djgringoboy2003/Nub44-driver/engineering/budget-2s-design.md

# Budget-2S implementation and handover

Updated 2026-10-29. Codex (AI review), requested by owner, decision DD-30; continued by Claude Code
(AI), decisions DD-31…DD-35, DD-38 (PCB and prototype manufacturing package), DD-39 (BOM sourced) and DD-40
(LCSC codes).

**Stage: prototype PCB files checked; electrical qualification CONDITIONAL; not released.** DD-38 produced a
DRC-clean 90 × 60 mm four-layer board and a bare-board manufacturing package (`manufacturing/budget-2s/`) for
a dummy-load prototype. Every BOM line has a sourced MPN (DD-39) and an LCSC code or a labelled LCSC
equivalent (DD-40). The footprint and layout reviews below are open. No order is authorised by this document or placed by any tool.
The owner requested implementation of the separate two-cell, unrestricted-size, £60 driver. This work does
not inherit the original single-cell boards' CAD, firmware or release results.

## Source and command map

| Purpose | Authoritative source / output |
|---|---|
| Numeric candidate and study assumptions | `engineering/design/budget-2s/parameters.yaml` |
| Separate source resolution | `automation/nubm44/variants.py`; original A/B defaults remain unchanged |
| Circuit connectivity | `engineering/design/budget-2s/connectivity.yaml` (DD-35, DD-38): 108 parts (incl. four mounting holes), every pin and net |
| KiCad library and schematic | `automation/budget/build_library.py` → `hardware/budget-2s/lib/budget2s.*`; `automation/budget/build_schematic.py` → `hardware/budget-2s/nubm44_budget2s.kicad_sch`, `reports/budget-2s/erc.json`, `schematic.json`, `schematic.pdf` and a hash manifest |
| Placement and routing | `hardware/budget-2s/placement.yaml` (positions, pours, fixed tracks/vias, router keep-outs); `automation/budget/build_pcb.py --stage place/route/finish/drc/render` (shared builder via `pcb_builder_budget.py`); accepted session archived in `hardware/budget-2s/routing/`, re-applied with `--stage restore` |
| DRC | `reports/budget-2s/drc.json` and `drc-evidence.json` (kicad-cli, all severities, schematic parity) |
| Routed-copper check | `automation/budget/layout_review.py` → `reports/budget-2s/layout-review.md/.json` and a hash manifest: DC path resistances against the `power_model` allocations |
| BOM order codes | `engineering/design/budget-2s/sourcing.yaml` (DD-39, DD-40), per MPN: LCSC/JLCPCB code (with LCSC's listing name where it adds a suffix), UK-distributor listings, a separately coded LCSC equivalent where LCSC does not list the part, and the evidence ID. Stock and prices are not recorded. |
| Manufacturing package | `automation/budget/export.py` → `manufacturing/budget-2s/` (Gerbers/drill ZIP, BOM, JLCPCB BOM/CPL, PDFs, renders, `ORDERING.md`) and `reports/budget-2s/export-evidence.json`; marks DO_NOT_FABRICATE unless DRC is clean and current |
| Static default-off interface checks (DD-32) | `automation/budget/interface.py` (called by `qualify.py`; results in the same report) |
| Electrical qualification | `automation/budget/qualify.py` → `reports/budget-2s/qualification.md`, JSON and hash manifest |
| Operating point, dropout, UV/OV margins, efficiency estimate | `automation/budget/power.py` (called by `qualify.py`; results in the same report) |
| Preliminary current loop | `automation/budget/loop_model.py` → `reports/budget-2s/loop-model.md`, all 243 corners in JSON, ngspice `.cir`/raw data/log, hash manifest |
| Manufacturer records | BUD-01…22 in `research/sources/budget-driver-sources.md`; downloaded PDFs ignored, hashes recorded |
| Earlier costs and design rationale | `engineering/budget-driver-plan.md`, `reports/bom-quote-sourcing-review.md` |

Run from the repository root (prefix shell commands with `rtk`, per the owner’s RTK.md):

```powershell
rtk proxy .venv/Scripts/python.exe automation/budget/build_library.py
rtk proxy .venv/Scripts/python.exe automation/budget/build_schematic.py
rtk proxy .venv/Scripts/python.exe automation/budget/build_pcb.py --stage restore   # archived routing; or place/route/finish/drc
rtk proxy .venv/Scripts/python.exe automation/budget/layout_review.py
rtk proxy .venv/Scripts/python.exe automation/budget/export.py
rtk proxy .venv/Scripts/python.exe automation/budget/qualify.py
rtk proxy .venv/Scripts/python.exe automation/budget/loop_model.py
rtk proxy .venv/Scripts/python.exe -m pytest tests -q
rtk proxy .venv/Scripts/python.exe automation/validation/validate.py
```

`qualify.py` currently **exits 1**, because none of its thirteen prerequisites is a PASS: eight are CONDITIONAL
(setpoint, dropout, efficiency estimate, UV, OVP margin, static default-off interface, CAD and manufacturing
files) and five OPEN (fault safety, loop, firmware, cost, Gate G). That is the intended readiness result, not a
failed Python invocation. Rerun `layout_review.py` and `export.py` after any board change; `qualify.py` reads
their hash-checked evidence. `export.py` exits 1 and writes DO_NOT_FABRICATE.txt unless DRC is clean and current.
`loop_model.py` exits 0 only when its actual sensitivity margins and independent ngspice/equation agreement
pass; its physical qualification stays OPEN. Existing `validate.py` still validates **A/B only**. A return
code of zero there is not evidence for budget-2s. Do not add budget failures to the A/B known-limitations
baseline to conceal them. Do not add `budget-2s` to legacy default loops until every downstream generator,
firmware/sourcing check, layout model and release gate supports the independent circuit.

## Development architecture

Protected balanced 2S pack → fuse → reverse-polarity P-FET → TPS54821 buck and bulk output filter →
10 mΩ 2512 shunt with Kelvin sense traces (DD-34) → single P-FET output disconnect (source at the shunt, gate pulled down through 100 Ω and clamped, DD-31/34)
→ grounded-cathode laser. Keep bulk capacitance upstream of the disconnect. The disconnect's body diode
blocks VBUCK → laser; a back-to-back second FET would only block the reverse path and was removed. The INA186A2 primary current loop and separate INA300 comparator use distinct
Kelvin traces from the shunt; they still share its physical failure modes. OVP must observe physical VBUCK
upstream of the disconnect, rather than the converter's current-derived feedback or only an isolated laser.

The 3.3 V rail supplies the SOIC ATtiny, sensing/protection and hardware latch. Supervised asynchronous
clear, external interlock, OC and UV/OV trips must override firmware. A deliberate arm edge sets the latch;
firmware mode control may inhibit emission but must never clear a hardware fault automatically. Buck EN
and the output FET driver need a **qualified default-off buffer and bias network**. That interface is not
complete: do not wire the Schmitt latch directly into an arbitrary EN pulldown and assume its 3.3 V drive
or absence-of-supply behaviour. Preserve fault/default-off behaviour on a stopped CPU, reset and brownout.

| Function | Development candidate | Qualification / action before adoption |
|---|---|---|
| Externally compensated buck | TPS54821RHLT, BUD-01 | Retains a hidden pad. 17 A maximum switch limit is not a laser-current limit. Efficiency is at risk at low Vf; qualify before freezing. |
| Magnetics | SRP1265A-4R7M, BUD-05 | Larger package accepted. Catalogue Isat exceeds switch limit, but hot biased L/core loss/fault response remain UNKNOWN. |
| Primary sensing | INA186A2IDCKR, PREORDER-07; WSL2512R0100FEA, BUD-24 (DD-34; WSK2512 not readily available) | DD-33: divider 27.4 kΩ / 10 kΩ for the 4.5 A main setpoint; 15.0/19.1/23.2 kΩ give the 3.0/3.5/4.0 A owner builds. Shunt dissipation about 0.2 W at 4.5 A. Two-terminal 2512 on the stock KiCad land; take Kelvin sense traces from the inner pad edges. ±75 ppm/°C. Exact 0.1% divider MPN/TCR and shunt temperature envelope OPEN. |
| Independent OC | INA300AIDGSR, BUD-06 | Hard-enable from rail; latched HIGH; fast DELAY and HYS float. The 2.67 kΩ candidate (DD-33, about 5.29 A for the 4.5 A setpoint) includes 500 µV NAF. No MCU-controlled disable/reset. |
| Physical UV/OV | TLV6700DDCR, BUD-18 | Separate thresholds, tied open-drain fault clear. UV policy conflicts with full 6.0 V operation; physical OV response/survival remain OPEN. |
| Fault/arm latch | SN74HCS74DR, BUD-19 | CLR = nFAULT, D/PRE high, CLK = MCU arm edge. Q drives only two gate networks (≤ 20 µA, DD-32). Thresholds at 3.3 V interpolated (assumption). Ordinary LVC74A is not an automatic substitute. |
| Interface switches | DMG1012T-7 ×5 (LEAD-04); DMG1013T-7 (BUD-23) | DD-32: N1/N2 and N3/N4 series AND pairs, N5 firmware-permit inhibit, P1 EN source. 25 °C limits only; leakage allocations and a power-on self-test of the pairs OPEN. |
| Control reset supervisor | TLV803EA29DBZR, BUD-20 | 2.93 V nominal/200 ms; exact DBZ pinout. Apply threshold/delay bounds and rail sequencing. |
| 3.3 V control supply | MCP1703AT-3302E/MB, BUD-21 | SOT-89 pin 1 GND, 2/tab VIN, 3 VOUT. Use full-temperature ±3% plus load/line terms, actual effective output C, thermal and reverse-current review. |
| MCU | ATTINY1616-SN, PREORDER-08 | SOIC-20 port map below. Candidate 10 MHz; HAL, ADC/reference, fuses, brownout and target build not yet adapted. |
| Reverse input FET | DMP2022LSS-13, BUD-15 | SO-8, ±12 V gate; gate grounded, so \|Vgs\| = VBAT_PROTECTED ≥ 4.5 V in operation. Qualify orientation, fuse and hot/transient stress. |
| Output disconnect (single) | **SiSS23DN-T1-GE3** (DD-34; same part as A/B Q1, UK stocked), PREORDER-02; DMP2022LSS-13 compared. DMP2005UFG-7 (DD-31) dropped: 40-week lead time | 2.2 kΩ source–gate pull-up, 100 Ω to the N1/N2 pull-down and a BZX585-C6V2 source–gate clamp: \|Vgs\| about 0.957 × VBUCK, so the −4.5 V resistance figure applies at the main point; a switch-short is clamped at ≤ 6.51 V against the ±8 V rating. Shares the open FP-POWERPAK land review. |
| Low-current gate driver | AO3400A, BUD-17 | Superseded for the interface by DMG1012T-7 (DD-32: lower leakage, resistance specified at 1.8 V). Not used unless a later review restores it. |

DD-39 gave every BOM line an MPN checked against a distributor or manufacturer listing (BUD-27/28). The MPNs
are in the connectivity file, and the order codes and evidence in `engineering/design/budget-2s/sourcing.yaml`.
No suffix was invented. Prices, live stock and complete delivered GBP totals remain UNKNOWN until quoted. The
selections are new-circuit choices, not authorised substitutions into A/B.

DD-40 gave every line an LCSC code read on its product page (BUD-29). Nineteen lines use the exact part. LCSC
does not list R5 and R7, so the JLCPCB BOM uses Yageo AT0603BRD0727K4L (C855755) and AT0603BRD072K67L (C855783):
same value, 0603 thin film, ±0.1 %, ±25 ppm/°C. A hand-built board keeps the UK parts. The LCSC datasheets also
changed two figures:
- XT30 contact resistance: 1.20 mΩ (BUD-30) instead of 0.80 mΩ, so the fuse and holder may now be at most
  10.312 mΩ hot.
- J2: rated UL 10 A / IEC 15 A (BUD-31).

## Qualification findings (open until bench data)

| ID | Finding | Remedy / evidence needed | State |
|---|---|---|---|
| BUD-ISS-01 | Original easy-SOIC disconnect proposal consumed too much loss allowance. DD-31: back-to-back pair replaced by one P-FET (DMP2005UFG-7, then SiSS23DN under DD-34); the operating-point model bounds dropout (BUD-PWR-01 CONDITIONAL). The efficiency estimate at 4.0 A was below 94%; the owner chose a 93% bench-judged target. With the DD-33 main setpoint (4.5 A at 4.72 V) the estimate is about 93.05% (BUD-EFF-01 CONDITIONAL with only about 0.05 points of margin; maximum-resistance corner about 90%). | Make the fuse, connector and copper meet the `power_model` allocations, then measure efficiency at all corners and owner V–I points. If 4.5 A measures below 93%, the owner chooses: accept, lower setpoint, or loss reduction. | MITIGATED IN MODEL; owner target decided; bench OPEN |
| BUD-ISS-02 | 147 kΩ / 10 kΩ UV comparator could trip at 6.303 V, inside the proposed 6.0 V operating range. DD-31: 130 kΩ makes the hardware UV a backstop below the loaded floor (BUD-UV-01 CONDITIONAL, margin in the report). | Write the firmware operating cutoff (stop before dropout; refuse arming on a low resting pack). Choose a pack whose cells are rated to the `pack_cutoff_floor_v` assumption. Verify the input allocation with the real fuse/connector. Protected balanced pack/per-cell BMS remains mandatory. | MITIGATED IN CALCULATION; firmware policy and pack OPEN |
| BUD-ISS-03 | Bare latch/EN/FET interfaces had no guaranteed 3.3 V drive/loss-of-supply proof. DD-32: series N-MOSFET AND pairs on ARM_Q and nFAULT for both outputs, a P1-sourced EN divider, a firmware-permit inhibit that defaults on, and a VCTRL bleed. 34 static checks pass (BUD-IF-01 CONDITIONAL). | Bench-verify the assumptions in the report (interpolated latch thresholds, scaled VOL, hot leakage, EN pull-up, supervisor release margin about 13 mV beyond its allocation). Add a power-on self-test of the series pairs. Model and bench-inject rail/CPU faults. | MITIGATED IN CALCULATION; bench OPEN |
| BUD-ISS-04 | Catalogue 10 µs OC is a typical detector setting, not a guaranteed total shutdown or laser-safe fault energy. | Include comparator window/overdrive, fault wiring, latch, buffer, FET charge, SOA, capacitors and inductive paths. Obtain guaranteed bounds where available; record remaining UNKNOWNs and measure the complete chain. | OPEN |
| BUD-ISS-05 | A simple loop study initially failed 19/243 corners with 330 Ω compensation; a 180 Ω analysis candidate passes the stated assumed sweep. | Keep the generated 180 Ω evidence; qualify actual controller/laser/capacitor dynamics, component tolerances and switching faults. The earlier 330 Ω result explains why the candidate changed, not a reason to waive margins. | MITIGATED IN MODEL; real-circuit qualification OPEN |

The generated report gives exact calculated bounds rather than copying rounded numbers into a second
source. Setpoint accuracy is conditional on procurement and the stated hot-shunt assumption. The capacitor
energy screen includes an 8.4 V buck switch-short case; a small laser-side capacitor does not limit energy
from an inductor or a failed/slow disconnect.

## SOIC MCU port reference

Source PREORDER-08, DS40002204A pp.15,18. These are verified manufacturer port/pad assignments, **not a new
netlist**. Keeping a port function does not preserve its old VQFN physical pad number.

| SOIC pin | Port / supply | Intended role to carry or qualify |
|---:|---|---|
| 1 | VDD | Regulated control rail; never raw 2S |
| 2 | PA4 / ADC0 AIN4 | NTC excitation or reassigned under a documented HAL profile |
| 3 | PA5 / ADC0 AIN5 | Board NTC |
| 4 | PA6 / ADC0 AIN6 | Current monitor |
| 5 | PA7 / ADC0 AIN7 | Physical output voltage monitor |
| 6 | PB5 / ADC0 AIN8 | 2S battery monitor with new divider/reference |
| 7 | PB4 / ADC0 AIN9 | Optional laser NTC |
| 8 | PB3 | Spare / diagnostics |
| 9 | PB2 | Indicator; recalculate external-short fault power |
| 10 | PB1 | Independent OC/fault state monitor |
| 11 | PB0 | Converter status if useful; never a substitute for physical OVP |
| 12–15 | PC0–PC3 | DD-32 needs: latch arm edge (CLK, push-pull), PERMIT (N5 gate, low = permit), nFAULT monitor if not PB1; exact allocation OPEN |
| 16 | PA0 / UPDI | Programming/debug |
| 17 | PA1 | Emission inhibit, polarity/interface OPEN |
| 18 | PA2 | Hardware interlock state |
| 19 | PA3 | User input |
| 20 | GND | Ground; no SOIC exposed pad |

ADC protection/scaling, ratiometric NTC measurement, reference supply headroom, source impedance/settling,
2S pack stop/restart thresholds, hold-up/mode behaviour and fault-reset policy require a separate firmware
profile and tests. Do not flash the existing VQFN board image and assume equivalent sensing.

## Fault matrix and prototype acceptance work

Every row is an analysis/test requirement, not a measured result. Use a current-limited supply and suitably
rated dummy load before any laser. Only actual MEASURED records may enter the bench-results directory.

| Event | Required hardware / firmware outcome | Present proof / missing test |
|---|---|---|
| Initial power, slow ramp or rail absent | Buck and output disconnect stay off; no arm edge until supervised rail and deliberate enable | DD-32 static proof: the supervisor holds nFAULT low from 1.7 V to its release threshold; below 1.7 V EN cannot exceed its guaranteed disable level, whatever the logic state. Ramp timing and bench test OPEN |
| MCU reset, watchdog, stuck instruction or pin tristate | Hardware default off or independent fault chain stops output; no automatic re-arm after fault | DD-32: a tristated permit pin turns N5 on, which clears the latch; re-arming needs a new arm edge. A CPU stuck driving permit low relies on the watchdog. Firmware profile and injection OPEN |
| Interlock opens / contact chatters | Asynchronous hardware clear and isolation, latched until deliberate recovery | DD-32: the open loop lets the 47 kΩ pulldown clear the latch and open both series pairs (static check). Cable short to VBAT is limited by the 9.1 kΩ leg but makes the loop read closed; clamp, timing and chatter OPEN |
| Latch stuck with Q high | Faults, interlock and firmware inhibit still stop both outputs | DD-32 series pairs need nFAULT high; arming loses its second condition. Latent N1–N4 shorts need a power-on self-test (OPEN) |
| Current exceeds backup threshold / primary CSA fails low | Independent latched OC clears power without MCU help | Conditional threshold screen only; response/energy OPEN |
| Shunt shorts, Kelvin trace opens/shorts or CSA inputs fail | Defined safe disposition; identify common-cause blindness | Shared shunt can defeat both loops; analyse physical redundancy or mitigation before release |
| Load opens / current loop winds up | Upstream physical OVP shuts down, isolates and latches; no automatic pulsing | Threshold screen only; switching/startup/COMP model OPEN |
| Load reconnects, including before full discharge | Normal transient peak ≤4.95 A (DD-33), no bulk-capacitor dump into diode | Switching model, disconnect sequencing and bench current/energy OPEN |
| Output short / repeated flash transitions | Controlled current and latched fault as appropriate; no damage or unsafe recovery | Converter switch limit is not a laser bound; model/bench OPEN |
| Buck high-side switch fails short | Output disconnect interrupts raw-pack fault; clamp/TVS/SOA and current paths remain rated | 8.4 V capacitor-energy screen only; fault delay/SOA/inductor paths OPEN |
| Output FET fails short / body diode conducts | Single-fault disposition documented; avoid claiming isolation from EN alone | Body-diode orientation and single-FET/driver faults OPEN |
| Reversed 2S input / plug transient | Defined reverse-blocking, fuse and voltage-clamp response; no control-rail backfeed | Exact fuse/clamp, orientation and transient test OPEN |
| Pack UV / one weak cell | Firmware stops at the operating cutoff; hardware UV (5.40–5.62 V falling) latches if firmware does not; BMS protects individual cells | UV backstop margin calculated (DD-31). Aggregate pack ADC cannot detect every imbalance; exact pack/BMS and firmware policy OPEN |
| Input sags into dropout, then recovers | Current must not overshoot 4.95 A (DD-33) while COMP unwinds; firmware stops before dropout | Dropout bound calculated. TPS54821 PWRGD falls when VSENSE < 92% of Vref (BUD-01 p.6), i.e. when current regulation is lost, and can serve as an MCU indication. Recovery transient needs a switching model and bench test |
| Board/laser NTC open, short or overtemperature | Fault latch/default off; optional sensor rules cannot disable board protection | New rail/reference/ADC profile and placement/bench OPEN |
| Disabled output / external hot-plug | Discharge criterion met; no stored-energy reconnection spike | Bleed arithmetic only; verify worst C, cable and detector/disconnect behaviour |

## Next implementation steps for another agent

1. Read AGENTS.md, PROGRESS Current state, this file, DD-38 and the generated budget reports
   (`qualification.md`, `loop-model.md`, `layout-review.md`, `manufacturing/budget-2s/ORDERING.md`). Verify
   hashes via `nubm44.evidence.problems`; regenerate with the producing scripts, never edit results.
2. **Reviews before any order** (DD-38 OPEN list):
   - U1 RHL land and stencil against TI's drawing, using `budget2s.pretty` and the F.Paste Gerber.
   - The Q2 PowerPAK land (the open A/B FP-POWERPAK review applies; LCSC names the package PowerPAK 1212-8S).
   - The XT30 moulded +/− marks against the B+/B− silkscreen, and J2's wire-entry side.
   - The PH neck flagged by `layout_review.py`.
3. **BOM:** every line has a sourced MPN (DD-39) and an LCSC code or a labelled equivalent (DD-40). Still to
   do before ordering:
   - Choose a 10 A mini-blade fuse whose fuse-plus-holder resistance is at most 10.312 mΩ hot
     (`layout-review.md`; XT30 contacts at 1.20 mΩ each, BUD-30).
   - For JLCPCB assembly, check live LCSC stock and the JLCPCB library class (Basic/Extended) of each line.
     Out-of-stock parts need pre-order, global sourcing or consigning. Decide through-hole assembly or
     hand-fitting for J1, J2, J3, J5, F1 and J4.
   - Confirm live stock, especially the 0.1 % parts from RS/Farnell/DigiKey UK.
   - Use the NTC's B25/50 = 3380 K in firmware.
   Keep prices and stock UNKNOWN until quoted.
4. **BUD-ISS-04:** the total fault response and energy. Chain the open-drain/comparator delays, the series
   pairs, the output P-FET turn-off through its 2.2 kΩ pull-up (55 nC typical gate charge suggests tens of µs,
   see BUD-16), the buck EN shutdown, inductor and bulk-capacitor energy, and SOA. Prefer guaranteed delay limits
   and record the rest as UNKNOWN for bench measurement.
5. **Firmware:** the budget HAL and pin profile (DD-35 pin table), ADC scaling, operating cutoff (BUD-ISS-02),
   arming and permit, plus the target build and host/register/mutation tests. Then a budget-specific bench-test
   schema (dummy load, efficiency at every owner V–I point, thermal, fault injection).
6. **Ordering:** obtain GBP landed quotes for 3 and 5 boards (PCB, stencil, assembly, X-ray of U1, spares), each
   requested only through an owner-approved contact; the owner places any order. A complete total is UNKNOWN.
7. **Bench:** build on a current-limited supply and dummy load before any laser. Only MEASURED records may close
   Gate G.

At each milestone update this handover as needed, PROGRESS (Current/Next/Log), scoped requirements and any
affected audit/decision records; commit with the actual check results and push `main` to origin. Keep Gate G
OPEN until real budget-board data exists. Preserve the pre-existing untracked `reports/setup.log`.
