djgringoboy2003/Nub44-driver/reports/bench-report.md

# Bench evidence (Gate G)

Generated by `automation/bench/bench.py check` on 2026-10-29. Only MEASURED records from `documentation/testing/results/` count; predictions are listed for comparison and never pass a test.

| Variant | Gate G | Required tests | Not yet PASS |
|---|---|---|---|
| compact-22mm | **NO DATA** | 23 | 23 |
| evaluation-board | **NO DATA** | 29 | 29 |

## compact-22mm

| Test | Title | Status | Date | Board | Limit | Prediction |
|---|---|---|---|---|---|---|
| T0.1 | Visual / X-ray inspection of U1 and U3 | NOT TESTED | - | - | solder_defects = 0 count | - |
| T0.2 | Polarity marks against the assembly drawings | NOT TESTED | - | - | misoriented_parts = 0 count | - |
| T0.3 | Short check VBAT-GND, VOUT-GND, LD+-LD- | NOT TESTED | - | - | r_vbat_gnd_ohm >= 1000 ohm; r_vout_gnd_ohm >= 1000 ohm; r_ld_ohm >= 1000 ohm | - |
| T0.4 | Fuse readback | NOT TESTED | - | - | bodcfg = 0x06 hex; osccfg_freqsel = 0x02 hex | - |
| T1.1 | First power-up, idle current, no output | NOT TESTED | - | - | i_idle_ma <= 2.0 mA; vout_idle_v <= 0.1 V | - |
| T1.2 | Default-off and emission delay | NOT TESTED | - | - | i_before_delay_ma <= 10 mA; emission_delay_s >= 2.0 s | - |
| T1.3 | Soft start and overshoot | NOT TESTED | - | - | i_peak_a <= 4.95 A; ramp_ms record ms | i_peak_a 4.479251 A |
| T1.4 | Regulation accuracy over supply and dummy-load Vf | NOT TESTED | - | - | i_out_a 4.275..4.725 A | i_out_a 4.4784 A |
| T1.5 | Regulation with Vf below Vbat (buck mode) | NOT TESTED | - | - | i_out_a 4.275..4.725 A | - |
| T1.6 | Laser-current ripple | NOT TESTED | - | - | ripple_pct_pp <= 10.0 % | ripple_pct_pp 9.1683 % |
| T1.7 | Efficiency | NOT TESTED | - | - | efficiency_pct >= 93.0 % @ {'vin_v': 4.0}; efficiency_pct >= 86.0 % @ {'vin_v': 3.0} | efficiency_pct 94.1015 %; efficiency_pct 90.2736 % |
| T1.8 | Flash mode and mode change by power gap | NOT TESTED | - | - | mode_changes_per_click = 1 count; off_to_50ma_ms <= 1.0 ms | off_to_50ma_ms 0.491541 ms |
| T1.9 | Mode memory timing | NOT TESTED | - | - | glitch_threshold_ms record ms; click_threshold_ms record ms; vmcu_min_v record V | - |
| T1.11 | Measurement chain against a DMM | NOT TESTED | - | - | vbat_error_pct <= 3.0 %; current_error_pct <= 5.0 % | - |
| T2.1 | Interlock opens during emission | NOT TESTED | - | - | shutdown_ms <= 1.0 ms; restarts_without_power_cycle = False bool | shutdown_ms 0.064911 ms |
| T2.5 | Reverse polarity | NOT TESTED | - | - | i_reverse_ma <= 1.0 mA; works_afterwards = True bool | i_reverse_ma 0.000249 mA |
| T2.6 | Undervoltage lockout | NOT TESTED | - | - | uvlo_off_v 2.745..2.915 V; uvlo_on_v 2.988..3.172 V | uvlo_off_v 2.8292 V; uvlo_on_v 3.0787 V |
| T2.7 | Thermal at 4.5 A continuous | NOT TESTED | - | - | t_u1_case_c record C; t_l1_c record C; t_q1_c record C; t_rs1_c record C; firmware_stop_board_c 83.0..87.0 C | - |
| T2.8 | Hot insertion | NOT TESTED | - | - | vin_overshoot_v <= 6.0 V | - |
| T2.13 | Sensor faults | NOT TESTED | - | - | fault_code_board_ntc_short = 11 code; fault_code_laser_ntc_lost = 12 code; normal_without_laser_ntc = True bool | - |
| T3.1 | Real cells to cut-off | NOT TESTED | - | - | cutoff_v >= 2.83 V; regulation_held = True bool; runtime_min record min | - |
| T3.2 | Contact resistance (spring and ring) | NOT TESTED | - | - | r_contacts_mohm <= 20.0 mOhm | - |
| T3.3 | Polarity confirmation in the host | NOT TESTED | - | - | polarity_matches = True bool | - |

## evaluation-board

| Test | Title | Status | Date | Board | Limit | Prediction |
|---|---|---|---|---|---|---|
| T0.1 | Visual / X-ray inspection of U1 and U3 | NOT TESTED | - | - | solder_defects = 0 count | - |
| T0.2 | Polarity marks against the assembly drawings | NOT TESTED | - | - | misoriented_parts = 0 count | - |
| T0.3 | Short check VBAT-GND, VOUT-GND, LD+-LD- | NOT TESTED | - | - | r_vbat_gnd_ohm >= 1000 ohm; r_vout_gnd_ohm >= 1000 ohm; r_ld_ohm >= 1000 ohm | - |
| T0.4 | Fuse readback | NOT TESTED | - | - | bodcfg = 0x06 hex; osccfg_freqsel = 0x02 hex | - |
| T1.1 | First power-up, idle current, no output | NOT TESTED | - | - | i_idle_ma <= 2.0 mA; vout_idle_v <= 0.1 V | - |
| T1.2 | Default-off and emission delay | NOT TESTED | - | - | i_before_delay_ma <= 10 mA; emission_delay_s >= 2.0 s | - |
| T1.3 | Soft start and overshoot | NOT TESTED | - | - | i_peak_a <= 4.95 A; ramp_ms record ms | i_peak_a 4.479251 A |
| T1.4 | Regulation accuracy over supply and dummy-load Vf | NOT TESTED | - | - | i_out_a 4.275..4.725 A | i_out_a 4.4784 A |
| T1.5 | Regulation with Vf below Vbat (buck mode) | NOT TESTED | - | - | i_out_a 4.275..4.725 A | - |
| T1.6 | Laser-current ripple | NOT TESTED | - | - | ripple_pct_pp <= 10.0 % | ripple_pct_pp 9.1683 % |
| T1.7 | Efficiency | NOT TESTED | - | - | efficiency_pct >= 93.0 % @ {'vin_v': 4.0}; efficiency_pct >= 86.0 % @ {'vin_v': 3.0} | efficiency_pct 94.1015 %; efficiency_pct 90.2736 % |
| T1.8 | Flash mode and mode change by power gap | NOT TESTED | - | - | mode_changes_per_click = 1 count; off_to_50ma_ms <= 1.0 ms | off_to_50ma_ms 0.491541 ms |
| T1.9 | Mode memory timing | NOT TESTED | - | - | glitch_threshold_ms record ms; click_threshold_ms record ms; vmcu_min_v record V | - |
| T1.10 | CC pin polarity | NOT TESTED | - | - | cc_active_low = True bool | - |
| T1.11 | Measurement chain against a DMM | NOT TESTED | - | - | vbat_error_pct <= 3.0 %; current_error_pct <= 5.0 % | - |
| T2.1 | Interlock opens during emission | NOT TESTED | - | - | shutdown_ms <= 1.0 ms; restarts_without_power_cycle = False bool | shutdown_ms 0.064911 ms |
| T2.2 | Open load | NOT TESTED | - | - | vout_peak_v <= 7.0 V; fault_latched = True bool | vout_peak_v 6.740876 V |
| T2.3 | Output short circuit | NOT TESTED | - | - | i_short_a <= 5.2 A; fault_latched = True bool | i_short_a 4.479239 A |
| T2.4 | Backup current ceiling | NOT TESTED | - | - | i_ceiling_a 4.8..5.2 A; cc_flag_asserted = True bool | i_ceiling_a 4.8 A |
| T2.5 | Reverse polarity | NOT TESTED | - | - | i_reverse_ma <= 1.0 mA; works_afterwards = True bool | i_reverse_ma 0.000249 mA |
| T2.6 | Undervoltage lockout | NOT TESTED | - | - | uvlo_off_v 2.745..2.915 V; uvlo_on_v 2.988..3.172 V | uvlo_off_v 2.8292 V; uvlo_on_v 3.0787 V |
| T2.7 | Thermal at 4.5 A continuous | NOT TESTED | - | - | t_u1_case_c record C; t_l1_c record C; t_q1_c record C; t_rs1_c record C; firmware_stop_board_c 83.0..87.0 C | - |
| T2.8 | Hot insertion | NOT TESTED | - | - | vin_overshoot_v <= 6.0 V | - |
| T2.9 | Switch-node and gate waveforms | NOT TESTED | - | - | sw2_peak_v record V; sw1_ringing_v record V | - |
| T2.10 | VCC ripple | NOT TESTED | - | - | vcc_ripple_mv_pp record mV | - |
| T2.11 | Control-node noise and current jitter | NOT TESTED | - | - | current_offset_pct <= 5.0 % | - |
| T2.12 | U1 power-pin temperature | NOT TESTED | - | - | t_u1_top_edge_c record C | - |
| T2.13 | Sensor faults | NOT TESTED | - | - | fault_code_board_ntc_short = 11 code; fault_code_laser_ntc_lost = 12 code; normal_without_laser_ntc = True bool | - |
| T3.1 | Real cells to cut-off | NOT TESTED | - | - | cutoff_v >= 2.83 V; regulation_held = True bool; runtime_min record min | - |
