djgringoboy2003/Nub44-driver/reports/layout-review-compact-22mm.md

# Power-layout review: compact-22mm

Generated by `automation/review/power_layout.py` from `hardware/compact-22mm/nubm44_driver.kicad_pcb` (SHA-256 `1729aa309fa0`). Numbers come from the routed copper; the screening criteria below select items for review and never open or close a gate. DC copper analysis does not model inductance, switching waveforms or temperature. Physical behaviour remains a Gate G (bench) item.

## Assumptions

- copper: 1.0 oz (34.8 um) on every layer (DD-14 target; finished thickness UNKNOWN)
- layer spacing (mm): [0.2203, 1.1594, 0.2203]
- via barrel plating: 20 um (assumed; fabricator value UNKNOWN)
- solver: DC resistor grid, 0.05 mm cells (0.1 mm for GND), resistance at 25 C, losses scaled to 75 C copper; terminals are equipotential pad groups
- currents: boost-mode DC: input current through BAT_SPRING/VBAT, inductor RMS through SW1/SW2, output current through VOUT/LD_P; ground carries the laser return plus I_in - I_out from PGND

## Operating points

| Point | Corner | Vin (V) | Region | I_in (A) | I_L rms (A) | I_out (A) |
|---|---|---|---|---|---|---|
| worst | max_cold | 2.83 | boost | 8.58 | 8.60 | 4.50 |
| nominal | typ_25C | 4.0 | boost | 5.40 | 5.41 | 4.50 |

## Power-path copper (DC current flow)

Neck = current per unit width exceeded over the hottest 0.25 mm² of copper outside the pad and via crowding zones; equivalent width = path current / neck value. Screen = width an IPC-2221 long trace needs for the same current at 20 K rise (short necks spread heat into wider copper, so exceeding it marks a review item, not a failure).

| Net | Path | R 25 °C (mΩ) | Worst I (A) | Loss 75 °C (mW) | Neck (A/mm) | Equiv. width (mm) | Screen width (mm) | Ratio | Neck at | Max via (A) |
|---|---|---|---|---|---|---|---|---|---|---|
| BAT_SPRING | battery B+ contact to Q1 drain | 0.602 | 8.576 | 52.98 | 4.44 | 1.932 | 3.845 | 1.99 | B.Cu [-1.9, -4.1] | 0.0 |
| VBAT | Q1 source to Q2 drain | 0.493 | 8.576 | 43.37 | 1.54 | 5.57 | 3.845 | 0.69 | B.Cu [-5.9, -3.9] | 1.638 |
| SW1 | Q2 source to L1 | 0.303 | 8.599 | 26.82 | 4.15 | 2.071 | 3.859 | 1.86 | F.Cu [-1.15, -4.9] | 0.041 |
| SW2 | L1 to U1 SW2 pins 21/25 | 1.228 | 8.599 | 108.65 | 13.25 | 0.649 | 3.859 | 5.95 | F.Cu [0.7, 0.7] | 0.0 |
| VOUT | U1 VOUT pins 11/26 to shunt | 1.452 | 4.5 | 35.19 | 5.47 | 0.822 | 1.58 | 1.92 | F.Cu [1.4, 5.2] | 0.531 |
| LD_P | shunt to laser LD+ pad | 0.47 | 4.5 | 11.38 | 3.25 | 1.384 | 1.58 | 1.14 | F.Cu [5.95, 2.55] | 0.0 |

**Ground** (laser return J3.2 and U1 PGND 9/24 to battery B- J2): unit-current resistance {'laser_return': 0.087, 'converter_pgnd': 2.723} mΩ at 25 °C.

- worst: loss 54.2 mW at 75 °C; laser-return drop 0.391 mV; PGND drop 11.098 mV; setpoint shift from ground offsets {'delta_i_ma': 40.454, 'delta_pct': 0.899}.
- nominal: loss 4.67 mW at 75 °C; laser-return drop 0.391 mV; PGND drop 2.445 mV; setpoint shift from ground offsets {'delta_i_ma': 8.557, 'delta_pct': 0.1902}.

Quiet-reference ground offsets at the worst point (µV relative to U1 AGND pin 10):

| Pad | µV |
|---|---|
| U1.10 | 0.0 |
| U1.7 | -10661.1 |
| U1.15 | -10831.5 |
| C7.2 | -10819.8 |
| R9.2 | -10832.9 |
| R2.2 | -10130.3 |
| R3.2 | -10800.4 |
| C8.2 | -10730.5 |
| C9.2 | -10832.9 |
| U2.1 | -10845.8 |
| U2.2 | -10845.5 |
| C15.2 | -10871.6 |
| R6.2 | -10799.4 |
| R11.2 | -11100.6 |
| R13.2 | -11109.2 |
| U3.3 | -10965.2 |

## Copper loss against the efficiency model (4.0 V nominal point, copper at 75 °C)

| Item | CAD (W) | Loss model (W) |
|---|---|---|
| Input path incl. ground return | 0.0428 | 0.0437 |
| Output path (VOUT + LD_P) | 0.0466 | 0.0405 |
| Switch-node copper (SW1 + SW2) | 0.0536 | not modelled |

Efficiency estimate 94.101 % (model) -> 93.846 % with the CAD copper substituted.

## Hot loops (SLVSFC5 10.1)

Centroid loop area: polygon through the pad centroids of the loop (top view). Legs: shortest copper path on the top layer (blank = the leg does not close on the top layer) and on any layer through vias.

**buck_input**

| Cap | Value | Centroid area (mm²) | Hot leg top (mm) | GND leg top (mm) | GND leg any (mm) | GND vias ≤1 mm |
|---|---|---|---|---|---|---|
| C1 | 22u | 14.67 | 1.89 |  | 16.24 | 0 |
| C2 | 22u | 14.39 | 1.25 |  | 14.17 | 0 |
| C3 | 22u | 14.11 | 1.3 |  | 12.88 | 1 |

**u1_vin**

| Cap | Value | Centroid area (mm²) | Hot leg top (mm) | GND leg top (mm) | GND leg any (mm) | GND vias ≤1 mm |
|---|---|---|---|---|---|---|
| C4 | 100n | 2.02 |  |  | 5.83 | 1 |

**boost_output**

| Cap | Value | Centroid area (mm²) | Hot leg top (mm) | GND leg top (mm) | GND leg any (mm) | GND vias ≤1 mm |
|---|---|---|---|---|---|---|
| C10 | 22u | 6.33 | 2.25 | 2.42 | 2.42 | 0 |
| C11 | 22u | 2.26 |  |  | 10.32 | 0 |
| C12 | 22u | 6.9 |  |  | 5.13 | 0 |
| C13 | 22u | 0.5 |  |  | 9.05 | 0 |
| C14 | 100n | 1.75 | 0.6 | 0.62 | 0.62 | 1 |

## Gate-drive, bootstrap and VCC loops

Loop-area estimate: track length × distance to the nearest return-net copper on the same or an adjacent layer (adjacent layers add their spacing).

| Net | Function | Return | Pad spacing (mm) | Route (mm) | Track (mm) | Vias | Layers | Loop area (mm²) | Max return distance (mm) | Return path top / any (mm) |
|---|---|---|---|---|---|---|---|---|---|---|
| DR1H | buck high-side gate | SW1 | 8.39 | 15.5 | 13.39 | 2 | F.Cu, In2.Cu | 14.89 | 2.03 | 7.3 / 7.3 |
| DR1L | buck low-side gate | GND | 7.91 | 11.88 | 11.21 | 2 | F.Cu, In2.Cu, B.Cu | 4.09 | 0.96 |  / 18.67 |
| BOOT1 | buck bootstrap | SW1 | 2.89 | 3.17 | 3.83 | 0 | F.Cu | 2.27 | 0.9 | 1.87 / 1.87 |
| BOOT2 | boost bootstrap | SW2 | 3.54 | 3.77 | 4.61 | 0 | F.Cu | 3.02 | 0.9 | 4.92 / 4.92 |
| VCC5 | VCC/driver supply | GND | 1.47 | 0.65 | 1.62 | 0 | F.Cu | 0.36 | 0.22 |  / 12.58 |

## ISP/ISN Kelvin pair

| Net | Track (mm) | Vias | Layers | Enclosed area (mm²) | Max separation (mm) | Length > 1 mm apart (mm) |
|---|---|---|---|---|---|---|
| ISP_K | 5.44 | 1 | F.Cu | 3.46 | 1.1 | 0.91 |
| ISN_K | 4.35 | 1 | F.Cu | 2.6 | 1.1 | 0.63 |

## Sensitive nets near switching copper

Aggressors: SW1, SW2, BOOT1, BOOT2, DR1H, DR1L. Screen for high-impedance nodes (FB, COMP, COMP_RC, FSW, ILIM, EN_UVLO): ≥ 0.5 mm on the same layer and no overlap on an adjacent layer.

| Net | Layers | Same-layer gap (mm) | Adjacent-layer overlap (mm²) |
|---|---|---|---|
| FB | F.Cu, In1.Cu, In2.Cu, B.Cu | 1.46 | 0.0 |
| COMP | F.Cu, In1.Cu, In2.Cu, B.Cu | 0.49 | 0.0 |
| COMP_RC | B.Cu | 2.11 | 0.0 |
| FSW | F.Cu | 1.06 | 0.0 |
| ILIM | F.Cu, In1.Cu, In2.Cu, B.Cu | 0.73 | 0.0 |
| ISP_K | F.Cu, In1.Cu, In2.Cu, B.Cu | 1.05 | 0.0 |
| ISN_K | F.Cu, In1.Cu, In2.Cu, B.Cu | 1.47 | 0.0 |
| CS_OUT | B.Cu | 1.82 | 0.0 |
| EN_UVLO | F.Cu, In1.Cu, In2.Cu, B.Cu | 0.17 | 0.0 |

## Vias near power pins

| Pins | ≤ 1 mm | ≤ 2 mm |
|---|---|---|
| U1 PGND 9/24 | 0 | 3 |
| U1 VOUT 11/26 | 0 | 1 |
| U1 SW2 21/25 | 0 | 0 |
| Q3 source | 2 | 2 |
| Q2 drain | 0 | 1 |

Switch-node pour area (mm²): {'SW2': {'F.Cu': 9.356}, 'SW1': {'F.Cu': 14.115, 'B.Cu': 8.458}}

## Screening results

- **REVIEW NECK-BAT_SPRING**: BAT_SPRING: 4.44 A/mm over the hottest 0.25 mm2 at 8.576 A (equivalent width 1.932 mm) exceeds the IPC-2221 20 K long-trace screen of 2.23 A/mm (3.845 mm) by x1.99 at [-1.9, -4.1] on B.Cu.
- **REVIEW VIA-VBAT**: VBAT: 4 via barrel segment(s) carry more than 1.0 A (max 1.638 A).
- **REVIEW NECK-SW1**: SW1: 4.15 A/mm over the hottest 0.25 mm2 at 8.599 A (equivalent width 2.071 mm) exceeds the IPC-2221 20 K long-trace screen of 2.23 A/mm (3.859 mm) by x1.86 at [-1.15, -4.9] on F.Cu.
- **REVIEW NECK-SW2**: SW2: 13.25 A/mm over the hottest 0.25 mm2 at 8.599 A (equivalent width 0.649 mm) exceeds the IPC-2221 20 K long-trace screen of 2.23 A/mm (3.859 mm) by x5.95 at [0.7, 0.7] on F.Cu.
- **REVIEW NECK-VOUT**: VOUT: 5.47 A/mm over the hottest 0.25 mm2 at 4.5 A (equivalent width 0.822 mm) exceeds the IPC-2221 20 K long-trace screen of 2.85 A/mm (1.58 mm) by x1.92 at [1.4, 5.2] on F.Cu.
- **REVIEW NECK-LD_P**: LD_P: 3.25 A/mm over the hottest 0.25 mm2 at 4.5 A (equivalent width 1.384 mm) exceeds the IPC-2221 20 K long-trace screen of 2.85 A/mm (1.58 mm) by x1.14 at [5.95, 2.55] on F.Cu.
- **REVIEW COPPER-LOSS**: Routed copper at 75 C dissipates 59 mW more than the loss model allows at the 4.0 V nominal point (switch-node copper is not in the model); estimated efficiency 94.101 % -> 93.846 %.
- **REVIEW GND-OFFSET**: DC ground offsets shift the regulated current by 40.454 mA (0.899 %).
- **REVIEW DRIVE-DR1H**: DR1H (buck high-side gate) changes layer through 2 via(s); route 15.5 mm for a 8.39 mm pad spacing, loop-area estimate 14.89 mm2 against SW1.
- **REVIEW DRIVE-DR1L**: DR1L (buck low-side gate) changes layer through 2 via(s); route 11.88 mm for a 7.91 mm pad spacing, loop-area estimate 4.09 mm2 against GND.
- **REVIEW SPACE-COMP**: High-impedance COMP is 0.49 mm from switching copper (screen 0.5 mm).
- **REVIEW SPACE-EN_UVLO**: High-impedance EN_UVLO is 0.17 mm from switching copper (screen 0.5 mm).
- **REVIEW KELVIN-ISP_K**: ISP_K: 0.91 mm of route is more than 1 mm from its Kelvin partner (max 1.1 mm, enclosed 3.46 mm2); SLVSFC5 10.1 asks for parallel, close ISP/ISN traces.
- **REVIEW KELVIN-ISN_K**: ISN_K: 0.63 mm of route is more than 1 mm from its Kelvin partner (max 1.1 mm, enclosed 2.6 mm2); SLVSFC5 10.1 asks for parallel, close ISP/ISN traces.
- **INFO LOOP-C1**: buck_input loop via C1: the ground leg does not close on the top layer; it returns through vias (0 within 1 mm) and the plane, path 16.24 mm.
- **INFO LOOP-C2**: buck_input loop via C2: the ground leg does not close on the top layer; it returns through vias (0 within 1 mm) and the plane, path 14.17 mm.
- **INFO LOOP-C3**: buck_input loop via C3: the ground leg does not close on the top layer; it returns through vias (1 within 1 mm) and the plane, path 12.88 mm.
- **INFO LOOP-C4**: u1_vin loop via C4: the ground leg does not close on the top layer; it returns through vias (1 within 1 mm) and the plane, path 5.83 mm.
- **INFO LOOP-C11**: boost_output loop via C11: the ground leg does not close on the top layer; it returns through vias (0 within 1 mm) and the plane, path 10.32 mm.
- **INFO LOOP-C12**: boost_output loop via C12: the ground leg does not close on the top layer; it returns through vias (0 within 1 mm) and the plane, path 5.13 mm.
- **INFO LOOP-C13**: boost_output loop via C13: the ground leg does not close on the top layer; it returns through vias (0 within 1 mm) and the plane, path 9.05 mm.

## Figures

- [nets-F_Cu.png](layout-review/compact-22mm/nets-F_Cu.png)
- [nets-In1_Cu.png](layout-review/compact-22mm/nets-In1_Cu.png)
- [nets-In2_Cu.png](layout-review/compact-22mm/nets-In2_Cu.png)
- [nets-B_Cu.png](layout-review/compact-22mm/nets-B_Cu.png)
- [flow-BAT_SPRING.png](layout-review/compact-22mm/flow-BAT_SPRING.png)
- [flow-VBAT.png](layout-review/compact-22mm/flow-VBAT.png)
- [flow-SW1.png](layout-review/compact-22mm/flow-SW1.png)
- [flow-SW2.png](layout-review/compact-22mm/flow-SW2.png)
- [flow-VOUT.png](layout-review/compact-22mm/flow-VOUT.png)
- [flow-LD_P.png](layout-review/compact-22mm/flow-LD_P.png)
- [ground-potential.png](layout-review/compact-22mm/ground-potential.png)
