djgringoboy2003/Nub44-driver/reports/release-readiness.md

# Release readiness

Generated by `automation/validation/validate.py` on 2026-10-29 from the validation register. No tool places an order; MANUFACTURING_RELEASE also needs bench evidence and a signed approval.

| Variant | Level | Next level | Blockers to the next level |
|---|---|---|---|
| compact-22mm | **DRAFT_REVIEW** | PROTOTYPE_CANDIDATE | 7 |
| evaluation-board | **DRAFT_REVIEW** | PROTOTYPE_CANDIDATE | 2 |

## compact-22mm

- **DRAFT_REVIEW:** met
- **PROTOTYPE_CANDIDATE:** 7 blocker(s)
  - VAL-ROUTE-compact-22mm: FAIL (20 unconnected items)
  - VAL-DRC-compact-22mm: FAIL (0 errors, 3 warnings, 0 exclusions {'via_dangling': 3}; ignored checks: tuning_profile_track_geometries (no track length tuning used; DD-20))
  - human review FP-U1 not recorded as DONE
  - human review FP-L1 not recorded as DONE
  - human review FP-POWERPAK not recorded as DONE
  - human review FP-RS1 not recorded as DONE
  - human review ORIENT not recorded as DONE
- **MANUFACTURING_RELEASE:** 3 blocker(s)
  - Gate G bench evidence incomplete for compact-22mm: 23 required tests not PASS (e.g. T0.1, T0.2, T0.3, T0.4, T1.1)
  - human review PCBWAY-DFM not recorded as DONE
  - no signed approval file manufacturing/approvals/compact-22mm.yaml

## evaluation-board

- **DRAFT_REVIEW:** met
- **PROTOTYPE_CANDIDATE:** 2 blocker(s)
  - human review FP-POWERPAK not recorded as DONE
  - human review FP-RS1 not recorded as DONE
- **MANUFACTURING_RELEASE:** 3 blocker(s)
  - Gate G bench evidence incomplete for evaluation-board: 29 required tests not PASS (e.g. T0.1, T0.2, T0.3, T0.4, T1.1)
  - human review PCBWAY-DFM not recorded as DONE
  - no signed approval file manufacturing/approvals/evaluation-board.yaml
