djgringoboy2003/Nub44-driver/reports/footprint-review.md

# Footprint review pack (evaluation board)

Generated by `automation/review/footprint_report.py` from the footprint files the build uses. It lists the geometry; it does not judge it. Record each completed comparison in `engineering/release/design-reviews.yaml` (status DONE, reviewer, date, evidence with document revision and page). Coordinates are footprint-local millimetres, KiCad convention (y down), pad centre and size; for custom pads w/h is the polygon extent.

## FP-U1: U1 (nubm44:TI_RPM0026A_VQFN-HR-26_4x3.5mm_P0.5mm)

**Compare against:** TI SLVSFC5 (LEAD-01, local copy research/datasheets/pwr_tps552882_slvsfc5.pdf): RPM0026A package outline and example board layout / stencil (drawing 4224618/A, about p.36-40). Compare pad sizes, 0.5 mm pitch, the three centre pads (24 PGND, 25 SW2, 26 VOUT) and pin 1; the centre pads are bridged to pins 9, 21 and 11 on the board (DD-16).

Footprint file: `hardware/libraries/nubm44.pretty/TI_RPM0026A_VQFN-HR-26_4x3.5mm_P0.5mm.kicad_mod` (SHA-256 `be5c90ebbd2a4438`)

| Pad | Type | Shape | x | y | w | h | rot | Pin name | U1 net |
|---|---|---|---|---|---|---|---|---|---|
| 1 | smd | custom polygon, extent x -2.2000..-1.4250, y -1.9500..-1.3750 | -1.8125 | -1.4875 | 0.7750 | 0.5750 | 0 | DR1L | DR1L |
| 2 | smd | roundrect | -1.9000 | -1.0000 | 0.6000 | 0.2500 | 0 | DR1H | DR1H |
| 3 | smd | roundrect | -1.8375 | -0.5000 | 0.7250 | 0.2500 | 0 | VIN | VBAT |
| 4 | smd | roundrect | -1.8375 | 0.0000 | 0.7250 | 0.2500 | 0 | EN/UVLO | EN_UVLO |
| 5 | smd | roundrect | -1.8375 | 0.5000 | 0.7250 | 0.2500 | 0 | PG | PG |
| 6 | smd | roundrect | -1.9000 | 1.0000 | 0.6000 | 0.2500 | 0 | CC | CC_FLAG |
| 7 | smd | custom polygon, extent x -2.2000..-1.5000, y 1.3750..1.9500 | -1.8500 | 1.4875 | 0.7000 | 0.5750 | 0 | DITH/SYNC | GND |
| 8 | smd | roundrect | -1.1250 | 1.6375 | 0.2500 | 0.6250 | 0 | FSW | FSW |
| 9 | smd | roundrect | -0.6250 | 1.6375 | 0.2500 | 0.6250 | 0 | PGND | GND |
| 10 | smd | roundrect | -0.1250 | 1.6375 | 0.2500 | 0.6250 | 0 | AGND | GND |
| 11 | smd | roundrect | 0.6250 | 1.6375 | 0.2500 | 0.6250 | 0 | VOUT | VOUT |
| 12 | smd | roundrect | 1.1250 | 1.6375 | 0.2500 | 0.6250 | 0 | ISP | ISP_K |
| 13 | smd | custom polygon, extent x 1.5000..2.2000, y 1.3750..1.9500 | 1.8500 | 1.4875 | 0.7000 | 0.5750 | 0 | ISN | ISN_K |
| 14 | smd | roundrect | 1.9000 | 1.0000 | 0.6000 | 0.2500 | 0 | FB | FB |
| 15 | smd | roundrect | 1.8375 | 0.5000 | 0.7250 | 0.2500 | 0 | MODE | GND |
| 16 | smd | roundrect | 1.8375 | 0.0000 | 0.7250 | 0.2500 | 0 | CDC | NC |
| 17 | smd | roundrect | 1.8375 | -0.5000 | 0.7250 | 0.2500 | 0 | ILIM | ILIM |
| 18 | smd | roundrect | 1.9000 | -1.0000 | 0.6000 | 0.2500 | 0 | COMP | COMP |
| 19 | smd | custom polygon, extent x 1.4250..2.2000, y -1.9500..-1.3750 | 1.8125 | -1.4875 | 0.7750 | 0.5750 | 0 | VCC | VCC5 |
| 20 | smd | roundrect | 1.0500 | -1.6125 | 0.2500 | 0.6750 | 0 | BOOT2 | BOOT2 |
| 21 | smd | roundrect | 0.2500 | -1.6500 | 0.2500 | 0.6000 | 0 | SW2 | SW2 |
| 22 | smd | roundrect | -0.2500 | -1.6500 | 0.2500 | 0.6000 | 0 | BOOT1 | BOOT1 |
| 23 | smd | roundrect | -1.0500 | -1.6125 | 0.2500 | 0.6750 | 0 | SW1 | SW1 |
| 24 | smd | roundrect | -0.6250 | 0.0000 | 0.3750 | 1.4250 | 0 | PGND | GND |
| 25 | smd | roundrect | 0.0000 | 0.0000 | 0.3750 | 1.4250 | 0 | SW2 | SW2 |
| 26 | smd | roundrect | 0.6250 | 0.0000 | 0.3750 | 1.4250 | 0 | VOUT | VOUT |

Placed on the evaluation board (PCBWay centroid, y up): U1 at (0.0000, 4.0000) mm, rotation 0.00 deg, top.

## FP-L1: L1 (Inductor_SMD:L_Coilcraft_XAL5030-XXX)

**Compare against:** Coilcraft XGL5030 datasheet and recommended land pattern (LEAD-05; PDF not stored locally). The board uses KiCad's XAL5030 pattern; confirm the XGL5030 body (about 5.28 x 5.48 mm) and terminals fit it.

Footprint file: `KiCad library: Inductor_SMD.pretty/L_Coilcraft_XAL5030-XXX.kicad_mod` (SHA-256 `51707005c3a357a9`)

| Pad | Type | Shape | x | y | w | h | rot | L1 net |
|---|---|---|---|---|---|---|---|---|
| 1 | smd | roundrect | -1.6550 | 0.0000 | 1.1800 | 4.7000 | 0 | SW1 |
| 2 | smd | roundrect | 1.6550 | 0.0000 | 1.1800 | 4.7000 | 0 | SW2 |

Placed on the evaluation board (PCBWay centroid, y up): L1 at (0.7500, 9.4000) mm, rotation -90.00 deg, top.

## FP-POWERPAK: Q1, Q2, Q3 (Package_SO:Vishay_PowerPAK_1212-8_Single)

**Compare against:** Vishay SiSS23DN and SiSS80DN datasheets (research/datasheets/cmp_Vishay_SiSS23DN.pdf, cmp_Vishay_SiSS80DN.pdf): pinout (S 1-3, G 4, D = drain pad and pins 5-8) and Vishay's PowerPAK 1212-8 single land pattern. Q1 is the P-channel reverse-polarity FET; its drain must be BAT_SPRING and its source VBAT.

Footprint file: `KiCad library: Package_SO.pretty/Vishay_PowerPAK_1212-8_Single.kicad_mod` (SHA-256 `8098cb723f5472c8`)

| Pad | Type | Shape | x | y | w | h | rot | Q1 net | Q2 net | Q3 net |
|---|---|---|---|---|---|---|---|---|---|---|
| 1 | smd | rect | -1.4350 | -0.9900 | 0.9900 | 0.4050 | 0 | VBAT | SW1 | GND |
| 2 | smd | rect | -1.4350 | -0.3300 | 0.9900 | 0.4050 | 0 | VBAT | SW1 | GND |
| 3 | smd | rect | -1.4350 | 0.3300 | 0.9900 | 0.4050 | 0 | VBAT | SW1 | GND |
| 4 | smd | rect | -1.4350 | 0.9900 | 0.9900 | 0.4050 | 0 | Q1_G | DR1H | DR1L |
| 5 | smd | custom polygon, extent x -0.3050..1.9300, y -1.1950..1.1950 | 0.5575 | 0.0000 | 2.2350 | 2.3900 | 0 | BAT_SPRING | VBAT | SW1 |

Placed on the evaluation board (PCBWay centroid, y up): Q1 at (-14.5000, 8.0000) mm, rotation 180.00 deg, top; Q2 at (-6.5000, 10.0000) mm, rotation 180.00 deg, top; Q3 at (-6.5000, 5.4000) mm, rotation 0.00 deg, top.

## FP-RS1: RS1 (nubm44:R_1206_3216Metric_Kelvin)

**Compare against:** Ohmite MCS1632R010FER datasheet land pattern (LEAD-07; PDF not stored locally). Pads 1/4 carry the current; 2/3 are the Kelvin sense pads, joined to 1/4 only at the resistor (net tie).

Footprint file: `hardware/libraries/nubm44.pretty/R_1206_3216Metric_Kelvin.kicad_mod` (SHA-256 `d7bd80a729bd03d9`)

| Pad | Type | Shape | x | y | w | h | rot | RS1 net |
|---|---|---|---|---|---|---|---|---|
| 1 | smd | roundrect | -1.4625 | 0.0000 | 1.1250 | 1.7500 | 0 | VOUT |
| 2 | smd | rect | -0.5500 | 0.0000 | 0.3000 | 0.3000 | 0 | ISP_K |
| 3 | smd | rect | 0.5500 | 0.0000 | 0.3000 | 0.3000 | 0 | ISN_K |
| 4 | smd | roundrect | 1.4625 | 0.0000 | 1.1250 | 1.7500 | 0 | LD_P |

Placed on the evaluation board (PCBWay centroid, y up): RS1 at (8.8000, -1.0000) mm, rotation 0.00 deg, top.

## ORIENT: U3 (Package_DFN_QFN:VQFN-20-1EP_3x3mm_P0.4mm_EP1.7x1.7mm)

**Compare against:** Microchip ATtiny1614/16/17 datasheet (LEAD-03) package drawing; plus pin-1 and polarity of every IC, diode and MOSFET in manufacturing/pcbway/evaluation-board/drawings/assembly_top.pdf and assembly/ibom.html.

Footprint file: `KiCad library: Package_DFN_QFN.pretty/VQFN-20-1EP_3x3mm_P0.4mm_EP1.7x1.7mm.kicad_mod` (SHA-256 `88cd1355432f8fcf`)

| Pad | Type | Shape | x | y | w | h | rot | U3 net |
|---|---|---|---|---|---|---|---|---|
| 1 | smd | custom polygon, extent x -1.8500..-1.0500, y -0.9000..-0.7000 | -1.4500 | -0.8000 | 0.8000 | 0.2000 | 0 | INTLK_MCU |
| 2 | smd | roundrect | -1.4500 | -0.4000 | 0.8000 | 0.2000 | 0 | SW_IN |
| 3 | smd | roundrect | -1.4500 | 0.0000 | 0.8000 | 0.2000 | 0 | GND |
| 4 | smd | roundrect | -1.4500 | 0.4000 | 0.8000 | 0.2000 | 0 | VMCU |
| 5 | smd | custom polygon, extent x -1.8500..-1.0500, y 0.7000..0.9000 | -1.4500 | 0.8000 | 0.8000 | 0.2000 | 0 | NTC_PWR |
| 6 | smd | custom polygon, extent x -0.9000..-0.7000, y 1.0500..1.8500 | -0.8000 | 1.4500 | 0.2000 | 0.8000 | 0 | NTC_BRD |
| 7 | smd | roundrect | -0.4000 | 1.4500 | 0.2000 | 0.8000 | 0 | CS_OUT |
| 8 | smd | roundrect | 0.0000 | 1.4500 | 0.2000 | 0.8000 | 0 | VOUT_SENSE |
| 9 | smd | roundrect | 0.4000 | 1.4500 | 0.2000 | 0.8000 | 0 | VBAT_SENSE |
| 10 | smd | custom polygon, extent x 0.7000..0.9000, y 1.0500..1.8500 | 0.8000 | 1.4500 | 0.2000 | 0.8000 | 0 | NTC_LD |
| 11 | smd | custom polygon, extent x 1.0500..1.8500, y 0.7000..0.9000 | 1.4500 | 0.8000 | 0.8000 | 0.2000 | 0 | NC |
| 12 | smd | roundrect | 1.4500 | 0.4000 | 0.8000 | 0.2000 | 0 | IND_OUT |
| 13 | smd | roundrect | 1.4500 | 0.0000 | 0.8000 | 0.2000 | 0 | CC_FLAG |
| 14 | smd | roundrect | 1.4500 | -0.4000 | 0.8000 | 0.2000 | 0 | PG |
| 15 | smd | custom polygon, extent x 1.0500..1.8500, y -0.9000..-0.7000 | 1.4500 | -0.8000 | 0.8000 | 0.2000 | 0 | NC |
| 16 | smd | custom polygon, extent x 0.7000..0.9000, y -1.8500..-1.0500 | 0.8000 | -1.4500 | 0.2000 | 0.8000 | 0 | NC |
| 17 | smd | roundrect | 0.4000 | -1.4500 | 0.2000 | 0.8000 | 0 | NC |
| 18 | smd | roundrect | 0.0000 | -1.4500 | 0.2000 | 0.8000 | 0 | NC |
| 19 | smd | roundrect | -0.4000 | -1.4500 | 0.2000 | 0.8000 | 0 | UPDI |
| 20 | smd | custom polygon, extent x -0.9000..-0.7000, y -1.8500..-1.0500 | -0.8000 | -1.4500 | 0.2000 | 0.8000 | 0 | LASER_EN_N |
| 21 | smd | rect | 0.0000 | 0.0000 | 1.7000 | 1.7000 | 0 | GND |
| (none) | smd | roundrect | -0.4250 | -0.4250 | 0.6900 | 0.6900 | 0 |  |
| (none) | smd | roundrect | -0.4250 | 0.4250 | 0.6900 | 0.6900 | 0 |  |
| (none) | smd | roundrect | 0.4250 | -0.4250 | 0.6900 | 0.6900 | 0 |  |
| (none) | smd | roundrect | 0.4250 | 0.4250 | 0.6900 | 0.6900 | 0 |  |

Placed on the evaluation board (PCBWay centroid, y up): U3 at (3.0000, -10.2000) mm, rotation 0.00 deg, top.
