djgringoboy2003/Nub44-driver/reports/budget-2s/layout-review.md

# Budget-2S routed-copper check

Generated by `automation/budget/layout_review.py`; do not hand-edit. DC resistance of the routed
copper between the listed pads (KiCad extraction, resistor-grid solve), scaled by the power model's
hot-copper factor. DC only: inductance, switching and copper temperature are not modelled. These
screens select items for review and never close a gate; bench data (Gate G) decides.

Currents: input 3.114 A and laser 4.500 A at the nominal operating point of `automation/budget/power.py` (VBUCK auxiliary loads and ripple RMS neglected).

| Group | Path | 25 °C mΩ | Hot mΩ | Current A | Hot loss mW | Neck (layer, at mm, equiv./screen width mm) |
|---|---|---|---|---|---|---|
| input | VBAT_IN: J1 B+ to fuse holder | 0.355 | 0.426 | 3.114 | 4.1 | F.Cu (-29.0, -10.55), 4.543/0.951 |
| input | VBAT_F: fuse holder to Q1 drain | 0.238 | 0.286 | 3.114 | 2.8 | F.Cu (-12.95, -8.5), 5.074/0.951 |
| input | VBAT_P: Q1 source to U1 VIN | 1.055 | 1.266 | 3.114 | 12.3 | F.Cu (1.65, -8.75), 1.673/0.951 |
| input | GND: U1 power ground to J1 B- | 0.258 | 0.31 | 3.114 | 3.0 | In2.Cu (-30.88, -18.08), 9.314/2.473 |
| converter | PH: U1 switch node to L1 (not in an allocation) | 1.091 | 1.309 | 4.5 | 26.5 | F.Cu (6.95, -10.7), 0.901/1.58 **review** |
| output | VBUCK: L1 to shunt | 0.826 | 0.991 | 4.5 | 20.1 | F.Cu (31.4, -8.1), 3.276/1.58 |
| output | VSH: shunt to Q2 source | 0.234 | 0.281 | 4.5 | 5.7 | F.Cu (39.9, -9.5), 2.287/1.58 |
| output | LASER_P: Q2 drain to J2 LD+ | 0.993 | 1.191 | 4.5 | 24.1 | F.Cu (42.0, -0.2), 3.638/1.58 |
| output | GND: J2 LD- to U1 power ground | 0.311 | 0.373 | 4.5 | 7.6 | In2.Cu (39.43, 8.22), 7.873/4.11 |

- **Output loop:** 2.836 mΩ hot against the 3 mΩ `output_copper_ohm_allocation`: within the allocation.
- **Input path:** copper 2.288 mΩ hot plus XT30 contacts 2.4 mΩ (BUD-30) leaves **10.312 mΩ** for the fuse and holder (hot) inside the 15 mΩ `input_path_ohm_allocation`. Fuse and holder resistance are UNKNOWN until a part is chosen; it must meet this figure.
- **Necks flagged for review** (equivalent width below the IPC-2221 20 K screen): PH (U1 switch node to L1 (not in an allocation)).
