djgringoboy2003/Nub44-driver/reports/budget-2s/qualification.md

# Budget-2S electrical qualification

Generated by `automation/budget/qualify.py`; do not hand-edit. Source: DD-30 / budget parameters.

**PROTOTYPE PCB FILES CHECKED — ELECTRICAL QUALIFICATION CONDITIONAL, NOT RELEASED.** Bare-board fabrication files exist for a dummy-load prototype; the BOM, reviews and bench data are still open. This report applies only to budget-2s.
Conditional calculations are not complete circuit verification. Existing A/B results do not apply.

## Calculated candidate screens

| Screen | Result | Qualification |
|---|---|---|
| Current setpoint | 4.4880 A nominal; 4.3194–4.6637 A envelope | CONDITIONAL: exact divider MPNs and hot shunt temperature are not verified |
| Independent trip | 5.2900 A nominal; 5.0935–5.4921 A envelope | 500 µV NAF included; CONDITIONAL: resistor MPN, response, shared-shunt and sense-fault study OPEN |
| UVLO falling | 5.5230 V nominal; 5.3984–5.6202 V | Hardware backstop below the loaded 6 V operating floor; margins below |
| Physical VBUCK OVP | 5.7200 V nominal; 5.6437–5.7967 V | Upstream of disconnect; laser survival/response UNKNOWN |
| Buck ripple, 25 °C L tolerance / 400 kHz minimum | ≤1.3963 A p-p; 5.1981 A peak at 4.5 A average | ROOM-TEMPERATURE screening; hot/bias L, core loss and saturation response UNKNOWN |
| Control rail additive screen | 3.0769–3.5231 V | LDO load budget, exact line anchor and brownout sequencing OPEN |

Current accuracy assumes the specified 0.1% / 25 ppm/°C resistors and the stated shunt-temperature
envelope. They are procurement/thermal requirements, not verified purchased parts or temperatures.

### Setpoint options (owner V-I points, DD-33)

Each owner current is a build that changes only the feedback-divider top resistor (E96). The backup trip
stays sized for the main setpoint, so it protects lower builds less closely.

| Target | Owner diode V | Divider top (exact → used) | Nominal | Tolerance envelope | Within ±5% |
|---:|---:|---|---:|---:|---|
| 3 A | 4.4 V | 15000.0 → 15000 Ω | 3.0000 A | 2.8857–3.1190 A | yes (conditional) |
| 3.5 A | 4.52 V | 19166.7 → 19100 Ω | 3.4920 A | 3.3597–3.6298 A | yes (conditional) |
| 4 A | 4.62 V | 23333.3 → 23200 Ω | 3.9840 A | 3.8338–4.1405 A | yes (conditional) |
| 4.5 A (main) | 4.72 V | 27500.0 → 27400 Ω | 4.4880 A | 4.3194–4.6637 A | yes (conditional) |

## Operating points, dropout and efficiency estimate

Averaged steady-state model in `automation/budget/power.py`: connector → input allocation → reverse FET →
TPS54821 → shunt → one output P-FET → board terminals (DD-31). The **typical** corner uses typical resistances
at 25 °C; the **maximum** corner uses full-temperature TPS54821 maxima, FET 25 °C maxima × 1.6 (assumption), hot inductor DCR, minimum L and worst ripple frequency.
Switching, dead-time, gate-drive and core terms are labelled `estimates`; copper, fuse and connector values are
`power_model` allocations the BOM/layout must meet. Efficiency is board-terminal power over connector power.
The model's largest energy-balance error is 7.6e-14 W.

Compliance grid at the 4.5 A setpoint (diode voltage across the required range):

| Output FET | Corner | Input V | Diode V | Duty | Input A | Loss (W) | Efficiency estimate |
|---|---|---:|---:|---:|---:|---:|---:|
| DMP2022LSS-13 | typical | 6 | 3.8 | 0.6994 | 3.1927 | 1.8537 | 90.32% |
| DMP2022LSS-13 | typical | 6 | 4.72 | 0.8545 | 3.8926 | 1.9132 | 91.81% |
| DMP2022LSS-13 | typical | 6 | 5.2 | 0.9382 | 4.2708 | 2.0226 | 92.11% |
| DMP2022LSS-13 | typical | 7.4 | 3.8 | 0.5632 | 2.5751 | 1.7533 | 90.80% |
| DMP2022LSS-13 | typical | 7.4 | 4.72 | 0.6874 | 3.1354 | 1.7592 | 92.42% |
| DMP2022LSS-13 | typical | 7.4 | 5.2 | 0.7543 | 3.4376 | 1.8355 | 92.78% |
| DMP2022LSS-13 | typical | 8.4 | 3.8 | 0.4947 | 2.2641 | 1.7161 | 90.98% |
| DMP2022LSS-13 | typical | 8.4 | 4.72 | 0.6034 | 2.7549 | 1.6991 | 92.66% |
| DMP2022LSS-13 | typical | 8.4 | 5.2 | 0.6620 | 3.0195 | 1.7613 | 93.06% |
| DMP2022LSS-13 | maximum | 6 | 3.8 | 0.7408 | 3.3835 | 2.9987 | 85.23% |
| DMP2022LSS-13 | maximum | 6 | 4.72 | 0.8985 | 4.0948 | 3.1261 | 87.28% |
| DMP2022LSS-13 | maximum | 6 | 5.2 | 0.9855 | 4.4875 | 3.3227 | 87.66% |
| DMP2022LSS-13 | maximum | 7.4 | 3.8 | 0.5931 | 2.7133 | 2.7760 | 86.17% |
| DMP2022LSS-13 | maximum | 7.4 | 4.72 | 0.7179 | 3.2767 | 2.8051 | 88.43% |
| DMP2022LSS-13 | maximum | 7.4 | 5.2 | 0.7866 | 3.5868 | 2.9395 | 88.93% |
| DMP2022LSS-13 | maximum | 8.4 | 3.8 | 0.5195 | 2.3795 | 2.6855 | 86.56% |
| DMP2022LSS-13 | maximum | 8.4 | 4.72 | 0.6284 | 2.8709 | 2.6735 | 88.91% |
| DMP2022LSS-13 | maximum | 8.4 | 5.2 | 0.6882 | 3.1411 | 2.7824 | 89.45% |
| SISS23DN-T1-GE3 (selected) | typical | 6 | 3.8 | 0.6901 | 3.1509 | 1.6027 | 91.52% |
| SISS23DN-T1-GE3 (selected) | typical | 6 | 4.72 | 0.8486 | 3.8661 | 1.7539 | 92.44% |
| SISS23DN-T1-GE3 (selected) | typical | 6 | 5.2 | 0.9323 | 4.2442 | 1.8627 | 92.69% |
| SISS23DN-T1-GE3 (selected) | typical | 7.4 | 3.8 | 0.5558 | 2.5416 | 1.5053 | 92.00% |
| SISS23DN-T1-GE3 (selected) | typical | 7.4 | 4.72 | 0.6827 | 3.1141 | 1.6022 | 93.05% |
| SISS23DN-T1-GE3 (selected) | typical | 7.4 | 5.2 | 0.7496 | 3.4163 | 1.6780 | 93.36% |
| SISS23DN-T1-GE3 (selected) | typical | 8.4 | 3.8 | 0.4882 | 2.2347 | 1.4694 | 92.17% |
| SISS23DN-T1-GE3 (selected) | typical | 8.4 | 4.72 | 0.5993 | 2.7364 | 1.5430 | 93.29% |
| SISS23DN-T1-GE3 (selected) | typical | 8.4 | 5.2 | 0.6579 | 3.0009 | 1.6049 | 93.63% |
| SISS23DN-T1-GE3 (selected) | maximum | 6 | 3.8 | 0.7206 | 3.2924 | 2.4519 | 87.59% |
| SISS23DN-T1-GE3 (selected) | maximum | 6 | 4.72 | 0.8835 | 4.0273 | 2.7211 | 88.74% |
| SISS23DN-T1-GE3 (selected) | maximum | 6 | 5.2 | 0.9704 | 4.4196 | 2.9151 | 89.01% |
| SISS23DN-T1-GE3 (selected) | maximum | 7.4 | 3.8 | 0.5770 | 2.6410 | 2.2406 | 88.54% |
| SISS23DN-T1-GE3 (selected) | maximum | 7.4 | 4.72 | 0.7061 | 3.2233 | 2.4102 | 89.90% |
| SISS23DN-T1-GE3 (selected) | maximum | 7.4 | 5.2 | 0.7747 | 3.5332 | 2.5431 | 90.27% |
| SISS23DN-T1-GE3 (selected) | maximum | 8.4 | 3.8 | 0.5055 | 2.3163 | 2.1548 | 88.93% |
| SISS23DN-T1-GE3 (selected) | maximum | 8.4 | 4.72 | 0.6180 | 2.8244 | 2.2827 | 90.38% |
| SISS23DN-T1-GE3 (selected) | maximum | 8.4 | 5.2 | 0.6779 | 3.0944 | 2.3905 | 90.80% |

Owner V-I points at 7.4 V input, SISS23DN-T1-GE3 (OWNER-VI-01):

| Current | Diode V | Corner | Output (W) | Loss (W) | Efficiency estimate |
|---:|---:|---|---:|---:|---:|
| 3 A | 4.4 | typical | 13.290 | 0.8280 | 94.14% |
| 3 A | 4.4 | maximum | 13.290 | 1.1810 | 91.84% |
| 3.5 A | 4.52 | typical | 15.942 | 1.0593 | 93.77% |
| 3.5 A | 4.52 | maximum | 15.942 | 1.5473 | 91.15% |
| 4 A | 4.62 | typical | 18.640 | 1.3275 | 93.35% |
| 4 A | 4.62 | maximum | 18.640 | 1.9756 | 90.42% |
| 4.5 A | 4.72 | typical | 21.442 | 1.6022 | 93.05% |
| 4.5 A | 4.72 | maximum | 21.442 | 2.4102 | 89.90% |

Loss breakdown at the efficiency condition (7.4 V input, 4.72 V diode, 4.5 A, typical corner, SISS23DN-T1-GE3):

| Term | W |
|---|---:|
| buck_conduction | 0.5673 |
| shunt | 0.2025 |
| input_path_allocation | 0.1455 |
| buck_switching_estimate | 0.1439 |
| inductor_dcr | 0.1425 |
| reverse_fet | 0.1067 |
| control_and_uv_divider | 0.0736 |
| output_fet | 0.0709 |
| output_copper_allocation | 0.0607 |
| inductor_core_estimate | 0.0500 |
| vbuck_aux_loads | 0.0342 |
| buck_quiescent | 0.0044 |

Estimate 93.05% versus the 93% target: meets the target as an estimate only. Bench efficiency is the evidence of record.

Converter terms alone, 8 V to 3.3 V, 4 A, typical corner, this inductor: 94.99% versus an approximate read of 95.5% from BUD-01's typical curve (-0.51 points).
This is a plausibility check of the estimate terms, not a guarantee. It does not include the shunt, protection
FETs, input path or control load.

| Margin check (selected FET, maximum corner) | Result | Required |
|---|---:|---:|
| Dropout: lowest regulating input at 5.2 V / 4.6637 A | 5.8604 V; margin 0.1396 V | ≥0.1 V below 6 V |
| UV sense node at 6 V input versus UV falling maximum | 5.8133 V vs 5.6202 V; margin 0.1931 V | ≥0.1 V; UV minimum ≥5 V |
| Highest normal VBUCK at 4.95 A versus OVP rising minimum | 5.5077 V vs 5.6437 V; margin 0.1360 V | ≥0.1 V |
| Output P-FET \|Vgs\| (gate divider, DD-34 clamp) | 3.6778–5.5447 V normal; 6.51 V clamped fault | clamp off below 5.89 V; rating ±8 V |
| Reverse P-FET \|Vgs\| maximum | 8.4 V | rating ±12 V |

Gate ratings exclude plug and switching transients; a gate clamp is still OPEN. The output FET's
exposed-drain land, paste and X-ray inspection review remain OPEN.

## Default-off interface (static, DD-32)

nFAULT is the wired-AND fault line and the latch CLR. Series N-MOSFET pairs N1/N2 (output P-FET gate) and
N3/N4 (gate of P1, which sources the EN divider from VCTRL) each need ARM_Q **and** nFAULT high, so any
asserted fault turns both outputs off without relying on the latch. N5 holds nFAULT low unless firmware
drives its permit pin low. Worst cases use the control-rail screen 3.0769–3.5231 V. Static only; timing and energy are BUD-SAFE-01.

| Check | Worst case | Limit | Margin | Basis |
|---|---:|---:|---:|---|
| nFAULT leakage out of node, datasheet sum | 6.05e-06 A | ≤1e-05 A | 3.95e-06 A | 25 C maxima of all sinks and loads |
| nFAULT leakage into node, datasheet sum | 4e-06 A | ≤5e-06 A | 1e-06 A | 25 C maxima of all inputs |
| nFAULT high (no fault) at VCTRL 3.0769 V | 2.444 V | ≥2.311 V | 0.1337 V | HCS74 VT+ (interpolated), N2/N4 RDS drive, MCU VIH; leakage allocation |
| nFAULT high (no fault) at VCTRL 3.5231 V | 2.811 V | ≥2.605 V | 0.2058 V | HCS74 VT+ (interpolated), N2/N4 RDS drive, MCU VIH; leakage allocation |
| nFAULT with interlock loop open | 0.235 V | ≤0.4 V | 0.165 V | pulldown against input-leakage allocation |
| nFAULT low, TLV6700 OUTA/OUTB asserting at VCTRL 3.0769 V | 0.0258 V | ≤0.4 V | 0.3742 V | BUD-18 p.5; VOL scaled linearly (ASSUMPTION) |
| nFAULT low, TLV6700 OUTA/OUTB asserting at VCTRL 3.5231 V | 0.02948 V | ≤0.4 V | 0.3705 V | BUD-18 p.5; VOL scaled linearly (ASSUMPTION) |
| nFAULT low, TLV803EA29 RESET asserting at VCTRL 1.7000 V | 0.104 V | ≤0.4 V | 0.296 V | BUD-20 p.8 (VDD 1.7 V row); VOL scaled linearly (ASSUMPTION); latch unspecified, N2/N4 off only |
| nFAULT low, TLV803EA29 RESET asserting at VCTRL 2.9886 V | 0.1805 V | ≤0.4 V | 0.2195 V | BUD-20 p.8 (VDD 1.7 V row); VOL scaled linearly (ASSUMPTION) |
| nFAULT low, INA300 ALERT asserting at VCTRL 3.0769 V | 0.04129 V | ≤0.4 V | 0.3587 V | BUD-06 p.5; VOL scaled linearly (ASSUMPTION) |
| nFAULT low, INA300 ALERT asserting at VCTRL 3.5231 V | 0.04718 V | ≤0.4 V | 0.3528 V | BUD-06 p.5; VOL scaled linearly (ASSUMPTION) |
| nFAULT low, DMG1012T inhibit N5 asserting at VCTRL 3.0769 V | 0.0002168 V | ≤0.4 V | 0.3998 V | LEAD-04 p.2; VOL scaled linearly (ASSUMPTION) |
| nFAULT low, DMG1012T inhibit N5 asserting at VCTRL 3.5231 V | 0.0002477 V | ≤0.4 V | 0.3998 V | LEAD-04 p.2; VOL scaled linearly (ASSUMPTION) |
| ARM_Q load current | 8.976e-06 A | ≤2e-05 A | 1.102e-05 A | BUD-19 levels hold only at |IO| <= 20 uA |
| N1/N3 gate when armed | 2.938 V | ≥1.9 V | 1.038 V | VOH >= VCC - 0.1 V; RDS specified at 1.8 V |
| N1/N3 gate when cleared | 0.1099 V | ≤0.4 V | 0.2901 V | VOL <= 0.1 V plus gate leakage |
| Series pair leakage, datasheet | 1e-07 A | ≤1e-05 A | 9.9e-06 A | LEAD-04 IDSS, 25 C |
| Output P-FET |Vgs| when off | 0.022 V | ≤0.3 V | 0.278 V | pull-up to VBUCK against the leakage allocation |
| Output P-FET |Vgs| when on | 3.672 V | ≥2.6 V | 1.072 V | gate-divider fraction of minimum VBUCK; 2.5 V resistance condition |
| Output P-FET |Vgs| at OVP maximum, clamp off | 5.545 V | ≤5.79 V | 0.2453 V | BZX585-C6V2 minimum VZ (PREORDER-11) |
| Output P-FET |Vgs| at a switch-short, clamped | 6.51 V | ≤7.9 V | 1.39 V | clamp maximum VZ against the gate rating |
| Reverse P-FET |Vgs| at maximum pack voltage | 8.4 V | ≤11.9 V | 3.5 V | gate grounded; no clamp |
| N1/N2 drain voltage at a buck switch-short | 8.4 V | ≤20 V | 11.6 V | VBUCK can reach the pack voltage |
| P1 |Vgs| when off | 0.12 V | ≤0.4 V | 0.28 V | BUD-23 VGS(th) against leakage allocation |
| P1 |Vgs| when on | 3.076 V | ≥2.6 V | 0.4765 V | RDS specified at -2.5 V |
| P1 gate-source voltage rating | 3.523 V | ≤6 V | 2.477 V | BUD-23 VGSS |
| EN when armed | 1.538 V | ≥1.36 V | 0.1784 V | BUD-01 p.5 rising maximum; internal pull-up ignored (it only helps) |
| EN absolute maximum | 1.984 V | ≤6 V | 4.016 V | BUD-01 p.3 |
| EN pull-up tolerated when disarmed (x typical) | 86.96 x | ≥10 x | 76.96 x | BUD-01 gives the pull-up as typical only |
| EN with any logic state at VCTRL <= 1.7 V | 0.9075 V | ≤1 V | 0.0925 V | P1 can only source VCTRL; holds below the supervisor's specified range |
| Supervisor falling threshold minimum | 2.871 V | ≥2.73 V | 0.1414 V | HCS74 2.0 V and ATtiny 10 MHz 2.7 V minimum supplies |
| Supervisor release threshold maximum | 3.033 V | ≤3.047 V | 0.01349 V | control-rail screen minimum |
| N5 gate with MCU pin tristated | 2.877 V | ≥1.9 V | 0.9769 V | default inhibit; MCU leakage ASSUMPTION |
| N5 gate with MCU permitting | 0.002898 V | ≤0.4 V | 0.3971 V | PREORDER-08 VOL scaled linearly (ASSUMPTION) |
| Latch CLK high from MCU | 3.077 V | ≥2.311 V | 0.7661 V | PREORDER-08 VOH scaled linearly (ASSUMPTION); HCS74 VT+ interpolated |
| Latch CLK low from MCU | 8e-05 V | ≤0.4585 V | 0.4584 V | PREORDER-08 VOL scaled linearly (ASSUMPTION); HCS74 VT- interpolated |
| Back-powered VCTRL | 0.3 V | ≤0.4 V | 0.1 V | injection allocation into the VCTRL bleed resistor |

Assumptions: HCS74 thresholds interpolated between the 2 V and 4.5 V rows; open-drain/MCU VOL and VOH scaled linearly from their test currents; leakage allocations cover 25 C datasheet maxima; hot leakage UNKNOWN; TPS54821 EN pull-up and ATtiny pin leakage are typical-only figures; interlock loop and back-power injection are allocations for later parts.

## Stored energy and discharge

At the assumed 220 µF maximum: 3.6962 mJ at calculated OVP maximum,
or 7.7616 mJ at a 8.4 V switch-short fault. The proposed 100 nF
laser-side capacitor alone stores 1.6801 µJ at OVP maximum.
A 1 kΩ +1% bleeder takes 0.5445 s to reach 0.5 V;
its -1% fault dissipation at 8.4 V is 0.0713 W.
Cable, diode and gate capacitance, inductive energy, FET delay/SOA and reconnect peak are UNKNOWN.
Voltage and energy arithmetic do not establish laser safety. See the budget fault matrix.

## Release prerequisites

| ID | Status | Outstanding work |
|---|---|---|
| BUD-CALC-01 | CONDITIONAL | Setpoint tolerance screen; exact resistor MPNs and hot shunt envelope need qualification. |
| BUD-PWR-01 | CONDITIONAL | Maximum-resistance model regulates 4.6637 A at 5.2 V down to 5.8604 V input (0.1396 V margin, 0.1 V required). Conditional on the input/output resistance allocations, boot-regulator level and low-side resistance below 12 V; thermal/bench dropout OPEN. |
| BUD-EFF-01 | CONDITIONAL | Estimate 93.05% at 7.4 V input, 4.72 V diode, 4.5 A, typical corner versus 93% target. Estimate only; bench efficiency decides. |
| BUD-UV-01 | CONDITIONAL | UV falling 5.3984–5.6202 V versus loaded sense minimum 5.8133 V at 6 V input (0.1931 V margin, 0.1 V required; floor 5 V). Pack rating, firmware cutoff OPEN. |
| BUD-OV-01 | CONDITIONAL | OVP rising minimum 5.6437 V versus highest normal VBUCK 5.5077 V at 4.95 A (0.1360 V margin). Open-load response and laser survival OPEN. |
| BUD-IF-01 | CONDITIONAL | 37/37 static default-off checks pass; smallest voltage margin 0.0135 V (Supervisor release threshold maximum). Conditional on: HCS74 thresholds interpolated between the 2 V and 4.5 V rows; open-drain/MCU VOL and VOH scaled linearly from their test currents; leakage allocations cover 25 C datasheet maxima; hot leakage UNKNOWN; TPS54821 EN pull-up and ATtiny pin leakage are typical-only figures; interlock loop and back-power injection are allocations for later parts. |
| BUD-SAFE-01 | OPEN | Total fault response time and energy, output-FET turn-off, single and latent faults (power-on self-test), interlock cable faults and bench fault injection. |
| BUD-LOOP-01 | OPEN | Preliminary small-signal model is separate; complete switching/fault and component-corner qualification remains open. |
| BUD-CAD-01 | CONDITIONAL | Schematic PASS: ERC 0 errors / 0 warnings, 108 parts, 0 netlist differences. Footprints not generated: none. PCB DRC 0 errors / 0 warnings / 0 unconnected / 0 parity (parity and all severities on). Routed copper: output loop 2.836 mΩ hot vs 3 mΩ allocation (within); fuse and holder budget 10.312 mΩ hot. Necks for review: PH (U1 switch node to L1 (not in an allocation)). Open reviews: U1 RHL land and stencil (project footprint), shared FP-POWERPAK land (Q2), XT30 moulded +/- marks, J2 wire-entry side; thermal behaviour is bench-only. |
| BUD-FW-01 | OPEN | Budget MCU HAL/ADC/clock/reset/arming interface and target build are not qualified. |
| BUD-MFG-01 | CONDITIONAL | Prototype Gerbers/drill/CPL checked against the DRC-clean board. BOM has 0 lines to select at order (MPN UNKNOWN, requirement listed). Assembly quote, DFM review and inspection plan OPEN. |
| BUD-COST-01 | OPEN | Complete 3/5-unit delivered GBP quotes UNKNOWN; GBP 180/300 are ceilings. |
| BUD-G-01 | OPEN | No measured budget-board records. Gate G requires real dummy-load/thermal/fault data. |

## Explicit UNKNOWN inputs

- `buck.switch_loss_w`
- `buck.minimum_boot_refresh_duty`
- `inductor.minimum_l_h_hot_biased`
- `inductor.core_loss_w`
- `backup.propagation_s_guaranteed_max`
- `voltage_monitor.guaranteed_delay_s_max`
- `control.complete_enable_buffer`
- `disconnect.total_shutdown_s_guaranteed_max`
- `output_energy.bulk_cap_effective_verified`
- `output_energy.laser_reconnect_peak_verified`
- `loop.verified_model`
- `procurement.quoted_component_total_gbp`
- `procurement.quoted_fab_assembly_landed_gbp`
- `procurement.pack_bms_charger_mpn`
- `procurement.assembly_quantity_three_accepted`

No quote, supplier stock, successful simulation, physical measurement or manufacturing release is inferred.
