djgringoboy2003/Nub44-driver/reports/budget-2s/loop-model.md

# Budget-2S preliminary current-loop model

Generated by `automation/budget/loop_model.py`; do not hand-edit.

**Model sensitivity only.** A successful run does not qualify the real circuit or close BUD-LOOP-01.

The candidate type-II network is 180 Ω / 1 µF
with 4.7 nF at COMP. It uses BUD-01's typical error-amplifier
transconductance (1.3 mS), typical current modulator
(21 A/V), minimum EA DC gain 1000
and PREORDER-07's typical INA186A2 bandwidth (37 kHz).
All design values are in the budget YAML.

The incremental diode/load resistance (0.08/0.2/0.35 Ω), effective output
capacitance (50/100/220 µF), EA gm factors (0.7/1/1.3),
modulator gm factors (0.7/1/1.3), sensor-bandwidth sensitivity
(20/37/60 kHz) and assumed inner pole at
0.1 times the minimum switching frequency are **analysis assumptions**,
not guaranteed data or measurements.
The load-current transfer is `1 / (1 + s*Rd*Cout)` for an ideal controlled current source feeding
the output capacitor and incremental load. The sensor contributes its gain/shunt factor and one pole;
the exact divider and finite error-amplifier output resistance are included.

| Result | Actual tool result |
|---|---:|
| Sensitivity cases | 243 |
| Cases meeting ≥45° phase / ≥10 dB gain screen | 243 |
| Minimum phase margin in these cases | 99.015° |
| Minimum gain margin in these cases | 13.512 dB |
| ngspice process return code | 0 |
| ngspice AC samples | 631 |
| Maximum complex relative error versus independent equation | 1.4930504e-08 |
| Required relative agreement | 1e-05 |
| Equation / ngspice agreement | PASS |

This is a consistency check between two implementations of the same assumed model, not independent
verification of TPS54821 internal dynamics. No infinite gain margin is awarded when a phase crossing
is absent; the study must contain a unity and a phase crossing to pass its margin screen.

Still OPEN: measured diode incremental impedance; exact capacitor DC-bias/temperature/ESR envelope;
inner sampled-data dynamics and slope compensation at high duty; amplifier delay and higher poles;
COMP range/clamps; SS tracking/current ramp; startup, flashing, disconnect sequencing, output-open,
short and reconnected-load switching transients; component tolerances outside these assumed sweeps.
In particular, this small-signal model contains no mechanism to prove a ≤4.95 A reconnect peak.

Use the generated JSON for every corner, `.cir` for the inspectable ngspice circuit and `.txt` for its
raw AC output. Hash evidence binds all results to the numeric sources and both model implementations.
