djgringoboy2003/Nub44-driver/PROGRESS.md

# Progress

## Current state (handover)

_Last updated: 2026-11-07 (repository made public at owner direction; budget-2s electrical qualification, DD-30 checkpoint by Codex, continued by
Claude Code with DD-31: single output P-FET, UV backstop, operating-point/dropout model, owner's 93%
efficiency decision; DD-32: static default-off interface; DD-33: owner main setpoint 4.5 A; DD-34: owner
sourcing directive and part swaps; DD-35: budget KiCad schematic; DD-36: A/B boards moved to 4.5 A; DD-37: A/B efficiency target 93 %; DD-38: budget PCB and prototype manufacturing package; DD-39: budget BOM sourced; DD-40: LCSC codes for every budget BOM line). The pre-order, quote, GBP/UK and Project 450
reviews and DD-29 plan are integrated into `main`. The original A/B electrical sources, 4.0 A setpoint,
protection thresholds, copper and manufacturing files remain unchanged. The GitHub repository is PUBLIC by
owner decision as of 2026-11-07; the tracked PCBWay quote workbook, related pricing/sourcing reports, and full
Git history are exposed. The gate table below is A/B only._

| Gate | Status | Evidence |
|---|---|---|
| A Research | PASS | Research/requirement documents |
| B Electrical design | PASS | Both schematics: ERC 0/0; exact connectivity comparison; hash-bound evidence |
| C Simulation | PASS (model-level) | SIM-01…11 pass in the averaged ngspice model; SIM-11 is now a frequency-response analysis. SIM-12 (tolerance sweep, outside Gate C) has one open finding |
| D Routing | Evaluation PASS; compact OPEN | Evaluation fully connected; compact has 20 unconnected items |
| E ERC/DRC | Evaluation PASS; compact OPEN | Evaluation 0/0/0/0; compact 0 errors / 3 warnings / 20 unconnected / 0 parity |
| F Manufacturing files | Evaluation PASS (internal consistency); compact OPEN | DRAFT packages only; the compact ZIP carries DO_NOT_FABRICATE.txt |
| G Physical validation | OPEN | No bench records (`reports/bench-report.md`); only measured data can close it |

**Release readiness:** **DRAFT_REVIEW; hold payment pending footprint dispositions.** Independent AI review of
`fab63177bd7086457878a5da7a13dc7cc917e8c3` is in `reports/pre-order-review.md`. Evaluation FP-U1, FP-L1 and
ORIENT are recorded DONE; FP-POWERPAK and FP-RS1 remain OPEN. U3's land-pattern difference also requires DFM
disposition (AUD-PCB-06). Compact reviews remain OPEN. AUD-VAL-11/12 identify missing-ID and stale-review
weaknesses in release checks. The owner decides whether AI review is sufficient. Release reports were
regenerated after merging the review (2026-10-28): the evaluation board has 2 blockers to PROTOTYPE_CANDIDATE
(FP-POWERPAK, FP-RS1); rerun the full toolchain after any disposition or fix.

**Ordering (prepared, not placed):** `documentation/ordering-guide.md` gives the files, layer order (L1 `.gtl`,
L2 `.g1`, L3 `.g2`, L4 `.gbl`) and order-form options for PCBWay (`manufacturing/pcbway/evaluation-board/`,
preferred for assembly) and JLCPCB (`manufacturing/jlcpcb/evaluation-board/`, derived with identical Gerber bytes).
Key options: 4 layers, 1.6 mm, **1 oz inner and outer copper**, **ENIG**, assembly top side only (29 parts, 52
placements), X-ray of U1/U3, no unreviewed substitutes. The pre-order review brief for Codex (or a person) is
`documentation/pre-order-review.md`, with the footprint geometry in `reports/footprint-review.md`.

**Quote/sourcing review:** `reports/bom-quote-sourcing-review.md`, per-line `reports/bom-sourcing-options.csv`.
QUOTE-01 matches all 30 BOM lines, exact MPN suffixes and J1 DNS; arithmetic correct. Five-board stored total
304.615, dollar-format cells but ISO currency UNKNOWN. L1 is 126.790 (50.79% of components); cause UNKNOWN,
request exact-MPN reprice. Owner currency GBP: conditional USD quote equivalent £229.25 (FX-01); quote ISO
still UNKNOWN. Native GBP distributor snapshots, quantities, UK eBay findings and proposed packing-only
alternatives are now recorded in the report/CSV. Exact Coilcraft L1 reference converts to £1.97 each before
unknown freight/tax/handling; current UK stock/delivered offer UNKNOWN. No cheaper electrical straight swap
approved. AliExpress Choice offers remain UNKNOWN. Three-assembly and consignment totals need PCBWay quotes; published minimum 5 and conflicting attrition rules need written
clarification.
Recommend revised turnkey; genuine L1-only consignment is the fallback to quote. Diode PREORDER-09/10/11 are
now saved locally with hashes. No design/CAD/export change. Dashboard missing board scope is new AUD-DOC-05.

**Project 450 inspiration:** `research/project450-design-notes.md` compares thermal mounting, deliberate arming,
startup, diagnostics and charging inhibition with our existing design. The two-cell TPS56C215 buck is not
a straight swap for the single-cell TPS552882; costs/savings UNKNOWN. Proposals only; no design change.

**Separate budget track (DD-29/30, DD-38): prototype PCB files checked; electrical qualification CONDITIONAL;
not released.** Owner accepts two
series Li-ion cells, no size constraint and £60 per working driver; compare three/five (£180/£300 batch
ceilings, not quotes). Continue from `engineering/budget-2s-design.md`; the earlier rationale remains in
`engineering/budget-driver-plan.md`. Independent numeric sources now exist in
`engineering/design/budget-2s/parameters.yaml`, with a separate source resolver, electrical calculation tool
and preliminary current-loop model. BUD-01…22 record manufacturer evidence and explicit assumptions.

Actual development results: conditional 3.9840 A setpoint / 3.8414–4.1321 A tolerance envelope and independent
4.8098–5.1746 A backup-trip window. The 180 Ω candidate passes all 243 assumed loop-sensitivity cases;
ngspice AC agrees with the analytical equation. This is a small-signal model, not physical or switching-fault
proof. A 330 Ω candidate failed 19/243 cases and was replaced in the study. Generated evidence lives in
`reports/budget-2s/`; never hand-edit it.

DD-31 (2026-10-29): the back-to-back output pair is replaced by one P-FET (source at VBUCK; the second FET
added loss but no protection), with DMP2005UFG-7 selected for development. The UV divider is now 130 kΩ, so the
hardware UV is a backstop below the loaded 6.0 V floor. A new operating-point model (`automation/budget/power.py`)
replaces the resistance-only screen. Results, at the maximum-resistance corner and conditional on the 15 mΩ
input and 3 mΩ output-copper allocations: regulation at 5.2 V / maximum setpoint down to about 5.78 V input;
UV and OVP margins about 0.21 V each. The efficiency **estimate** at 7.4 V / 4.5 V / 4 A is about 93.4%. That
was below the proposed 94%, and the owner chose option (a): a budget target of ≥ 93%, judged by bench
measurement (the 93% value was proposed by Claude Code). The estimate margin is only about 0.4 points. The
converter terms agree with TI's typical curve to within about half a point.

DD-34 (2026-10-29, owner directive): the budget board is to use cheap, easy-to-source parts from UK
distributors or fast China channels. Policy: semiconductors are genuine, from UK distributors or LCSC; only
passives, connectors and fuses come from AliExpress. DMP2005UFG-7 (40-week lead) is replaced by SiSS23DN with a
100 Ω gate resistor and a BZX585-C6V2 clamp. WSK2512 is replaced by WSL2512R0100FEA (BUD-24). The estimate is
still 93.05% and all 37 interface checks pass. TPS54821 (no stock KiCad footprint, LCSC stock, 12-week DigiKey
lead) and SRP1265A remain the hardest parts. Several UK stock checks are still pending (BUD-25 snapshots only).

DD-33 (2026-10-29, owner): the budget main setpoint is now **4.5 A at 4.72 V** (owner expects about 7.3 W optical).
Owner V–I points 3.0/3.5/4.0/4.5 A at 4.40/4.52/4.62/4.72 V are one-resistor builds (OWNER-VI-01). The A/B boards
keep 4.0 A. Changes: divider top 27.4 kΩ (4.488 A nominal, 4.33–4.65 A envelope), transient ceiling 4.95 A, INA300
2.67 kΩ (5.10–5.48 A trip). Dropout about 5.86 V (0.14 V margin); UV/OVP margins 0.19/0.18 V; loop 243/243.
Efficiency estimate at 7.4 V / 4.5 A / 4.72 V is **93.05%**, only about 0.05 points above the 93% target
(maximum-resistance corner about 90%), so a bench result below 93% is plausible. **Diode risk:** 4.5 A exceeds
the 4.2 A maximum operating current in LD-05 (single secondary source), and about 7 W exceeds its 6.0 W optical
maximum. This is recorded as owner-accepted, like DD-13; the diode needs about 14 W of heatsinking.

DD-32 (2026-10-29): the static default-off interface is designed (BUD-ISS-03). The fault line nFAULT (supervisor,
UV/OV, INA300 alert, firmware-permit inhibit, external interlock loop) and the latch output each drive one
DMG1012T of a series pair. N1/N2 hold the output P-FET and N3/N4 hold P1, which sources the EN divider from
VCTRL. Any fault therefore turns both outputs off without relying on the latch. The firmware-permit FET
defaults to inhibit during MCU reset, so re-arming needs a new edge. EN stays below its guaranteed disable
level at VCTRL < 1.7 V whatever the logic state. `automation/budget/interface.py` passes 34/34 static checks
(BUD-IF-01 CONDITIONAL). Its assumptions are listed in the report: interpolated latch thresholds at 3.3 V,
linearly scaled VOL, 25 °C leakage allocations, typical-only EN pull-up and MCU leakage. The smallest margin
is the supervisor release threshold, about 13 mV beyond its 30 mV allocation.

DD-35/38: the budget KiCad project (`hardware/budget-2s`) is generated from the budget connectivity and placement
sources. The schematic has ERC 0/0 with an exact netlist (108 parts, 56 nets). The board is 90 × 60 mm, four
layers, all parts on the top.
- **DRC:** 0 errors, 0 warnings, 0 unconnected, 0 parity.
- **U1 footprint:** project TI RHL land, thermal vias, corner paste kept clear of the drills.
- **J1:** XT30 pins swapped to match KiCad's "+" mark.
- **Routed copper** (`automation/budget/layout_review.py`): the output loop is 2.84 mΩ hot against the 3 mΩ
  allocation, after LASER_P was repeated on In2/B.Cu (it was 4.29 mΩ). The input leaves 10.3 mΩ hot for the
  fuse and holder. DD-40 took the XT30 contacts at 1.20 mΩ each, from the current Amass specification (BUD-30).
  The 0.80 mΩ older drawing gave 11.1 mΩ.
- **Package** (`manufacturing/budget-2s/`): Gerber/drill ZIP, BOM 55 lines / 99 parts, CPL, PDFs, renders,
  `ORDERING.md`. DD-39: every line has an MPN checked against a distributor listing. Order codes and evidence
  are in `engineering/design/budget-2s/sourcing.yaml`; prices and stock stay UNKNOWN. R16 changed 134 k → 133 k,
  because 134 k is not a purchasable value (OV margin 0.136 V). DD-40: every line has an LCSC code read on its
  product page. LCSC does not list R5 and R7, so the JLCPCB BOM uses labelled Yageo AT equivalents with the same
  specification. J2 is rated UL 10 A / IEC 15 A (BUD-31).
- **Routing archive:** FreeRouting results vary with KiCad's DSN pour order, so the accepted session is archived
  in `hardware/budget-2s/routing/` and `build_pcb.py --stage restore` reproduces the board.
- **Open before an order:**
  - the U1 and Q2 land reviews;
  - the XT30 moulded marks and J2 wire entry;
  - a fuse plus holder of at most 10.3 mΩ hot;
  - for JLCPCB assembly: live LCSC stock, the JLCPCB part class, and through-hole assembly or hand-fitting;
  - live stock and quotes.
- **Also open:** BUD-ISS-04 (total shutdown time and fault energy, including the output P-FET turn-off through
  its 2.2 kΩ pull-up), budget firmware, and all nine REQ-BUD requirements with physical qualification.

`qualify.py` exits 1 deliberately with thirteen unresolved prerequisites: eight CONDITIONAL (now including CAD and
manufacturing files) and five OPEN. Prices/stock and delivered/development GBP totals are UNKNOWN. Earlier
four-role reference baskets omit most of the driver and are not build totals. Legacy validation/dashboard
still cover A/B only; their PASS results cannot qualify this circuit.

**A/B at 4.5 A (DD-36, owner 2026-10-29).** R8 8.66 kΩ, R3 24.9 kΩ and firmware `APP_I_SET_MA` 4500. The owner
accepted two deviations: the backup margin factor 1.0 (ISP/ISN 4.8–5.2 A against a worst-case setpoint of 4.66 A),
and the reverse-FET limit 0.7 W (0.68 W computed). Results:
- Calculations 21/21; simulations 12/12, so VAL-SIM-12 / AUD-SIM-04 is resolved.
- Evaluation DRC 0/0/0/0 after restoring the archived router session; compact board unchanged (parked).
- Exports regenerated.
- Routed-copper efficiency estimate 93.56%. The owner lowered the A/B target to ≥ 93%, bench-judged (DD-37), so
  the estimate has 0.56 points of margin.

**Validation (existing A/B only):** full-toolchain rerun after DD-38 (2026-10-29, KiCad, ngspice and avr-gcc
present): exit 0, 57 entries, 55 PASS and 2 known, unchanged failures listed in
`engineering/known-limitations.yaml`: compact routing and compact DRC (accepted, DD-27). VAL-SIM-12 was resolved and
removed from the baseline. Any new or changed failure makes it exit 1. The evaluation board has 2 blockers to
PROTOTYPE_CANDIDATE (FP-POWERPAK, FP-RS1).

**Tests (2026-10-28, budget-planning milestone, existing project):** 207 Python tests pass in 31.64 s (the independent review saw 188 pass /
19 skip without KiCad). Earlier firmware-evidence and footprint-report reruns matched the committed ones except
timestamps; the evaluation PCB, connectivity and PCBWay package remain unchanged. Last firmware verification:
six host suites with 531 checks, register-model tests of `hal_avr.c`, ATtiny1616 build 4134 B flash / 59 B RAM with
`-Werror`, mutation check 15/15. Calculations 21/21. Simulations 11/12 (SIM-12 finding). Sourcing check 0 FAIL / 29
WARN. GitHub CI passed on the parent commit; see run 40500901442 below.

**Audit outcome** (`reports/comprehensive-project-audit.md`): 60 findings (11 high, 31 medium, 17 low, 1 info); 41 fixed, 2 mitigated, 11 documented, 6 open. Pre-order findings: AUD-VAL-11/12, AUD-PCB-06, AUD-DOC-04/05. The last is a dashboard display defect; real evaluation blockers remain two.
- **Firmware (DD-28):** fixed a board-NTC failure that silently disabled thermal protection, a watchdog cleared even
  when the tick stopped, watchdog resets that re-armed emission, the 2.5 V reference used below its VDD minimum, the
  AC2 power-loss reference written to the wrong register (the click mode change could not work), missing debounce,
  hold-up races and more. The firmware is untested on hardware.
- **Evidence:** calculations, simulations and schematics are now hash-bound with tool versions; stale or edited
  evidence fails.
- **Release controls:** DRAFT_REVIEW / PROTOTYPE_CANDIDATE / MANUFACTURING_RELEASE levels with human reviews, bench
  evidence and signed approvals; incomplete boards are marked inside their fabrication ZIP.
- **New tooling:** sourcing verification, bench-test recording (`automation/bench/bench.py`), status dashboard
  (`reports/dashboard/index.html`), CI.

**Owner decisions in force:** budget-2s main setpoint 4.5 A at 4.72 V with 3.0/3.5/4.0 A builds (DD-33,
2026-10-29); budget-2s efficiency target ≥ 93% at 7.4 V and the main setpoint, bench-judged (DD-31); battery polarity centre spring = B+, ring = B−, marked on both boards (DD-12); A/B 4.5 A with backup margin
factor 1.0 and reverse-FET limit 0.7 W (DD-36; was 4.0 A, DD-13); A/B efficiency target ≥ 93 % at 4.0 V / 4.5 A, bench-judged (DD-37; was 94 %, DD-26); evaluation board first, compact parked (DD-27).

**Decisions now required from the owner:**
1. **AUD-SRC-04:** R16 (indicator resistor) is overloaded if the external LED pad is shorted; consider a larger
   package or value.
2. **AUD-PCB-04:** optional gate clamp for Q6 (VGSS ±6 V) in a later revision.
3. **Compact board direction** after bench data: HDI, 6-layer or re-architecture, plus removing the unused PG net
   (`engineering/pcb-review-2026-10-26.md`).
4. **Fab choice** (PCBWay preferred for assembly) and acceptance of the pre-order review results.

**Open limitations.**
1. HDI via-in-pad for the RPM0026A centre pads (DD-16) remains the remedy for the package-limited SW2, PGND and AGND
   items; it needs a fabrication quote and an owner decision.
2. Supplier stock and prices are partly UNKNOWN; compact BOM descriptions contradict their 0201 MPNs (AUD-MFG-03,
   fix deferred to the next CAD regeneration because it invalidates the DRC/export evidence of both boards).
3. Waveforms, temperatures, efficiency, fault response, the firmware's hold-up timing and its measurement chain are
   unmeasured until Gate G.
4. The averaged simulation model has no switching ripple, saturation or dead time; its inner-loop gain is an
   assumption.
5. Remote `origin` is the public repository https://github.com/djgringoboy2003/Nub44-driver; `main` includes the
   audit work. CI (`.github/workflows/ci.yml`) passes on GitHub (run 40500901442, 2026-10-27): Linux 188 tests pass
   and 19 skip without KiCad, gcc host tests and mutation check pass, fast validation exits 0 with the 3 known items;
   Windows pinned-toolchain target build and mutation check pass.

## Next actions (in order)

**Public collaboration:** choose and add an explicit project license and contribution guidance before inviting
code reuse or changes. Keep the Class 4 laser hazards, DRAFT release status and unmeasured Gate G results clear.

**Active budget implementation track:** read `engineering/budget-2s-design.md` (its "Next implementation steps"
are the ordered list), DD-38 and `manufacturing/budget-2s/ORDERING.md`.
1. **Before any budget order:** review the U1 RHL land and stencil, the Q2 PowerPAK land (FP-POWERPAK), the XT30
   moulded +/− marks against the B+/B− silkscreen, J2's wire-entry side and the flagged PH neck.
2. **BOM (DD-39 sourced every line; DD-40 gave every line an LCSC code):** choose the 10 A mini-blade fuse
   (fuse plus holder at most 10.3 mΩ hot). Confirm live stock of the 0.1 % resistors (RS/Farnell/DigiKey UK, or
   LCSC). If JLCPCB assembles the board, check live LCSC stock and each line's JLCPCB part class, and decide
   through-hole assembly or hand-fitting for J1, J2, J3, J5, F1 and J4.
3. **BUD-ISS-04:** bound the total fault response and energy.
4. **Firmware:** write the budget firmware profile and a budget bench schema.
5. **Quotes:** obtain landed GBP quotes for 3 and 5 boards. Keep unknown prices UNKNOWN.
6. **Bench:** build on a dummy load first. Only MEASURED data can close Gate G.

The owner places any order.

1. **Resolve the pre-order review:** `reports/pre-order-review.md`. Correct or obtain assembler acceptance for
   RS1, U3 and PowerPAK-8S lands; fix AUD-VAL-11/12 and Q1's source link; address R16 and decide R4/Q6. Rebuild
   all affected CAD/export evidence, repeat affected reviews and full validation. Evaluation still has two
   OPEN review records. Review entries are scoped separately from the parked compact board.
2. **Owner quote confirmation:** `reports/bom-quote-sourcing-review.md` questions for PCBWay: ISO currency and
   firm GBP payable total, current exact-MPN consolidated distributor/Coilcraft UK quotes before any purchase,
   L1 exact-MPN reprice, final U1 price, UK delivered costs/X-ray scope, 3 populated + 2 bare quote, and optional
   genuine L1 consignment counts/leader/fees/shipping. Do not buy unverified Choice parts or assume 29 assembly
   survives consignment. Reviews are integrated into `main`; the owner still decides whether and when to order.
3. **Owner decisions** listed above. Any adopted component or footprint change requires regenerated order files and evidence.
4. **Evaluation prototype (owner, by hand):** `documentation/ordering-guide.md` and `documentation/release-checklist.md`
   sections A and B. No tool places orders.
5. **Bench testing:** program firmware and fuses (T0.4), then run `documentation/testing/test-plan.md` with a rated
   dummy load, recording each test with `automation/bench/bench.py`. Watch especially T1.8/T1.9 (hold-up and mode
   change, never tested before), T1.10 (CC polarity), T1.11 (measurement chain), T2.11 (loop, AUD-SIM-04) and nuisance
   fault 6 (R-22).
6. **After evaluation measurements:** assess the host/heatsink interface and optional arming ideas in
   `research/project450-design-notes.md`; retain hardware interlocks. A/B retain their 1S circuit; the separate
   budget 2S track is DD-29/30, with calculations/models implemented but its circuit and CAD not frozen.
7. **Compact board:** with the bench data, choose its direction (`engineering/pcb-review-2026-10-26.md`), then re-run
   the compact chain (`grid_route.py --variant compact-22mm --rebuild --partial --write`; `place`, `route`, `finish`,
   `drc`; `power_layout.py`). Accept it only with 0 unconnected, 0 DRC errors and every power path connected.
8. **Next CAD regeneration:** variant-specific BOM descriptions (AUD-MFG-03); rerun the full chain.

**Commands:**
```powershell
.venv\Scripts\python.exe -m pytest tests -q
.venv\Scripts\python.exe firmware\build.py --mutation
.venv\Scripts\python.exe automation\validation\validate.py            # full; add --mode fast without KiCad
.venv\Scripts\python.exe automation\bench\bench.py check
powershell.exe -NoProfile -ExecutionPolicy Bypass -File scripts\export-pcbway.ps1 -Variant evaluation-board
```

The per-process PowerShell flag is needed on this machine; no system policy was changed.
- After editing any source file, regenerate evidence in the order given in `AGENTS.md`.
- For exact route restoration, follow `hardware/<variant>/routing/README.md`.
- A new `build.ps1` or `build_pcb.py --stage all` run reroutes and may change geometry. Exact post-route
  selectors then need fresh DRC and power-path inspection.
- See `documentation/developer-guide.md` for onboarding, troubleshooting and recovery.

## Log

### 2026-11-07: repository made public

At the owner's direction, changed the GitHub repository visibility to PUBLIC. The owner accepted publication as-is,
including the tracked PCBWay quote workbook, detailed pricing/sourcing reports and existing Git history. No design
or manufacturing files were changed.

### 2026-10-29: LCSC codes for the remaining 21 BOM lines (DD-40)

Owner: look up LCSC codes for the 21 lines without one, for JLCPCB assembly. Each code was read on its LCSC
product page (BUD-29). No stock or price was recorded.

**Codes**
- **Exact parts, 19 lines:** ICs, transistors, Zener diodes, L1, J1, F1, J2, J3/J5, R6/R15/R17 and R16.
- **Found by reading neighbouring codes:** U4 TLV803EA29DBZR (C1852114) and R16 RT0603BRD07133KL (C861111).
  Web search did not show them.
- **Rejected for U4:** C1852118 TLV803EA29**R**DBZR. Its pinout puts RESET on pin 1.
- **LCSC equivalents for R5 and R7:** LCSC does not list ERA-3AEB2742V or TNPW06032K67BEEA. The JLCPCB BOM
  uses Yageo AT0603BRD0727K4L (C855755) and AT0603BRD072K67L (C855783): 0603 thin film, ±0.1 %, ±25 ppm/°C.
  These are labelled in the BOM; a hand-built board uses the UK parts.

**Datasheet findings (LCSC copies)**
- XT30 contact resistance is 1.20 mΩ (BUD-30), not 0.80 mΩ: `connector_contact_ohm_each` changed, and the fuse
  and holder budget falls to 10.312 mΩ.
- The XT30 hole pattern matches the KiCad footprint.
- J2 MX126 is rated UL 300 V / 10 A and IEC 250 V / 15 A (BUD-31). Its J2 description was updated.

**Fixes**
- `qualify.py` counted bullets beyond the "Lines to select" section. The DD-39 report therefore said 21 lines to
  select; there were 0. It is now fixed and tested.
- `export.py` writes the equivalents into `BOM_JLCPCB.csv` and lists LCSC listing names in `ORDERING.md`.

**Results (generated)**
- ERC 0/0; `restore` DRC 0/0/0/0. Geometry matches 61bebf9, apart from J2's description field and three F.Cu
  refills smaller than 0.01 mm².
- Export: 0 lines without an LCSC code, 2 equivalents.
- Qualification: 8 CONDITIONAL, 5 OPEN. Loop model 243/243.
- 275 Python tests pass.

### 2026-10-29: budget BOM sourced, 40 open lines (DD-39)

Owner: "Find 40 open BOM lines for me." Every select-at-order line now has an MPN. Each was checked against a
distributor or manufacturer listing: BUD-27 for pages read directly, BUD-28 for search snapshots.

**Parts chosen**
- **Cheap parts:** LCSC/JLC Basic passives (UNI-ROYAL 0603WAF resistors; Yageo, Samsung and FH capacitors).
- **0.1 % / 25 ppm resistors:** Panasonic ERA-3AEB, Yageo RT…BRD and Vishay TNPW…BEEA, bought in the UK.
  Yageo RT…BRE is ±50 ppm/°C and was rejected.
- **C1:** Chemi-Con EMVL 100 µF 6.3 × 7.7 mm.
- **D2:** SMAJ10CA. Its 17 V clamp is checked against the MCP1703A's +18 V limit, the tightest on the rail.
- **TH1:** NCP18XH103F03RB (B 3380 K).
- **D4:** yellow KT-0805Y; the green part's Vf was too high for the 1 kΩ resistor.
- **SW1:** TL3342F160QG/TR.
- **J4:** BOOMELE 1×3 header.

**Changes**
- R16 134 k → 133 k (`ov_top_ohm`), since 134 k is not E96/E192. 137 k also passes, but protects less.
- New `engineering/design/budget-2s/sourcing.yaml` (order codes plus evidence; no prices or stock), read by
  `export.py`, which adds a UK distributor column and lists the 21 lines without an LCSC code.
- The routing checkpoint now hashes only refs, footprints and pin nets of the connectivity, so the board was
  rebuilt with `--stage restore`, without re-routing.

**Results (generated)**
- ERC 0/0; DRC 0/0/0/0.
- Copper unchanged: 2.836 mΩ hot.
- Export: every BOM line has a sourced MPN; 55 lines / 99 parts.
- BUD-OV-01 margin 0.136 V; loop model 243/243.
- 273 Python tests pass.

### 2026-10-29: budget PCB and prototype manufacturing package (DD-38)

Owner: "Do everything on your own to complete the budget board ready for fabrication." The engineering choices
are Claude Code's (DD-38).

**Board and footprints**
- Board: 90 × 60 mm, four layers, 0.15 mm rules.
- U1 RHL footprint from TI's drawing: 0.3/0.6 mm thermal vias connected solid; corner paste reduced clear of
  the drills.
- L1: stock SRP1245A land. J2: screw-terminal symbol (fixes a parity warning). J1: XT30 pins swapped to KiCad's
  "+" mark.
- Layout: Kelvin pairs, Q2 gate network tied to the VSH pour, solid input-loop return, hand-placed U1
  feedback/compensation cluster, OV divider at U5, LASER_P on three layers.
- Builder: a KiCad 10.0.6 SWIG workaround runs in a budget-only wrapper (`pcb_builder_budget.py`). An
  uncommitted edit to the shared builder was reverted.
- Routing: FreeRouting varies with KiCad's DSN pour order, so the session is archived with `archive` and
  `restore` stages.

**Tools**
- New `automation/budget/layout_review.py` (reuses the A/B DC solver).
- `automation/budget/export.py`: groups BOM lines by spec tokens; through-hole list from masked leads; CPL 0–360.
- `qualify.py`: reads the hash-checked DRC, copper and export evidence; BUD-CAD-01 and BUD-MFG-01 are CONDITIONAL.
- New source BUD-26 (XT30 drawing).

**Results (generated)**
- ERC 0/0; DRC 0/0/0/0 reproduced by `restore`.
- Copper: output 2.836 mΩ hot (3 mΩ allocation); fuse and holder budget 11.1 mΩ.
- Export: OK; BOM 61 lines / 99 parts, 40 to select.
- Loop model 243/243. `qualify.py` exits 1 by design.
- 272 Python tests pass. Full A/B validator exit 0 (57 entries, 2 known; evaluation readiness unchanged).

### 2026-10-29: A/B efficiency target 93 % (DD-37)
- The owner accepted a lower A/B target after the 4.5 A routed-copper estimate (93.56%) fell below 94%. Changed
  `efficiency_target_pct` to 93, the T1.7 bench limit (and its test fixture), REQ-PWR-02, the test plan and the README.
- Chain rerun: calculations 21/21, simulations 12/12, ERC 0/0, DRC evaluation 0/0/0/0 and compact unchanged, layout
  reviews, PCBWay/JLCPCB exports, footprint report, full validator exit 0 (2 known items). Checkpoint revisions appended.

### 2026-10-29: A/B boards moved to 4.5 A (DD-36)
- The owner accepted both 4.5 A deviations (backup margin factor 1.0; reverse-FET limit 0.7 W), now visible as
  parameters. R8 8.66k, R3 24.9k, firmware 4500 mA; simulation criteria read the setpoint from parameters; bench
  criteria moved to 4.275–4.725 A, ≤ 4.95 A peak and a 4.5 A thermal test.
- The PCB finish stage now syncs schematic values/fields onto placed footprints. The archived router sessions were
  restored for both boards: finish + DRC gave evaluation 0/0/0/0, compact unchanged. `source_revisions` appended.
- Chain rerun in AGENTS.md order: calculations 21/21, simulations 12/12 (SIM-12 now passes, VAL-SIM-12 removed from
  the baseline), firmware PASS, ERC 0/0, layout reviews, PCBWay/JLCPCB exports, footprint report, sourcing, full
  validator exit 0 (2 known items).
- Finding: routed-copper efficiency estimate 93.56% < 94% (owner decision 1). Risk R-01 raised for 4.5 A.

### 2026-10-29: budget KiCad schematic started (DD-35)
- Added budget connectivity (104 parts), the separate `budget2s` library (TPS54821, INA300, TLV6700, TLV803E,
  SN74HCS74 single-unit, INA186, and renumbered MOSFET symbols) and a budget schematic builder that reuses the A/B
  layout helpers unchanged. Result: ERC 0 errors / 2 warnings (U1, L1 footprints not generated), netlist exact.
  `qualify.py` BUD-CAD-01 now reports the hash-verified schematic evidence. `reports/budget-2s/schematic.pdf` is a
  plot of it.
- Checks: see the commit message.

### 2026-10-29: budget sourcing directive and part swaps (DD-34); A/B 4.5 A analysis
- Owner asked for: A/B boards at 4.5 A; the budget board built from cheap UK/AliExpress-available parts; KiCad
  started. A/B trial at 4.5 A (sources reverted) found three failed checks: backup ISP/ISN margin, ILIM margin
  (fixed by R_ILIM 24.9k) and reverse-FET dissipation. Two are put to the owner (decision 6).
- Budget: searched availability (BUD-25). Replaced DMP2005UFG-7 with SiSS23DN plus a gate divider and zener clamp,
  and WSK2512 with WSL2512 (BUD-24 downloaded and hashed). The power model now uses the gate divider; the
  interface checks the clamp and gate ratings (37 checks).
- Checks: see the commit message.

### 2026-10-29: budget-2s main setpoint 4.5 A and owner V–I points (DD-33)
- The owner accepted the DD-31/32 targets and set the main target to 4.5 A at 4.72 V (about 7.3 W optical), with
  points at 3.0/3.5/4.0 A. Recorded as owner data OWNER-VI-01 and DD-33 (budget-2s only; A/B unchanged).
- Parameters: `current_a` 4.5, `normal_peak_a` 4.95, `laser_v_typ` 4.72, `laser_vi_points`, backup window
  5.0–5.6 A, divider top 27.4 kΩ, INA300 limit 2.67 kΩ. `qualify.py` now validates setpoint < transient ceiling
  < trip window and the V–I data, reports one-resistor setpoint options (E96) and efficiency at every owner point.
- Flagged the diode-rating risk (above LD-05's 4.2 A / 6.0 W) and the thin efficiency margin at 4.5 A (about 0.05 points).
- Checks: see the commit message.

### 2026-10-29: budget-2s efficiency decision and default-off interface (DD-31 owner decision, DD-32)
- The owner chose DD-31 option (a) without a figure. Set `targets.efficiency_fraction` to 0.93 (proposed by Claude
  Code; owner may change it). BUD-EFF-01 is now CONDITIONAL with about 0.4 points of estimate margin.
  REQ-BUD-07 has been rewritten as an owner deviation and stays OPEN until bench measurement.
- Designed the default-off interface for BUD-ISS-03 (DD-32). nFAULT is the wired-AND fault line and the HCS74
  CLR, with a split pull-up around the external interlock loop and a 47 kΩ pulldown. Series DMG1012T pairs
  N1/N2 (output P-FET gate) and N3/N4 (gate of DMG1013T P1, which sources the EN 10k/10k divider from VCTRL)
  need both ARM_Q and nFAULT. N5 is a firmware-permit inhibit that defaults on. A 15 kΩ VCTRL bleed bounds
  back-power. Rejected options: diode-OR to the fault line (Schottky leakage up to 30 µA; silicon forward drop
  above the driver threshold), AO3400A logic switches (5 µA leakage at 55 °C dominated the fault-line budget)
  and resistive AND networks (not realisable with the required thresholds).
- Added `automation/budget/interface.py` (34 static checks, explicit assumptions, refuses threshold
  extrapolation) and BUD-IF-01. BUD-SAFE-01 now lists only timing/energy/single-fault/self-test work.
  Registered BUD-23 (DMG1013T, existing local copy, hash) and the extra limits used from LEAD-04, BUD-06/18/19/20
  and PREORDER-08.
- Checks: see the commit message.

### 2026-10-29: budget-2s output disconnect, UV backstop and operating-point model (DD-31)
- Claude Code continued from the uncommitted Codex checkpoint. It verified the checkpoint (236 tests pass, both
  budget manifests verify, reports reproducible, fast A/B validator exit 0) and committed it as `2c3786b`.
- Removed the back-to-back output pair: with its source at VBUCK, one P-FET's body diode already blocks
  VBUCK → laser, and the second FET added loss without forward-blocking redundancy. Selected DMP2005UFG-7
  for development. The reverse FET remains DMP2022LSS-13.
- Added `automation/budget/power.py`: an averaged operating point with energy balance (error ~1e-14 W), dropout
  bisection and UV-sense, OVP false-trip and gate-drive checks. FET resistance uses the weakest specified gate
  drive reached, with no interpolation. It uses sourced TPS54821 limits (full-temperature table maxima, 0 ns
  minimum off-time, supply current), labelled efficiency `estimates` and `power_model` allocations that the
  BOM/layout must meet. The converter terms are cross-checked against TI's typical curve (−0.51 points).
- UV divider 147 → 130 kΩ: falling window 5.40–5.62 V against a loaded sense minimum of 5.84 V at 6.0 V input.
  Readiness now computes BUD-PWR-01, BUD-UV-01 and the new BUD-OV-01 as CONDITIONAL. New BUD-EFF-01 is FAIL
  (estimate 93.38% < 94%), and the efficiency target is put to the owner. REQ-BUD-07 is not relaxed.
- Corrected the TPS54821 parameter comments (p.5 limits apply over TJ −40…125 °C). Extended the BUD-01/15/16/19
  source scopes (EN currents typical-only; HCS74 output levels guaranteed only at 20 µA).
- Checks: see the commit message for the full-suite, regenerated-evidence and validator results.

### 2026-10-29: budget-2s electrical qualification and handover checkpoint
- Owner requested implementation towards prototype manufacturing, with Markdown/GitHub kept current for
  another agent, then explicitly requested an immediate progress update. Recorded DD-30 and a separate
  implementation handover/fault matrix; updated AGENTS, README, plan, source index and scoped requirements.
- Added independent numeric candidate sources and variant path resolution without changing A/B defaults.
  Implemented tolerance, backup-trip/NAF, UV/OV, ripple, partial loss and stored-energy/discharge calculations,
  with explicit UNKNOWN inputs, generated JSON/Markdown and source/output hash manifests.
- Added an inspectable ngspice AC circuit and independent analytical transfer equation. Revised the study
  compensation from 330 Ω (19/243 cases fail) to 180 Ω (243/243 meet the assumed margin screen). This does
  not verify switching dynamics, complete component corners, ≤4.4 A transients or physical behaviour.
- Found and recorded BUD-ISS-01…05: efficiency risk, UVLO/input-range conflict, incomplete default-off drive,
  unknown total fault response/energy, and the mitigated preliminary loop issue. Budget qualification stays
  unresolved; no connectivity/PCB/firmware/manufacturing release or order is claimed.
- Added eight locally parsed manufacturer PDFs (BUD-15…22) with revisions, limits, package/pin notes and
  hashes. Download folders remain ignored. The encrypted Microchip PDF used an isolated helper under ignored
  tools, without changing requirements or the project venv. All new part prices/stock remain UNKNOWN.
- Focused verification: 29 new tests passed in 3.10 s. Full-suite and legacy full-validator checkpoint
  results will be recorded before this milestone is committed. Preserve pre-existing `reports/setup.log`.

### 2026-10-28: separate £60 / two-cell budget-driver plan
- Owner requested similar specifications with no size limit, accepted two Li-ion cells in series and gave a
  £60 per-driver target. Recorded planning scope as DD-29; compare 3/5 working units, with explicit driver-only
  cost boundary and all nine new budget requirements OPEN.
- Consolidated original quote/cost-driver findings, UK/genuine versus marketplace sourcing, footprint/audit
  lessons and Project 450 ideas in `engineering/budget-driver-plan.md`. Proposed a 2S synchronous buck,
  precision sensing, independent overcurrent/OVP/interlock and hardware disconnect; new part choices remain
  unadopted. Included feasibility formulas, GBP reference baskets, target spending allocations and six work
  packages through separate physical qualification. Complete delivered/development costs UNKNOWN.
- Downloaded five primary manufacturer PDFs; isolated Python parsing verified revisions and SHA-256. Added
  BUD-01…14 source table with exact links, native GBP observations, VAT/crawl-age/direct-fetch limitations.
  No new marketplace listing qualified; no CAD/design/generated-sourcing edit, review approval or order.
- Verification: 207 pytest tests passed in 31.64 s; full validator exit 0 with 57 entries / 54 PASS / the same
  three known unchanged findings, no new/changed failures and two evaluation blockers. Validator regenerated
  the dashboard. Authored-document link/UTF-8 checks, independent Decimal basket/formula checks, all five new
  PDF hashes and all nine OPEN budget requirement rows checked. Protected A/B design/CAD/manufacturing and
  generated sourcing paths remain unchanged from `f136565`. These checks do not validate a budget circuit.

### 2026-10-28: review work integrated into main at owner request
- Fetched origin and fast-forwarded `main` through review commits `3a6e4c4` and `0faacf8`; no conflicts.
  The pre-order follow-up, original private QUOTE-01 XLS, sourcing report/CSV and GBP/UK follow-up are
  now on `main`. All existing remote branches are ancestors of the integrated review work.
- Updated the current handover and REQ-SRC-01 evidence; unverified delivered offers remain UNKNOWN.
  No component substitution, design/CAD/export change or order. Release remains DRAFT_REVIEW with
  FP-POWERPAK/FP-RS1 open, U3 DFM disposition outstanding and Gate G OPEN.
- Verification on integrated main: 207 pytest tests passed in 22.19 s; full validator exit 0, 57 entries /
  54 PASS / three known unchanged findings, no new/changed failures and two evaluation blockers.
  Independent GBP/quote/quantity checks and all seven baseline/protected-file checks passed.
- Owner then requested inspiration from Loneoceans Project 450. Added a source-backed comparison and
  local page/TI datasheet references: host heat transfer is useful; optional arming/startup ideas need
  defined requirements. Its two-cell buck is not a single-cell straight swap. No new defect or completed
  design review is claimed; all ideas remain proposals.

### 2026-10-28: GBP preference, UK suppliers/eBay and straight-swap investigation
- Owner requested sterling prices and UK/UK-eBay sources. Added FX-01 dated ECB conversion: USD 1 equals
  GBP 0.752582412647...; five-board quote £229.25 only if its UNKNOWN ISO currency is confirmed USD.
- Added native GBP primary-seller price snapshots and quantity-break/MOQ/spare comparisons to the existing
  report and all-30-line CSV; recorded cache age/direct-fetch failures, VAT, stock, dispatch and delivery limits.
  Current offers/complete landed totals UNKNOWN. Coilcraft has a verified UK sales/warehouse route, exact
  L1 stock and GBP delivered offer UNKNOWN. L1 reference £1.97 FX remains the main repricing opportunity.
- Inspected a Hampshire eBay precision-resistor listing (pack/UK postage UNKNOWN) and a Shenzhen MCU listing
  with Unbranded item specifics; neither establishes a better qualified purchase. No marketplace order/cart/login.
- Proposed INA186 A2 DCK packing-only T and TI's identical U1 .A alias; no adoption. XAL5030-102MEC has higher
  DCR/lower thermal-current capability and a higher manufacturer reference price, so is not recommended to save.
- Recommendation remains exact-MPN turnkey reprice, genuine L1-only consignment fallback after a written
  PCBWay parts count/tape/fee quote. Design/CAD/exports/generated sourcing CSVs and release reviews unchanged.
- Verification: 207 pytest tests passed in 17.42 s; full validator exit 0, 57 entries / 54 PASS / the same
  three known unchanged findings, no new/changed failures, two evaluation blockers; Gate G OPEN. Independent
  Decimal checks passed all GBP conversions and spare/MOQ/tier purchases. Seven baseline hashes and all
  protected source/CAD/export/generated-sourcing bytes still match. Dashboard regenerated by validator.

### 2026-10-28: full pre-order follow-up, private quote audit and sourcing options
- Review branch `review/bom-quote-sourcing`, base `10a29cc`. Downloaded the three missing manufacturer diode
  PDFs first; recorded local paths/revisions/SHA-256 in research/source-index.md. No downloaded code executed.
- Re-ran all three brief commands with the full toolchain: pytest 207 pass; firmware six suites/531 checks,
  4134 B flash/59 B RAM and 15/15 mutants; full validation exit 0, 57 entries/54 PASS/3 known unchanged.
  All seven reviewed PCB/connectivity/package hashes still match. Final reruns after documentation/review
  updates: pytest 207 passed in 18.92 s, full validator exit 0 with the same 57 entries/3 known/2 evaluation
  blockers. Quote checker rejects a temporary missing-suffix fixture; all protected sources/exports byte-identical.
- Rechecked local PowerPAK/Ohmite/Microchip documents. Exact RS1/U3 remedies and unresolved 8S acceptance
  recorded; FP-POWERPAK/FP-RS1 stay OPEN. Evaluation orientation local-diode follow-up recorded only for that
  board. New AUD-DOC-05: dashboard omits review board scope; generator unchanged, finding OPEN.
- Parsed QUOTE-01 original XLS with system Python -I and external temporary xlrd 2.0.2 (no requirements change).
  Added reproducible checker/JSON: all 30 lines match, all arithmetic reconciles; 304.615 stored total, ISO
  currency UNKNOWN despite dollar formats. L1 126.790 dominates; request reprice, cause UNKNOWN.
- Added 5/3-board line CSV, cost chart and report: turnkey/fewer assembled/partial consignment/home/genuine
  options, safety roles, explicit spare assumptions and unknown totals. No qualified AliExpress Choice UK
  offers/prices. PCBWay promotion/minimum/attrition conflicts and exact pre-payment questions documented.
- Original private quote committed with this review. Design sources, CAD/export files, generated sourcing
  CSVs and known-limitations baseline unchanged; Gate G OPEN. No order, login, cart or supplier message.

### 2026-10-28: fresh working copy verified with the full toolchain; review sources stored locally
- `scripts/setup.ps1` failed under Windows PowerShell 5.1 (`java -version` writes to stderr, which `2>&1` turns
  into a terminating error under `Stop`). Tool banners are now captured through `Get-NativeOutput`; setup runs
  cleanly under `powershell.exe` as documented.
- Full rerun on `480a69f`: doctor all OK; pytest 207 passed; firmware PASS, 15/15 mutants; `validate.py` exit 0,
  57 entries, 3 known unchanged; evaluation board 2 blockers (FP-POWERPAK, FP-RS1). All seven SHA-256 values in
  `reports/pre-order-review.md` section 9 match the local files.
- Downloaded PREORDER-01, 04, 05, 06, 08 into `research/datasheets/` (git-ignored) and listed every local copy in
  `research/source-index.md`. PREORDER-09/10/11 refused scripted download (HTTP 403); fetch them in a browser.
- No CAD, firmware, threshold or manufacturing file changed; no order placed.

### 2026-10-27: independent pre-order review
- Codex (AI review) compared manufacturer drawings, embedded footprints, assembly PDF, iBOM and centroids.
  Evaluation U1/L1/orientation DONE; PowerPAK and RS1 OPEN. RS1/U3 pad deviations and exact 8S compatibility
  require DFM disposition. Review is bound in prose to the baseline and exact package SHA-256 values.
- Added AUD-VAL-11/12 (missing review IDs and stale approvals), AUD-PCB-06 (land deviations) and AUD-DOC-04
  (Q1 source link). Four issues documented with remedies; no CAD, firmware or release-check code changed.
- Fixed the test review fixture to reset synthetic statuses explicitly; release-check assertions preserved.
- Actual checks: 356/356 Git blobs matched; pytest 188 passed/19 skipped; firmware six suites/531 checks and
  15/15 mutants; fast validator exit 0, three known failures, no new/changed failures. KiCad, ngspice and
  AVR target tools unavailable locally; full saved evidence retained. Gate G remains OPEN.
- PCBWay/JLC common Gerber/drill members identical; all 52 placements agree. Report committed on a review
  branch per the brief. Owner order decision remains pending.

### 2026-10-27: CI verified on GitHub
- First run (40497985197): Windows job passed; Linux pytest failed twice: gcc rejected unused static test functions in
  the `APP_LASER_NTC_REQUIRED` host build (TinyCC does not warn), and the footprint report needed KiCad. Fixed in
  4f608a9; second run (40500901442) passed both jobs.

### 2026-10-27: ordering files for PCBWay and JLCPCB; pre-order review pack; merged and pushed
- `documentation/ordering-guide.md`: files, layer order and order-form options for both fabs; assembly options.
- `automation/export/export_jlcpcb.py`: JLCPCB files derived from the checked PCBWay package (flat Gerber ZIP with
  identical bytes, JLC BOM with 9 of 29 part numbers recorded, JLC CPL); refuses incomplete boards; validator entry
  VAL-JLC-<variant> fails if the PCBWay package changes afterwards.
- PCBWay BOM fixed to one line per orderable part (30 lines; was 48), AUD-MFG-05; both packages re-exported.
- `automation/review/footprint_report.py` -> `reports/footprint-review.md` (pad tables incl. custom-pad outlines,
  nets, pin names, placement); `documentation/pre-order-review.md` brief for Codex.
- 207 Python tests pass; validator exit 0 (3 known items); firmware PASS. Merged into `main` and pushed. No order.

### 2026-10-26: audit follow-up: sourcing checks, bench framework, dashboard, CI, documentation (same branch)
- `sourcing/check_sourcing.py` (0 FAIL, 29 WARN; new finding AUD-SRC-04 on R16); `automation/bench/bench.py` with
  `documentation/testing/bench-tests.yaml` (MEASURED records only; Gate G NO DATA); `reports/dashboard/index.html`;
  `.github/workflows/ci.yml` (not yet run on GitHub); hash-bound schematic evidence.
- Documentation: developer guide, release checklist, PCB review (`engineering/pcb-review-2026-10-26.md`), README,
  AGENTS.md (map, regeneration order, pitfalls incl. the heredoc backslash hazard), requirements, assembly, test plan.
- 202 Python tests pass; validator exit 0 (3 known items); firmware PASS with 15/15 mutants. No order, no push.

### 2026-10-26: independent audit, firmware fixes, evidence binding and release levels (branch `audit/comprehensive-improvements`)
- **Audit:** `reports/comprehensive-project-audit.md` (single issue register), `engineering/risk-register.md`,
  `engineering/improvement-roadmap.md`, `engineering/implementation-log.md` (details and actual test results).
- **Firmware (DD-28):** board-NTC failure no longer disables thermal protection; watchdog cleared only after a full
  cycle; watchdog resets latch a fault; ratiometric measurements (the 2.5 V reference was used below its VDD
  minimum); the AC2 power-loss reference was in the wrong register (`VREF.CTRLD`), so the click mode change could
  not work; debounce, re-check of the start voltage, output-while-off detection, hold-up race fixes, fuse check.
  HAL split with host tests: 531 checks, 15/15 mutants caught; ATtiny1616 build 4134 B.
- **Evidence:** calculation and simulation results are hash-bound to their inputs and tool versions; SIM-11 is now
  a frequency-response analysis; SIM-12 sensitivity sweep found GM 9.5 dB at combined tolerances (AUD-SIM-04, owner
  decision pending).
- **Validation and release:** known-limitations baseline (exit 0 unless a failure is new or changed), modes,
  per-board readiness (both boards DRAFT_REVIEW), incomplete-board marker in the compact fabrication ZIP.
- No hardware, threshold or setpoint change; no order placed; nothing pushed.

### 2026-10-26: repository pushed to GitHub
- Added remote `origin` (private repository djgringoboy2003/Nub44-driver) and pushed all 16 commits of `main`.
  The remote matches the local branch.

### 2026-10-26: documentation audit
- **Current state:** status and next actions rewritten so they describe only the present. Superseded blocks
  and the duplicated polarity text were removed (the log keeps the history).
- **Stale statements corrected:**
  - Owner decisions now recorded everywhere they are discussed, including efficiency (DD-26).
  - Evaluation-first status recorded.
  - Compact routing options updated to match the simulation results.
  - DD-07 corrected: MCU supply diode RB521S30, CS_OUT on ADC0 AIN6, IND as plain GPIO.
  - Render and requirement notes updated.
- **Routing checkpoints:** the manifests again keep their capture-time hashes, with later changes as
  `source_revisions` entries (newest last). A re-capture had overwritten the capture block.
- **New decision:** DD-27 (evaluation board first).

### 2026-10-25: owner decisions recorded
- **Owner choices:** evaluation board first (compact parked as a routing draft); efficiency deviation
  accepted (REQ-PWR-02 ≥ 94 %, DD-26); 4.0 A kept (DD-13).
- **Changes:**
  - `parameters.yaml` gains `current.efficiency_target_pct`, which the calculation reads; the efficiency
    check now passes (94.59 %).
  - REQ-OUT-01 is VERIFIED-SIM and REQ-PWR-02 is VERIFIED-CALC.
  - The T1.7 target was updated.
- **Evidence regenerated:**
  - ERC 0/0 on both schematics.
  - DRC: compact 0/3/20/0, evaluation 0/0/0/0.
  - Layout reviews, exports and checkpoint manifests regenerated.
  - Validation: the 2 remaining failures are compact routing and DRC. No order placed.

### 2026-10-25: compact routing options simulated
- **Router:** `grid_route.py` accepts optional per-layer rules (`layer_rules`: clearance, maximum width).
  The default behaviour is unchanged; the compact checkpoint was captured at 90f09b8.
- **Simulation on a copy of the placed copper:**
  - Moving U3's and C3's ground fanout vias removes the two unreachable MCU pins.
  - An MCU pin swap and 0.10/0.13 mm inner lines, alone or together, still leave about 19 nets clashing.
  - The table is in `engineering/compact-feasibility.md`. The board lacks routing capacity, not a better
    net order.

### 2026-10-25: compact board grid-routed to 20 open items
- **Grid router:**
  - `grid_route.py`: A* on a 0.05 mm grid over F/In2/B with through vias, against the exact placed copper.
  - Negotiates congestion between nets (PathFinder) and finishes with an exact segment clearance check.
  - `--partial` keeps the conflict-free nets; the generated `grid_routes` section is applied after the
    via fields.
  - Five tests.
- **Compact layout:**
  - No In2 VBAT pour; the F VBAT pour now covers every field via.
  - The MCU moved and rotated, with a part-free escape ring on both sides. Q6/D3/R20 sit by Q4/Q5.
  - C12 moved and U1's PGND has a plane via.
  - `place_opt` charges for nets that change side.
  - Router keep-outs are cut back around other nets' vias, and GND fanout vias stay out of other pours.
- **Result:**
  - DRC 0 errors / 3 warnings / 20 unconnected (was 0/6/31).
  - VOUT 1.46 mΩ, LD_P 0.47 mΩ.
  - Copper loss above the model +44 mW; ground-offset shift +0.75 %.
- **Schematic:** field placement for R/L/thermistor symbols fixed; both schematics regenerated (ERC 0/0).
- **Evidence:**
  - Evaluation DRC 0/0/0/0; both layout reviews and DRAFT exports PASS.
  - Compact routing checkpoint archived and evaluation manifest re-captured.
  - Validation: 147 tests, the same 3 known failures. No order placed.

### 2026-10-25: battery polarity decided and marked on the boards
- **Owner decision:** polarity does not matter provided the board marks it. The definition stays centre spring = B+,
  ring = B− (DD-12); REQ-BAT-04 is DESIGNED (was BLOCKED).
- **Silkscreen:**
  - compact: new `texts:` "B+" beside the spring pad and "B-" beside the ring (bottom), plus "B-" on top;
  - evaluation: label strokes raised from 0.12 mm to PCBWay's legend minimum (MFG-01).
  - Both were applied by finish on the archived router sessions, so no copper changed. Checkpoint
    manifests were re-captured.
- **Pipeline:**
  - `add_texts` now replaces board labels, so a changed stroke takes effect.
  - Router keep-outs take a `net` and are cut back around vias of other routed nets. A via inside a
    keep-out was an unfixable router violation.
- **Docs:** schematic title block, assembly instructions, stack-up note, export README text, AGENTS.md rule 4
  and the test plan (T3.3) updated.
- **Evidence:**
  - ERC 0/0 on both schematics.
  - DRC: evaluation 0/0/0/0; compact 0/6/31/0 (unchanged).
  - Both layout reviews and both DRAFT exports PASS.
  - Validation: 142 tests. Evaluation Gate F is PASS; the 3 known failures remain (efficiency, compact
    routing/DRC). No order placed.

### 2026-10-25: compact re-floorplan around the spring-pad via keep-out
- **Placement (DD-24):**
  - L1 now covers the spring pad and U1 sits 2 mm below, with source escapes for every pin: non-crossing
    BOOT1/SW1 lanes, BOOT2 over C7, VCC 0.6 mm to C7.
  - J3 uses 3.5 mm pads on the compact variant only.
  - Q1 sits under Q2 with an 8-via VBAT field, and Q3 moved right for the SW1 vias.
  - The MCU moved to the bottom lower left.
- **Pipeline:**
  - Source vias are reserved on both sides during automatic placement.
  - `router_keepouts` add rule areas that keep the autorouter off the power pours; finish deletes them.
  - `place_opt.py` is a new simulated-annealing small-part placer.
  - Six tests cover keep-outs, via reservation and the optimiser.
- **Result:**
  - Compact KiCad DRC is 0 errors, 6 warnings, 31 unconnected (was 0/3/43). Every power path is connected
    (VBAT 0.50 mΩ, VOUT 1.69 mΩ).
  - The PGND link remains weak: the review shows a +1.14 % worst-case setpoint shift.
  - A finish-stage GND via fix collided with routed copper and was reverted.
- **Evidence:**
  - Routing checkpoint archived.
  - Both schematics ERC 0/0; evaluation DRC 0/0/0/0.
  - Both layout reviews and both DRAFT exports PASS.
  - Validation: 137 tests; the same 3 known failures. No order placed.

### 2026-10-25: power-layout review from the routed copper
- New `automation/review/`:
  - KiCad-side copper extractor;
  - exact scanline raster model (Pillow's fill widened every shape by a cell);
  - DC current-flow solver checked against analytic cases (strip, parallel layers, barrel formula, necks,
    open paths);
  - review report covering power paths, ground offsets and setpoint error, hot loops, gate/boot/VCC loops,
    Kelvin pair, sensitive-net spacing and vias near power pins.
- The validator adds `VAL-LAYOUT-<variant>`, a freshness check only. Findings are dispositioned in
  `engineering/layout-review.md` (DD-23).
- Evaluation board:
  - Found a 0.55 mm SW1 junction carrying the whole inductor current, plus VOUT and LD_P necks.
  - Corrected the pours in source and re-applied them to the archived session; DRC still 0/0/0/0.
  - SW1 1.91 → 0.98 mΩ, VOUT 3.01 → 2.27 mΩ, LD_P 1.28 → 0.88 mΩ; copper loss above the model fell from
    142 to 96 mW.
- Documented with bench checks T2.9–T2.12:
  - package-limited items (DD-16: SW2 entry, AGND/PGND +0.28 % DC setpoint shift);
  - buck-leg drive loops;
  - VCC through In2;
  - the U1 ISP/ISN branch.
- Compact draft review recorded its gaps: open VOUT path, single-via VBAT transition, isolated U1 pin 15,
  FSW/COMP_RC 0.15 mm from switching copper.
- Root cause for the compact draft: 23 of U1's 26 pads lie inside the spring-pad via keep-out. The
  placement options are recorded in `engineering/compact-feasibility.md`; the compact CAD is unchanged.
- Copper allowances of the loss model moved to `parameters.yaml`. The loss dict merge is now sorted, so
  `power-stage-results.json` is identical across hash seeds; values are unchanged.
- Regenerated the evidence:
  - schematics: ERC 0/0, netlists exact;
  - both DRCs: evaluation 0/0/0/0, compact 0/3/43/0;
  - both layout reviews;
  - both DRAFT exports: PASS.
- Validation: 131 tests pass; 3 known failures (efficiency, compact routing/DRC). No order placed.

### 2026-10-24: completed evaluation CAD, hardened evidence and generated review packages
- Evaluation board: all 68 footprints placed, all nets connected, repeated KiCad DRC 0/0/0/0. Explicit
  MCU/PG/ground escapes and source-defined BOOT1/SW2/ILIM corrections resolve the trapped connections.
- Compact board: corrected bottom transforms, copper-only fanout, ring edge margin and capacitor spacing;
  final DRC 0 errors / 3 connection-width warnings / 43 unconnected / 0 parity. The current compact placement
  remains a routing draft; no feasibility or production claim was inferred from zero geometric errors.
- Native project symbol derivatives keep verified custom footprint filters compatible with clean ERC.
- Router minimum-width and ground-layer settings are explicit. Repeated finish is idempotent; native
  deletions fix KiCad SWIG ownership failures, and project settings are preserved with atomic writes.
- Tool failures, malformed/stale reports, source races, omissions and incomplete routes cannot pass the gate
  computation. DRC/export evidence binds placement, connectivity, parameters and actual CAD bytes. Export
  artifacts are independently checked and hashed; Git preserves those exact bytes.
- Both DRAFT PCBWay packages internally pass; all PDFs/images and signed centroid data checked. Rendering
  has no component-body/height verification. Stack-up/assembly notes and a safer unspecified rated dummy-load
  selection replace the unsupported example in the earlier bench plan.
- Toolchain doctor passes; 120 Python tests pass; firmware 26/26 checks and target build pass. Global validation
  truthfully exits 1 for the efficiency target plus compact routing/DRC; battery polarity remains BLOCKED.
- Exact router checkpoints archived; safe review packaging excludes tools, downloads, caches and failed
  staging directories and records file hashes plus actual gate states. Actual DRAFT bundle smoke test: 249
  members, no missing review files, valid ZIP CRC and per-file hashes. No order or manufacturing release.

### 2026-10-24: recovered Claude routing checkpoint and audited handoff
- Preserved unfinished `floorplan.py`, geometry export, compact PCB, project rules and latest DRC report.
- Actual checkpoint: 65 placed footprints, 33 unconnected items, 91 DRC errors (50 undersized tracks, 40 ring edge violations, one courtyard overlap), 44 warnings and six Datasheet field mismatches.
- Existing Python tests: 11 passed. The previous entry-script/export milestone had not updated this handoff or the requirement register.
- Validation audit found that Gate E omitted routing/ERC and Gate F could consequently pass an unrouted board. Fixing the evidence and release dependencies is active work; no release is approved.
- No Git remote is configured; commits are local until a destination is supplied.

### 2026-10-24 (evening): library, schematic, simulation, firmware, PCB pipeline
- **Library:**
  - TPS552882 footprint from calibrated PDF vector extraction.
  - 1206 Kelvin shunt footprint with net tie.
  - Segmented ring contact.
  - Spring and test pads.
  - Symbols from verified pin tables; PowerPAK MOSFET symbols renumbered to the footprint pads.
- **Schematics:** generated for both variants. ERC 0/0 and netlists equal the spec. Per-variant footprints and
  MPNs: Variant A uses 0201 parts and fewer test pads (DD-17).
- **Simulation:** cycle-averaged behavioural model in ngspice 47. 11 tests PASS after fixing a model bug (the INA186
  output impedance) and unrealistic test stimuli.
- **Firmware:** ATtiny1616, avr-gcc 15.2.0 build, TinyCC host unit tests.
- **PCB pipeline:** pcbnew API placement with an automatic small-part placer, automatic via fields (no via-in-pad)
  and GND fanout, DSN → FreeRouting (jar) → SES, pours, DRC with schematic parity, dangling-via cleanup.
- **Lessons recorded in the code:**
  - `SaveBoard()` overwrites `.kicad_pro` rules, and `LoadBoard()` does not resolve net classes; both are
    re-applied through the API.
  - Annular custom pads break Specctra export, so the ring is segmented.
  - Pad bounding boxes mislead hit tests for the ring; use real shapes (`pad.HitTest`).

### 2026-10-24: research, architecture, calculations (commit 862e82d)
- Workspace was empty and not a git repo; initialised `main`. The previous design files named in the brief are not
  on this machine. The concept was audited from the brief (`engineering/previous-design-audit.md`); every proposed
  part fails a datasheet limit.
- Machine: Windows 10 Pro 22H2 x64, i5-7300U, 16 GB RAM. Non-admin account, so all tools are per-user or project-local.
- Installed:
  - KiCad 10.0.6 (winget, user scope)
  - ngspice 47
  - Temurin JRE 25.0.4.1 + FreeRouting 2.5.0 jar (the native CLI crashes)
  - InteractiveHtmlBom 2.12.0
  - Python venv
- Verified:
  - Schematic writer: KiCad ERC and netlist export agree with intended connectivity at all four rotations.
  - pcbnew → DSN → FreeRouting → SES → KiCad DRC round trip: 0 violations, 0 unconnected.
- Five parallel research tasks (laser, converters, components, batteries/mechanics, PCBWay/CAD) hit the account
  usage limit once. They were resumed with bounded budgets and completed.
- Architecture A (TPS552882) selected over a TPS61288 boost with clamp, the TPS552892, and the XL6009.
