djgringoboy2003/Nub44-driver/research/sources/battery-sources.md

# Battery and Mechanics: Source Index

**Report:** `research/battery-and-mechanics.md`. All items were retrieved on **2026-10-24**.

**Primary / Secondary:**

- **Primary:** a manufacturer document or web page. Several are distributor-hosted copies, as noted.
- **Secondary:** an independent tester (Battery Mooch, HKJ / lygte-info.dk), a reference work, or a forum.
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
