djgringoboy2003/Nub44-driver/reports/layout-review/compact-22mm/flow-BAT_SPRING.png

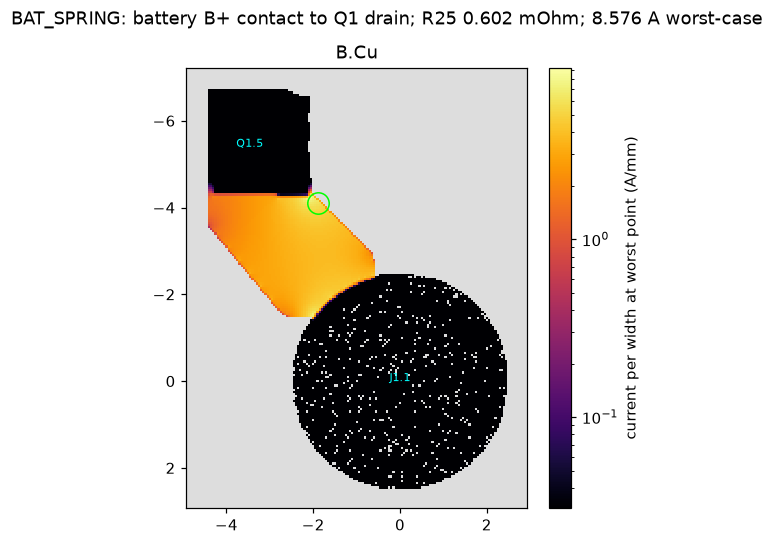
reports/layout-review/compact-22mm/flow-BAT_SPRING.png
