djgringoboy2003/Nub44-driver/reports/layout-review/compact-22mm/flow-LD_P.png

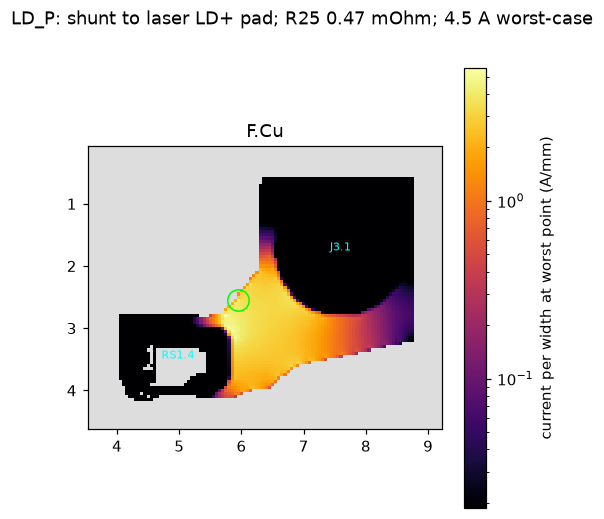
reports/layout-review/compact-22mm/flow-LD_P.png
