djgringoboy2003/Nub44-driver/reports/layout-review/compact-22mm/flow-SW1.png

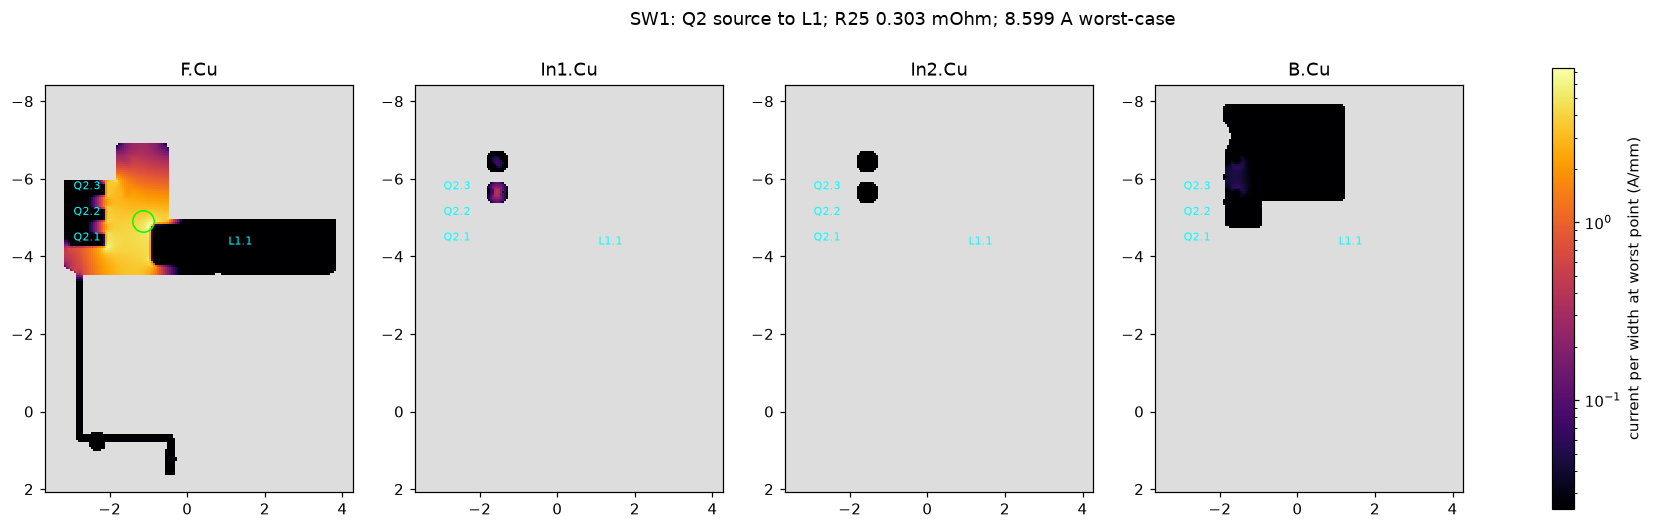
reports/layout-review/compact-22mm/flow-SW1.png
