djgringoboy2003/Nub44-driver/reports/layout-review/compact-22mm/flow-VBAT.png

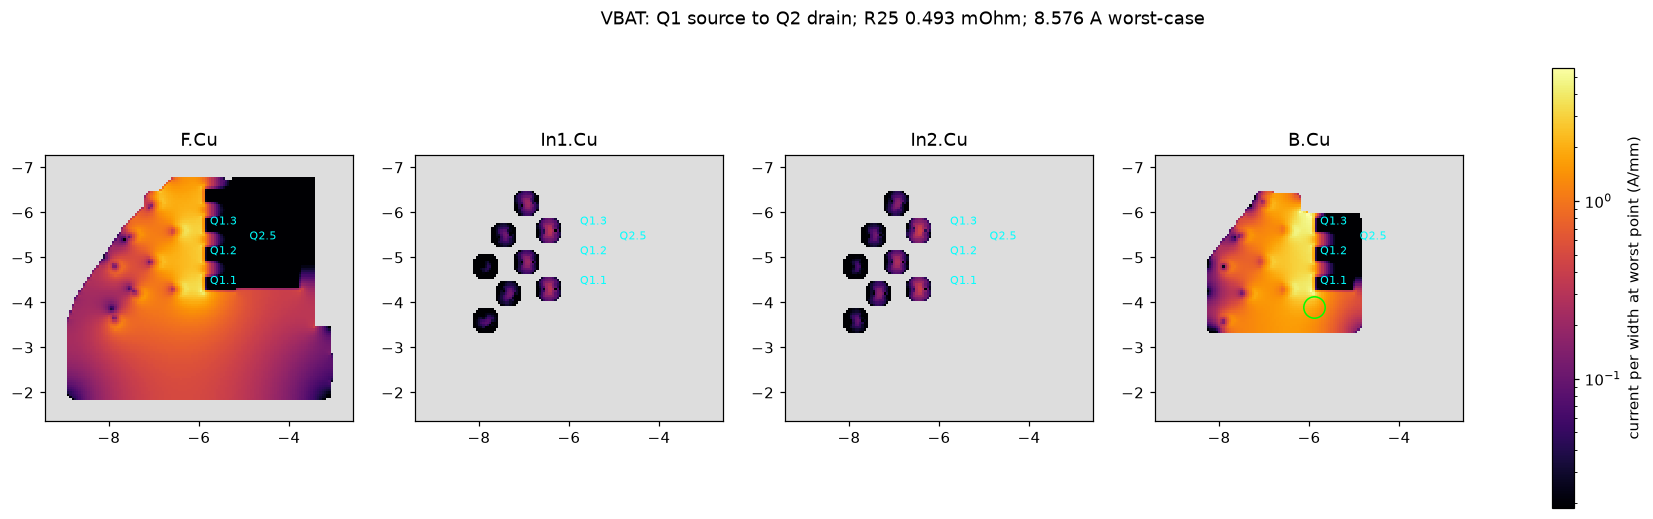
reports/layout-review/compact-22mm/flow-VBAT.png
