djgringoboy2003/Nub44-driver/reports/layout-review/compact-22mm/ground-potential.png

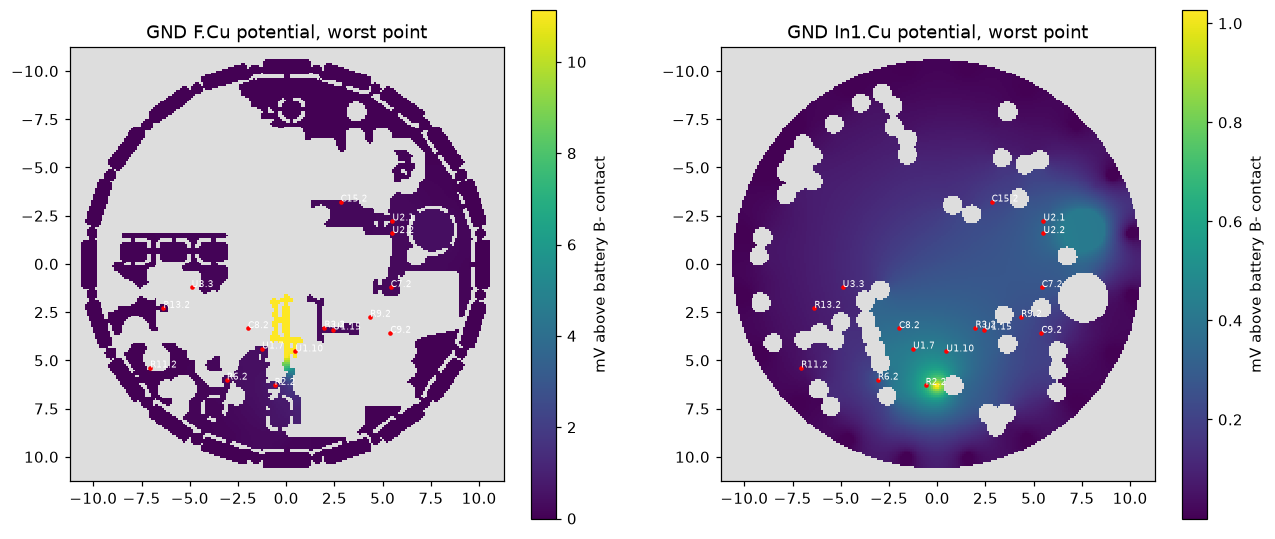
reports/layout-review/compact-22mm/ground-potential.png
