djgringoboy2003/Nub44-driver/reports/layout-review/compact-22mm/nets-B_Cu.png

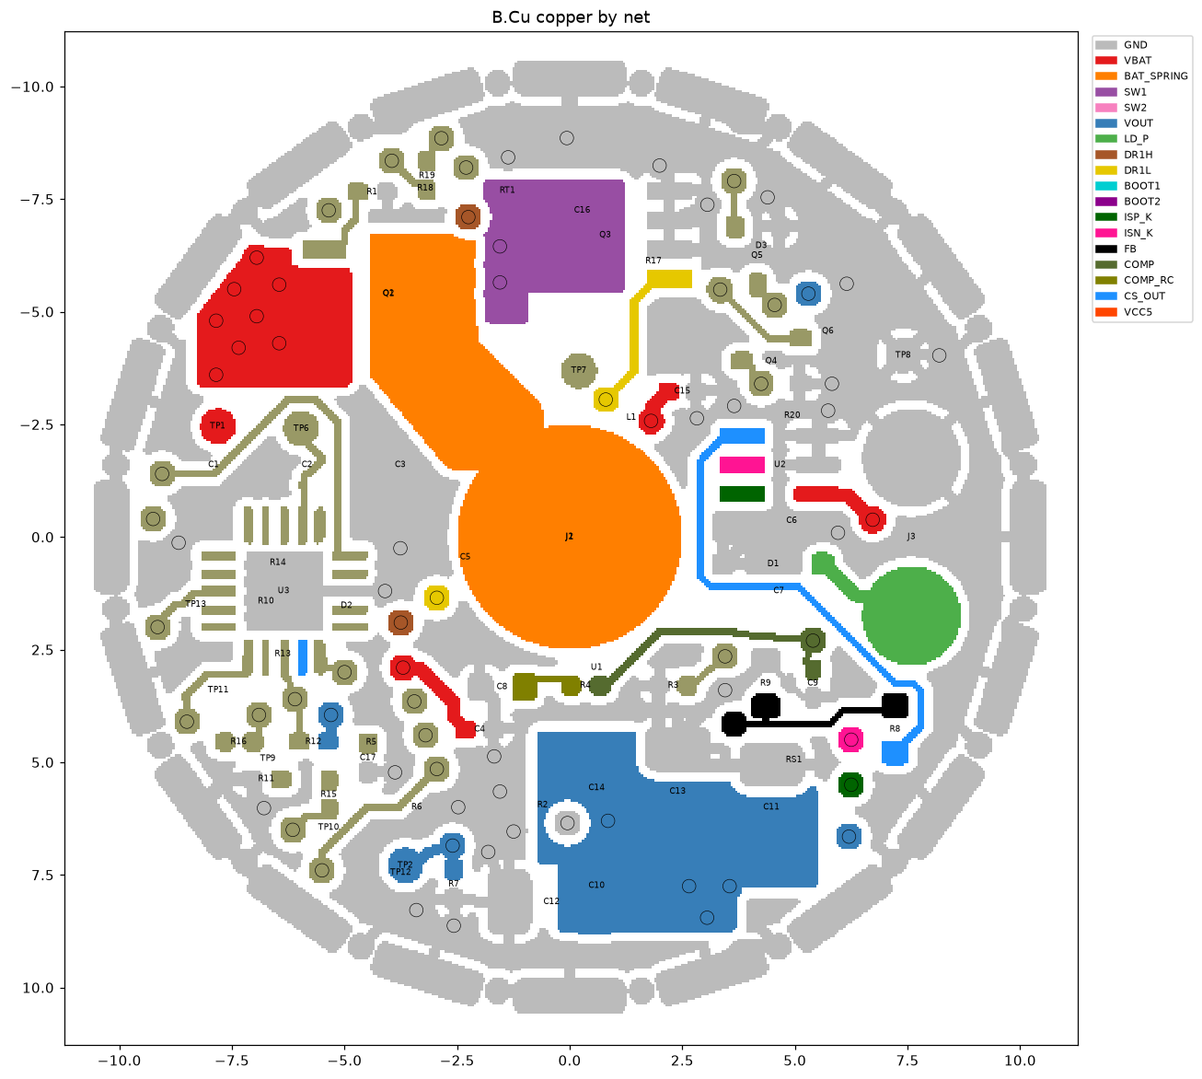
reports/layout-review/compact-22mm/nets-B_Cu.png
