djgringoboy2003/Nub44-driver/reports/layout-review/compact-22mm/nets-F_Cu.png

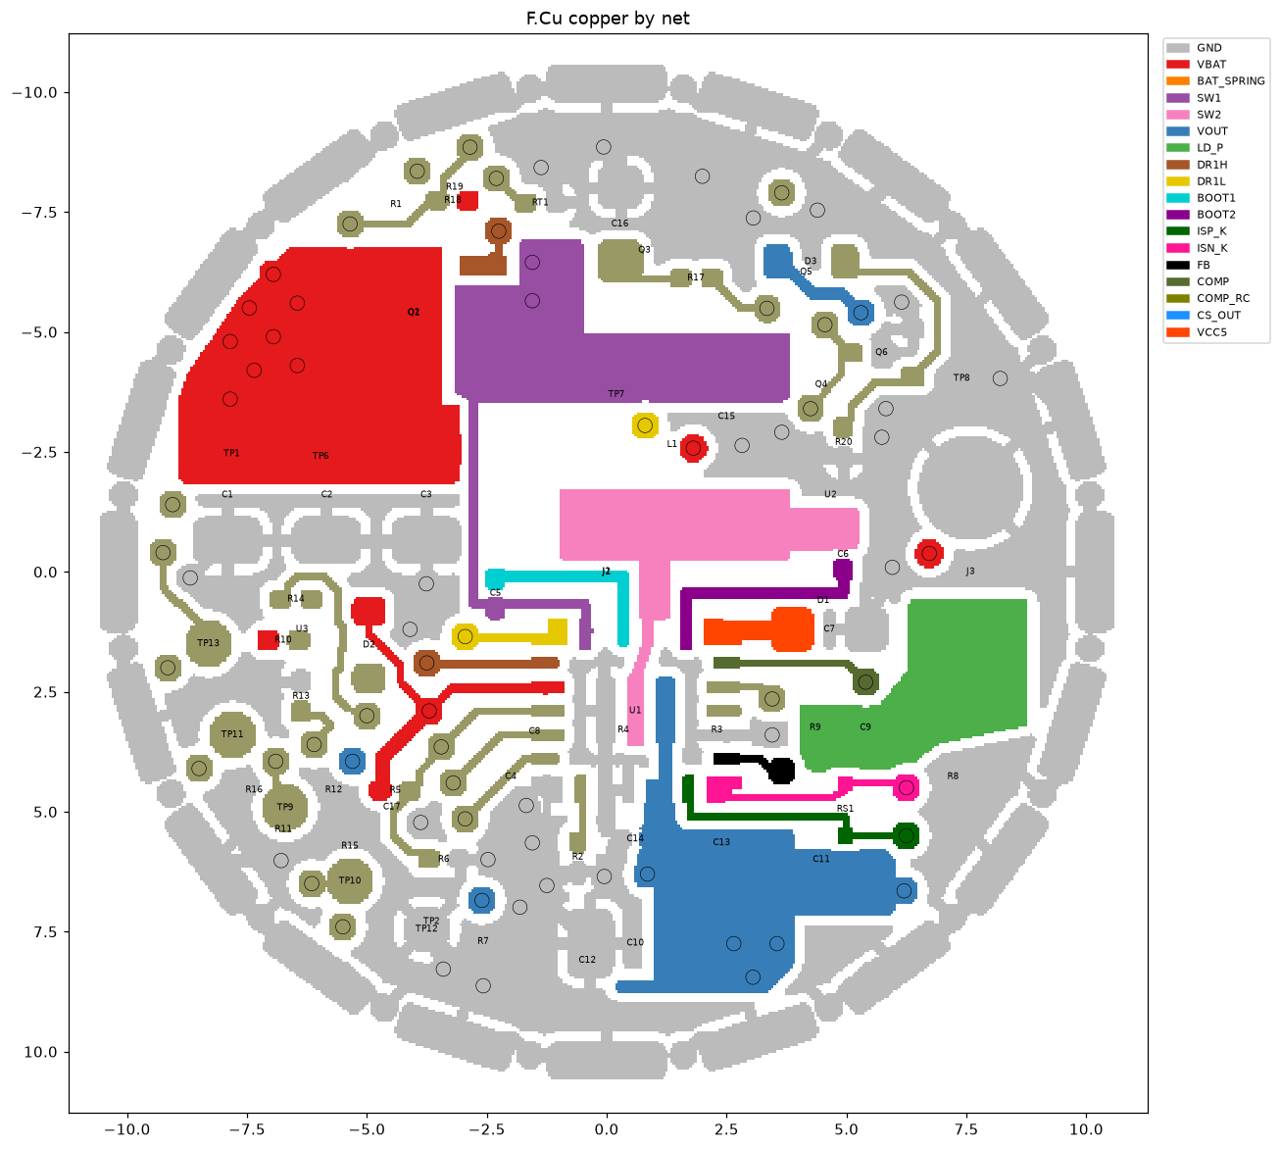
reports/layout-review/compact-22mm/nets-F_Cu.png
