djgringoboy2003/Nub44-driver/reports/layout-review/compact-22mm/nets-In1_Cu.png

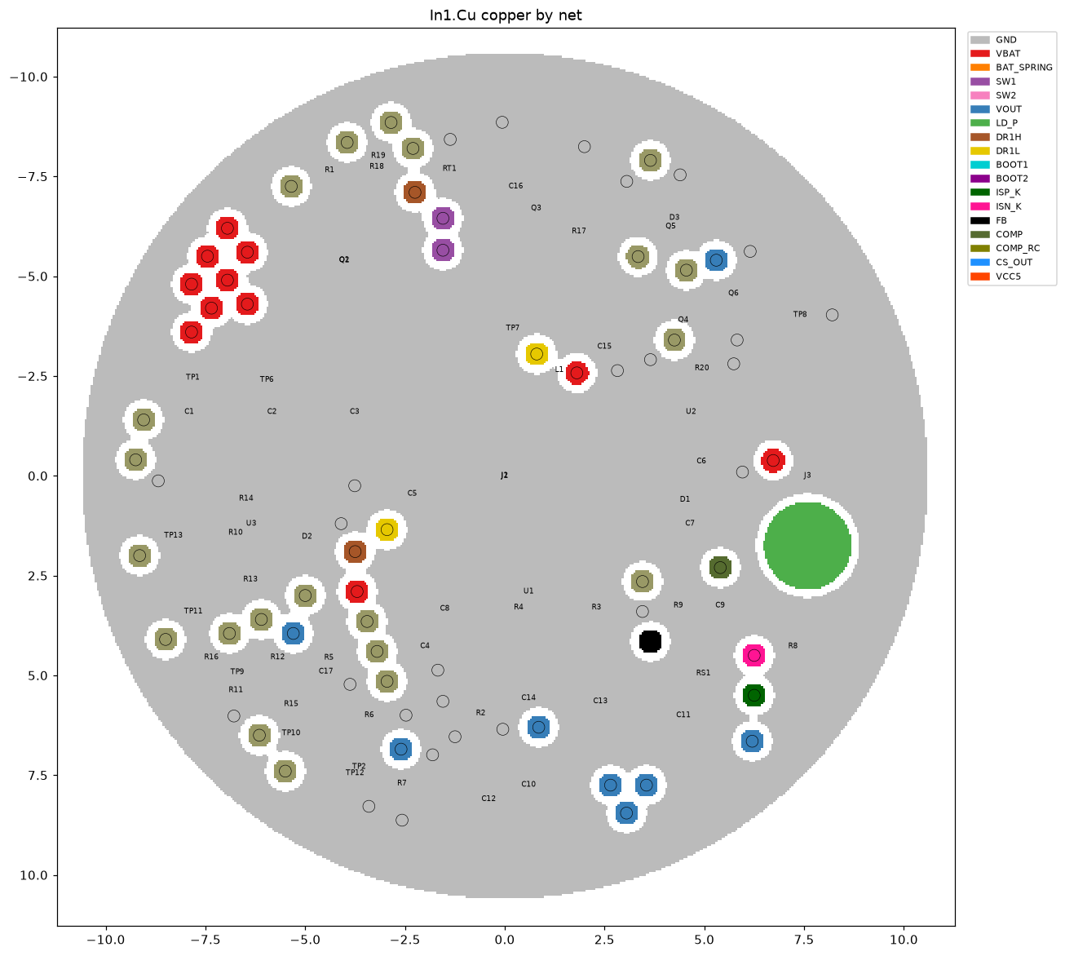
reports/layout-review/compact-22mm/nets-In1_Cu.png
