djgringoboy2003/Nub44-driver/sourcing/sourcing-check.md

# Sourcing check

Generated by `sourcing/check_sourcing.py` on 2026-10-29: **PASS** (0 FAIL, 29 WARN, 72 INFO). Ratings and decode tables must be confirmed against each datasheet; stock and prices are not verified.

| Variant | BOM lines | Priced lines | Known subtotal (USD, not a quote) |
|---|---|---|---|
| compact-22mm | 30 | 6 | 5.14 |
| evaluation-board | 30 | 8 | 5.18 |

## WARN

| Part | Check | Detail |
|---|---|---|
| compact-22mm:R1 | description | description says 0402 but RC0201FR-07100KL is 0201 (AUD-MFG-03) |
| compact-22mm:C4 | description | description says 0402 but GRM033R61A104KE15D is 0201 (AUD-MFG-03) |
| compact-22mm:C4 | description | description says 16 V but GRM033R61A104KE15D is rated 10 V |
| compact-22mm:C4 | description | description says X7R but GRM033R61A104KE15D is X5R |
| compact-22mm:C5 | description | description says 0402 but GRM033R61A104KE15D is 0201 (AUD-MFG-03) |
| compact-22mm:C5 | description | description says 16 V but GRM033R61A104KE15D is rated 10 V |
| compact-22mm:C5 | description | description says X7R but GRM033R61A104KE15D is X5R |
| compact-22mm:C6 | description | description says 0402 but GRM033R61A104KE15D is 0201 (AUD-MFG-03) |
| compact-22mm:C6 | description | description says 16 V but GRM033R61A104KE15D is rated 10 V |
| compact-22mm:C6 | description | description says X7R but GRM033R61A104KE15D is X5R |
| compact-22mm:R2 | description | description says 0402 but RC0201FR-0733K2L is 0201 (AUD-MFG-03) |
| compact-22mm:R3 | description | description says 0402 but RC0201FR-0724K9L is 0201 (AUD-MFG-03) |
| compact-22mm:R4 | description | description says 0402 but RC0201FR-071K2L is 0201 (AUD-MFG-03) |
| compact-22mm:C9 | description | description says 0402 but GRM0335C1H681JA01D is 0201 (AUD-MFG-03) |
| compact-22mm:R5 | description | description says 0402 but RC0201FR-0749K9L is 0201 (AUD-MFG-03) |
| compact-22mm:R6 | description | description says 0402 but RC0201FR-0733K2L is 0201 (AUD-MFG-03) |
| compact-22mm:C14 | description | description says 0402 but GRM033R61A104KE15D is 0201 (AUD-MFG-03) |
| compact-22mm:C14 | description | description says 16 V but GRM033R61A104KE15D is rated 10 V |
| compact-22mm:C14 | description | description says X7R but GRM033R61A104KE15D is X5R |
| compact-22mm:C14 | capacitor voltage | 10 V rating < 1.5 x 7.30 V (max diode corner; Zener backstop 7.3 V (DD-05)); check DC-bias capacitance |
| compact-22mm:R7 | description | description says 0402 but RC0201FR-074K7L is 0201 (AUD-MFG-03) |
| compact-22mm:C15 | description | description says 0402 but GRM033R61A104KE15D is 0201 (AUD-MFG-03) |
| compact-22mm:C15 | description | description says 16 V but GRM033R61A104KE15D is rated 10 V |
| compact-22mm:C15 | description | description says X7R but GRM033R61A104KE15D is X5R |
| compact-22mm:C17 | description | description says 0402 but GRM033R61A104KE15D is 0201 (AUD-MFG-03) |
| compact-22mm:C17 | description | description says 16 V but GRM033R61A104KE15D is rated 10 V |
| compact-22mm:C17 | description | description says X7R but GRM033R61A104KE15D is X5R |
| compact-22mm:R16 | resistor power | 80.2 mW in a single fault (series IND_OUT-IND_PAD; fault: one side shorted to GND) > 50 mW rating |
| evaluation-board:R16 | resistor power | 80.2 mW in a single fault (series IND_OUT-IND_PAD; fault: one side shorted to GND) > 62.5 mW rating |

## INFO

| Part | Check | Detail |
|---|---|---|
| compact-22mm:J1 | mpn | no MPN (hand-fitted or PCB feature) |
| compact-22mm:R1,R10,R11,R12,R17,R18 | supplier data | RC0201FR-07100KL: stock or price UNKNOWN; confirm at order time |
| compact-22mm:C1,C2,C3,C10,C11,C12,C13 | datasheet | CL21A226MOQNNNE: no datasheet URL in connectivity.yaml |
| compact-22mm:C4,C5,C6,C14,C15,C17 | supplier data | GRM033R61A104KE15D: stock or price UNKNOWN; confirm at order time |
| compact-22mm:C4,C5,C6,C14,C15,C17 | datasheet | GRM033R61A104KE15D: no datasheet URL in connectivity.yaml |
| compact-22mm:U1 | supplier data | TPS552882RPMR: stock or price UNKNOWN; confirm at order time |
| compact-22mm:Q2,Q3 | supplier data | SISS80DN-T1-GE3: stock or price UNKNOWN; confirm at order time |
| compact-22mm:L1 | supplier data | XGL5030-102MEC: stock or price UNKNOWN; confirm at order time |
| compact-22mm:L1 | datasheet | XGL5030-102MEC: no datasheet URL in connectivity.yaml |
| compact-22mm:C7,C16 | supplier data | CL10A106KP8NNNC: stock or price UNKNOWN; confirm at order time |
| compact-22mm:C7,C16 | datasheet | CL10A106KP8NNNC: no datasheet URL in connectivity.yaml |
| compact-22mm:R2,R6 | supplier data | RC0201FR-0733K2L: stock or price UNKNOWN; confirm at order time |
| compact-22mm:R3 | supplier data | RC0201FR-0724K9L: stock or price UNKNOWN; confirm at order time |
| compact-22mm:R4 | supplier data | RC0201FR-071K2L: stock or price UNKNOWN; confirm at order time |
| compact-22mm:C8 | supplier data | CL05B563KO5NNNC: stock or price UNKNOWN; confirm at order time |
| compact-22mm:C8 | datasheet | CL05B563KO5NNNC: no datasheet URL in connectivity.yaml |
| compact-22mm:C9 | supplier data | GRM0335C1H681JA01D: stock or price UNKNOWN; confirm at order time |
| compact-22mm:C9 | datasheet | GRM0335C1H681JA01D: no datasheet URL in connectivity.yaml |
| compact-22mm:R5 | supplier data | RC0201FR-0749K9L: stock or price UNKNOWN; confirm at order time |
| compact-22mm:R7,R20 | supplier data | RC0201FR-074K7L: stock or price UNKNOWN; confirm at order time |
| compact-22mm:RS1 | supplier data | MCS1632R010FER: stock or price UNKNOWN; confirm at order time |
| compact-22mm:RS1 | datasheet | MCS1632R010FER: no datasheet URL in connectivity.yaml |
| compact-22mm:R8 | supplier data | RT0402BRD078K66L: stock or price UNKNOWN; confirm at order time |
| compact-22mm:R9 | supplier data | RT0402BRD0710KL: stock or price UNKNOWN; confirm at order time |
| compact-22mm:D1 | datasheet | PMEG4010CEJ,115: no datasheet URL in connectivity.yaml |
| compact-22mm:D2 | supplier data | RB521S30T1G: stock or price UNKNOWN; confirm at order time |
| compact-22mm:D2 | datasheet | RB521S30T1G: no datasheet URL in connectivity.yaml |
| compact-22mm:R13 | supplier data | RC0201FR-0720KL: stock or price UNKNOWN; confirm at order time |
| compact-22mm:RT1 | supplier data | NCP03XH103F05RL: stock or price UNKNOWN; confirm at order time |
| compact-22mm:RT1 | datasheet | NCP03XH103F05RL: no datasheet URL in connectivity.yaml |
| compact-22mm:R14,R15 | supplier data | RC0201FR-0710KL: stock or price UNKNOWN; confirm at order time |
| compact-22mm:R16 | supplier data | RC0201FR-07220RL: stock or price UNKNOWN; confirm at order time |
| compact-22mm:Q4,Q5,Q6 | datasheet | DMG1012T-7: no datasheet URL in connectivity.yaml |
| compact-22mm:R19 | supplier data | RC0201FR-0747KL: stock or price UNKNOWN; confirm at order time |
| compact-22mm:D3 | supplier data | BZX585-C6V2: stock or price UNKNOWN; confirm at order time |
| compact-22mm:D3 | datasheet | BZX585-C6V2: no datasheet URL in connectivity.yaml |
| evaluation-board:J1 | mpn | no MPN (hand-fitted or PCB feature) |
| evaluation-board:R1,R10,R11,R12,R17,R18 | supplier data | RC0402FR-07100KL: stock or price UNKNOWN; confirm at order time |
| evaluation-board:C1,C2,C3,C10,C11,C12,C13 | datasheet | CL21A226MOQNNNE: no datasheet URL in connectivity.yaml |
| evaluation-board:C4,C5,C6,C14,C15,C17 | datasheet | CL05B104KO5NNNC: no datasheet URL in connectivity.yaml |
| evaluation-board:U1 | supplier data | TPS552882RPMR: stock or price UNKNOWN; confirm at order time |
| evaluation-board:Q2,Q3 | supplier data | SISS80DN-T1-GE3: stock or price UNKNOWN; confirm at order time |
| evaluation-board:L1 | supplier data | XGL5030-102MEC: stock or price UNKNOWN; confirm at order time |
| evaluation-board:L1 | datasheet | XGL5030-102MEC: no datasheet URL in connectivity.yaml |
| evaluation-board:C7,C16 | supplier data | CL10A106KP8NNNC: stock or price UNKNOWN; confirm at order time |
| evaluation-board:C7,C16 | datasheet | CL10A106KP8NNNC: no datasheet URL in connectivity.yaml |
| evaluation-board:R2,R6 | supplier data | RC0402FR-0733K2L: stock or price UNKNOWN; confirm at order time |
| evaluation-board:R3 | supplier data | RC0402FR-0724K9L: stock or price UNKNOWN; confirm at order time |
| evaluation-board:R4 | supplier data | RC0402FR-071K2L: stock or price UNKNOWN; confirm at order time |
| evaluation-board:C8 | supplier data | CL05B563KO5NNNC: stock or price UNKNOWN; confirm at order time |
| evaluation-board:C8 | datasheet | CL05B563KO5NNNC: no datasheet URL in connectivity.yaml |
| evaluation-board:C9 | supplier data | GRM1555C1H681JA01D: stock or price UNKNOWN; confirm at order time |
| evaluation-board:C9 | datasheet | GRM1555C1H681JA01D: no datasheet URL in connectivity.yaml |
| evaluation-board:R5 | supplier data | RC0402FR-0749K9L: stock or price UNKNOWN; confirm at order time |
| evaluation-board:R7,R20 | supplier data | RC0402FR-074K7L: stock or price UNKNOWN; confirm at order time |
| evaluation-board:RS1 | supplier data | MCS1632R010FER: stock or price UNKNOWN; confirm at order time |
| evaluation-board:RS1 | datasheet | MCS1632R010FER: no datasheet URL in connectivity.yaml |
| evaluation-board:R8 | supplier data | RT0402BRD078K66L: stock or price UNKNOWN; confirm at order time |
| evaluation-board:R9 | supplier data | RT0402BRD0710KL: stock or price UNKNOWN; confirm at order time |
| evaluation-board:D1 | datasheet | PMEG4010CEJ,115: no datasheet URL in connectivity.yaml |
| evaluation-board:D2 | supplier data | RB521S30T1G: stock or price UNKNOWN; confirm at order time |
| evaluation-board:D2 | datasheet | RB521S30T1G: no datasheet URL in connectivity.yaml |
| evaluation-board:R13 | supplier data | RC0402FR-0720KL: stock or price UNKNOWN; confirm at order time |
| evaluation-board:RT1 | datasheet | NCP15XH103F03RC: no datasheet URL in connectivity.yaml |
| evaluation-board:R14,R15 | supplier data | RC0402FR-0710KL: stock or price UNKNOWN; confirm at order time |
| evaluation-board:R16 | supplier data | RC0402FR-07220RL: stock or price UNKNOWN; confirm at order time |
| evaluation-board:Q4,Q5,Q6 | datasheet | DMG1012T-7: no datasheet URL in connectivity.yaml |
| evaluation-board:R19 | supplier data | RC0402FR-0747KL: stock or price UNKNOWN; confirm at order time |
| evaluation-board:D3 | supplier data | BZX585-C6V2: stock or price UNKNOWN; confirm at order time |
| evaluation-board:D3 | datasheet | BZX585-C6V2: no datasheet URL in connectivity.yaml |
| Q1 | alternate | Diodes Inc. DMP2005UFG-13 is not a drop-in replacement (different land pattern) |
| Q2,Q3 | alternate | Diodes Inc. DMN22M5UFG-7 is not a drop-in replacement (different land pattern) |
