djgringoboy2003/Nub44-driver/manufacturing/budget-2s/ORDERING.md

# Budget-2S driver: manufacturing package

Generated by `automation/budget/export.py`; do not hand-edit. **Status: FABRICATION FILES CHECKED (prototype); every BOM line has a sourced MPN.**

No tool places an order. Gate G (bench validation on a dummy load) remains OPEN.

## Board

- 90 x 60 mm, 4 layers, 1.6 mm FR-4, 1 oz outer and inner copper, ENIG or HASL lead-free.
- Layer order: L1 F.Cu (`.gtl`), L2 In1.Cu GND plane (`.g1`), L3 In2.Cu (`.g2`), L4 B.Cu (`.gbl`).
- Minimum track/space 0.15/0.15 mm, vias 0.6/0.3 mm. U1's five 0.6/0.3 mm thermal vias sit in its exposed
  pad, unplugged and tented on the bottom; stencil apertures are kept 0.2 mm clear of them (no via filling).
- All parts on the top side. Through-hole parts (hand-solder, or order through-hole assembly): F1, J1, J2, J3, J4, J5.
- Fit the 10 A mini-blade fuse in F1 after assembly. X-ray or inspect U1 (VQFN exposed pad).
- CPL rotations are KiCad's (0-360). Check every part in the assembler's placement preview, especially pin 1
  of U1-U8, Q1-Q8 and the diodes D1-D4, before approving; library orientations differ between assemblers.

## Files

- `budget-2s-gerbers.zip`: Gerbers and Excellon drill (PTH/NPTH) for the PCB order.
- `assembly/BOM.csv` (full, with requirements), `assembly/BOM_JLCPCB.csv`, `assembly/CPL_JLCPCB.csv` (origin = drill origin).
- `drawings/`: schematic, top assembly (F.Fab), renders.

## Checks (from tools)

- DRC: 0 errors, 0 warnings, 0 unconnected, 0 schematic-parity issues.
- BOM 55 lines / 99 parts; CPL 99 placements; board vs connectivity reference mismatch: none.

## Lines to select at order time (no part number invented)

None: every line has a sourced MPN (DD-39).

## Lines without an LCSC code

Order codes and evidence: `engineering/design/budget-2s/sourcing.yaml`. Stock and prices are not recorded
and stay UNKNOWN until quoted. For a JLCPCB/LCSC-assembled board these lines must be matched by MPN in the
assembler's BOM tool, consigned, or fitted by hand (UK distributor in brackets where one was found):

- None.

## LCSC listing names and equivalents (DD-40)

The same part under LCSC's full ordering name, or, where LCSC does not list the part, the equivalent used in
`BOM_JLCPCB.csv` (same value, package, tolerance and TCR; a hand-built board uses the MPN in `BOM.csv`):

- J3: B2B-PH-K-S is listed by LCSC as B2B-PH-K-S(LF)(SN) (C131337)
- J5: B2B-PH-K-S is listed by LCSC as B2B-PH-K-S(LF)(SN) (C131337)
- D1: BZX585-C10 is listed by LCSC as BZX585-C10,115 (C550626)
- D3: BZX585-C6V2 is listed by LCSC as BZX585-C6V2,115 (C550667)
- R6,R15,R17: ERA-3AEB103V is listed by LCSC as ERA3AEB103V (C190610)
- R5: ERA-3AEB2742V is not listed by LCSC; BOM_JLCPCB.csv uses the equivalent YAGEO AT0603BRD0727K4L (C855755)
- J2: MX126-5.0-02P is listed by LCSC as MX126-5.0-02P-GN01-Cu-S-A (C5188434)
- R7: TNPW06032K67BEEA is not listed by LCSC; BOM_JLCPCB.csv uses the equivalent YAGEO AT0603BRD072K67L (C855783)
- J1: XT30PW-M is listed by LCSC as XT30PW-M30.G.Y (C431092)

Precision lines (0.1 %, 25 ppm/C) set the laser current and protection thresholds: buy genuine parts from a
UK distributor or LCSC and keep the exact values; do not substitute 1 % parts. Verify the XT30 moulded +/- marks
against the B+/B- silkscreen before first power (Q1 blocks a reversed pack). See
engineering/budget-2s-design.md for open review items.
