djgringoboy2003/Nub44-driver/research/sources/component-sources.md

# Component research – source index

All sources were retrieved on 2026-10-24 by the component-selection agent. Local copies are in `research/datasheets/` (paths relative to the project root). "LCSC mirror" means the PDF came from LCSC's datasheet server, which redirects to `https://datasheet.lcsc.com/datasheet/pdf/<hash>.pdf?productCode=<C-number>`. The document identity was checked against the PDF text.

| ID | Title | Publisher | URL | Document revision/date | Retrieved | Local copy | Relevant pages | Primary/Secondary |
|---|---|---|---|---|---|---|---|---|
| CMP-01 | LMx58/LM2904 Industry-Standard Dual Op Amps | Texas Instruments | https://www.ti.com/lit/ds/symlink/lm358.pdf | SLOS068AB, rev. Oct 2024 | 2026-10-24 | research/datasheets/cmp_TI_LM358.pdf | p.1, 5 (ROC), 6 (B/BA EC), 10 (LM358/A EC) | Primary |
| CMP-02 | AO3400A 30V N-Channel MOSFET | Alpha & Omega Semiconductor | https://www.aosmd.com/res/datasheets/AO3400A.pdf | Rev 3.1, Jul 2023 | 2026-10-24 | research/datasheets/cmp_AOS_AO3400A.pdf | p.1–4 | Primary |
| CMP-03 | AO4407A 30V P-Channel MOSFET | Alpha & Omega Semiconductor | https://www.aosmd.com/res/datasheets/AO4407A.pdf | Rev 11.1, Mar 2024 | 2026-10-24 | research/datasheets/cmp_AOS_AO4407A.pdf | p.1–3 | Primary |
| CMP-04 | ATtiny13A Data Sheet | Microchip | https://ww1.microchip.com/downloads/en/DeviceDoc/ATtiny13A-Data-Sheet-DS40002307A.pdf | DS40002307A (2021) | 2026-10-24 | research/datasheets/cmp_Microchip_ATtiny13A.pdf | p.1–2 (features), 105 (serial programming), 168 (ordering) | Primary |
| CMP-05 | INA186 Zero-Drift Current-Sense Amplifier | Texas Instruments | https://www.ti.com/lit/ds/symlink/ina186.pdf | SBOS318B, rev. Jul 2021 | 2026-10-24 | research/datasheets/cmp_TI_INA186.pdf | p.3 (Table 5-1 pins), p.4–6 (ROC, EC), p.25–26 (Fig 10-1 SC70 layout), DCK package addendum | Primary |
| CMP-06 | INAx181 Current-Sense Amplifiers | Texas Instruments | https://www.ti.com/lit/ds/symlink/ina181.pdf | SBOS793H, rev. Nov 2023 | 2026-10-24 | research/datasheets/cmp_TI_INA181.pdf | ROC 6.3, EC 6.5 | Primary |
| CMP-07 | INA185 350-kHz Current-Sense Amplifier (SOT-563) | Texas Instruments | https://www.ti.com/lit/ds/symlink/ina185.pdf | SBOS378A, rev. Nov 2023 | 2026-10-24 | research/datasheets/cmp_TI_INA185.pdf | ROC 5.3, EC 5.5 | Primary |
| CMP-08 | INA190 Zero-Drift Precision CSA | Texas Instruments | https://www.ti.com/lit/ds/symlink/ina190.pdf | SBOS863D, rev. Nov 2019 | 2026-10-24 | research/datasheets/cmp_TI_INA190.pdf | p.3 (pinouts), ROC, EC | Primary |
| CMP-09 | INA199 Zero-Drift Current-Shunt Monitor | Texas Instruments | https://www.ti.com/lit/ds/symlink/ina199.pdf | SBOS469H, rev. Oct 2023 | 2026-10-24 | research/datasheets/cmp_TI_INA199.pdf | EC 6.5 | Primary |
| CMP-10 | TSC210–TSC215 current-sense amplifiers | STMicroelectronics | https://www.st.com/resource/en/datasheet/tsc213.pdf (official; st.com download timed out, LCSC mirror for C1858319 used) | DS13237 Rev 5, Aug 2021 | 2026-10-24 | research/datasheets/cmp_ST_TSC213.pdf | p.1 features | Primary (mirror) |
| CMP-11 | OPAx333 Zero-Drift Op Amps | Texas Instruments | https://www.ti.com/lit/ds/symlink/opa333.pdf | SBOS351E, rev. Dec 2015 | 2026-10-24 | research/datasheets/cmp_TI_OPA333.pdf | EC | Primary |
| CMP-12 | OPAx388 Zero-Drift Zero-Crossover Op Amps | Texas Instruments | https://www.ti.com/lit/ds/symlink/opa388.pdf | SBOS777D, rev. Jul 2020 | 2026-10-24 | research/datasheets/cmp_TI_OPA388.pdf | p.1, EC 6.7 | Primary |
| CMP-13 | TLVx333 Zero-Drift Op Amps | Texas Instruments | https://www.ti.com/lit/ds/symlink/tlv333.pdf | SBOS751 | 2026-10-24 | research/datasheets/cmp_TI_TLV333.pdf | p.1, EC | Primary |
| CMP-14 | OPAx387 Ultra-High-Precision Zero-Drift Op Amps | Texas Instruments | https://www.ti.com/lit/ds/symlink/opa387.pdf | SBOS984G | 2026-10-24 | research/datasheets/cmp_TI_OPA387.pdf | p.1 features | Primary |
| CMP-15 | TLV906xS 10-MHz RRIO Op Amps | Texas Instruments | https://www.ti.com/lit/ds/symlink/tlv9061.pdf | SBOS839N, rev. Jul 2026 | 2026-10-24 | research/datasheets/cmp_TI_TLV9061.pdf | EC 6.10 | Primary |
| CMP-16 | TLV900x 1-MHz RRIO Op Amps | Texas Instruments | https://www.ti.com/lit/ds/symlink/tlv9001.pdf | SBOS833R, rev. Nov 2021 | 2026-10-24 | research/datasheets/cmp_TI_TLV9001.pdf | EC | Primary |
| CMP-17 | TSZ121/TSZ122/TSZ124 Zero-Drift Op Amps | STMicroelectronics | https://www.st.com/resource/en/datasheet/tsz121.pdf (LCSC mirror for C2058276 used) | DS9216 Rev 10, Feb 2019 | 2026-10-24 | research/datasheets/cmp_ST_TSZ121.pdf | p.1 features | Primary (mirror) |
| CMP-18 | IRLHM620PbF HEXFET Power MOSFET | Infineon (International Rectifier) | https://www.infineon.com/assets/row/public/documents/24/49/infineon-irlhm620-datasheet-en.pdf | IR datasheet dated 25 Sep 2015 (rev. history to 2015) | 2026-10-24 | research/datasheets/cmp_Infineon_IRLHM620.pdf | p.1 (summary, pinout graphic), p.2 (static char., thermal), p.4 (Fig 8 SOA); footprint in AN-1136 | Primary |
| CMP-19 | DMN2002UFG 20V N-Channel MOSFET | Diodes Inc. | https://www.diodes.com/assets/Datasheets/DMN2002UFG.pdf | DS46484 Rev. 2-2, Sep 2024 | 2026-10-24 | research/datasheets/cmp_Diodes_DMN2002UFG.pdf | p.2–3 (EC), p.5 (Fig 12 SOA) | Primary |
| CMP-20 | DMN22M5UFG 20V N-Channel MOSFET | Diodes Inc. | https://www.diodes.com/assets/Datasheets/DMN22M5UFG.pdf | DS40908 Rev. 3-2, Mar 2022 | 2026-10-24 | research/datasheets/cmp_Diodes_DMN22M5UFG.pdf | EC, Fig 12 SOA | Primary |
| CMP-21 | SiSS80DN N-Channel 20 V MOSFET | Vishay Siliconix | https://www.vishay.com/docs/77684/siss80dn.pdf | Doc 77684 Rev. C, 19-Oct-2026 | 2026-10-24 | research/datasheets/cmp_Vishay_SiSS80DN.pdf | p.1 summary, SOA (J-A) | Primary |
| CMP-22 | SiSS23DN P-Channel 20 V MOSFET | Vishay Siliconix | LCSC mirror: https://www.lcsc.com/datasheet/lcsc_datasheet_1806020936_Vishay-Intertech-SISS23DN-T1-GE3_C222439.pdf | Doc 62852, S13-1162 Rev. A, 13-May-13 | 2026-10-24 | research/datasheets/cmp_Vishay_SiSS23DN.pdf | p.1 (summary, pinout), p.2 (thermal, EC), SOA (J-A) | Primary (mirror) |
| CMP-23 | SiSH615ADN P-Channel 20 V MOSFET | Vishay Siliconix | LCSC mirror for C7363886 | Doc 79563 Rev. A, 17-Sep-2018 | 2026-10-24 | research/datasheets/cmp_Vishay_SiSH615ADN.pdf | p.1 | Primary (mirror) |
| CMP-24 | DMP2005UFG P-Channel MOSFET | Diodes Inc. | https://www.diodes.com/assets/Datasheets/DMP2005UFG.pdf | Rev. 2-2 (PDF created 2016-11-17) | 2026-10-24 | research/datasheets/cmp_Diodes_DMP2005UFG.pdf | p.1 (pinout), EC, Fig 12 SOA | Primary |
| CMP-25 | IRLHS6242PbF MOSFET (PQFN 2x2) | Infineon | LCSC mirror: https://www.lcsc.com/datasheet/lcsc_datasheet_2411220321_Infineon-Technologies-IRLHS6242TRPBF_C150933.pdf | IR template (revision table in PDF) | 2026-10-24 | research/datasheets/cmp_Infineon_IRLHS6242.pdf | p.2 (EC, thermal), Fig 8 SOA | Primary (mirror) |
| CMP-26 | DMG1012T N-Channel MOSFET | Diodes Inc. | https://www.diodes.com/assets/Datasheets/ds31783.pdf | DS31783 | 2026-10-24 | research/datasheets/cmp_Diodes_DMG1012T.pdf | p.1 (pinout), p.2 (EC) | Primary |
| CMP-27 | DMG1013T P-Channel MOSFET | Diodes Inc. | https://www.diodes.com/assets/Datasheets/ds31784.pdf | DS31784 | 2026-10-24 | research/datasheets/cmp_Diodes_DMG1013T.pdf | p.1–2 | Primary |
| CMP-28 | SSM3K35AMFV | Toshiba | LCSC mirror for C150155 | as published by LCSC | 2026-10-24 | research/datasheets/cmp_Toshiba_SSM3K35AMFV.pdf | EC table (not machine-extractable) | Primary (mirror) |
| CMP-29 | SSM3J35AMFV | Toshiba | LCSC mirror for C5274156 | as published by LCSC | 2026-10-24 | research/datasheets/cmp_Toshiba_SSM3J35AMFV.pdf | EC table | Primary (mirror) |
| CMP-30 | NX3008NBKW 30 V N-channel Trench MOSFET | Nexperia | LCSC mirror for C282548 (assets.nexperia.com returned Access Denied) | as published by LCSC | 2026-10-24 | research/datasheets/cmp_Nexperia_NX3008NBKW.pdf | p.1–2 | Primary (mirror) |
| CMP-31 | AO3401A 30V P-Channel MOSFET | Alpha & Omega Semiconductor | https://www.aosmd.com/res/datasheets/AO3401A.pdf | as downloaded | 2026-10-24 | research/datasheets/cmp_AOS_AO3401A.pdf | p.1–2 | Primary |
| CMP-32 | XGL4030 Series Shielded Power Inductors | Coilcraft | https://www.coilcraft.com/getmedia/032d9c73-4222-482f-b6bc-7808590e27c9/xgl4030.pdf | Document 1575-1 | 2026-10-24 | research/datasheets/cmp_Coilcraft_XGL4030.pdf | p.1 (value table, Isat at 10/20/30 %, Irms), p.1 drawing/land pattern | Primary |
| CMP-33 | XEL4030 Series Shielded Power Inductors | Coilcraft | https://www.coilcraft.com/getmedia/8245f050-f190-4295-8c41-7c03d662ee3d/xel4030.pdf | Document 1321-1 | 2026-10-24 | research/datasheets/cmp_Coilcraft_XEL4030.pdf | p.1 (value table; Isat = 30 % drop) | Primary |
| CMP-34 | WSKW0612 Power Metal Strip 4-terminal resistor | Vishay Dale | LCSC mirror: https://www.lcsc.com/datasheet/lcsc_datasheet_2410121847_Vishay-Intertech-WSKW06125L000FEA_C4236646.pdf | Doc 30332, revision 25-Apr-2023 | 2026-10-24 | research/datasheets/cmp_Vishay_WSKW0612.pdf | p.1 (ratings, dimensions, 4-terminal diagram), p.2 (solder pad dimensions) | Primary (mirror) |
| CMP-35 | ATtiny1616/3216 Preliminary Datasheet | Microchip | LCSC mirror: https://www.lcsc.com/datasheet/lcsc_datasheet_2004232205_Microchip-Tech-ATTINY1616-MNR_C507118.pdf | DS40001997C (2019) | 2026-10-24 | research/datasheets/cmp_Microchip_ATtiny1616.pdf | p.17 (Table 5-1 multiplexing/pinout), Electrical Characteristics "Operating Voltage and Frequency", package drawing VQFN-20 | Primary (mirror) |
| CMP-36 | JLCPCB parts library API (selectSmtComponentList) | JLCPCB | https://jlcpcb.com/api/overseas-pcb-order/v1/shoppingCart/smtGood/selectSmtComponentList (POST, keyword search) | live data | 2026-10-24 | none (raw JSON kept in agent scratchpad only) | LCSC C-number↔MPN mapping, Basic/Extended library type, JLC assembly stock, LCSC parametric description | Secondary |
| CMP-37 | LCSC product detail pages | LCSC | https://www.lcsc.com/product-detail/<C-number>.html (one page per part in the CSV) | live data | 2026-10-24 | none | LCSC stock (`stockNumber`) and price ladder (USD) embedded in page JSON | Secondary |
| CMP-38 | Vishay P-Channel Gen III MOSFET selector | Vishay | https://www.vishay.com/en/mosfets/geniii-p/ | live page | 2026-10-24 | none | candidate list (values cross-checked against datasheets CMP-22/23) | Secondary |
| CMP-39 | AON7407 product page | Alpha & Omega Semiconductor | https://www.aosmd.com/products/mosfets/p-channel-mosfets-8v-60v/aon7407 | live page | 2026-10-24 | none | RDS(on) at −4.5/−2.5/−1.8 V | Secondary |
| CMP-40 | AON7404G product page (via web search summary) | Alpha & Omega Semiconductor | https://www.aosmd.com/products/mosfets/low-voltage-mosfets-12v-30v/aon7404g | live page | 2026-10-24 | none | RDS(on) 6.8 mΩ @2.5 V (rejected candidate) | Secondary |
| CMP-41 | SiSS80DN product page | Vishay | https://www.vishay.com/en/product/77684/ | live page | 2026-10-24 | none | features | Secondary |
| CMP-42 | ATtiny4/5/9/10 datasheet mirror and TPI programmer notes (web search) | Radiolocman (Microchip datasheet mirror); EasyEDA user project | https://www.radiolocman.com/datasheet/pdf.html?di=120395 ; https://easyeda.com/sanchocovalho/attiny10-programmer | not checked | 2026-10-24 | none | "programming at 5 V only" statement; 12 V only for RSTDISBL recovery | Secondary (Microchip PDF not downloaded) |
