djgringoboy2003/Nub44-driver/sourcing/components.csv

variant | reference_designators | quantity | manufacturer | mpn | value | tolerance | voltage_rating | current_rating | power_rating | package | footprint | datasheet | preferred_supplier | supplier_part_number | availability | approx_price_usd | data_retrieved | verified | approved_alternatives | notes
compact-22mm | J1 | 1 | UNKNOWN | UNKNOWN | B+ spring | UNKNOWN | UNKNOWN | UNKNOWN | UNKNOWN | Contact_Spring_Pad_D5.0mm | nubm44:Contact_Spring_Pad_D5.0mm | ~ | UNKNOWN | UNKNOWN | UNKNOWN | UNKNOWN | - | NO | - | DNP: hand-fitted battery spring, select to suit host
compact-22mm | Q1 | 1 | Vishay | SISS23DN-T1-GE3 | SiSS23DN | Rds 6.3 mOhm max @ -2.5 V | -20 V | see datasheet | - | Vishay_PowerPAK_1212-8_Single | Package_SO:Vishay_PowerPAK_1212-8_Single | https://www.vishay.com/docs/62999/siss23dn.pdf | LCSC | C222439 | 220 | 1+: $1.8603 / 10+: $1.5797 | 2026-10-24 | YES | Diodes Inc. DMP2005UFG-13
compact-22mm | R1,R10,R11,R12,R17,R18 | 6 | Yageo | RC0201FR-07100KL | 100k | +-1 % | 25 V | - | 1/20 W | R_0201_0603Metric | Resistor_SMD:R_0201_0603Metric | ~ | UNKNOWN | UNKNOWN | UNKNOWN | UNKNOWN | - | NO | - | commodity part: supplier data not verified, choose an equivalent at order time
compact-22mm | C1,C2,C3,C10,C11,C12,C13 | 7 | Samsung | CL21A226MOQNNNE | 22u | +-20 % X5R | 16 V | - | - | C_0805_2012Metric | Capacitor_SMD:C_0805_2012Metric | ~ | LCSC | C98190 | 19970 | 10+: $0.0916 / 100+: $0.0739 | 2026-10-24 | PARTIAL | -
compact-22mm | C4,C5,C6,C14,C15,C17 | 6 | Murata | GRM033R61A104KE15D | 100n | +-10 % X5R | 10 V | - | - | C_0201_0603Metric | Capacitor_SMD:C_0201_0603Metric | ~ | UNKNOWN | UNKNOWN | UNKNOWN | UNKNOWN | - | NO | - | commodity part: supplier data not verified, choose an equivalent at order time
compact-22mm | U1 | 1 | Texas Instruments | TPS552882RPMR | TPS552882 | VREF +-1 % | VIN 2.7-36 V, VOUT 0.8-22 V | 14 A min avg inductor limit (RILIM 20k) | - | TI_RPM0026A_VQFN-HR-26_4x3.5mm_P0.5mm | nubm44:TI_RPM0026A_VQFN-HR-26_4x3.5mm_P0.5mm | https://www.ti.com/lit/ds/symlink/tps552882.pdf | TI store | TPS552882RPMR | 2950 (TI store, 2026-10-24, PWR-20) | UNKNOWN | 2026-10-24 | PARTIAL | -
compact-22mm | Q2,Q3 | 2 | Vishay | SISS80DN-T1-GE3 | SiSS80DN | Rds 1.15 mOhm max @ 4.5 V | 20 V | see datasheet | - | Vishay_PowerPAK_1212-8_Single | Package_SO:Vishay_PowerPAK_1212-8_Single | https://www.vishay.com/docs/77684/siss80dn.pdf | UNKNOWN | UNKNOWN | UNKNOWN | UNKNOWN | - | NO | Diodes Inc. DMN22M5UFG-7; Infineon IRLHM620TRPBF | commodity part: supplier data not verified, choose an equivalent at order time
compact-22mm | L1 | 1 | Coilcraft | XGL5030-102MEC | 1.0u | +-20 % | - | Isat 10.2 A (20 %) / 14 A (30 %), Irms 12.8 A | - | L_Coilcraft_XAL5030-XXX | Inductor_SMD:L_Coilcraft_XAL5030-XXX | ~ | LCSC / Coilcraft | C6937849 | UNKNOWN | UNKNOWN | 2026-10-24 | PARTIAL | Coilcraft XAL5030-102MEC
compact-22mm | C7,C16 | 2 | Samsung | CL10A106KP8NNNC | 10u | +-10 % X5R | 10 V | - | - | C_0603_1608Metric | Capacitor_SMD:C_0603_1608Metric | ~ | UNKNOWN | UNKNOWN | UNKNOWN | UNKNOWN | - | NO | - | commodity part: supplier data not verified, choose an equivalent at order time
compact-22mm | R2,R6 | 2 | Yageo | RC0201FR-0733K2L | 33.2k | +-1 % | 25 V | - | 1/20 W | R_0201_0603Metric | Resistor_SMD:R_0201_0603Metric | ~ | UNKNOWN | UNKNOWN | UNKNOWN | UNKNOWN | - | NO | - | commodity part: supplier data not verified, choose an equivalent at order time
compact-22mm | R3 | 1 | Yageo | RC0201FR-0724K9L | 24.9k | +-1 % | 25 V | - | 1/20 W | R_0201_0603Metric | Resistor_SMD:R_0201_0603Metric | ~ | UNKNOWN | UNKNOWN | UNKNOWN | UNKNOWN | - | NO | - | commodity part: supplier data not verified, choose an equivalent at order time
compact-22mm | R4 | 1 | Yageo | RC0201FR-071K2L | 1.2k | +-1 % | 25 V | - | 1/20 W | R_0201_0603Metric | Resistor_SMD:R_0201_0603Metric | ~ | UNKNOWN | UNKNOWN | UNKNOWN | UNKNOWN | - | NO | - | commodity part: supplier data not verified, choose an equivalent at order time
compact-22mm | C8 | 1 | Samsung | CL05B563KO5NNNC | 56n | +-10 % X7R | 16 V | - | - | C_0402_1005Metric | Capacitor_SMD:C_0402_1005Metric | ~ | UNKNOWN | UNKNOWN | UNKNOWN | UNKNOWN | - | NO | - | commodity part: supplier data not verified, choose an equivalent at order time
compact-22mm | C9 | 1 | Murata | GRM0335C1H681JA01D | 680p | +-5 % C0G | 50 V | - | - | C_0201_0603Metric | Capacitor_SMD:C_0201_0603Metric | ~ | UNKNOWN | UNKNOWN | UNKNOWN | UNKNOWN | - | NO | - | commodity part: supplier data not verified, choose an equivalent at order time
compact-22mm | R5 | 1 | Yageo | RC0201FR-0749K9L | 49.9k | +-1 % | 25 V | - | 1/20 W | R_0201_0603Metric | Resistor_SMD:R_0201_0603Metric | ~ | UNKNOWN | UNKNOWN | UNKNOWN | UNKNOWN | - | NO | - | commodity part: supplier data not verified, choose an equivalent at order time
compact-22mm | R7,R20 | 2 | Yageo | RC0201FR-074K7L | 4.7k | +-1 % | 25 V | - | 1/20 W | R_0201_0603Metric | Resistor_SMD:R_0201_0603Metric | ~ | UNKNOWN | UNKNOWN | UNKNOWN | UNKNOWN | - | NO | - | commodity part: supplier data not verified, choose an equivalent at order time
compact-22mm | RS1 | 1 | Ohmite | MCS1632R010FER | 10m | +-1 % | - | - | 1 W | R_1206_3216Metric_Kelvin | nubm44:R_1206_3216Metric_Kelvin | ~ | DigiKey | MCS1632R010FER | UNKNOWN | UNKNOWN | 2026-10-24 | PARTIAL | RALEC LR1206-21R010F4
compact-22mm | U2 | 1 | Texas Instruments | INA186A2IDCKR | INA186A2 | gain +-1 %, VOS +-50 uV | VS 1.7-5.5 V, VCM -0.2..40 V | - | - | SOT-363_SC-70-6 | Package_TO_SOT_SMD:SOT-363_SC-70-6 | https://www.ti.com/lit/ds/symlink/ina186.pdf | LCSC | C2058238 | 9836 | 1+: $0.8667 / 10+: $0.691 | 2026-10-24 | YES | Texas Instruments INA186A3IDCKR
compact-22mm | R8 | 1 | Yageo | RT0402BRD078K66L | 8.66k | +-0.1 %, 25 ppm/K | 50 V | - | 1/16 W | R_0402_1005Metric | Resistor_SMD:R_0402_1005Metric | ~ | UNKNOWN | UNKNOWN | UNKNOWN | UNKNOWN | - | NO | - | commodity part: supplier data not verified, choose an equivalent at order time
compact-22mm | R9 | 1 | Yageo | RT0402BRD0710KL | 10.0k | +-0.1 %, 25 ppm/K | 50 V | - | 1/16 W | R_0402_1005Metric | Resistor_SMD:R_0402_1005Metric | ~ | UNKNOWN | UNKNOWN | UNKNOWN | UNKNOWN | - | NO | - | commodity part: supplier data not verified, choose an equivalent at order time
compact-22mm | D1 | 1 | Nexperia | PMEG4010CEJ,115 | PMEG4010CEJ | - | 40 V | 1 A | - | D_SOD-323F | Diode_SMD:D_SOD-323F | ~ | LCSC | C50704 | 16100 | 5+: $0.3702 / 50+: $0.2953 | 2026-10-24 | PARTIAL | -
compact-22mm | U3 | 1 | Microchip | ATTINY1616-MNR | ATtiny1616-MNR | - | 1.8-5.5 V | - | - | VQFN-20-1EP_3x3mm_P0.4mm_EP1.7x1.7mm | Package_DFN_QFN:VQFN-20-1EP_3x3mm_P0.4mm_EP1.7x1.7mm | https://ww1.microchip.com/downloads/en/DeviceDoc/ATtiny1614-16-17-DataSheet-DS40002204A.pdf | LCSC | C507118 | 3507 | 1+: $1.0962 / 10+: $0.908 | 2026-10-24 | YES | -
compact-22mm | D2 | 1 | onsemi | RB521S30T1G | RB521S30 | - | 30 V | 200 mA | - | D_SOD-523 | Diode_SMD:D_SOD-523 | ~ | UNKNOWN | UNKNOWN | UNKNOWN | UNKNOWN | - | NO | - | commodity part: supplier data not verified, choose an equivalent at order time
compact-22mm | R13 | 1 | Yageo | RC0201FR-0720KL | 20k | +-1 % | 25 V | - | 1/20 W | R_0201_0603Metric | Resistor_SMD:R_0201_0603Metric | ~ | UNKNOWN | UNKNOWN | UNKNOWN | UNKNOWN | - | NO | - | commodity part: supplier data not verified, choose an equivalent at order time
compact-22mm | RT1 | 1 | Murata | NCP03XH103F05RL | 10k | +-1 %, B 3380 K | - | - | - | R_0201_0603Metric | Resistor_SMD:R_0201_0603Metric | ~ | UNKNOWN | UNKNOWN | UNKNOWN | UNKNOWN | - | NO | - | commodity part: supplier data not verified, choose an equivalent at order time
compact-22mm | R14,R15 | 2 | Yageo | RC0201FR-0710KL | 10k | +-1 % | 25 V | - | 1/20 W | R_0201_0603Metric | Resistor_SMD:R_0201_0603Metric | ~ | UNKNOWN | UNKNOWN | UNKNOWN | UNKNOWN | - | NO | - | commodity part: supplier data not verified, choose an equivalent at order time
compact-22mm | R16 | 1 | Yageo | RC0201FR-07220RL | 220 | +-1 % | 25 V | - | 1/20 W | R_0201_0603Metric | Resistor_SMD:R_0201_0603Metric | ~ | UNKNOWN | UNKNOWN | UNKNOWN | UNKNOWN | - | NO | - | commodity part: supplier data not verified, choose an equivalent at order time
compact-22mm | Q4,Q5,Q6 | 3 | Diodes Incorporated | DMG1012T-7 | DMG1012T | - | 20 V | 0.63 A | - | SOT-523 | Package_TO_SOT_SMD:SOT-523 | ~ | LCSC | C20512 | 124900 | 5+: $0.1019 / 50+: $0.0837 | 2026-10-24 | YES | -
compact-22mm | R19 | 1 | Yageo | RC0201FR-0747KL | 47k | +-1 % | 25 V | - | 1/20 W | R_0201_0603Metric | Resistor_SMD:R_0201_0603Metric | ~ | UNKNOWN | UNKNOWN | UNKNOWN | UNKNOWN | - | NO | - | commodity part: supplier data not verified, choose an equivalent at order time
compact-22mm | D3 | 1 | Nexperia | BZX585-C6V2 | 6.2V | +-5 % | 6.2 V Zener | - | 300 mW | D_SOD-523 | Diode_SMD:D_SOD-523 | ~ | UNKNOWN | UNKNOWN | UNKNOWN | UNKNOWN | - | NO | - | commodity part: supplier data not verified, choose an equivalent at order time
evaluation-board | J1 | 1 | UNKNOWN | UNKNOWN | B+ spring | UNKNOWN | UNKNOWN | UNKNOWN | UNKNOWN | Wire_Pad_PTH_D1.3mm | nubm44:Wire_Pad_PTH_D1.3mm | ~ | UNKNOWN | UNKNOWN | UNKNOWN | UNKNOWN | - | NO | - | DNP: hand-fitted battery spring, select to suit host
evaluation-board | Q1 | 1 | Vishay | SISS23DN-T1-GE3 | SiSS23DN | Rds 6.3 mOhm max @ -2.5 V | -20 V | see datasheet | - | Vishay_PowerPAK_1212-8_Single | Package_SO:Vishay_PowerPAK_1212-8_Single | https://www.vishay.com/docs/62999/siss23dn.pdf | LCSC | C222439 | 220 | 1+: $1.8603 / 10+: $1.5797 | 2026-10-24 | YES | Diodes Inc. DMP2005UFG-13
evaluation-board | R1,R10,R11,R12,R17,R18 | 6 | Yageo | RC0402FR-07100KL | 100k | +-1 % | 50 V | - | 1/16 W | R_0402_1005Metric | Resistor_SMD:R_0402_1005Metric | ~ | UNKNOWN | UNKNOWN | UNKNOWN | UNKNOWN | - | NO | - | commodity part: supplier data not verified, choose an equivalent at order time
evaluation-board | C1,C2,C3,C10,C11,C12,C13 | 7 | Samsung | CL21A226MOQNNNE | 22u | +-20 % X5R | 16 V | - | - | C_0805_2012Metric | Capacitor_SMD:C_0805_2012Metric | ~ | LCSC | C98190 | 19970 | 10+: $0.0916 / 100+: $0.0739 | 2026-10-24 | PARTIAL | -
evaluation-board | C4,C5,C6,C14,C15,C17 | 6 | Samsung | CL05B104KO5NNNC | 100n | +-10 % X7R | 16 V | - | - | C_0402_1005Metric | Capacitor_SMD:C_0402_1005Metric | ~ | LCSC | C1525 | 6134400 | 100+: $0.0036 / 1000+: $0.0027 | 2026-10-24 | PARTIAL | -
evaluation-board | U1 | 1 | Texas Instruments | TPS552882RPMR | TPS552882 | VREF +-1 % | VIN 2.7-36 V, VOUT 0.8-22 V | 14 A min avg inductor limit (RILIM 20k) | - | TI_RPM0026A_VQFN-HR-26_4x3.5mm_P0.5mm | nubm44:TI_RPM0026A_VQFN-HR-26_4x3.5mm_P0.5mm | https://www.ti.com/lit/ds/symlink/tps552882.pdf | TI store | TPS552882RPMR | 2950 (TI store, 2026-10-24, PWR-20) | UNKNOWN | 2026-10-24 | PARTIAL | -
evaluation-board | Q2,Q3 | 2 | Vishay | SISS80DN-T1-GE3 | SiSS80DN | Rds 1.15 mOhm max @ 4.5 V | 20 V | see datasheet | - | Vishay_PowerPAK_1212-8_Single | Package_SO:Vishay_PowerPAK_1212-8_Single | https://www.vishay.com/docs/77684/siss80dn.pdf | UNKNOWN | UNKNOWN | UNKNOWN | UNKNOWN | - | NO | Diodes Inc. DMN22M5UFG-7; Infineon IRLHM620TRPBF | commodity part: supplier data not verified, choose an equivalent at order time
evaluation-board | L1 | 1 | Coilcraft | XGL5030-102MEC | 1.0u | +-20 % | - | Isat 10.2 A (20 %) / 14 A (30 %), Irms 12.8 A | - | L_Coilcraft_XAL5030-XXX | Inductor_SMD:L_Coilcraft_XAL5030-XXX | ~ | LCSC / Coilcraft | C6937849 | UNKNOWN | UNKNOWN | 2026-10-24 | PARTIAL | Coilcraft XAL5030-102MEC
evaluation-board | C7,C16 | 2 | Samsung | CL10A106KP8NNNC | 10u | +-10 % X5R | 10 V | - | - | C_0603_1608Metric | Capacitor_SMD:C_0603_1608Metric | ~ | UNKNOWN | UNKNOWN | UNKNOWN | UNKNOWN | - | NO | - | commodity part: supplier data not verified, choose an equivalent at order time
evaluation-board | R2,R6 | 2 | Yageo | RC0402FR-0733K2L | 33.2k | +-1 % | 50 V | - | 1/16 W | R_0402_1005Metric | Resistor_SMD:R_0402_1005Metric | ~ | UNKNOWN | UNKNOWN | UNKNOWN | UNKNOWN | - | NO | - | commodity part: supplier data not verified, choose an equivalent at order time
evaluation-board | R3 | 1 | Yageo | RC0402FR-0724K9L | 24.9k | +-1 % | 50 V | - | 1/16 W | R_0402_1005Metric | Resistor_SMD:R_0402_1005Metric | ~ | UNKNOWN | UNKNOWN | UNKNOWN | UNKNOWN | - | NO | - | commodity part: supplier data not verified, choose an equivalent at order time
evaluation-board | R4 | 1 | Yageo | RC0402FR-071K2L | 1.2k | +-1 % | 50 V | - | 1/16 W | R_0402_1005Metric | Resistor_SMD:R_0402_1005Metric | ~ | UNKNOWN | UNKNOWN | UNKNOWN | UNKNOWN | - | NO | - | commodity part: supplier data not verified, choose an equivalent at order time
evaluation-board | C8 | 1 | Samsung | CL05B563KO5NNNC | 56n | +-10 % X7R | 16 V | - | - | C_0402_1005Metric | Capacitor_SMD:C_0402_1005Metric | ~ | UNKNOWN | UNKNOWN | UNKNOWN | UNKNOWN | - | NO | - | commodity part: supplier data not verified, choose an equivalent at order time
evaluation-board | C9 | 1 | Murata | GRM1555C1H681JA01D | 680p | +-5 % C0G | 50 V | - | - | C_0402_1005Metric | Capacitor_SMD:C_0402_1005Metric | ~ | UNKNOWN | UNKNOWN | UNKNOWN | UNKNOWN | - | NO | - | commodity part: supplier data not verified, choose an equivalent at order time
evaluation-board | R5 | 1 | Yageo | RC0402FR-0749K9L | 49.9k | +-1 % | 50 V | - | 1/16 W | R_0402_1005Metric | Resistor_SMD:R_0402_1005Metric | ~ | UNKNOWN | UNKNOWN | UNKNOWN | UNKNOWN | - | NO | - | commodity part: supplier data not verified, choose an equivalent at order time
evaluation-board | R7,R20 | 2 | Yageo | RC0402FR-074K7L | 4.7k | +-1 % | 50 V | - | 1/16 W | R_0402_1005Metric | Resistor_SMD:R_0402_1005Metric | ~ | UNKNOWN | UNKNOWN | UNKNOWN | UNKNOWN | - | NO | - | commodity part: supplier data not verified, choose an equivalent at order time
evaluation-board | RS1 | 1 | Ohmite | MCS1632R010FER | 10m | +-1 % | - | - | 1 W | R_1206_3216Metric_Kelvin | nubm44:R_1206_3216Metric_Kelvin | ~ | DigiKey | MCS1632R010FER | UNKNOWN | UNKNOWN | 2026-10-24 | PARTIAL | RALEC LR1206-21R010F4
evaluation-board | U2 | 1 | Texas Instruments | INA186A2IDCKR | INA186A2 | gain +-1 %, VOS +-50 uV | VS 1.7-5.5 V, VCM -0.2..40 V | - | - | SOT-363_SC-70-6 | Package_TO_SOT_SMD:SOT-363_SC-70-6 | https://www.ti.com/lit/ds/symlink/ina186.pdf | LCSC | C2058238 | 9836 | 1+: $0.8667 / 10+: $0.691 | 2026-10-24 | YES | Texas Instruments INA186A3IDCKR
evaluation-board | R8 | 1 | Yageo | RT0402BRD078K66L | 8.66k | +-0.1 %, 25 ppm/K | 50 V | - | 1/16 W | R_0402_1005Metric | Resistor_SMD:R_0402_1005Metric | ~ | UNKNOWN | UNKNOWN | UNKNOWN | UNKNOWN | - | NO | - | commodity part: supplier data not verified, choose an equivalent at order time
evaluation-board | R9 | 1 | Yageo | RT0402BRD0710KL | 10.0k | +-0.1 %, 25 ppm/K | 50 V | - | 1/16 W | R_0402_1005Metric | Resistor_SMD:R_0402_1005Metric | ~ | UNKNOWN | UNKNOWN | UNKNOWN | UNKNOWN | - | NO | - | commodity part: supplier data not verified, choose an equivalent at order time
evaluation-board | D1 | 1 | Nexperia | PMEG4010CEJ,115 | PMEG4010CEJ | - | 40 V | 1 A | - | D_SOD-323F | Diode_SMD:D_SOD-323F | ~ | LCSC | C50704 | 16100 | 5+: $0.3702 / 50+: $0.2953 | 2026-10-24 | PARTIAL | -
evaluation-board | U3 | 1 | Microchip | ATTINY1616-MNR | ATtiny1616-MNR | - | 1.8-5.5 V | - | - | VQFN-20-1EP_3x3mm_P0.4mm_EP1.7x1.7mm | Package_DFN_QFN:VQFN-20-1EP_3x3mm_P0.4mm_EP1.7x1.7mm | https://ww1.microchip.com/downloads/en/DeviceDoc/ATtiny1614-16-17-DataSheet-DS40002204A.pdf | LCSC | C507118 | 3507 | 1+: $1.0962 / 10+: $0.908 | 2026-10-24 | YES | -
evaluation-board | D2 | 1 | onsemi | RB521S30T1G | RB521S30 | - | 30 V | 200 mA | - | D_SOD-523 | Diode_SMD:D_SOD-523 | ~ | UNKNOWN | UNKNOWN | UNKNOWN | UNKNOWN | - | NO | - | commodity part: supplier data not verified, choose an equivalent at order time
evaluation-board | R13 | 1 | Yageo | RC0402FR-0720KL | 20k | +-1 % | 50 V | - | 1/16 W | R_0402_1005Metric | Resistor_SMD:R_0402_1005Metric | ~ | UNKNOWN | UNKNOWN | UNKNOWN | UNKNOWN | - | NO | - | commodity part: supplier data not verified, choose an equivalent at order time
evaluation-board | RT1 | 1 | Murata | NCP15XH103F03RC | 10k | +-1 %, B 3380 K | - | - | - | R_0402_1005Metric | Resistor_SMD:R_0402_1005Metric | ~ | LCSC | C77131 | 297300 | 50+: $0.0196 / 500+: $0.0157 | 2026-10-24 | PARTIAL | -
evaluation-board | R14,R15 | 2 | Yageo | RC0402FR-0710KL | 10k | +-1 % | 50 V | - | 1/16 W | R_0402_1005Metric | Resistor_SMD:R_0402_1005Metric | ~ | UNKNOWN | UNKNOWN | UNKNOWN | UNKNOWN | - | NO | - | commodity part: supplier data not verified, choose an equivalent at order time
evaluation-board | R16 | 1 | Yageo | RC0402FR-07220RL | 220 | +-1 % | 50 V | - | 1/16 W | R_0402_1005Metric | Resistor_SMD:R_0402_1005Metric | ~ | UNKNOWN | UNKNOWN | UNKNOWN | UNKNOWN | - | NO | - | commodity part: supplier data not verified, choose an equivalent at order time
evaluation-board | Q4,Q5,Q6 | 3 | Diodes Incorporated | DMG1012T-7 | DMG1012T | - | 20 V | 0.63 A | - | SOT-523 | Package_TO_SOT_SMD:SOT-523 | ~ | LCSC | C20512 | 124900 | 5+: $0.1019 / 50+: $0.0837 | 2026-10-24 | YES | -
evaluation-board | R19 | 1 | Yageo | RC0402FR-0747KL | 47k | +-1 % | 50 V | - | 1/16 W | R_0402_1005Metric | Resistor_SMD:R_0402_1005Metric | ~ | UNKNOWN | UNKNOWN | UNKNOWN | UNKNOWN | - | NO | - | commodity part: supplier data not verified, choose an equivalent at order time
evaluation-board | D3 | 1 | Nexperia | BZX585-C6V2 | 6.2V | +-5 % | 6.2 V Zener | - | 300 mW | D_SOD-523 | Diode_SMD:D_SOD-523 | ~ | UNKNOWN | UNKNOWN | UNKNOWN | UNKNOWN | - | NO | - | commodity part: supplier data not verified, choose an equivalent at order time
