djgringoboy2003/Nub44-driver/documentation/T-1K2W1137524A-5units-BOM_PCBWay_template(2026-10-28).xls

PCBWay Bom Quotation, Product No.:T-1K2W1137524A
Item # | *Designator | *Qty | Manufacturer | *Mfg Part # | Description / Value | *Package/Footprint | Mounting Type | Your Instructions / Notes | *Unit Price(5 units) | *Total | *Delivery Time | *PCBWay Note | Customer Reply | PCBWay Update
1 | U3 | 1 | Microchip | ATTINY1616-MNR | ATtiny1616-MNR - 8-bit MCU, 16 KB, VQFN-20 3x3 | VQFN-20-1EP_3x3mm_P0.4mm_EP1.7x1.7mm | SMD |  | $1.208 | $6.040
2 | D3 | 1 | Nexperia | BZX585-C6V2 | 6.2V - 6.2 V Zener SOD-523, OV backstop threshold | D_SOD-523 | SMD |  | $0.201 | $1.005
3 | C4,C5,C6,C14,C15,C17 | 6 | Samsung | CL05B104KO5NNNC | 100n - 100 nF 16 V X7R 0402 input HF decoupling; 100 nF 16 V X7R 0402 BOOT1; 100 nF 16 V X7R 0402 BOOT2; 100 nF 16 V X7R 0402 output HF; 100 nF 16 V X7R 0402 U2 supply; 100 nF 16 V X7R 0402 MCU decoupling | C_0402_1005Metric | SMD |  | $0.008 | $0.240
4 | C8 | 1 | Samsung | CL05B563KO5NNNC | 56n - 56 nF 16 V X7R 0402 compensation Cc | C_0402_1005Metric | SMD |  | $0.263 | $1.315
5 | C7,C16 | 2 | Samsung | CL10A106KP8NNNC | 10u - 10 uF 10 V X5R 0603 VCC (> 4.7 uF required); 10 uF 10 V X5R 0603 MCU hold-up | C_0603_1608Metric | SMD |  | $0.081 | $0.810
6 | C1,C2,C3,C10,C11,C12,C13 | 7 | Samsung | CL21A226MOQNNNE | 22u - 22 uF 16 V X5R 0805 input; 22 uF 16 V X5R 0805 output | C_0805_2012Metric | SMD |  | $0.306 | $10.710
7 | Q4,Q5,Q6 | 3 | Diodes Incorporated | DMG1012T-7 | DMG1012T - N-MOSFET 20 V SOT-523; MCU enable (on = converter off); N-MOSFET 20 V SOT-523; interlock open = converter off; N-MOSFET 20 V SOT-523; over-voltage backstop | SOT-523 | SMD |  | $0.193 | $2.895
8 | C9 | 1 | Murata | GRM1555C1H681JA01D | 680p - 680 pF 50 V C0G 0402 compensation Cp | C_0402_1005Metric | SMD |  | $0.263 | $1.315
9 | U2 | 1 | Texas Instruments | INA186A2IDCKR | INA186A2 - Current-sense amplifier G = 50, SC70-6 | SOT-363_SC-70-6 | SMD |  | $1.087 | $5.435
10 | RS1 | 1 | Ohmite | MCS1632R010FER | 10m - 10 mOhm 1% 1 W 1206 current shunt; Kelvin sense pads 2/3 via footprint net tie | R_1206_3216Metric_Kelvin | SMD |  | $1.087 | $5.435
11 | RT1 | 1 | Murata | NCP15XH103F03RC | 10k - NTC 10 kOhm 1% B25/50 3380 K, board temperature | R_0402_1005Metric | SMD |  | $0.201 | $1.005
12 | D1 | 1 | Nexperia | PMEG4010CEJ,115 | PMEG4010CEJ - 40 V 1 A Schottky, reverse/ESD clamp across laser output | D_SOD-323F | SMD |  | $1.208 | $6.040
13 | D2 | 1 | onsemi | RB521S30T1G | RB521S30 - 30 V 200 mA Schottky SOD-523, MCU supply isolation (hold-up) | D_SOD-523 | SMD |  | $0.201 | $1.005
14 | R1,R10,R11,R12,R17,R18 | 6 | Yageo | RC0402FR-07100KL | 100k - 100 kOhm 1% 0402; Q1 gate to GND; 100 kOhm 1% VBAT sense top; 100 kOhm 1% VBAT sense bottom; 100 kOhm 1% VOUT sense top (VOUT/6); 100 kOhm 1% Q4 gate pull-up (default off); 100 kOhm 1% interlock pull-up to VBAT | R_0402_1005Metric | SMD |  | $0.005 | $0.150
15 | R14,R15 | 2 | Yageo | RC0402FR-0710KL | 10k - 10 kOhm 1% NTC bias (board); 10 kOhm 1% NTC bias (external laser NTC) | R_0402_1005Metric | SMD |  | $0.008 | $0.080
16 | R4 | 1 | Yageo | RC0402FR-071K2L | 1.2k - 1.2 kOhm 1% 0402 compensation Rc | R_0402_1005Metric | SMD |  | $0.026 | $0.130
17 | R13 | 1 | Yageo | RC0402FR-0720KL | 20k - 20 kOhm 1% VOUT sense bottom | R_0402_1005Metric | SMD |  | $0.007 | $0.035
18 | R16 | 1 | Yageo | RC0402FR-07220RL | 220 - 220 Ohm 1% indicator LED series | R_0402_1005Metric | SMD |  | $0.017 | $0.085
19 | R3 | 1 | Yageo | RC0402FR-0727K4L | 27.4k - 27.4 kOhm 1% 0402 ILIM (12.0 A typ avg) | R_0402_1005Metric | SMD |  | $0.032 | $0.160
20 | R2,R6 | 2 | Yageo | RC0402FR-0733K2L | 33.2k - 33.2 kOhm 1% 0402 FSW (595 kHz); 33.2 kOhm 1% 0402 EN/UVLO bottom | R_0402_1005Metric | SMD |  | $0.019 | $0.190
21 | R19 | 1 | Yageo | RC0402FR-0747KL | 47k - 47 kOhm 1% interlock sense to MCU | R_0402_1005Metric | SMD |  | $0.018 | $0.090
22 | R5 | 1 | Yageo | RC0402FR-0749K9L | 49.9k - 49.9 kOhm 1% 0402 EN/UVLO top (3.08/2.83 V) | R_0402_1005Metric | SMD |  | $0.014 | $0.070
23 | R7,R20 | 2 | Yageo | RC0402FR-074K7L | 4.7k - 4.7 kOhm 1% 0402 output bleeder; 4.7 kOhm 1% Q6 gate pull-down | R_0402_1005Metric | SMD |  | $0.009 | $0.090
24 | R9 | 1 | Yageo | RT0402BRD0710KL | 10.0k - 10.0 kOhm 0.1% 0402 FB bottom | R_0402_1005Metric | SMD |  | $0.163 | $0.815
25 | R8 | 1 | Yageo | RT0402BRD076K65L | 6.65k - 6.65 kOhm 0.1% 0402 FB top; sets 4.0 A (3.5 A: 4.53k, 3.0 A: 2.49k) | R_0402_1005Metric | SMD |  | $0.126 | $0.630
26 | Q1 | 1 | Vishay | SISS23DN-T1-GE3 | SiSS23DN - P-MOSFET -20 V, 4.5/6.3 mOhm max @ -4.5/-2.5 V; reverse-polarity protection | Vishay_PowerPAK_1212-8_Single | SMD |  | $1.691 | $8.455
27 | Q2,Q3 | 2 | Vishay | SISS80DN-T1-GE3 | SiSS80DN - N-MOSFET 20 V, 1.15 mOhm max @ 4.5 V; buck-leg high side; N-MOSFET 20 V, 1.15 mOhm max @ 4.5 V; buck-leg low side | Vishay_PowerPAK_1212-8_Single | SMD |  | $2.435 | $24.350
28 | U1 | 1 | Texas Instruments | TPS552882RPMR | TPS552882 - Buck-boost converter, external buck FETs, VQFN-HR-26 | TI_RPM0026A_VQFN-HR-26_4x3.5mm_P0.5mm | SMD |  | $8.855 | $44.275 |  | [Price is changing higher, final price should be subjected to the real price when order!]
29 | J1 | 1 | UNKNOWN | UNKNOWN | B+ spring - Battery centre spring (B+), hand-soldered after assembly; select to suit host | Wire_Pad_PTH_D1.3mm | DNS | Do not place: customer fits the battery spring by hand |  |  |  | [DNS/Do not place] components[DNP ];
30 | L1 | 1 | Coilcraft | XGL5030-102MEC | 1.0u - 1.0 uH 4.8/5.8 mOhm, Isat 10.2 A (20%) / 14 A (30%); XGL5030 uses the XAL5030 land pattern (verify) | L_Coilcraft_XAL5030-XXX | SMD |  | $25.358 | $126.790
 |  |  |  |  |  |  |  |  | Component Cost | $249.65
 |  |  |  |  |  |  |  |  | Assembly Cost | $29.00
 |  |  |  |  |  |  |  |  | PCB Cost | $25.97
 |  |  |  |  |  |  |  |  | All Total 5 Units | $304.62
