djgringoboy2003/Nub44-driver/manufacturing/pcbway/compact-22mm/REVIEW_ONLY.md

# DRAFT - review only

## INCOMPLETE BOARD - DO NOT FABRICATE

The board is not complete: 20 unconnected items, 0 DRC errors, 0 parity issues.
The fabrication ZIP carries `DO_NOT_FABRICATE.txt`. These files are for layout review only.

This package has not been released for manufacturing.
`reports/export-check.json` checks exported file completeness and consistency; it does not close a release gate.
Review the project's current `reports/validation-register.md` and `reports/release-readiness.md` before
ordering a prototype: a prototype needs the PROTOTYPE_CANDIDATE level (complete CAD, current evidence and
the recorded human reviews). A production release additionally needs the Gate G bench results from an
assembled prototype and a signed approval. This tool does not place manufacturing orders.
