djgringoboy2003/Nub44-driver/research/sources/manufacturing-sources.md

# Manufacturing and CAD-tooling source index

This index covers the sources cited in `research/pcbway-requirements.md` and
`research/cad-tooling.md`. All sources were retrieved on 2026-10-24 by the manufacturing/CAD
research agent.

- Local copies sit under `research/datasheets/`, relative to the project root, with the `mfg_` prefix.
- Text copies (`*.txt`) were extracted from the HTML: navigation and footer were trimmed, and images are referenced by URL.
- Most PCBWay pages show no revision date (footer "© 2024 PCBWay"). They are listed as "undated".

| ID | Title | Publisher | URL | Document revision/date | Retrieved | Local copy path | Relevant sections | Primary/Secondary |
|---|---|---|---|---|---|---|---|---|
| MFG-01 | PCB Capabilities (Standard PCB + Advanced PCB tables) | PCBWay | https://www.pcbway.com/capabilities.html | undated | 2026-10-24 | research/datasheets/mfg_pcbway_capabilities_2026-10-24.txt | Standard table (layers, thickness, trace/space, copper, drill, annular ring, silkscreen, finishes, panelization); Advanced items 5–36 (drill vs thickness, weld ring, width/spacing per Cu, line-to-edge, solder mask bridge/opening, plugging, castellation, plating, min thickness, min finished size, HASL) | Primary |
| MFG-02 | PCB Assembly Capability | PCBWay | https://www.pcbway.com/assembly-capabilities.html | undated | 2026-10-24 | research/datasheets/mfg_pcbway_assembly-capabilities_2026-10-24.txt | Items 1–12: lead time, parts source, min order, component size, board dimension/shape, testing | Primary |
| MFG-03 | PCB Assembly Special Reminders | PCBWay | https://www.pcbway.com/assembly-special-remind.html | undated | 2026-10-24 | research/datasheets/mfg_pcbway_assembly-special-reminders_2026-10-24.txt | 1. Parts Overages; 2. Panelization (<50×100 mm or circular → panelize); 3. Break-away rails (3.5 mm rule) | Primary |
| MFG-04 | Panel Requirements for Assembly | PCBWay | https://www.pcbway.com/pcb_prototype/Panel_Requirements_for_Assembly.html | undated | 2026-10-24 | research/datasheets/mfg_pcbway_panel-requirements-for-assembly_2026-10-24.txt; research/datasheets/mfg_pcbway_panel-fiducials_image.jpg; research/datasheets/mfg_pcbway_panel-mounting-holes_image.jpg | Panel size 50×50–330×530 mm; V-score/tab/stamp holes; fiducials; mounting (tooling) holes, with dimensions in the images | Primary |
| MFG-05 | Assembly File Requirements | PCBWay | https://www.pcbway.com/assembly-file-requirements.html | undated | 2026-10-24 | research/datasheets/mfg_pcbway_assembly-file-requirements_2026-10-24.txt | BOM formats/fields (kitted vs turnkey); Centroid definition; Gerber RS-274X; minimum 3 layers for PCBA | Primary |
| MFG-06 | SMT Ordering Necessary Files & Info | PCBWay | https://www.pcbway.com/smt_ordering_guide.html | undated | 2026-10-24 | research/datasheets/mfg_pcbway_smt-ordering-guide_2026-10-24.txt | BOM must-haves; pick&place designator matching; polarity marking | Primary |
| MFG-07 | Sample BOM template "Sample_BOM_PCBWay.xlsx" | PCBWay | https://www.pcbway.com/img/images/pcbway/Sample_BOM_PCBWay.xlsx?v=1.1 | file, no revision (linked as v=1.1) | 2026-10-24 | research/datasheets/mfg_pcbway_Sample_BOM_PCBWay.xlsx | Sheet1 row 6 header; Type values SMD/DNS/thru-hole | Primary |
| MFG-08 | Sample centroid file "a-sample-of-PCBWay-Centroid-File.txt" | PCBWay | https://www.pcbway.com/img/images/pcbway/a-sample-of-PCBWay-Centroid-File.txt | file, no revision | 2026-10-24 | research/datasheets/mfg_pcbway_sample_centroid_file.txt | Header line; units (mil); TB; rotation | Primary |
| MFG-09 | PCB Assembly FAQ | PCBWay | https://www.pcbway.com/assembly-faq.html | undated | 2026-10-24 | research/datasheets/mfg_pcbway_assembly-faq_2026-10-24.txt | Q3 files; Q4 centroid; Q10 pricing; Q11 turn-time; Q13–14 panelization/rails; Q17 turnkey time | Primary |
| MFG-10 | PCB Assembly service page / instant quote form | PCBWay | https://www.pcbway.com/pcb-assembly.html | undated (live page) | 2026-10-24 | research/datasheets/mfg_pcbway_pcb-assembly-quote-page_2026-10-24.txt | Quote inputs; stencil prices; "PCBA lead time 3-5 days"; "$29 /20 pcs"; "Gerber RS-274X"; layer-order field | Primary |
| MFG-11 | Blog: "How to Get $29 PCB Assembly and Meet the Requirements" (author: Mila) | PCBWay | https://www.pcbway.com/blog/PCB_Assembly/How_to_Get_29_PCB_Assembly_and_Meet_the_Requirements_e334dbde.html | Oct 21, 2026 | 2026-10-24 | research/datasheets/mfg_pcbway_blog_29usd-pcba-requirements_2026-10-21.txt | Eligibility limits; usage limits; FAQ | Primary (vendor blog) |
| MFG-12 | Multi-layer laminated structure (PCB standard stackup) | PCBWay | https://www.pcbway.com/multi-layer-laminated-structure.html | undated | 2026-10-24 | research/datasheets/mfg_pcbway_4layer-stackups_2026-10-24.txt (parsed extract of 43 server-rendered 4-layer entries) | 4-layer stack-ups by thickness / Cu / residual Cu ratio | Primary |
| MFG-13 | PCB Via-in-Pad | PCBWay | https://www.pcbway.com/pcb_prototype/PCB_Via_in_Pad.html | undated | 2026-10-24 | research/datasheets/mfg_pcbway_via-in-pad_2026-10-24.txt | Resin fill + plated cap; cost/time disadvantages | Primary |
| MFG-14 | PCB Via Covering | PCBWay | https://www.pcbway.com/pcb_prototype/PCB_Via_Covering.html | undated | 2026-10-24 | research/datasheets/mfg_pcbway_via-covering_2026-10-24.txt | IPC-4761 types I–VII; tenting ≤0.3 mm; plugging ~0.4–0.5 mm | Primary |
| MFG-15 | PCB Side Plating | PCBWay | https://www.pcbway.com/pcb_prototype/PCB_Sideplating.html | undated | 2026-10-24 | research/datasheets/mfg_pcbway_sideplating_2026-10-24.txt | Overlap 0.5 mm; 0.3 mm connection; 0.8 mm non-connection; no V-score; finish | Primary |
| MFG-16 | Plated Half-Holes (Castellated Holes) | PCBWay | https://www.pcbway.com/pcb_prototype/What_are_Plated_Half_Holes_Castellated_Holes_.html | undated | 2026-10-24 | research/datasheets/mfg_pcbway_plated-half-holes_2026-10-24.txt | Design rules (0.4/0.6 mm, 0.55 mm spacing, 0.1 mm mask bridge); thickness table | Primary |
| MFG-17 | "How to Generate Gerber and Drill Files in KiCad 8.0?" | PCBWay Help Center | https://www.pcbway.com/helpcenter/technical_support/Generate_Gerber_file_from_Kicad.html (also /helpcenter/generate_gerber/Generate_Gerber_file_from_Kicad.html) | "Last updated on 26/06/2024" | 2026-10-24 | research/datasheets/mfg_pcbway_kicad8-gerber-guide_2026-10-24.txt; research/datasheets/mfg_pcbway_kicad8-guide_plot-dialog.png; research/datasheets/mfg_pcbway_kicad8-guide_drill-dialog.png | Plot dialog settings (layers, X2 off, 4.6 mm, tent vias); drill dialog settings (Excellon mm decimal, separate PTH/NPTH, route oval holes) | Primary |
| MFG-18 | "How to Export Gerber, Drill Files, BOM, and Pick-and-Place Files in KiCad 9.0" | PCBWay Help Center | https://www.pcbway.com/helpcenter/generate_gerber/How_to_Export_Gerber__BOM__and_Pick_and_Place_Files_in_KiCad_9_0.html | "Last updated on 11/09/2025" | 2026-10-24 | research/datasheets/mfg_pcbway_kicad9-export-guide_2026-10-24.txt; research/datasheets/mfg_pcbway_kicad9-guide_plot-dialog.png; research/datasheets/mfg_pcbway_kicad9-guide_drill-dialog.png; research/datasheets/mfg_pcbway_kicad9-guide_placement-dialog.png | Plot/drill/placement dialogs (CSV, mm); BOM via symbol fields table | Primary |
| MFG-19 | PCBWay Fabrication Toolkit for KiCad, plugin source | PCBWay (GitHub org "pcbway") | https://github.com/pcbway/PCBWay-Fabrication-Toolkit-for-KiCad | v1.0.5 (release 2026-03-31), commit 4c0f2dd6618ae092fdd9a3c27bc895165c50a548 | 2026-10-24 | research/datasheets/mfg_pcbway-fabrication-toolkit-v1.0.5_process.py.txt; …_config.py.txt; …_utils.py.txt; …_thread.py.txt | process.py get_components_file (BOM + positions CSV), get_gerber_file, get_netlist_file (drill + IPC-D-356); utils.py MPN/package/DNP keys | Primary |
| MFG-20 | PCBWay Plug-in for KiCad, plugin source + README | PCBWay (GitHub org "pcbway") | https://github.com/pcbway/PCBWay-Plug-in-for-Kicad | v1.0.5 (release 2026-03-31), HEAD commit d15ae6924e145f8a1f3a2f2e7e88df3fc93eb114 | 2026-10-24 | research/datasheets/mfg_pcbway-plugin-for-kicad-v1.0.5_process.py.txt; …_config.py.txt; …_thread.py.txt | README "About Bom"; config.py file names; thread.py upload endpoint | Primary |
| MFG-21 | pcbnew/exporters/place_file_exporter.cpp | KiCad project (GitLab) | https://gitlab.com/kicad/code/kicad/-/raw/10.0.6/pcbnew/exporters/place_file_exporter.cpp | tag 10.0.6 | 2026-10-24 | research/datasheets/mfg_kicad-10.0.6_place_file_exporter.cpp.txt | CSV header "Ref,Val,Package,PosX,PosY,Rot,Side"; Y sign; side names | Primary |
| MFG-22 | KiCad 10.0 Command-Line Interface reference | KiCad documentation | https://docs.kicad.org/10.0/en/cli/cli.html | 10.0 docs as served on retrieval date | 2026-10-24 | none (lead engineer verifying CLI locally) | "PCB export: position file" (units default in); "PCB import" formats | Primary |
| MFG-23 | KLC F4.2 "Pin 1 should be located at the top left"; KLC F6.2 "Footprint anchor should be placed in the middle of the component body" | KiCad Library Convention (GitLab kicad/libraries/klc) | https://gitlab.com/kicad/libraries/klc/-/raw/master/content/footprint/F4/F4.2.adoc ; https://gitlab.com/kicad/libraries/klc/-/raw/master/content/footprint/F6/F6.2.adoc | F4.2 last commit 27b7ea9bb4 (2026-01-30) | 2026-10-24 | none | Rule text (IPC-7351 pin-1 top-left; anchor at body centroid) | Primary |
| MFG-24 | "Generating PCB production files with kicad-cli" (project log, Vertical LED digit display boards) | Ken Yap, hackaday.io | https://hackaday.io/project/205732-vertical-led-digit-display-boards/log/247882-generating-pcb-production-files-with-kicad-cli | 2026-05-17 | 2026-10-24 | none | Makefile kicad-cli commands; sed header rename "Designator,Value,Footprint,Mid X,Mid Y,Rotation,TB"; PCBWay acceptance anecdote | Secondary |
| MFG-25 | InteractiveHtmlBom: releases, wiki "Usage", source (core/config.py, compat.py, ecad/__init__.py, ecad/kicad.py), PyPI | openscopeproject (GitHub); PyPI | https://github.com/openscopeproject/InteractiveHtmlBom/releases ; https://github.com/openscopeproject/InteractiveHtmlBom/wiki/Usage ; https://pypi.org/project/InteractiveHtmlBom/ | v2.12.0 (2026-09-10); master d1eb5b79a5 (2026-10-17) | 2026-10-24 | none | Release notes v2.11.0–v2.12.0 (KiCad 10); "Standalone script" (Windows: KiCad's bundled python); CLI options; INTERACTIVE_HTML_BOM_NO_DISPLAY | Primary |
| MFG-26 | Freerouting: v2.5.0 release notes; README; build.gradle; docs/command_line_arguments.md; docs/settings.md; integrations/KiCad README.md + metadata.json; src (GlobalSettings.java, FreeroutingCli.java, Freerouting_en.properties) | Freerouting project (GitHub) | https://github.com/freerouting/freerouting/releases/tag/v2.5.0 ; https://github.com/freerouting/freerouting/tree/v2.5.0 | v2.5.0 (published 2026-10-05) | 2026-10-24 | none | Java 25 requirement; native CLI assets + SHA-256; KiCad IPC mode / DSN fallback; breaking changes (-us/-is/-hr); copper-to-edge 250 µm | Primary |
| MFG-27 | "PCB Python Bindings" (SWIG) | KiCad Developer Documentation | https://dev-docs.kicad.org/en/apis-and-binding/pcbnew/index.html | as served on retrieval date | 2026-10-24 | none | "deprecated as of KiCad 9.0"; "plan is to remove the SWIG bindings in KiCad 11.0"; standalone use | Primary |
| MFG-28 | pcbnew/python/scripting/pcbnew_scripting_helpers.h | KiCad project (GitLab) | https://gitlab.com/kicad/code/kicad/-/raw/10.0.6/pcbnew/python/scripting/pcbnew_scripting_helpers.h | tags 10.0.6 and 10.0.7 (identical) | 2026-10-24 | none | ExportSpecctraDSN(BOARD*, path) / ImportSpecctraSES(BOARD*, path) standalone overloads | Primary |
| MFG-29 | "Import KiCad" (EasyEDA Pro User Guide) | EasyEDA | https://prodocs.easyeda.com/en/import-export/import-kicad/ | "Last updated:" blank; footer © 2026 | 2026-10-24 | research/datasheets/mfg_easyeda-pro_import-kicad_2026-10-24.txt | "EasyEDA Pro supports importing files from KiCad versions below 10.0."; packaging; copper rebuild | Primary |
| MFG-30 | KiCad blog: release announcements (10.0.0 on 2026-03-20; 10.0.6 on 2026-08-29; 10.0.7 on 2026-10-07; 10.0.8-rc1 on 2026-10-22) | KiCad project | https://www.kicad.org/blog/ ; https://www.kicad.org/blog/2026/03/Version-10.0.0-Released/ ; https://www.kicad.org/blog/2026/10/KiCad-10.0.7-Release/ | posts dated as listed | 2026-10-24 | none | Version/date list | Primary |
| MFG-31 | KiCad 9.0 Command-Line Interface reference (for 9 vs 10 comparison) | KiCad documentation | https://docs.kicad.org/9.0/en/cli/cli.html | 9.0 docs as served on retrieval date | 2026-10-24 | none | Usage lines (no `pcb import`, `pcb upgrade`, `sch upgrade`, `pcb export stats` in 9.0) | Primary |
| MFG-32 | "Import KiCAD" (EasyEDA Standard docs) | EasyEDA | https://docs.easyeda.com/en/Import/Import-KiCAD | undated | 2026-10-24 (search-result snippet only; page not opened) | none | "KiCAD v4.06 and greater"; format change since v5.1.3 | Secondary |
| MFG-33 | "What files are requested for assembly production?" (PCBWay help, .ru mirror) | PCBWay | https://www.pcbway.ru/helpcenter/pcb_assembly_ordering/What_files_are_requested_for_assembly_production_.html | undated | 2026-10-24 (search-result snippet only; page not opened, UNVERIFIED) | none | Centroid as Excel/.txt/.pos, units mm | Secondary |
