djgringoboy2003/Nub44-driver/manufacturing/budget-2s/drawings/render_bottom.png

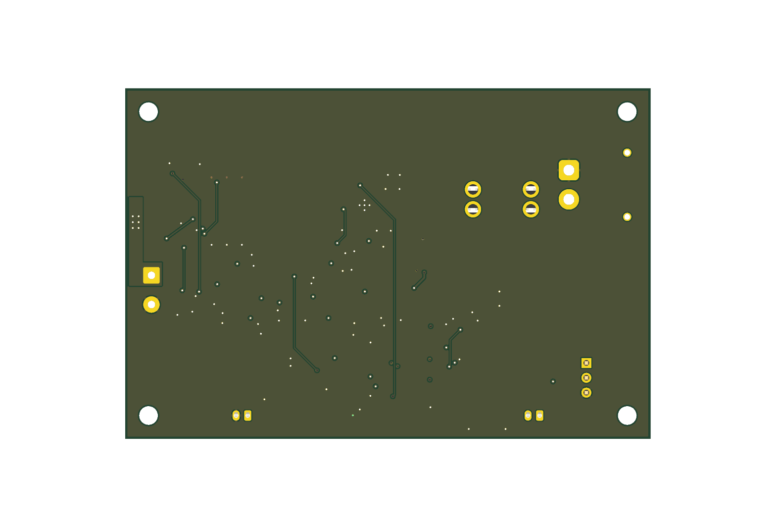
manufacturing/budget-2s/drawings/render_bottom.png
