djgringoboy2003/Nub44-driver/manufacturing/pcbway/compact-22mm/drawings/render_top.png

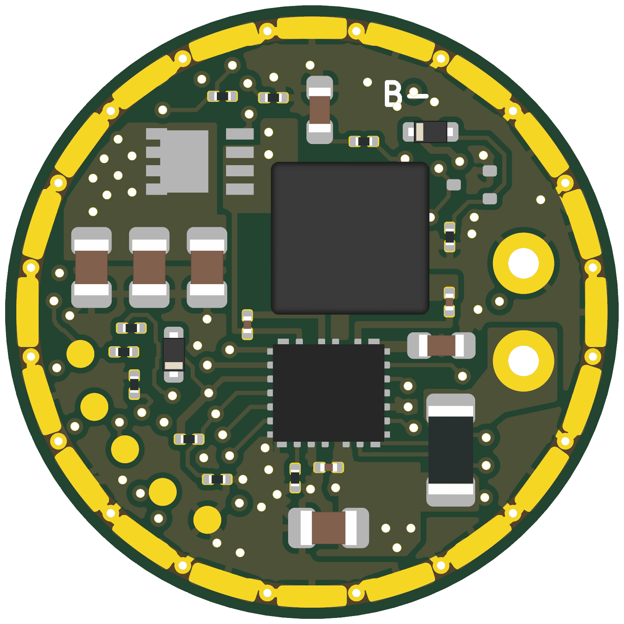
manufacturing/pcbway/compact-22mm/drawings/render_top.png
