djgringoboy2003/Nub44-driver/reports/validation-register.md

# Validation register

Generated by `automation/validation/validate.py` on 2026-10-29.
Statuses come from tool reports and hash-bound evidence; none are hard-coded. Calculations and simulations
are predictions; only Gate G evidence is measured on hardware.

## Release gates

| Gate | Status | Evidence class |
|---|---|---|
| A | PASS | documents present (inspection) |
| B | PASS | KiCad ERC and netlist comparison |
| C | PASS | model-level predictions (averaged ngspice model); not measurements |
| D (compact-22mm) | OPEN | KiCad DRC connectivity |
| E (compact-22mm) | OPEN | KiCad ERC/DRC |
| F (compact-22mm) | OPEN | export package internal consistency; not a manufacturing release (see release readiness) |
| D (evaluation-board) | PASS | KiCad DRC connectivity |
| E (evaluation-board) | PASS | KiCad ERC/DRC |
| F (evaluation-board) | PASS | export package internal consistency; not a manufacturing release (see release readiness) |
| G | OPEN: requires assembled-prototype testing (no bench records yet; cannot be closed by software) | bench measurements on assembled prototypes only |

## Board readiness

| Variant | Level | Blockers to the next level |
|---|---|---|
| compact-22mm | **DRAFT_REVIEW** | 7 for PROTOTYPE_CANDIDATE |
| evaluation-board | **DRAFT_REVIEW** | 2 for PROTOTYPE_CANDIDATE |

Details: [release-readiness.md](release-readiness.md).

## Known limitations and open findings

Listed in `engineering/known-limitations.yaml`. They remain FAIL below; the validator's exit code only ignores them while they are unchanged.

| ID | Category | Status | Reason |
|---|---|---|---|
| VAL-ROUTE-compact-22mm | accepted | FAIL | Compact 22 mm board parked as a routing draft until evaluation bench data exists |
| VAL-DRC-compact-22mm | accepted | FAIL | Dangling vias of the 20 open nets on the parked compact draft |

## Register

| ID | Item | Method | Status | Evidence | Detail |
|---|---|---|---|---|---|
| VAL-A1 | Research and requirement documents present | INSPECT | **PASS** | research/nubm44-research.md, research/converter-ic-research.md, research/component-research.md, ... |  |
| VAL-CALC-EVID | Calculation evidence current (hashes of parameters, script and model code) | CALC | **PASS** | engineering/calculations/power-stage-evidence.json | 21 checks; python 3.11.5, numpy 2.4.6 |
| VAL-CALC-01 | Current setpoint worst-case tolerance | CALC | **PASS** | engineering/calculations/power-stage-results.md | 3.5789 % (limit max 5.0) |
| VAL-CALC-02 | Nominal setpoint error | CALC | **PASS** | engineering/calculations/power-stage-results.md | 0.48 % (limit max 0.5) |
| VAL-CALC-03 | Backup current limit minimum above setpoint (no interference) | CALC | **PASS** | engineering/calculations/power-stage-results.md | 4.8 A (limit min 4.661051848874599) |
| VAL-CALC-04 | Average inductor current vs ILIM minimum (20 % margin) | CALC | **PASS** | engineering/calculations/power-stage-results.md | 10.2907 A (limit max 11.238554216867469) |
| VAL-CALC-05 | Peak inductor current vs Isat (30 % drop rating) | CALC | **PASS** | engineering/calculations/power-stage-results.md | 9.6739 A (limit max 14.0) |
| VAL-CALC-06 | Inductor RMS current vs Irms (20 C rise) | CALC | **PASS** | engineering/calculations/power-stage-results.md | 8.599 A (limit max 12.8) |
| VAL-CALC-07 | Efficiency at 4.0 V, typical diode (REQ-PWR-02 target >= 93 %, owner deviations DD-26/DD-37) | CALC | **PASS** | engineering/calculations/power-stage-results.md | 94.1015 % (limit min 93.0) |
| VAL-CALC-08 | Efficiency at 3.0 V, worst diode corner (REQ-PWR-03 target >= 86 %) | CALC | **PASS** | engineering/calculations/power-stage-results.md | 90.2736 % (limit min 86.0) |
| VAL-CALC-09 | Boost off-time vs minimum off-time | CALC | **PASS** | engineering/calculations/power-stage-results.md | 881.9271 ns (limit min 145.0) |
| VAL-CALC-10 | Reverse-polarity FET dissipation (worst point) | CALC | **PASS** | engineering/calculations/power-stage-results.md | 0.6842 W (limit max 0.7) |
| VAL-CALC-11 | Shunt dissipation vs 50 % of rating | CALC | **PASS** | engineering/calculations/power-stage-results.md | 0.2025 W (limit max 0.5) |
| VAL-CALC-12 | TPS552882 junction estimate at 50 C board (60 K/W assumed) | CALC | **PASS** | engineering/calculations/power-stage-results.md | 110.8909 C (limit max 125) |
| VAL-CALC-13 | Hardware UVLO falling threshold >= 2.80 V cell floor | CALC | **PASS** | engineering/calculations/power-stage-results.md | 2.8292 V (limit min 2.8) |
| VAL-CALC-14 | Hardware UVLO falling threshold below firmware cut-off | CALC | **PASS** | engineering/calculations/power-stage-results.md | 2.8292 V (limit max 2.85) |
| VAL-CALC-15 | OV backstop trip (min) above normal maximum output | CALC | **PASS** | engineering/calculations/power-stage-results.md | 6.39 V (limit min 5.364) |
| VAL-CALC-16 | Laser current ripple (p-p) as % of setpoint | CALC | **PASS** | engineering/calculations/power-stage-results.md | 9.1683 % (limit max 10.0) |
| VAL-CALC-17 | Output capacitor RMS current per capacitor | CALC | **PASS** | engineering/calculations/power-stage-results.md | 1.0706 A (limit max 3.0) |
| VAL-CALC-18 | Current-loop phase margin (all corners) | CALC | **PASS** | engineering/calculations/power-stage-results.md | 108.3762 deg (limit min 50.0) |
| VAL-CALC-19 | Current-loop gain margin (all corners) | CALC | **PASS** | engineering/calculations/power-stage-results.md | 12.5126 dB (limit min 10.0) |
| VAL-CALC-20 | Crossover below RHP zero / 5 | CALC | **PASS** | engineering/calculations/power-stage-results.md | 2994.6662 Hz (limit max 9473.936582077467) |
| VAL-CALC-21 | Crossover below CSA bandwidth / 3 | CALC | **PASS** | engineering/calculations/power-stage-results.md | 2994.6662 Hz (limit max 12333.333333333334) |
| VAL-SIM-EVID | Simulation evidence current (hashes of parameters, script, calculation results) | SIM | **PASS** | simulation/results/evidence.json | 12 results; ngspice-47 : Circuit level simulation program |
| VAL-SIM-01 | Power-on, nominal battery 3.7 V, typical diode | SIM | **PASS** | simulation/results/results.md | {"steady_current_a": 4.479240753542249, "overshoot_pct": 0.00023138087570736106, "peak_a": 4.4792511176487295} |
| VAL-SIM-02 | Power-on at 3.15 V (just above the 3.08 V hardware UVLO), maximum-Vf diode | SIM | **PASS** | simulation/results/results.md | {"steady_current_a": 4.479136358584267, "overshoot_pct": 0.00021393842717597734, "peak_inductor_a": 7.32905692} |
| VAL-SIM-03 | Current regulation across battery 3.0-4.2 V and diode Vf corners (incl. Vf below Vbat) | SIM | **PASS** | simulation/results/results.md | {"3.0V_min": 4.4793, "3.0V_typ": 4.4793, "3.0V_max": 4.4793, "3.7V_min": 4.4789, "3.7V_typ": 4.4789, "3.7V_max": 4.4795, "4.2V_min": 4.4791, "4.2V_typ": 4.4791, |
| VAL-SIM-04 | Input voltage reduction (4.0 -> 3.2 V over 1 ms, 40 mOhm source) | SIM | **PASS** | simulation/results/results.md | {"max_current_deviation_pct": 3.5151738561281696} |
| VAL-SIM-05 | Load variation: diode Vf drops 0.15 V over 2 ms (faster than diode thermal time constants) | SIM | **PASS** | simulation/results/results.md | {"max_current_deviation_pct": 0.46176399999999046} |
| VAL-SIM-06 | Flash transitions at full battery 4.2 V with lowest-Vf diode (Vf < Vbat region) | SIM | **PASS** | simulation/results/results.md | {"peak_current_a": 4.478993818185457, "turn_off_to_50mA_s": 0.000491540700000001} |
| VAL-SIM-07 | Fault shutdown: interlock opens during emission | SIM | **PASS** | simulation/results/results.md | {"time_to_50mA_s": 6.491141000000006e-05} |
| VAL-SIM-08 | Output short-circuit (10 mOhm) during emission | SIM | **PASS** | simulation/results/results.md | {"peak_inductor_current_a": 13.4267273, "settled_output_current_a": 4.479239271217565} |
| VAL-SIM-09 | Open load (diode disconnected) during emission, hardware backstop only | SIM | **PASS** | simulation/results/results.md | {"peak_vout_v": 6.74087582} |
| VAL-SIM-10 | Reverse battery (-4.2 V): P-FET blocks (body diode reverse-biased, Vgs = 0) | SIM | **PASS** | simulation/results/results.md | {"reverse_current_a": 2.492341e-07, "vbat_node_v": -4.98468e-07} |
| VAL-SIM-11 | Current-loop gain by frequency-response analysis of the averaged deck (3.7 V typ, 3.0 V max-Vf, 4.2 V min-Vf), compared with the Python model | SIM | **PASS** | simulation/results/results.md | {"3.7V_typ_f_cross_hz": 2107.93, "3.7V_typ_phase_margin_deg": 117.38, "3.7V_typ_gain_margin_db": 13.19, "3.0V_max_f_cross_hz": 1339.08, "3.0V_max_phase_margin_d |
| VAL-SIM-12 | Loop sensitivity at 3.0 V, max-Vf diode: output capacitance (DC bias), inductance, error-amplifier gm, CSA bandwidth and the assumed inner-loop gain | SIM | **PASS** | simulation/results/results.md | {"min_phase_margin_deg": 106.34, "cases_passing": 11, "cases": 11} |
| VAL-SRC | Sourcing records current; package, voltage and power ratings consistent | INSPECT | **PASS** | sourcing/sourcing-check.md | 0 FAIL, 29 WARN, 72 INFO |
| VAL-ERC-compact-22mm | ERC (compact-22mm) | CAD | **PASS** | reports/erc-compact-22mm.json | 0 unresolved findings |
| VAL-NET-compact-22mm | Netlist equals connectivity.yaml (compact-22mm) | CAD | **PASS** | reports/schematic-compact-22mm.json | 0 differences |
| VAL-ROUTE-compact-22mm | PCB placed and fully routed (compact-22mm) | CAD | **FAIL** | reports/drc-compact-22mm.json | 20 unconnected items |
| VAL-PARITY-compact-22mm | PCB matches schematic (compact-22mm) | CAD | **PASS** | reports/drc-compact-22mm.json | 0 parity issues |
| VAL-DRC-compact-22mm | Unresolved DRC findings (compact-22mm) | CAD | **FAIL** | reports/drc-compact-22mm.json | 0 errors, 3 warnings, 0 exclusions {'via_dangling': 3}; ignored checks: tuning_profile_track_geometries (no track length tuning used; DD-20), lib_footprint_mismatch (density silkscreen removal; DD-20) |
| VAL-LAYOUT-compact-22mm | Power-layout review current for the board (compact-22mm) | CAD | **PASS** | reports/layout-review-compact-22mm.json | 14 REVIEW / 7 INFO screening results; dispositions in engineering/layout-review.md |
| VAL-EXPORT-compact-22mm | PCBWay export package internally consistent (compact-22mm) | CAD | **PASS** | manufacturing/pcbway/compact-22mm/reports/export-check.json |  |
| VAL-ERC-evaluation-board | ERC (evaluation-board) | CAD | **PASS** | reports/erc-evaluation-board.json | 0 unresolved findings |
| VAL-NET-evaluation-board | Netlist equals connectivity.yaml (evaluation-board) | CAD | **PASS** | reports/schematic-evaluation-board.json | 0 differences |
| VAL-ROUTE-evaluation-board | PCB placed and fully routed (evaluation-board) | CAD | **PASS** | reports/drc-evaluation-board.json | 0 unconnected items |
| VAL-PARITY-evaluation-board | PCB matches schematic (evaluation-board) | CAD | **PASS** | reports/drc-evaluation-board.json | 0 parity issues |
| VAL-DRC-evaluation-board | Unresolved DRC findings (evaluation-board) | CAD | **PASS** | reports/drc-evaluation-board.json | 0 errors, 0 warnings, 0 exclusions {}; ignored checks: tuning_profile_track_geometries (no track length tuning used; DD-20), lib_footprint_mismatch (density silkscreen removal; DD-20) |
| VAL-LAYOUT-evaluation-board | Power-layout review current for the board (evaluation-board) | CAD | **PASS** | reports/layout-review-evaluation-board.json | 16 REVIEW / 5 INFO screening results; dispositions in engineering/layout-review.md |
| VAL-EXPORT-evaluation-board | PCBWay export package internally consistent (evaluation-board) | CAD | **PASS** | manufacturing/pcbway/evaluation-board/reports/export-check.json |  |
| VAL-JLC-evaluation-board | JLCPCB upload files derived from the current PCBWay package (evaluation-board) | CAD | **PASS** | manufacturing/jlcpcb/evaluation-board/reports/jlcpcb-check.json |  |
| VAL-FW-TEST | Firmware host tests: state machine, conversions, hold-up, runtime, HAL register model | TEST(host) | **PASS** | firmware/tests/, firmware/build.py | 6 suites, 531 checks, 0 failures; compiler: tcc version 0.9.27 (x86_64 Windows) |
| VAL-FW-BUILD | Firmware builds for ATtiny1616 with -Werror | BUILD | **PASS** | firmware/build.py | flash 4134 B, RAM 59 B; avr-gcc.exe (GCC) 15.2.0 |
| VAL-FW-MUTATION | Firmware tests detect each audited defect (mutation check) | TEST(host) | **PASS** | firmware/build.py --mutation | 15/15 mutants killed |
| VAL-REQ-BLOCKED | Requirements awaiting owner decisions | INSPECT | **PASS** | engineering/requirements.md | none |
| VAL-REQ-RISK | Requirements at risk (documented, not blocking CAD) | INSPECT | **PASS** | engineering/requirements.md | none |

Physical verification still required (Gate G): see documentation/testing/test-plan.md.
