djgringoboy2003/Nub44-driver/reports/layout-review-evaluation-board.md

# Power-layout review: evaluation-board

Generated by `automation/review/power_layout.py` from `hardware/evaluation-board/nubm44_driver.kicad_pcb` (SHA-256 `9fe967c625a0`). Numbers come from the routed copper; the screening criteria below select items for review and never open or close a gate. DC copper analysis does not model inductance, switching waveforms or temperature. Physical behaviour remains a Gate G (bench) item.

## Assumptions

- copper: 1.0 oz (34.8 um) on every layer (DD-14 target; finished thickness UNKNOWN)
- layer spacing (mm): [0.2203, 1.1594, 0.2203]
- via barrel plating: 20 um (assumed; fabricator value UNKNOWN)
- solver: DC resistor grid, 0.05 mm cells (0.1 mm for GND), resistance at 25 C, losses scaled to 75 C copper; terminals are equipotential pad groups
- currents: boost-mode DC: input current through BAT_SPRING/VBAT, inductor RMS through SW1/SW2, output current through VOUT/LD_P; ground carries the laser return plus I_in - I_out from PGND

## Operating points

| Point | Corner | Vin (V) | Region | I_in (A) | I_L rms (A) | I_out (A) |
|---|---|---|---|---|---|---|
| worst | max_cold | 2.83 | boost | 8.58 | 8.60 | 4.50 |
| nominal | typ_25C | 4.0 | boost | 5.40 | 5.41 | 4.50 |

## Power-path copper (DC current flow)

Neck = current per unit width exceeded over the hottest 0.25 mm² of copper outside the pad and via crowding zones; equivalent width = path current / neck value. Screen = width an IPC-2221 long trace needs for the same current at 20 K rise (short necks spread heat into wider copper, so exceeding it marks a review item, not a failure).

| Net | Path | R 25 °C (mΩ) | Worst I (A) | Loss 75 °C (mW) | Neck (A/mm) | Equiv. width (mm) | Screen width (mm) | Ratio | Neck at | Max via (A) |
|---|---|---|---|---|---|---|---|---|---|---|
| BAT_SPRING | battery B+ contact to Q1 drain | 0.362 | 8.576 | 31.88 | 3.29 | 2.607 | 3.845 | 1.47 | F.Cu [-17.9, -8.0] | 0.0 |
| VBAT | Q1 source to Q2 drain | 0.881 | 8.576 | 77.55 | 5.46 | 1.571 | 3.845 | 2.45 | F.Cu [-12.35, -8.65] | 0.759 |
| SW1 | Q2 source to L1 | 0.983 | 8.599 | 86.96 | 6.64 | 1.295 | 3.859 | 2.98 | F.Cu [-3.9, -10.35] | 0.0 |
| SW2 | L1 to U1 SW2 pins 21/25 | 1.244 | 8.599 | 110.06 | 11.39 | 0.755 | 3.859 | 5.11 | F.Cu [0.7, -6.3] | 0.0 |
| VOUT | U1 VOUT pins 11/26 to shunt | 2.265 | 4.5 | 54.88 | 3.87 | 1.162 | 1.58 | 1.36 | F.Cu [1.25, -0.05] | 1.886 |
| LD_P | shunt to laser LD+ pad | 0.877 | 4.5 | 21.25 | 1.62 | 2.773 | 1.58 | 0.57 | F.Cu [10.6, 2.25] | 0.0 |

**Ground** (laser return J3.2 and U1 PGND 9/24 to battery B- J2): unit-current resistance {'laser_return': 0.388, 'converter_pgnd': 1.268} mΩ at 25 °C.

- worst: loss 40.01 mW at 75 °C; laser-return drop 1.747 mV; PGND drop 5.169 mV; setpoint shift from ground offsets {'delta_i_ma': 14.966, 'delta_pct': 0.3326}.
- nominal: loss 12.11 mW at 75 °C; laser-return drop 1.747 mV; PGND drop 1.139 mV; setpoint shift from ground offsets {'delta_i_ma': 2.509, 'delta_pct': 0.0558}.

Quiet-reference ground offsets at the worst point (µV relative to U1 AGND pin 10):

| Pad | µV |
|---|---|
| U1.10 | 0.0 |
| U1.7 | -4247.7 |
| U1.15 | -4038.4 |
| C7.2 | -4027.6 |
| R9.2 | -4029.6 |
| R2.2 | -3831.9 |
| R3.2 | -4012.7 |
| C8.2 | -3985.1 |
| C9.2 | -3933.7 |
| U2.1 | -3993.3 |
| U2.2 | -3993.8 |
| C15.2 | -3931.8 |
| R6.2 | -4249.7 |
| R11.2 | -4260.2 |
| R13.2 | -4098.5 |
| U3.3 | -4505.3 |

## Copper loss against the efficiency model (4.0 V nominal point, copper at 75 °C)

| Item | CAD (W) | Loss model (W) |
|---|---|---|
| Input path incl. ground return | 0.0555 | 0.0437 |
| Output path (VOUT + LD_P) | 0.0761 | 0.0405 |
| Switch-node copper (SW1 + SW2) | 0.0779 | not modelled |

Efficiency estimate 94.101 % (model) -> 93.559 % with the CAD copper substituted.

## Hot loops (SLVSFC5 10.1)

Centroid loop area: polygon through the pad centroids of the loop (top view). Legs: shortest copper path on the top layer (blank = the leg does not close on the top layer) and on any layer through vias.

**buck_input**

| Cap | Value | Centroid area (mm²) | Hot leg top (mm) | GND leg top (mm) | GND leg any (mm) | GND vias ≤1 mm |
|---|---|---|---|---|---|---|
| C1 | 22u | 15.48 | 2.09 |  | 7.26 | 1 |
| C2 | 22u | 13.72 | 1.4 | 1.59 | 1.59 | 1 |
| C3 | 22u | 11.97 | 5.85 |  | 5.23 | 1 |

**u1_vin**

| Cap | Value | Centroid area (mm²) | Hot leg top (mm) | GND leg top (mm) | GND leg any (mm) | GND vias ≤1 mm |
|---|---|---|---|---|---|---|
| C4 | 100n | 1.42 |  | 6.55 | 3.97 | 1 |

**boost_output**

| Cap | Value | Centroid area (mm²) | Hot leg top (mm) | GND leg top (mm) | GND leg any (mm) | GND vias ≤1 mm |
|---|---|---|---|---|---|---|
| C10 | 22u | 6.98 | 2.83 | 2.64 | 2.64 | 1 |
| C11 | 22u | 10.52 | 5.08 |  | 6.87 | 1 |
| C12 | 22u | 6.98 | 6.14 |  | 7.31 | 0 |
| C13 | 22u | 10.52 | 7.95 |  | 7.36 | 1 |
| C14 | 100n | 2.96 | 1.35 | 1.7 | 1.7 | 1 |

## Gate-drive, bootstrap and VCC loops

Loop-area estimate: track length × distance to the nearest return-net copper on the same or an adjacent layer (adjacent layers add their spacing).

| Net | Function | Return | Pad spacing (mm) | Route (mm) | Track (mm) | Vias | Layers | Loop area (mm²) | Max return distance (mm) | Return path top / any (mm) |
|---|---|---|---|---|---|---|---|---|---|---|
| DR1H | buck high-side gate | SW1 | 6.77 | 10.98 | 8.66 | 2 | F.Cu, B.Cu | 12.26 | 1.89 | 5.15 / 5.15 |
| DR1L | buck low-side gate | GND | 6.22 | 12.5 | 10.5 | 2 | F.Cu, In2.Cu | 2.58 | 0.54 |  / 10.53 |
| BOOT1 | buck bootstrap | SW1 | 3.57 | 15.15 | 12.35 | 2 | F.Cu, B.Cu | 18.29 | 2.05 | 2.98 / 2.98 |
| BOOT2 | boost bootstrap | SW2 | 3.56 | 3.37 | 4.0 | 0 | F.Cu | 1.74 | 0.95 | 6.37 / 6.37 |
| VCC5 | VCC/driver supply | GND | 3.02 | 7.83 | 5.73 | 2 | F.Cu, In2.Cu | 1.53 | 0.54 |  / 8.74 |

## ISP/ISN Kelvin pair

| Net | Track (mm) | Vias | Layers | Enclosed area (mm²) | Max separation (mm) | Length > 1 mm apart (mm) |
|---|---|---|---|---|---|---|
| ISP_K | 12.05 | 2 | F.Cu, In2.Cu | 13.41 | 1.7 | 7.46 |
| ISN_K | 14.85 | 0 | F.Cu | 14.14 | 1.38 | 5.99 |

## Sensitive nets near switching copper

Aggressors: SW1, SW2, BOOT1, BOOT2, DR1H, DR1L. Screen for high-impedance nodes (FB, COMP, COMP_RC, FSW, ILIM, EN_UVLO): ≥ 0.5 mm on the same layer and no overlap on an adjacent layer.

| Net | Layers | Same-layer gap (mm) | Adjacent-layer overlap (mm²) |
|---|---|---|---|
| FB | F.Cu, In1.Cu, In2.Cu, B.Cu | 1.42 | 0.0 |
| COMP | F.Cu | 0.3 | 0.0 |
| COMP_RC | F.Cu | 0.88 | 0.0 |
| FSW | F.Cu | 1.05 | 0.0 |
| ILIM | F.Cu | 0.73 | 0.0 |
| ISP_K | F.Cu, In1.Cu, In2.Cu, B.Cu | 1.06 | 0.0 |
| ISN_K | F.Cu | 1.52 | 0.0 |
| CS_OUT | F.Cu, In1.Cu, In2.Cu, B.Cu | 0.71 | 0.0 |
| EN_UVLO | F.Cu | 0.2 | 0.0 |

## Vias near power pins

| Pins | ≤ 1 mm | ≤ 2 mm |
|---|---|---|
| U1 PGND 9/24 | 1 | 3 |
| U1 VOUT 11/26 | 1 | 1 |
| U1 SW2 21/25 | 0 | 0 |
| Q3 source | 4 | 6 |
| Q2 drain | 0 | 1 |

Switch-node pour area (mm²): {'SW1': {'F.Cu': 28.072}, 'SW2': {'F.Cu': 9.203}}

## Screening results

- **REVIEW NECK-BAT_SPRING**: BAT_SPRING: 3.29 A/mm over the hottest 0.25 mm2 at 8.576 A (equivalent width 2.607 mm) exceeds the IPC-2221 20 K long-trace screen of 2.23 A/mm (3.845 mm) by x1.47 at [-17.9, -8.0] on F.Cu.
- **REVIEW NECK-VBAT**: VBAT: 5.46 A/mm over the hottest 0.25 mm2 at 8.576 A (equivalent width 1.571 mm) exceeds the IPC-2221 20 K long-trace screen of 2.23 A/mm (3.845 mm) by x2.45 at [-12.35, -8.65] on F.Cu.
- **REVIEW NECK-SW1**: SW1: 6.64 A/mm over the hottest 0.25 mm2 at 8.599 A (equivalent width 1.295 mm) exceeds the IPC-2221 20 K long-trace screen of 2.23 A/mm (3.859 mm) by x2.98 at [-3.9, -10.35] on F.Cu.
- **REVIEW NECK-SW2**: SW2: 11.39 A/mm over the hottest 0.25 mm2 at 8.599 A (equivalent width 0.755 mm) exceeds the IPC-2221 20 K long-trace screen of 2.23 A/mm (3.859 mm) by x5.11 at [0.7, -6.3] on F.Cu.
- **REVIEW NECK-VOUT**: VOUT: 3.87 A/mm over the hottest 0.25 mm2 at 4.5 A (equivalent width 1.162 mm) exceeds the IPC-2221 20 K long-trace screen of 2.85 A/mm (1.58 mm) by x1.36 at [1.25, -0.05] on F.Cu.
- **REVIEW VIA-VOUT**: VOUT: 1 via barrel segment(s) carry more than 1.0 A (max 1.886 A).
- **REVIEW COPPER-LOSS**: Routed copper at 75 C dissipates 125 mW more than the loss model allows at the 4.0 V nominal point (switch-node copper is not in the model); estimated efficiency 94.101 % -> 93.559 %.
- **REVIEW GND-OFFSET**: DC ground offsets shift the regulated current by 14.966 mA (0.3326 %).
- **REVIEW DRIVE-DR1H**: DR1H (buck high-side gate) changes layer through 2 via(s); route 10.98 mm for a 6.77 mm pad spacing, loop-area estimate 12.26 mm2 against SW1.
- **REVIEW DRIVE-DR1L**: DR1L (buck low-side gate) changes layer through 2 via(s); route 12.5 mm for a 6.22 mm pad spacing, loop-area estimate 2.58 mm2 against GND.
- **REVIEW DRIVE-BOOT1**: BOOT1 (buck bootstrap) changes layer through 2 via(s); route 15.15 mm for a 3.57 mm pad spacing, loop-area estimate 18.29 mm2 against SW1.
- **REVIEW DRIVE-VCC5**: VCC5 (VCC/driver supply) changes layer through 2 via(s); route 7.83 mm for a 3.02 mm pad spacing, loop-area estimate 1.53 mm2 against GND.
- **REVIEW SPACE-COMP**: High-impedance COMP is 0.3 mm from switching copper (screen 0.5 mm).
- **REVIEW SPACE-EN_UVLO**: High-impedance EN_UVLO is 0.2 mm from switching copper (screen 0.5 mm).
- **REVIEW KELVIN-ISP_K**: ISP_K: 7.46 mm of route is more than 1 mm from its Kelvin partner (max 1.7 mm, enclosed 13.41 mm2); SLVSFC5 10.1 asks for parallel, close ISP/ISN traces.
- **REVIEW KELVIN-ISN_K**: ISN_K: 5.99 mm of route is more than 1 mm from its Kelvin partner (max 1.38 mm, enclosed 14.14 mm2); SLVSFC5 10.1 asks for parallel, close ISP/ISN traces.
- **INFO LOOP-C1**: buck_input loop via C1: the ground leg does not close on the top layer; it returns through vias (1 within 1 mm) and the plane, path 7.26 mm.
- **INFO LOOP-C3**: buck_input loop via C3: the ground leg does not close on the top layer; it returns through vias (1 within 1 mm) and the plane, path 5.23 mm.
- **INFO LOOP-C11**: boost_output loop via C11: the ground leg does not close on the top layer; it returns through vias (1 within 1 mm) and the plane, path 6.87 mm.
- **INFO LOOP-C12**: boost_output loop via C12: the ground leg does not close on the top layer; it returns through vias (0 within 1 mm) and the plane, path 7.31 mm.
- **INFO LOOP-C13**: boost_output loop via C13: the ground leg does not close on the top layer; it returns through vias (1 within 1 mm) and the plane, path 7.36 mm.

## Figures

- [nets-F_Cu.png](layout-review/evaluation-board/nets-F_Cu.png)
- [nets-In1_Cu.png](layout-review/evaluation-board/nets-In1_Cu.png)
- [nets-In2_Cu.png](layout-review/evaluation-board/nets-In2_Cu.png)
- [nets-B_Cu.png](layout-review/evaluation-board/nets-B_Cu.png)
- [flow-BAT_SPRING.png](layout-review/evaluation-board/flow-BAT_SPRING.png)
- [flow-VBAT.png](layout-review/evaluation-board/flow-VBAT.png)
- [flow-SW1.png](layout-review/evaluation-board/flow-SW1.png)
- [flow-SW2.png](layout-review/evaluation-board/flow-SW2.png)
- [flow-VOUT.png](layout-review/evaluation-board/flow-VOUT.png)
- [flow-LD_P.png](layout-review/evaluation-board/flow-LD_P.png)
- [ground-potential.png](layout-review/evaluation-board/ground-potential.png)
