djgringoboy2003/Nub44-driver/simulation/results/flash.csv

 time            i(VIL1)         v(vout)         v(ldk)          v(vin)          v(enp)          v(vref)         v(comp)         v(u)            v(csout)        i(VB)
 1.00000000e-08  0.00000000e+00  0.00000000e+00  0.00000000e+00  1.91584555e-03  1.91920356e-07  0.00000000e+00  5.01194130e-11  0.00000000e+00 -4.19439973e-05 -8.31880344e-01
 1.00845500e-08  0.00000000e+00  0.00000000e+00  0.00000000e+00  1.93206089e-03  1.93544732e-07  0.00000000e+00  5.05430762e-11  0.00000000e+00 -4.22983082e-05 -8.38913313e-01
 1.02536501e-08  0.00000000e+00  0.00000000e+00  0.00000000e+00  1.96453202e-03  1.96797536e-07  0.00000000e+00  5.13901708e-11  0.00000000e+00 -4.30061474e-05 -8.52977860e-01
 1.05918502e-08  0.00000000e+00  0.00000000e+00  0.00000000e+00  2.02966843e-03  2.03322594e-07  0.00000000e+00  5.30832486e-11  0.00000000e+00 -4.44180604e-05 -8.81100267e-01
 1.12682503e-08  0.00000000e+00  0.00000000e+00  0.00000000e+00  2.16074337e-03  2.16453062e-07  0.00000000e+00  5.64648150e-11  0.00000000e+00 -4.72262422e-05 -9.37317449e-01
 1.26210507e-08  0.00000000e+00  0.00000000e+00  0.00000000e+00  2.42611950e-03  2.43037189e-07  0.00000000e+00  6.32095179e-11  0.00000000e+00 -5.27789673e-05 -1.04964061e+00
 1.53266514e-08  0.00000000e+00  0.00000000e+00  0.00000000e+00  2.96976956e-03  2.97497484e-07  0.00000000e+00  7.66254675e-11  0.00000000e+00 -6.36242432e-05 -1.27384185e+00
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
 9.95468926e-04  8.38593122e-01  3.75744474e+00  3.74046891e+00  4.16465803e+00  1.76343300e+00  1.47121993e-01  4.55508996e-02  9.05417526e-01  4.30074050e-01 -7.61777558e-01
 9.97468926e-04  8.35293762e-01  3.75681817e+00  3.73990923e+00  4.16480501e+00  1.76349172e+00  1.47721993e-01  4.53284273e-02  9.05229142e-01  4.28410972e-01 -7.58583457e-01
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
