djgringoboy2003/Nub44-driver/simulation/results/interlock.csv

 time            i(VIL1)         v(vout)         v(ldk)          v(vin)          v(enp)          v(vref)         v(comp)         v(u)            v(csout)        i(VB)
 1.00000000e-08  0.00000000e+00  0.00000000e+00  0.00000000e+00  1.68776870e-03  1.69072695e-07  0.00000000e+00  5.01194130e-11  0.00000000e+00 -4.24729939e-05 -7.32846969e-01
 1.00845500e-08  0.00000000e+00  0.00000000e+00  0.00000000e+00  1.70205364e-03  1.70503692e-07  0.00000000e+00  5.05430762e-11  0.00000000e+00 -4.28318153e-05 -7.39042681e-01
 1.02536501e-08  0.00000000e+00  0.00000000e+00  0.00000000e+00  1.73065916e-03  1.73369258e-07  0.00000000e+00  5.13901708e-11  0.00000000e+00 -4.35487665e-05 -7.51432876e-01
 1.05918502e-08  0.00000000e+00  0.00000000e+00  0.00000000e+00  1.78804123e-03  1.79117523e-07  0.00000000e+00  5.30832486e-11  0.00000000e+00 -4.49793411e-05 -7.76207378e-01
 1.12682503e-08  0.00000000e+00  0.00000000e+00  0.00000000e+00  1.90351201e-03  1.90684841e-07  0.00000000e+00  5.64648150e-11  0.00000000e+00 -4.78266651e-05 -8.25732039e-01
 1.26210507e-08  0.00000000e+00  0.00000000e+00  0.00000000e+00  2.13729575e-03  2.14104191e-07  0.00000000e+00  6.32095179e-11  0.00000000e+00 -5.34650745e-05 -9.24683398e-01
 1.53266514e-08  0.00000000e+00  0.00000000e+00  0.00000000e+00  2.61622557e-03  2.62081117e-07  0.00000000e+00  7.66254675e-11  0.00000000e+00 -6.45119883e-05 -1.12219401e+00
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
 9.98268746e-04  9.63770381e-01  3.92220251e+00  3.90412548e+00  3.65514102e+00  1.55988362e+00  1.47961929e-01  5.29985874e-02  1.07198660e+00  4.56820822e-01 -9.66762546e-01
 1.00026875e-03  9.59896761e-01  3.92161339e+00  3.90359961e+00  3.65532080e+00  1.55995545e+00  1.48561929e-01  5.26534021e-02  1.07177918e+00  4.55404553e-01 -9.62920439e-01
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
