djgringoboy2003/Nub44-driver/simulation/results/reg_3p0_max.csv

 time            i(VIL1)         v(vout)         v(ldk)          v(vin)          v(enp)          v(vref)         v(comp)         v(u)            v(csout)        i(VB)
 1.00000000e-08  0.00000000e+00  0.00000000e+00  0.00000000e+00  1.51581536e-03  1.51847221e-07  0.00000000e+00  5.01194130e-11  0.00000000e+00 -4.28718187e-05 -6.58183016e-01
 1.00841580e-08  0.00000000e+00  0.00000000e+00  0.00000000e+00  1.52858603e-03  1.53126527e-07  0.00000000e+00  5.05411123e-11  0.00000000e+00 -4.32323624e-05 -6.63722024e-01
 1.02524740e-08  0.00000000e+00  0.00000000e+00  0.00000000e+00  1.55416064e-03  1.55688471e-07  0.00000000e+00  5.13842812e-11  0.00000000e+00 -4.39528326e-05 -6.74799730e-01
 1.05891060e-08  0.00000000e+00  0.00000000e+00  0.00000000e+00  1.60546963e-03  1.60828362e-07  0.00000000e+00  5.30695179e-11  0.00000000e+00 -4.53908022e-05 -6.96953660e-01
 1.12623700e-08  0.00000000e+00  0.00000000e+00  0.00000000e+00  1.70874779e-03  1.71174281e-07  0.00000000e+00  5.64354446e-11  0.00000000e+00 -4.82543969e-05 -7.41255382e-01
 1.26088979e-08  0.00000000e+00  0.00000000e+00  0.00000000e+00  1.91796122e-03  1.92132294e-07  0.00000000e+00  6.31490383e-11  0.00000000e+00 -5.39313498e-05 -8.29834075e-01
 1.53019539e-08  0.00000000e+00  0.00000000e+00  0.00000000e+00  2.34702400e-03  2.35113776e-07  0.00000000e+00  7.65034456e-11  0.00000000e+00 -6.50797035e-05 -1.00689199e+00
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
