djgringoboy2003/Nub44-driver/manufacturing/pcbway/evaluation-board/drawings/render_iso.png

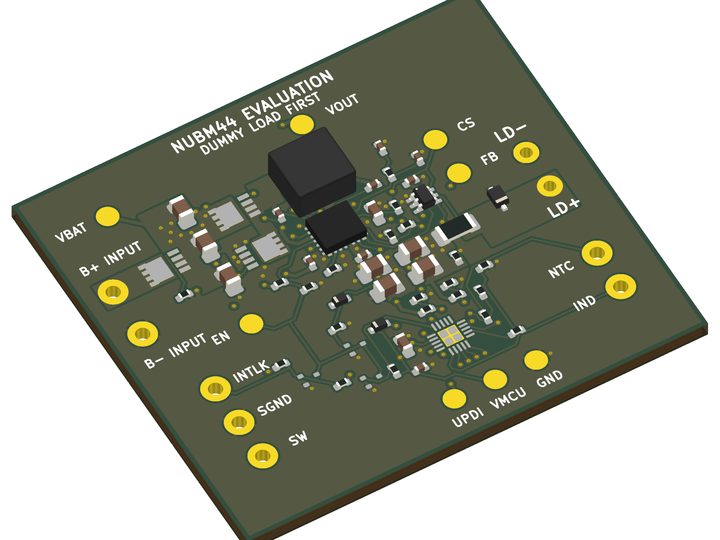
manufacturing/pcbway/evaluation-board/drawings/render_iso.png
