djgringoboy2003/Nub44-driver/reports/layout-review/evaluation-board/flow-BAT_SPRING.png

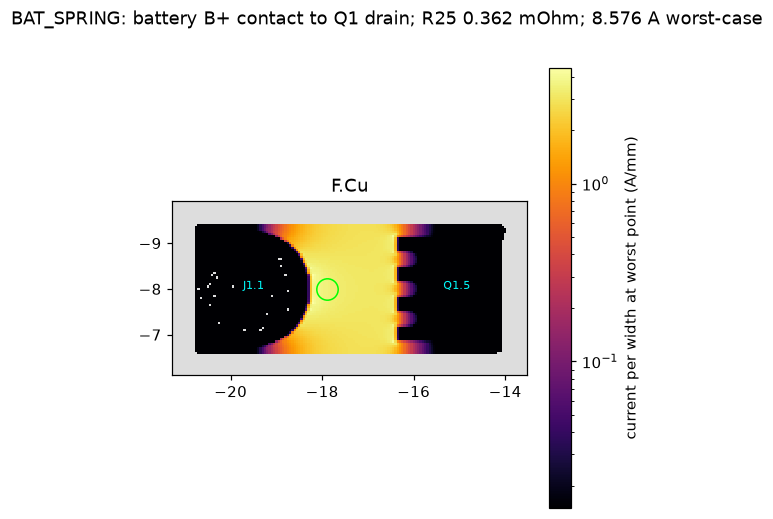
reports/layout-review/evaluation-board/flow-BAT_SPRING.png
