djgringoboy2003/Nub44-driver/reports/layout-review/evaluation-board/flow-LD_P.png

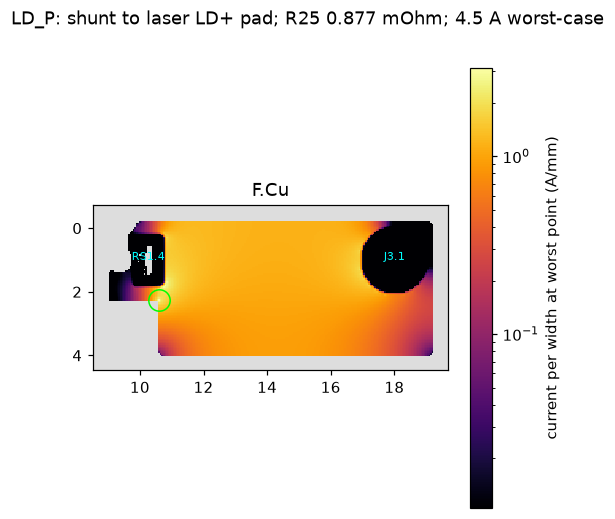
reports/layout-review/evaluation-board/flow-LD_P.png
