djgringoboy2003/Nub44-driver/reports/layout-review/evaluation-board/flow-SW1.png

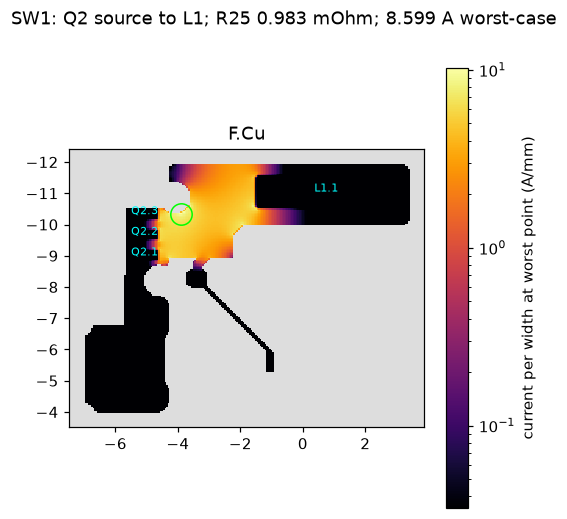
reports/layout-review/evaluation-board/flow-SW1.png
