djgringoboy2003/Nub44-driver/reports/layout-review/evaluation-board/flow-SW2.png

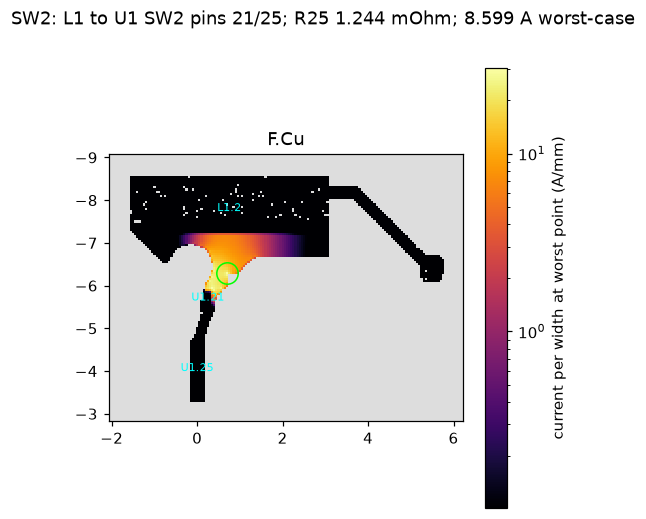
reports/layout-review/evaluation-board/flow-SW2.png
