djgringoboy2003/Nub44-driver/reports/layout-review/evaluation-board/flow-VBAT.png

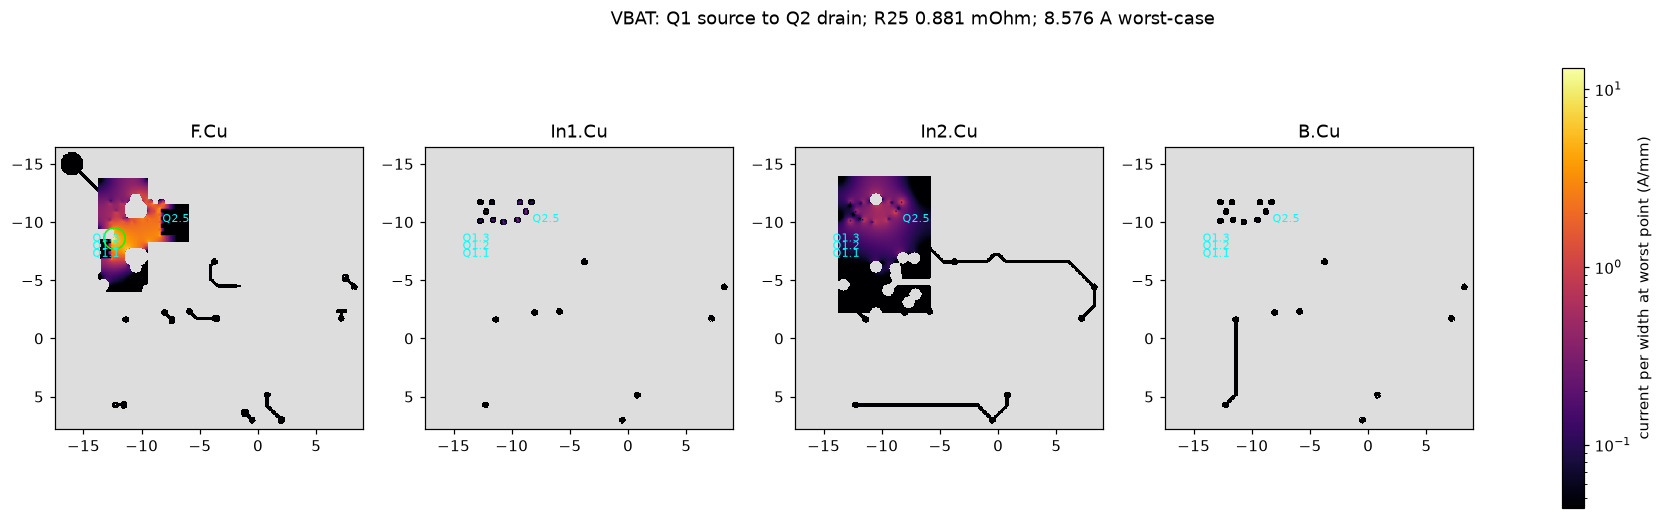
reports/layout-review/evaluation-board/flow-VBAT.png
