djgringoboy2003/Nub44-driver/reports/layout-review/evaluation-board/ground-potential.png

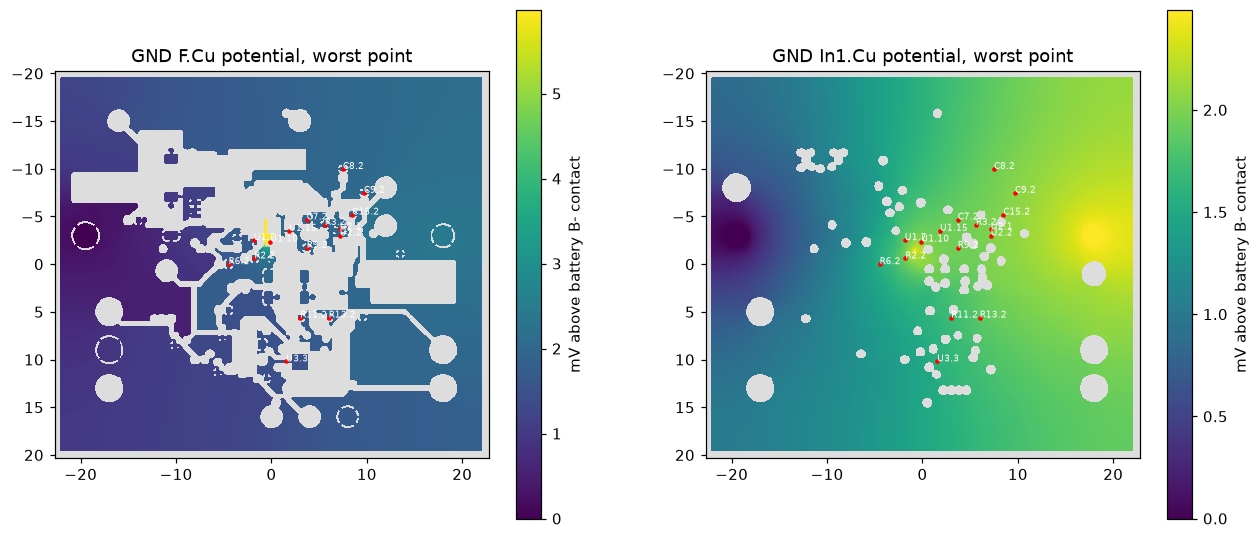
reports/layout-review/evaluation-board/ground-potential.png
