djgringoboy2003/Nub44-driver/reports/layout-review/evaluation-board/nets-B_Cu.png

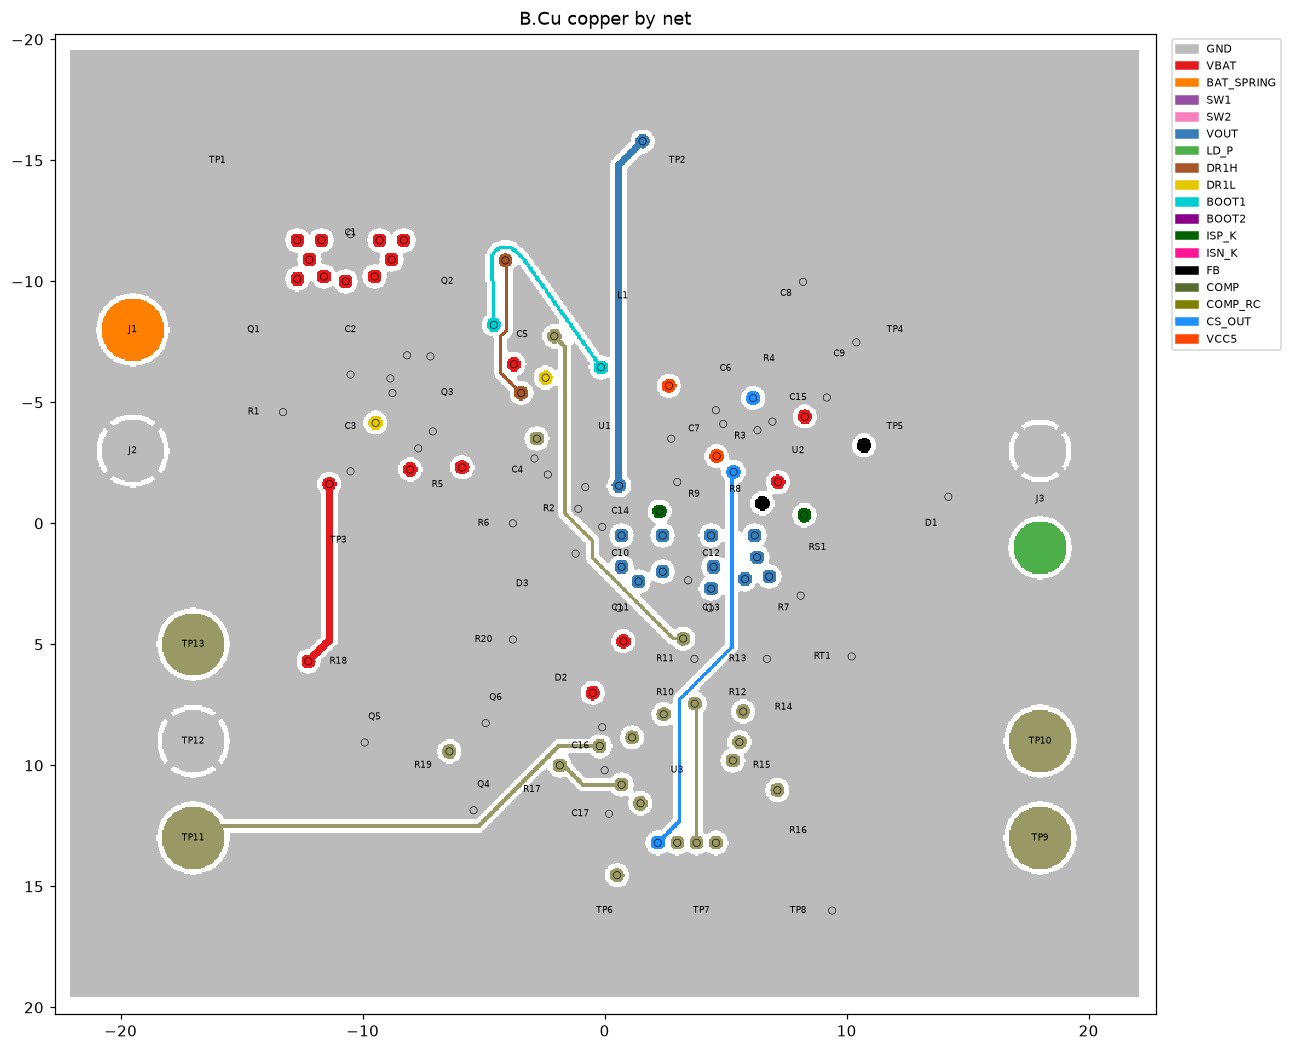
reports/layout-review/evaluation-board/nets-B_Cu.png
