djgringoboy2003/Nub44-driver/reports/layout-review/evaluation-board/nets-F_Cu.png

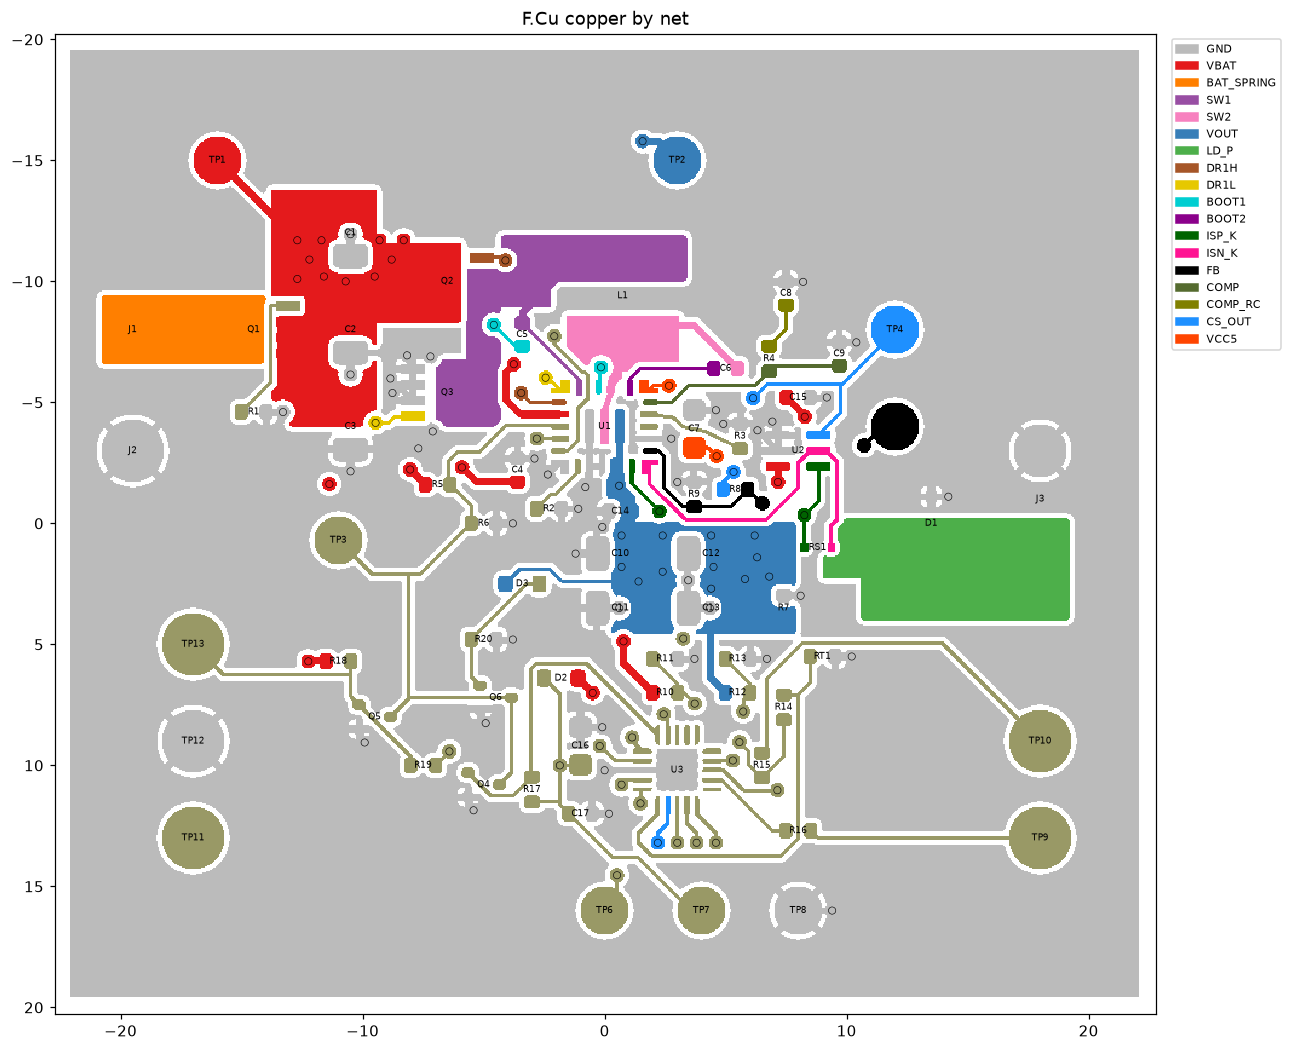
reports/layout-review/evaluation-board/nets-F_Cu.png
