djgringoboy2003/Nub44-driver/reports/layout-review/evaluation-board/nets-In2_Cu.png

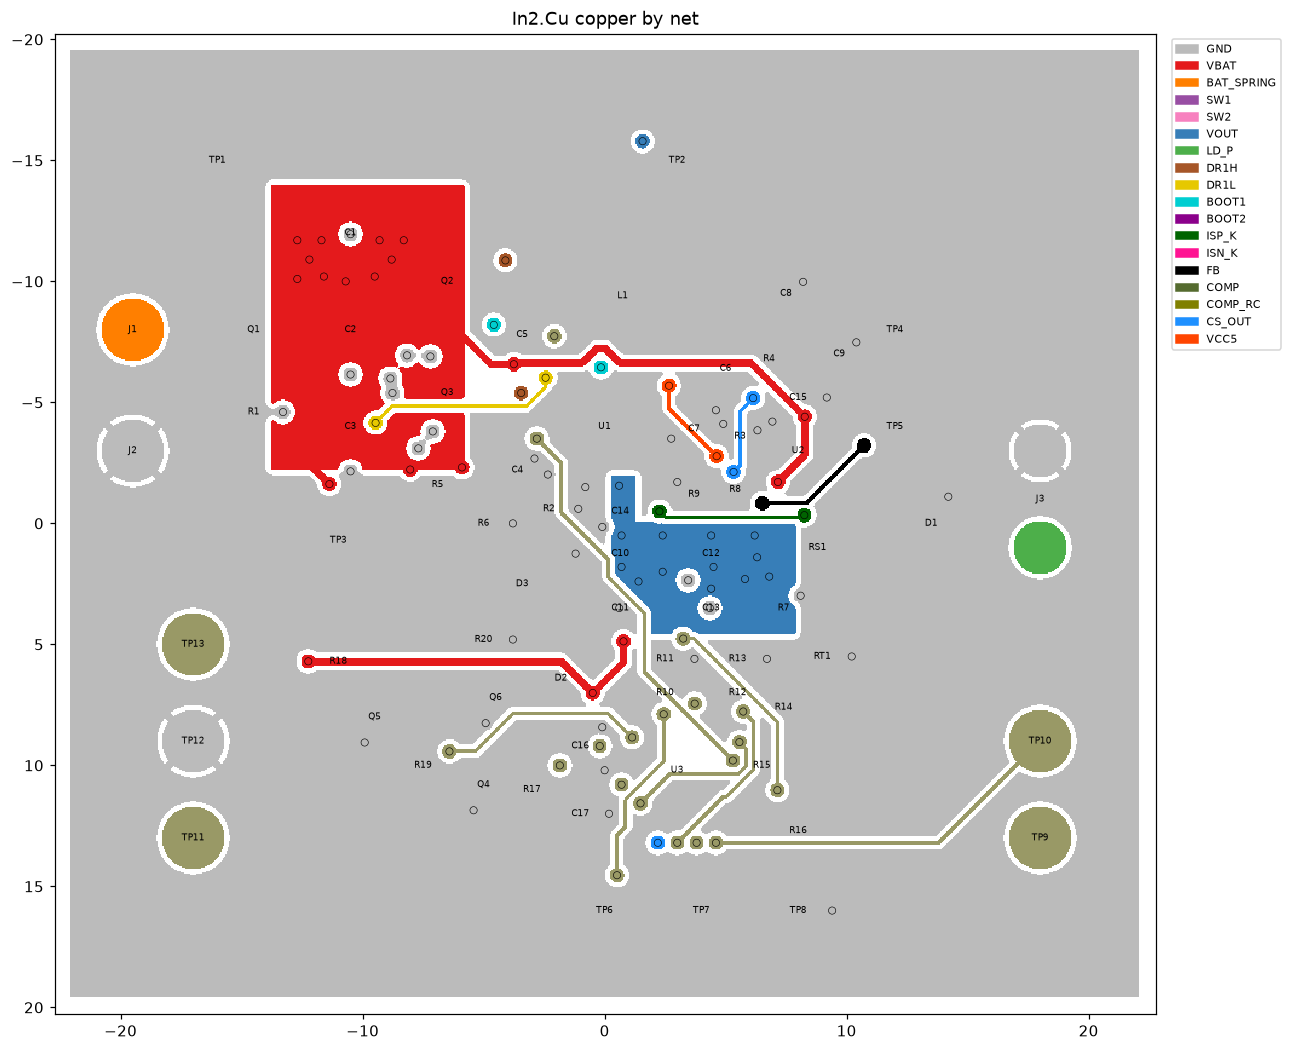
reports/layout-review/evaluation-board/nets-In2_Cu.png
