djgringoboy2003/Nub44-driver/simulation/results/SIM-01.png

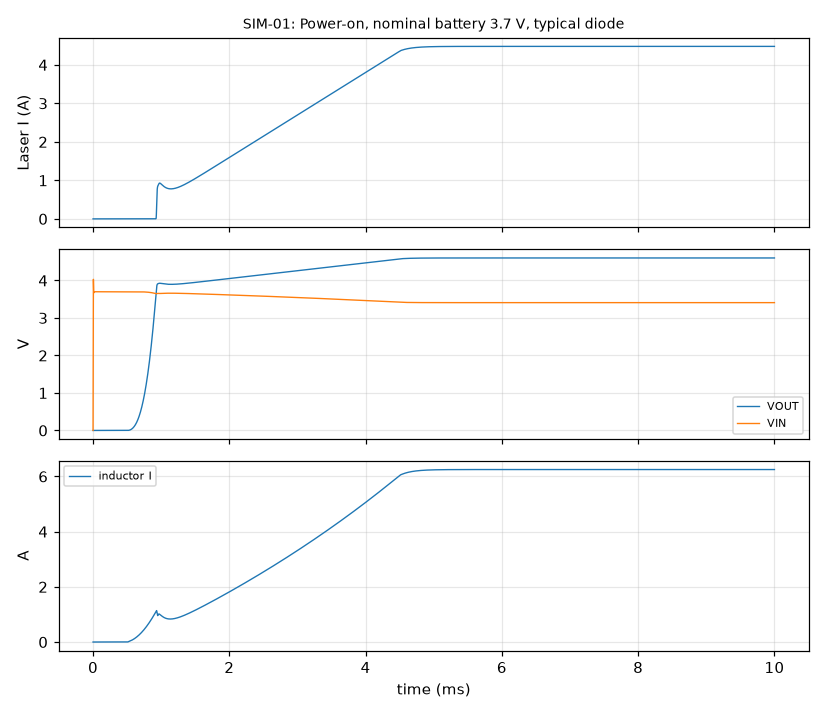
simulation/results/SIM-01.png
