djgringoboy2003/Nub44-driver/simulation/results/SIM-02.png

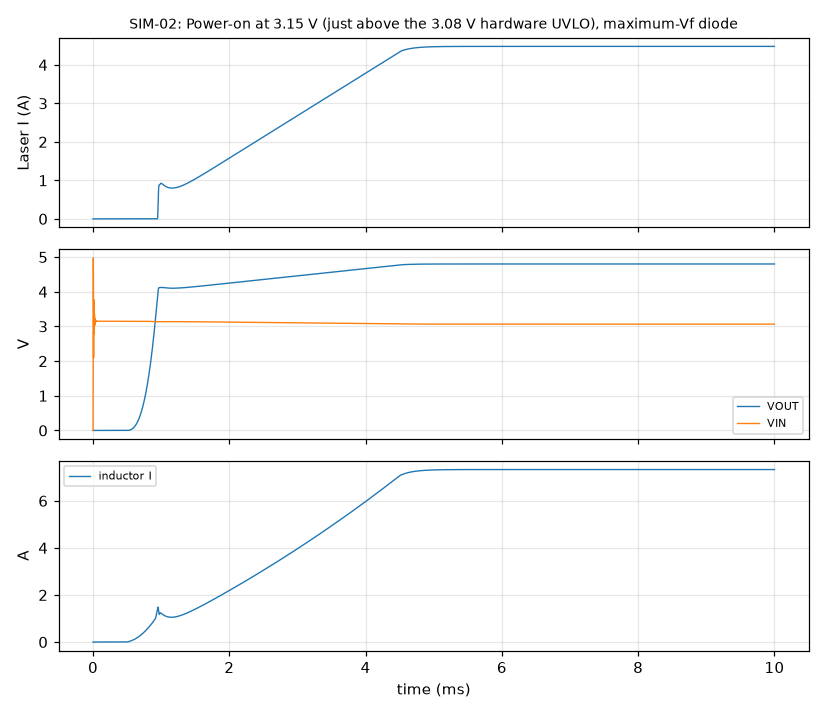
simulation/results/SIM-02.png
