djgringoboy2003/Nub44-driver/simulation/results/SIM-04.png

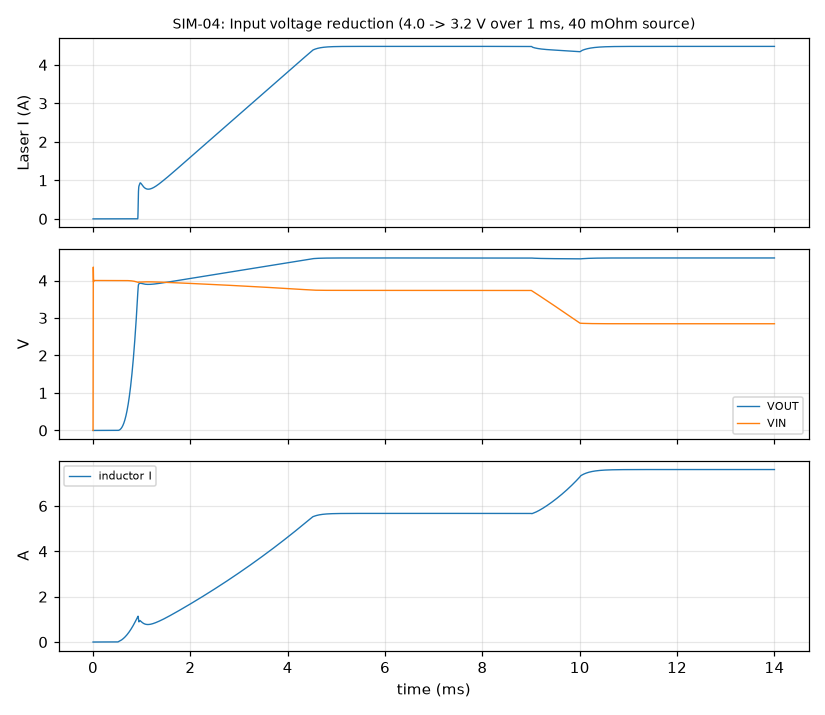
simulation/results/SIM-04.png
