djgringoboy2003/Nub44-driver/simulation/results/SIM-06.png

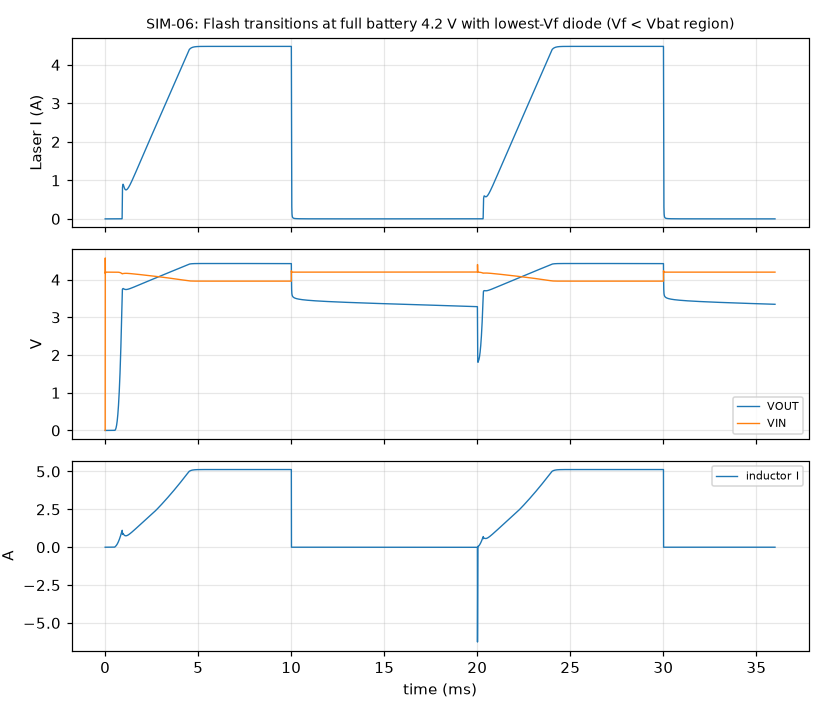
simulation/results/SIM-06.png
