djgringoboy2003/Nub44-driver/simulation/results/SIM-07.png

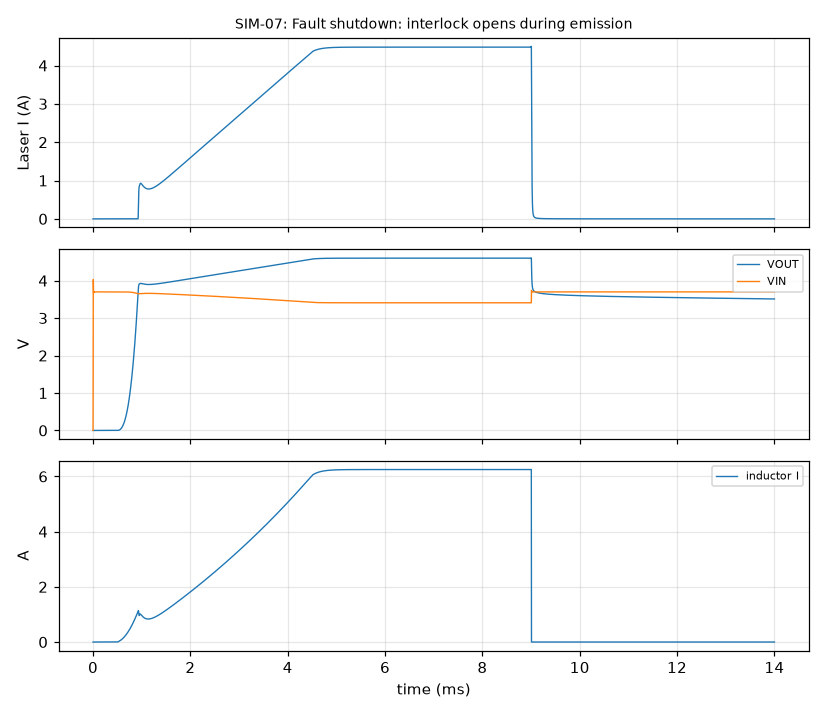
simulation/results/SIM-07.png
