djgringoboy2003/Nub44-driver/simulation/results/SIM-08.png

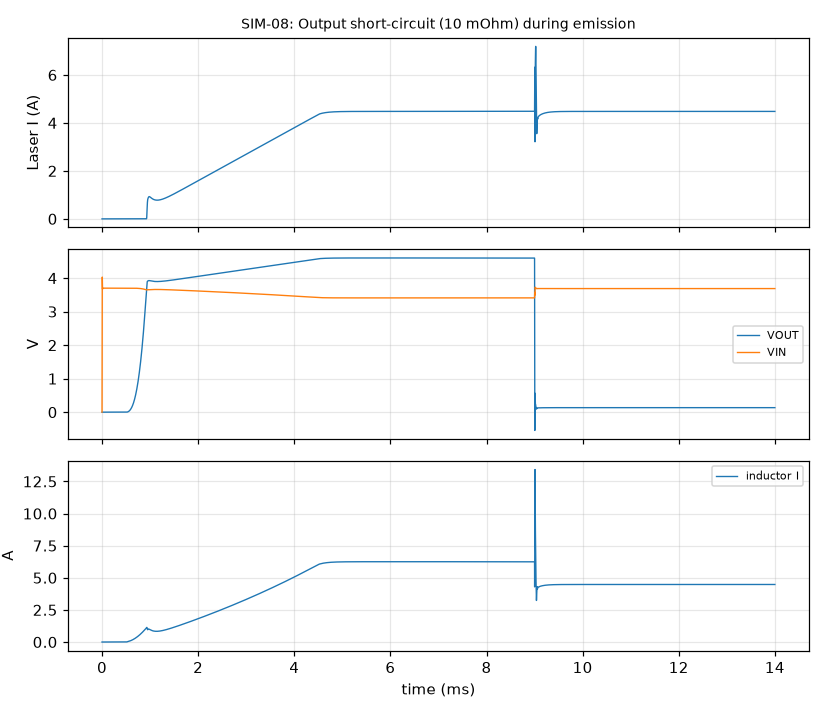
simulation/results/SIM-08.png
