djgringoboy2003/Nub44-driver/simulation/results/SIM-09.png

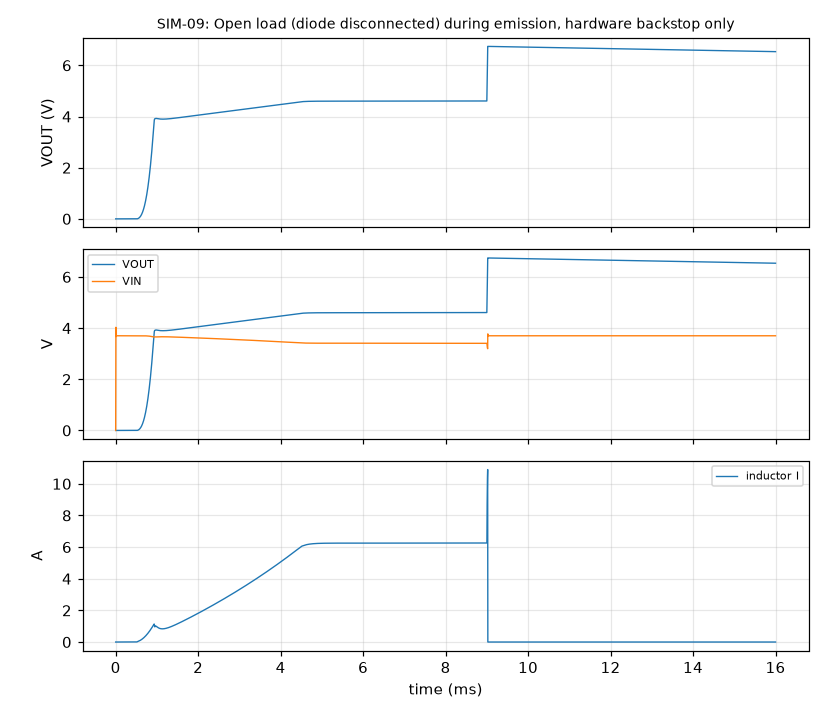
simulation/results/SIM-09.png
