djgringoboy2003/Nub44-driver/simulation/results/SIM-11.png

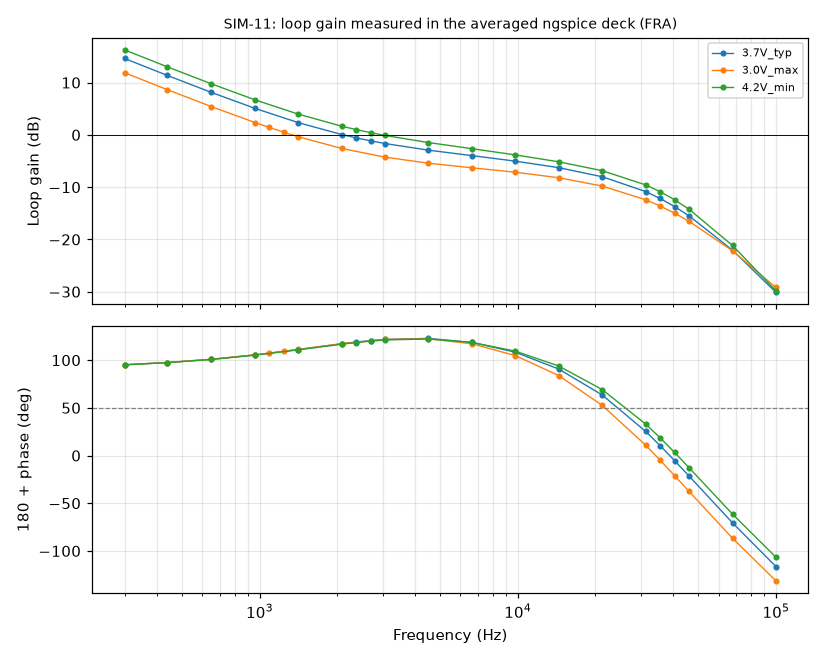
simulation/results/SIM-11.png
