djgringoboy2003/Nub44-driver/reports/budget-2s/schematic.pdf

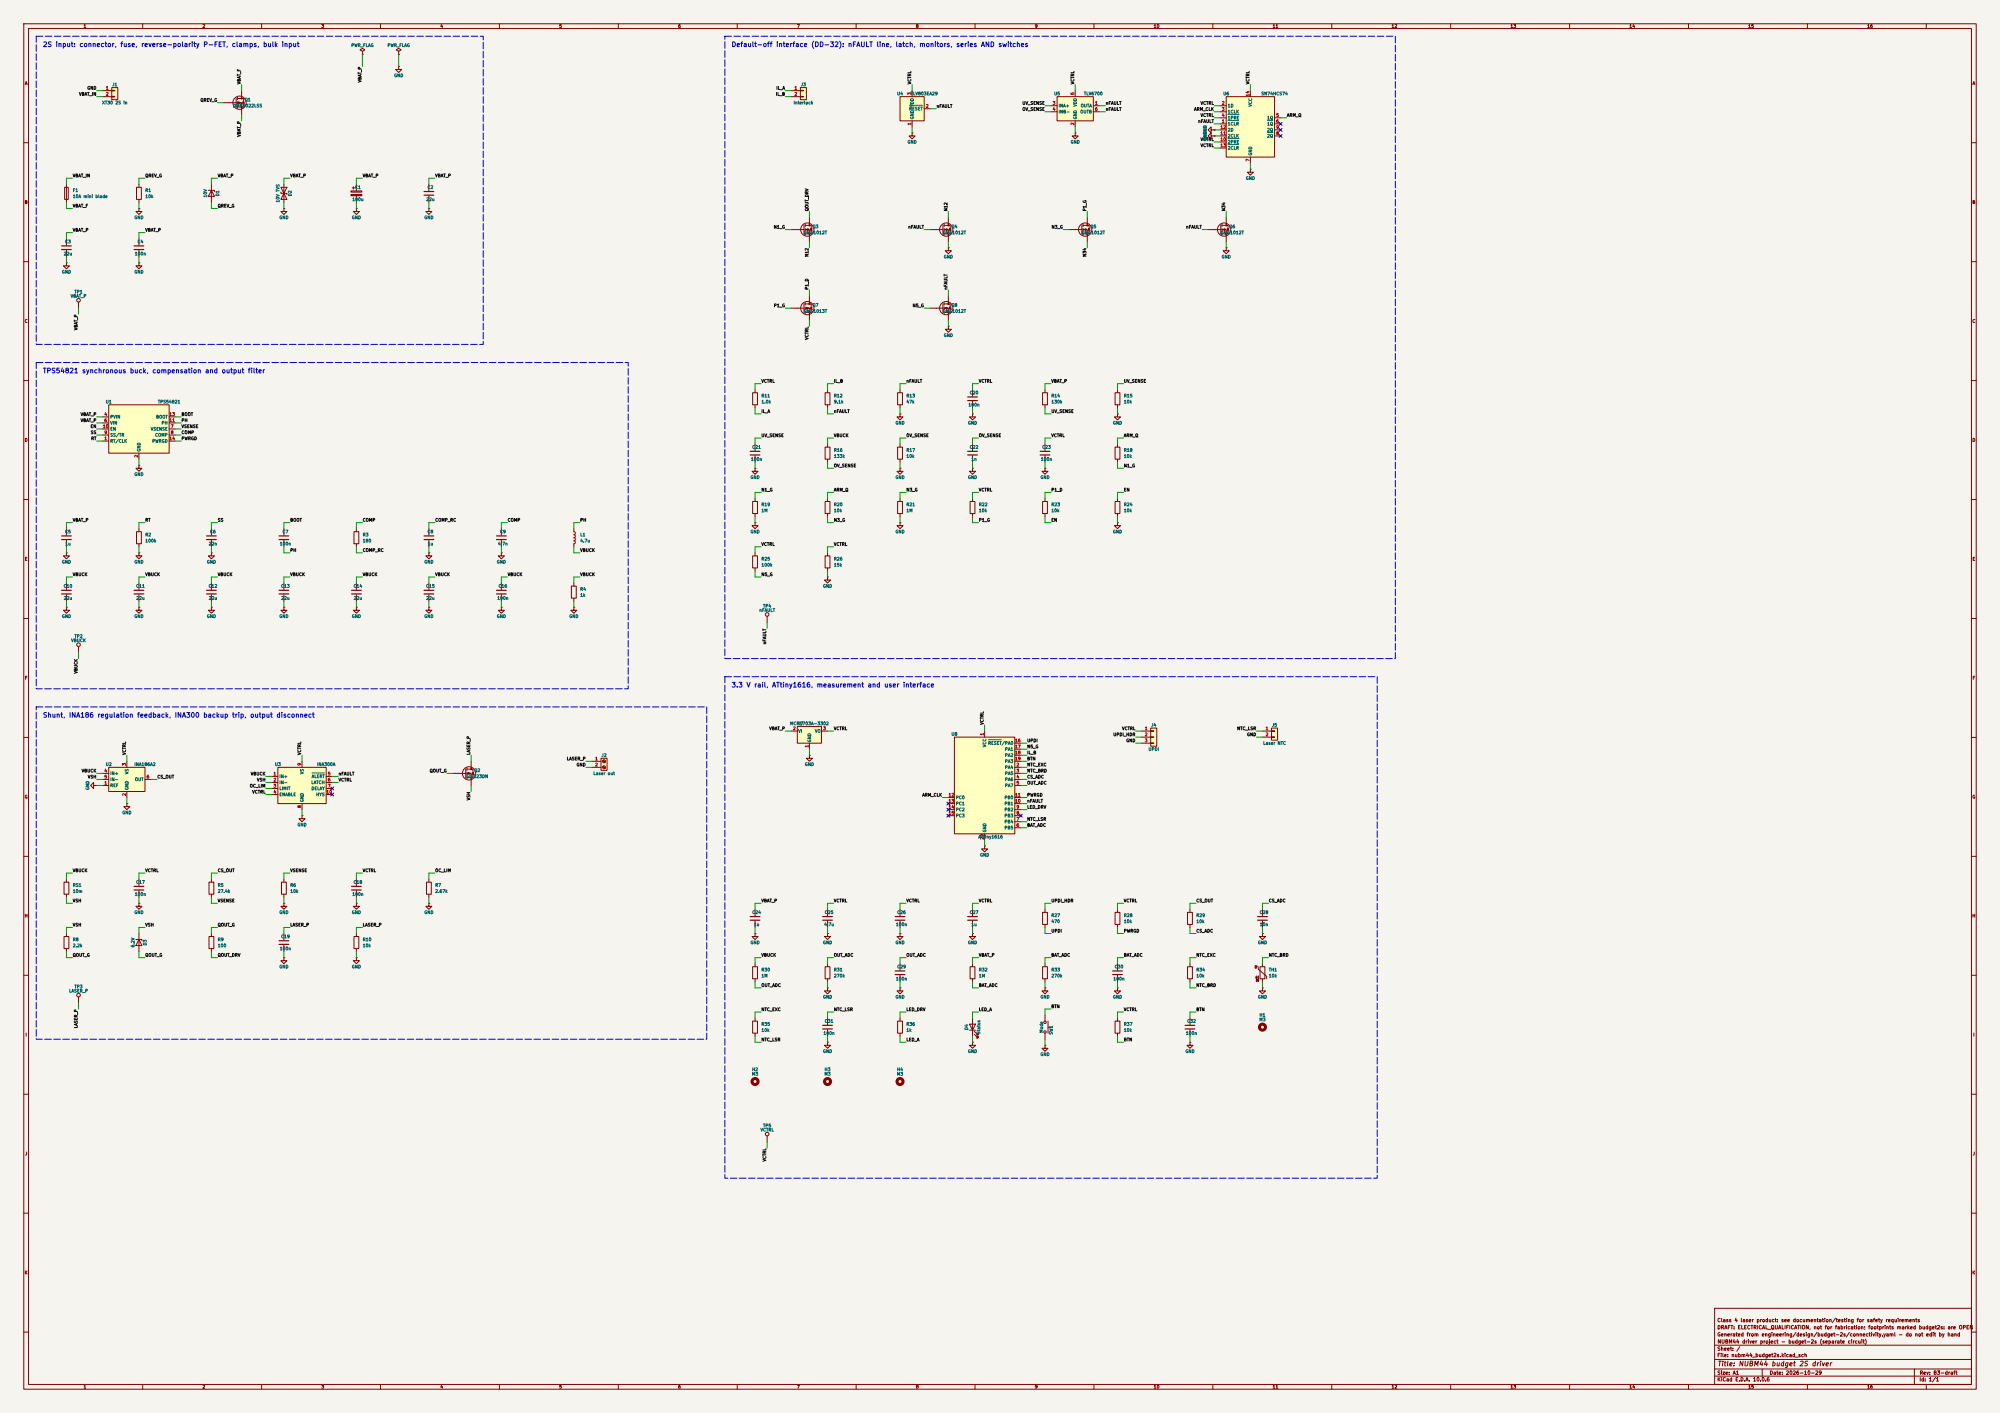
[picture p41: page 1]

VBAT_P TPS54821 synchronous buck, compensation and output filter

Shunt, INA186 regulation feedback, INA300 backup trip, output disconnect

Class 4 laser product: see documentation/testing for safety requirements
DRAFT: ELECTRICAL_QUALIFICATION, not for fabrication; footprints marked budget2s: are OPEN
Generated from engineering/design/budget-2s/connectivity.yaml - do not edit by hand
NUBM44 driver project - budget-2s (separate circuit)
Sheet: /
File: nubm44_budget2s.kicad_sch
Title: NUBM44 budget 2S driver

Size: A1 | Rev: B3-draft
KiCad E.D.A. 10.0.6 | Id: 1/1
