djgringoboy2003/Nub44-driver/manufacturing/budget-2s/drawings/assembly_top.pdf

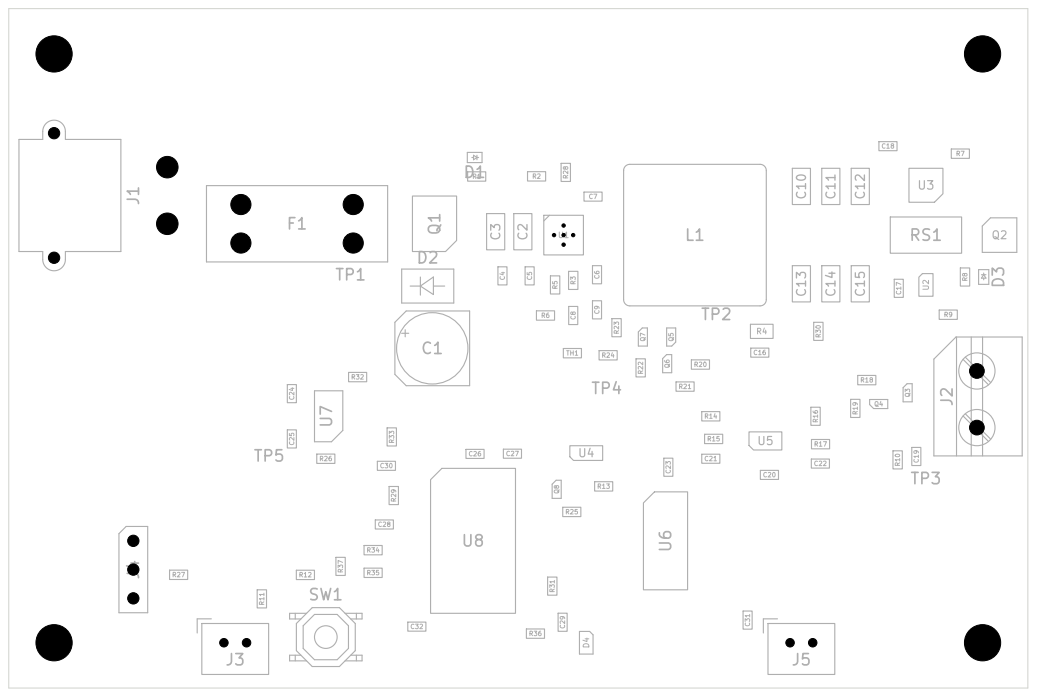
[picture p42: page 1]

Size: A4 | Rev:
KiCad E.D.A. 10.0.6 | Id: 1/1
