djgringoboy2003/Nub44-driver/manufacturing/pcbway/compact-22mm/drawings/nubm44_driver_schematic.pdf

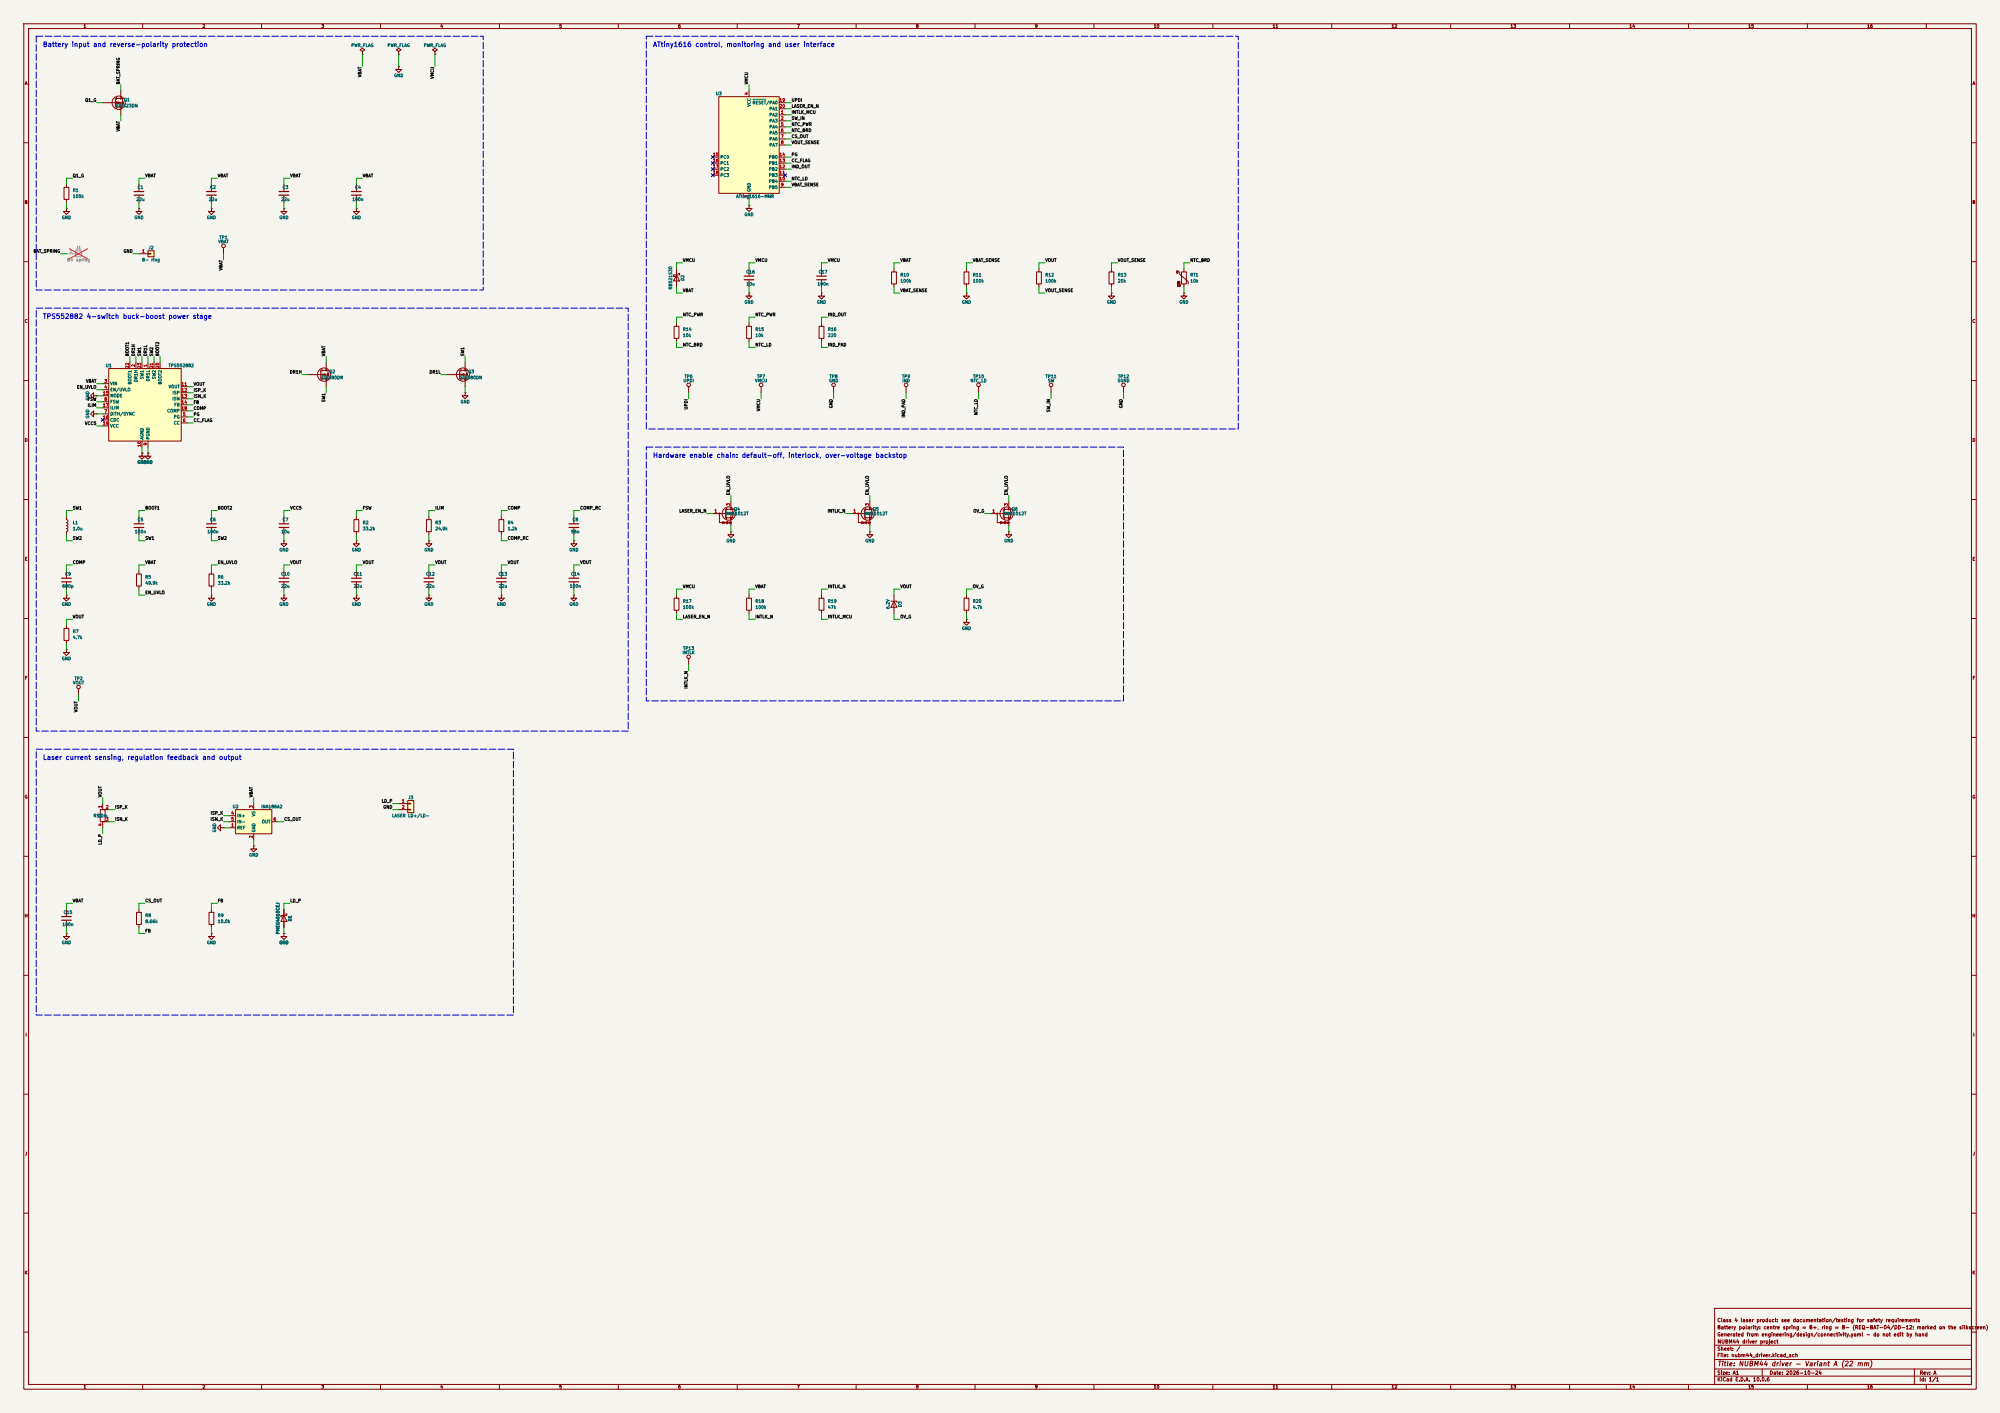
[picture p46: page 1]

Battery input and reverse-polarity protection

ATtiny1616 control, monitoring and user interface

TPS552882 4-switch buck-boost power stage

Hardware enable chain: default-off, interlock, over-voltage backstop

Class 4 laser product: see documentation/testing for safety requirements
Battery polarity: centre spring = B+, ring = B- (REQ-BAT-04/DD-12; marked on the silkscreen)
Generated from engineering/design/connectivity.yaml - do not edit by hand
NUBM44 driver project
Sheet: /
File: nubm44_driver.kicad_sch
Title: NUBM44 driver - Variant A (22 mm)

Size: A1 | Rev: A
KiCad E.D.A. 10.0.6 | Id: 1/1
