djgringoboy2003/Nub44-driver/manufacturing/pcbway/evaluation-board/drawings/fab_outline.pdf

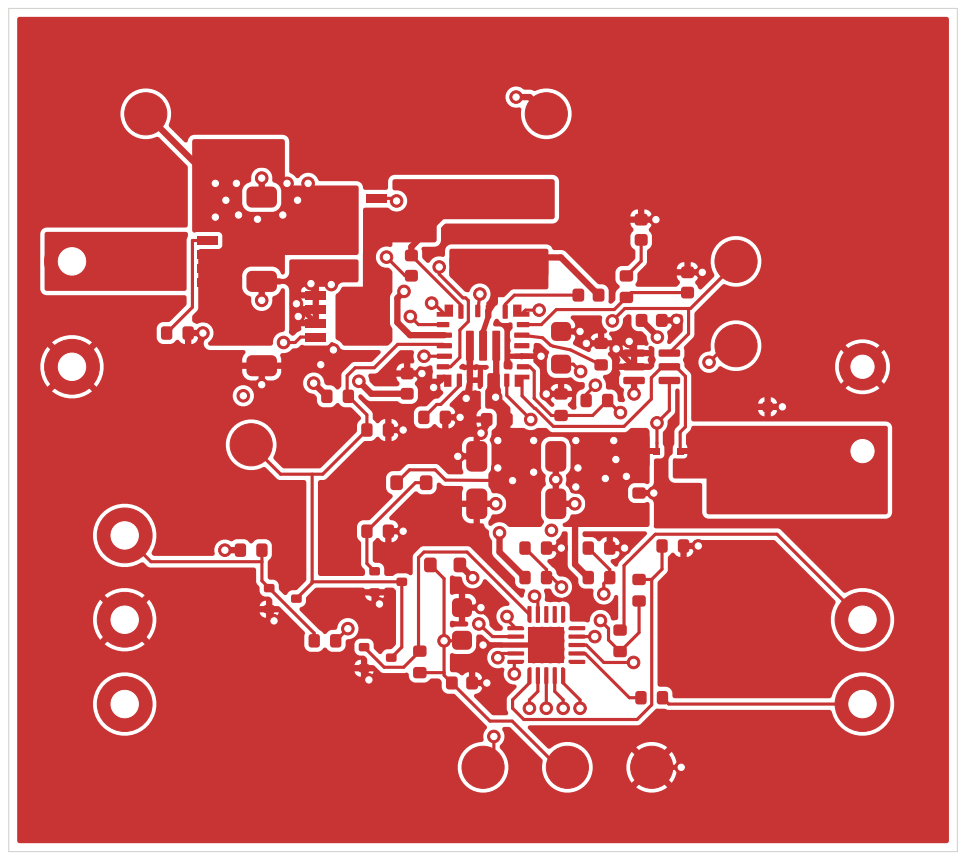
[picture p49: page 1]

Size: A4 | Rev:
KiCad E.D.A. 10.0.6 | Id: 1/1
