djgringoboy2003/Nub44-driver/(list of files, drawings)

Other design files:
hardware/budget-2s/routing/nubm44_budget2s.dsn
hardware/compact-22mm/routing/nubm44_driver.dsn
hardware/evaluation-board/routing/nubm44_driver.dsn
reports/budget-2s/schematic-evidence.json
reports/pcb-compact-22mm.json
reports/pcb-evaluation-board.json
reports/schematic-compact-22mm-evidence.json
reports/schematic-compact-22mm.json
reports/schematic-evaluation-board-evidence.json
reports/schematic-evaluation-board.json
