djgringoboy2003/Nub44-driver/hardware/budget-2s/nubm44_budget2s.kicad_pcb

## KiCad design hardware/budget-2s/nubm44_budget2s.kicad_pcb (2026-10-29)

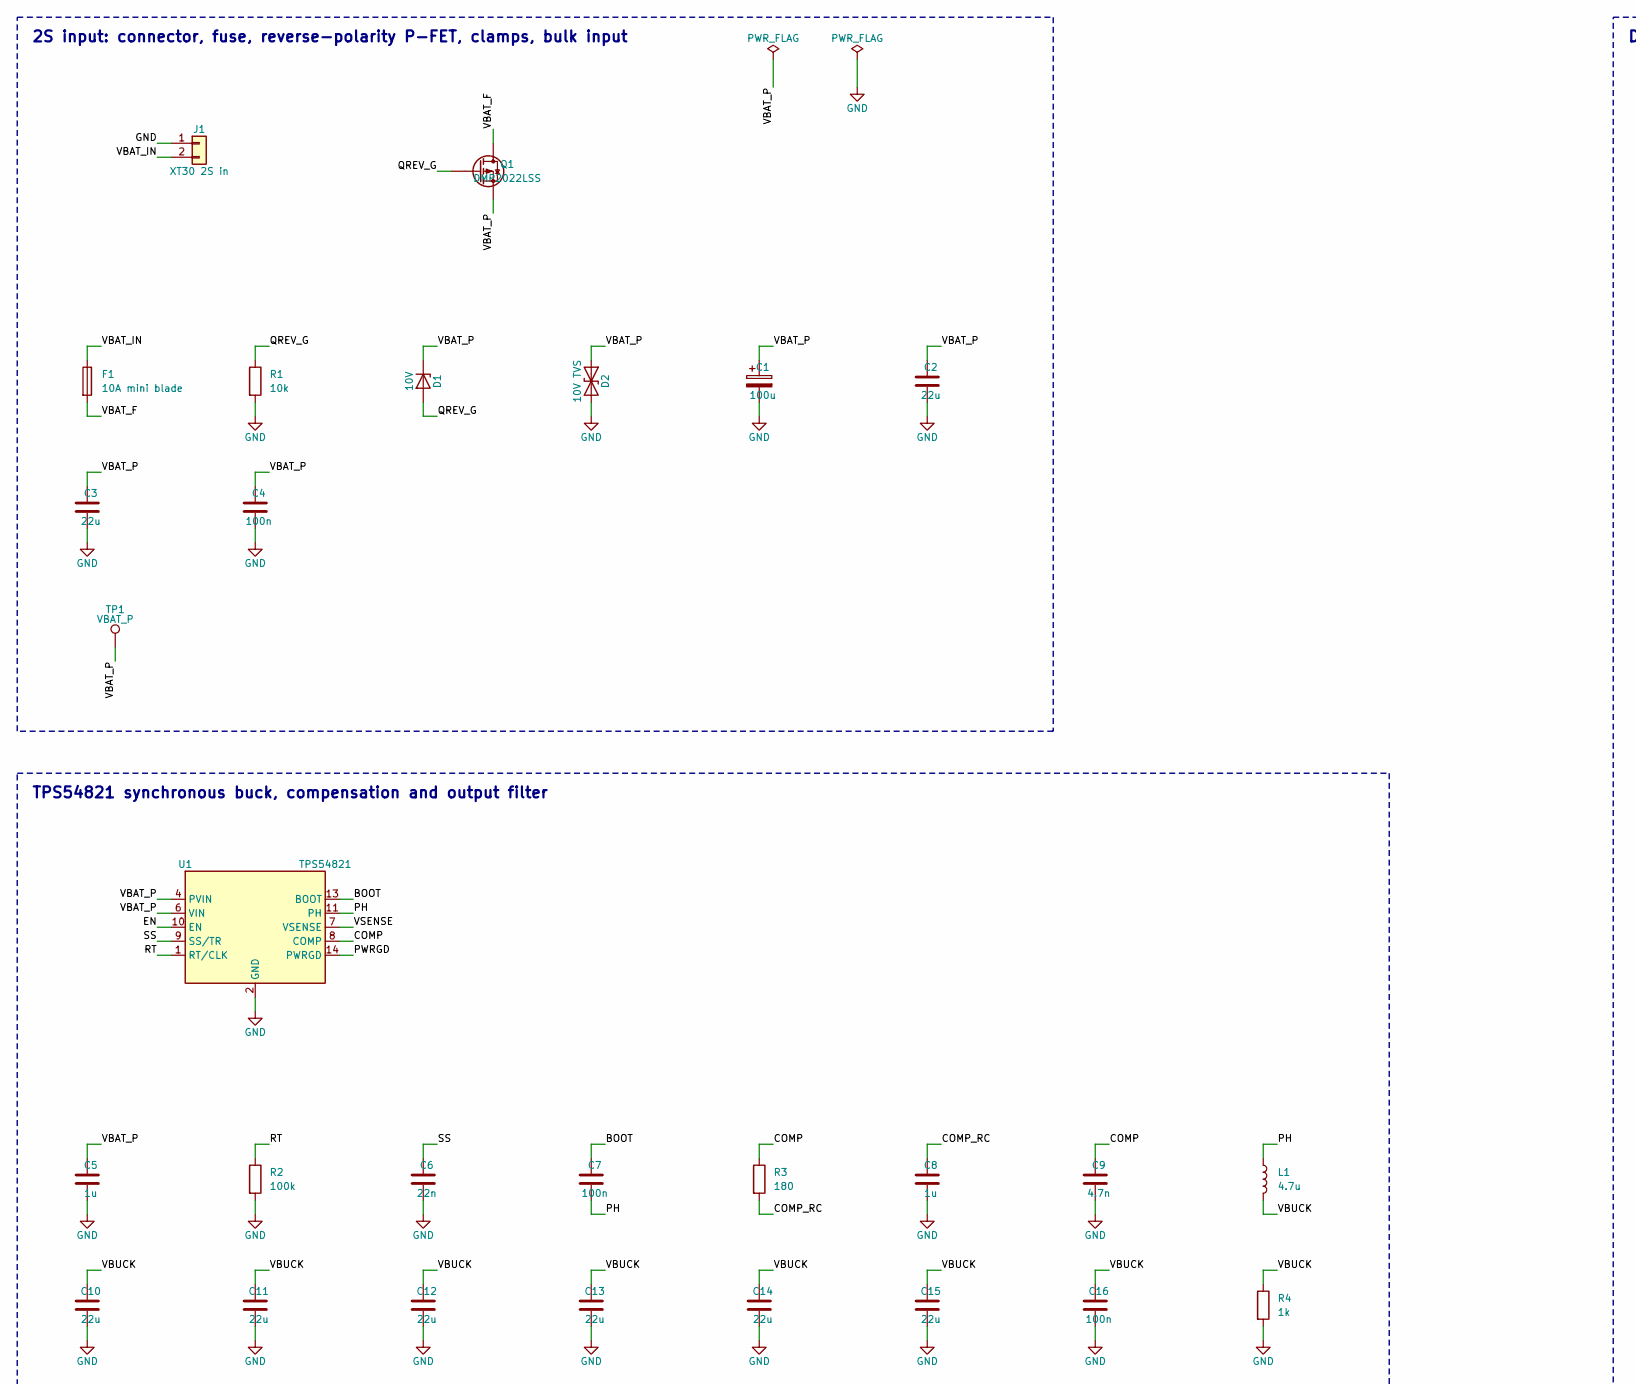
[picture p50: schematic nubm44_budget2s.kicad_sch, NUBM44 budget 2S driver, part in row 1, column 1]

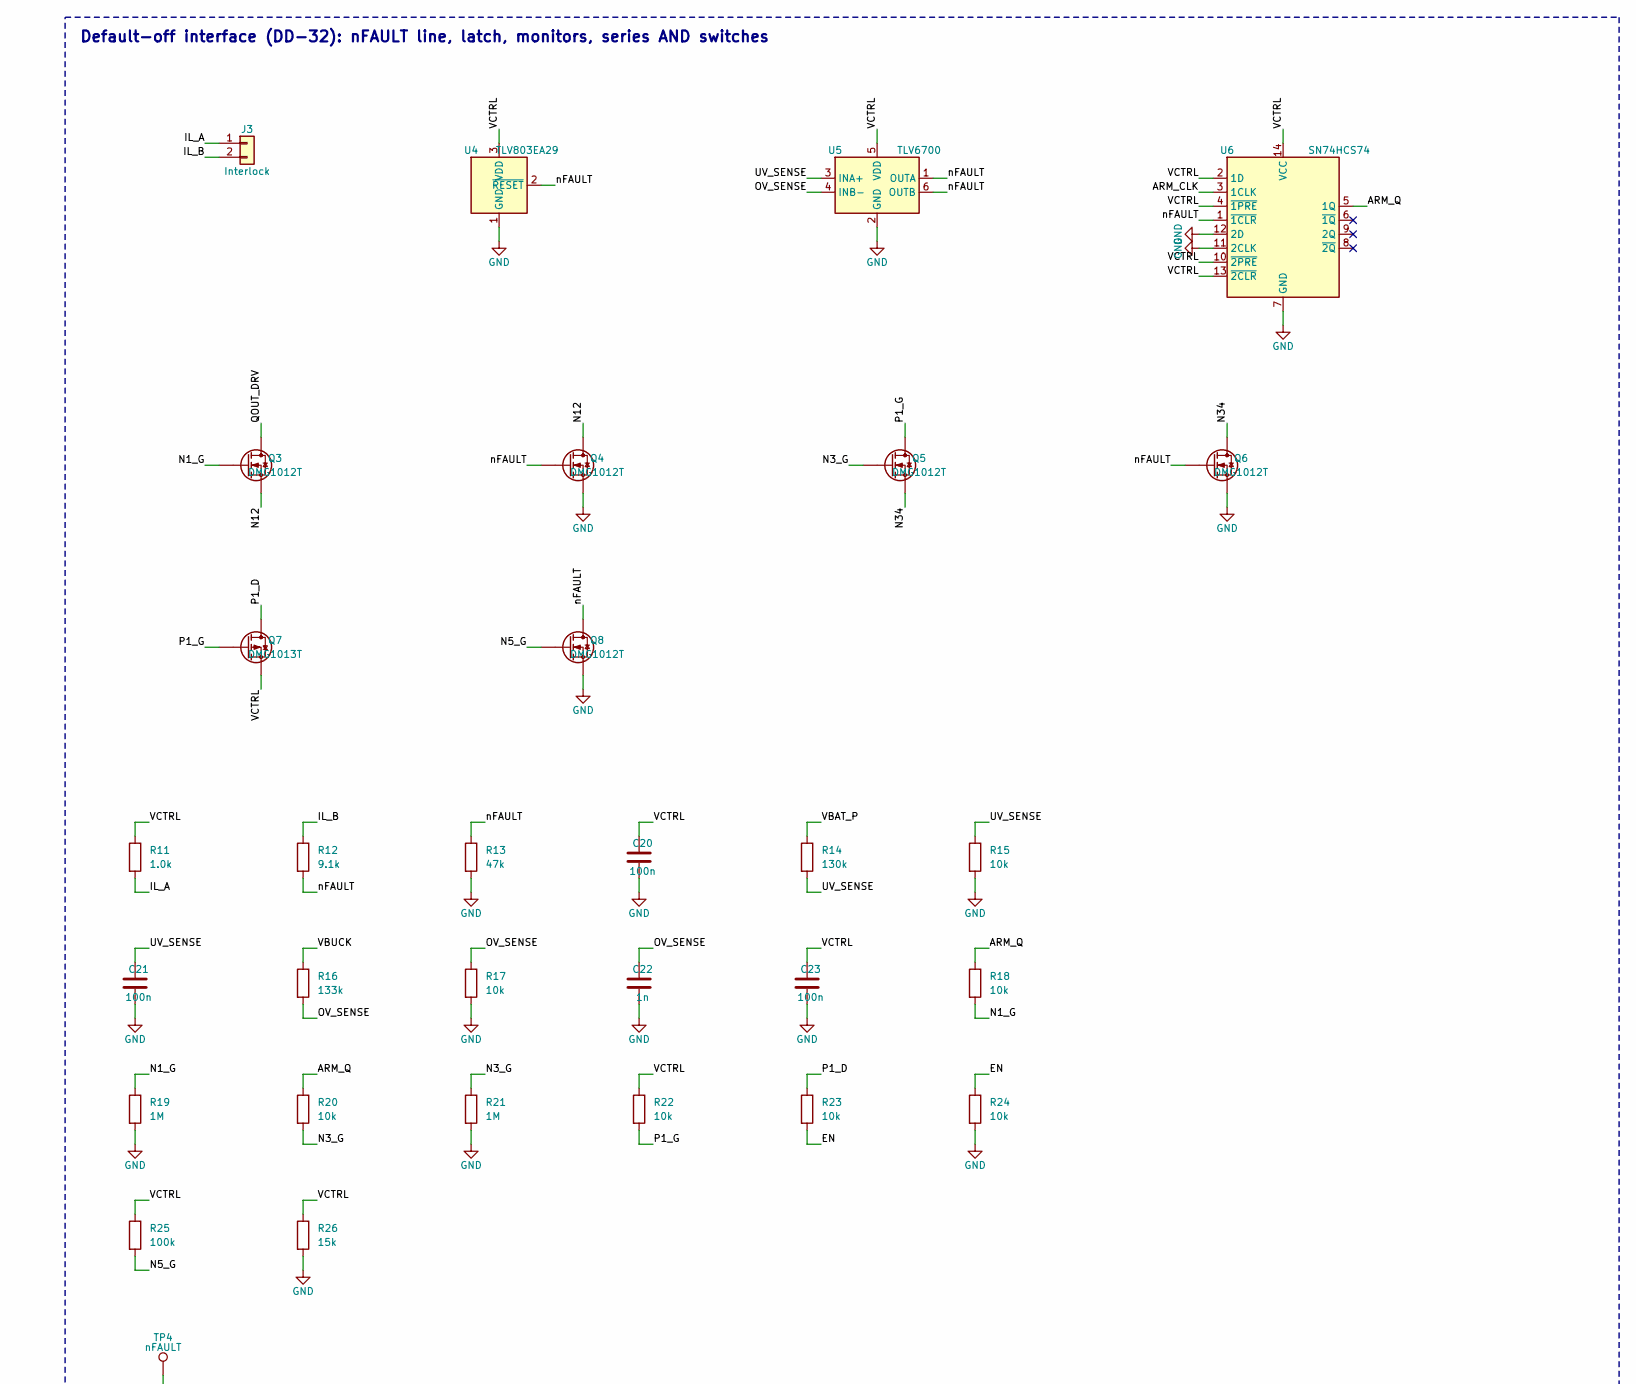
[picture p51: schematic nubm44_budget2s.kicad_sch, NUBM44 budget 2S driver, part in row 1, column 2]

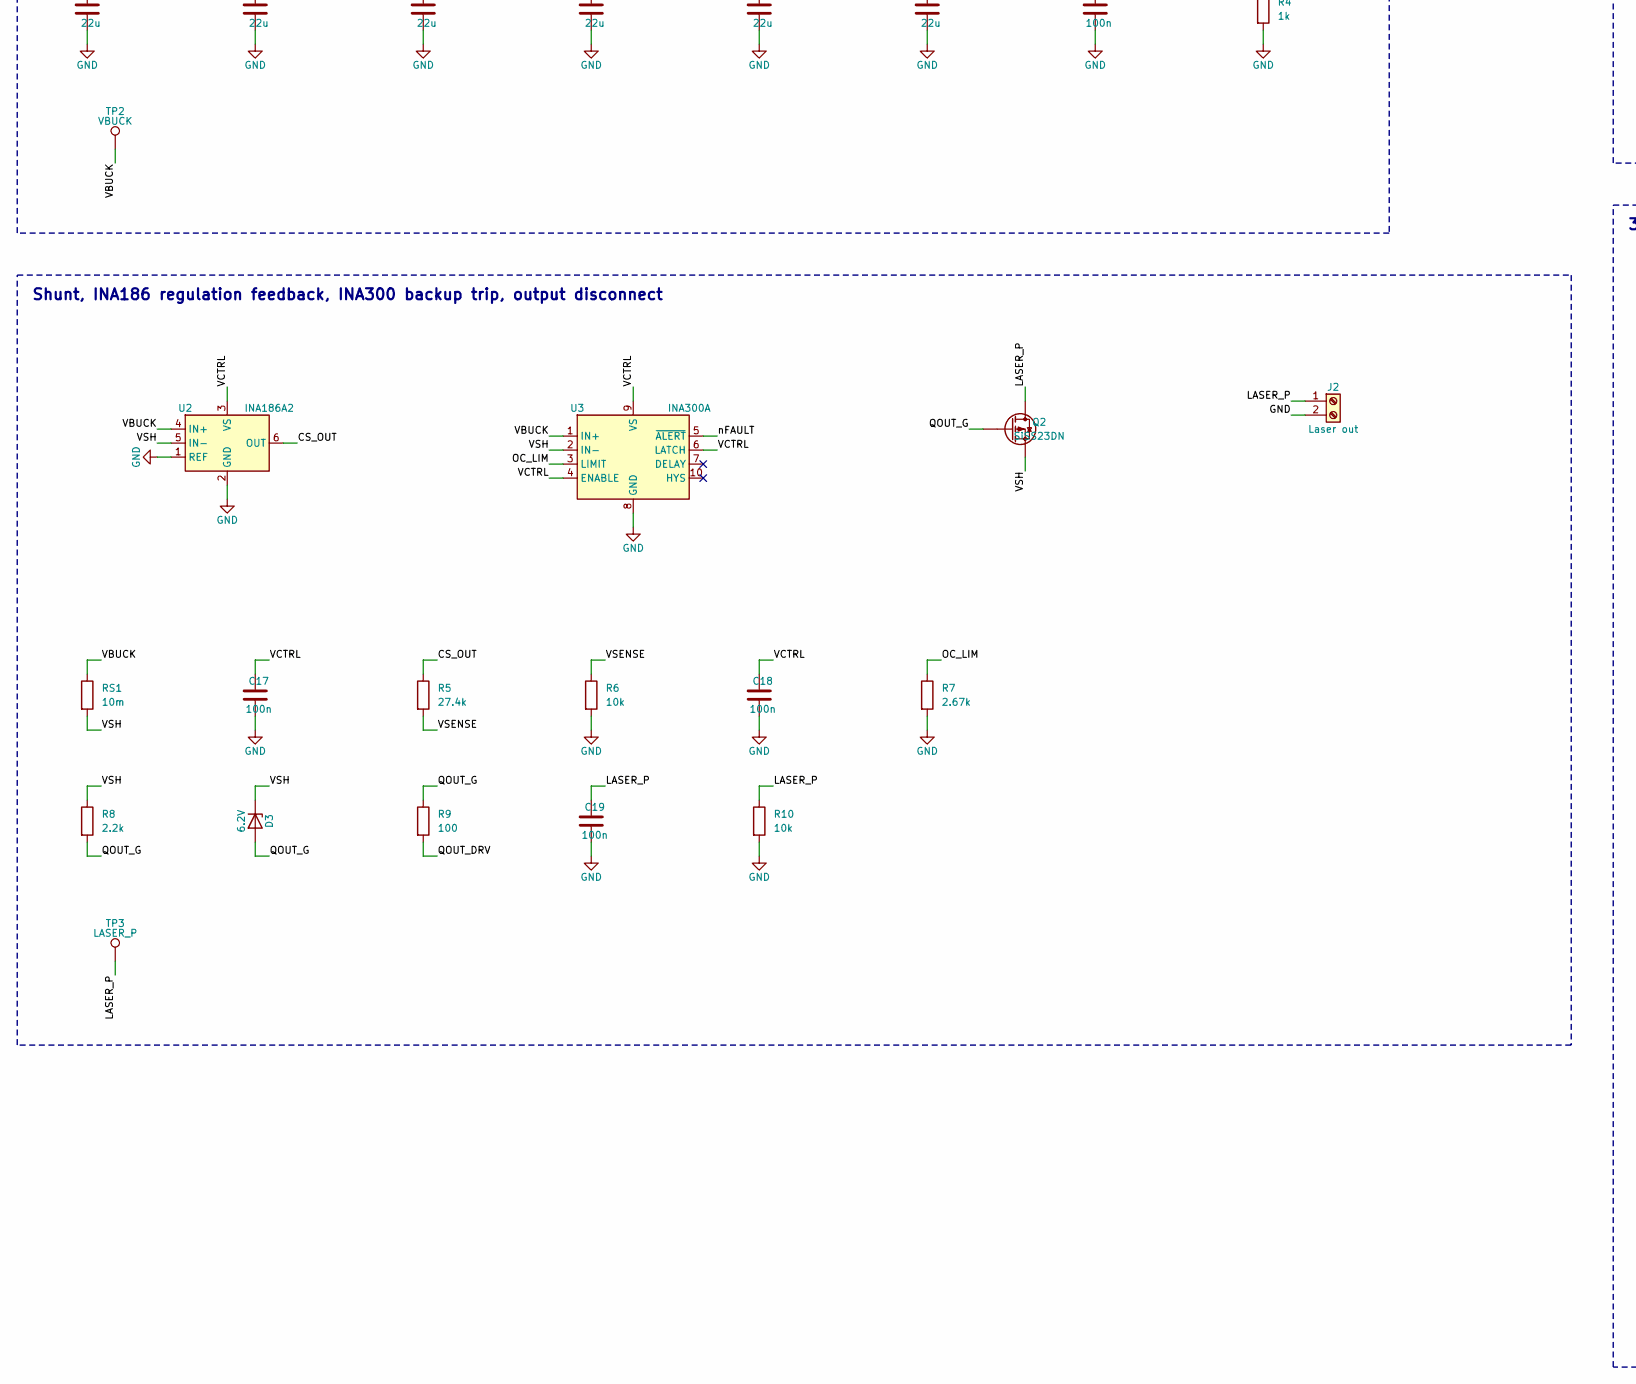
[picture p52: schematic nubm44_budget2s.kicad_sch, NUBM44 budget 2S driver, part in row 2, column 1]

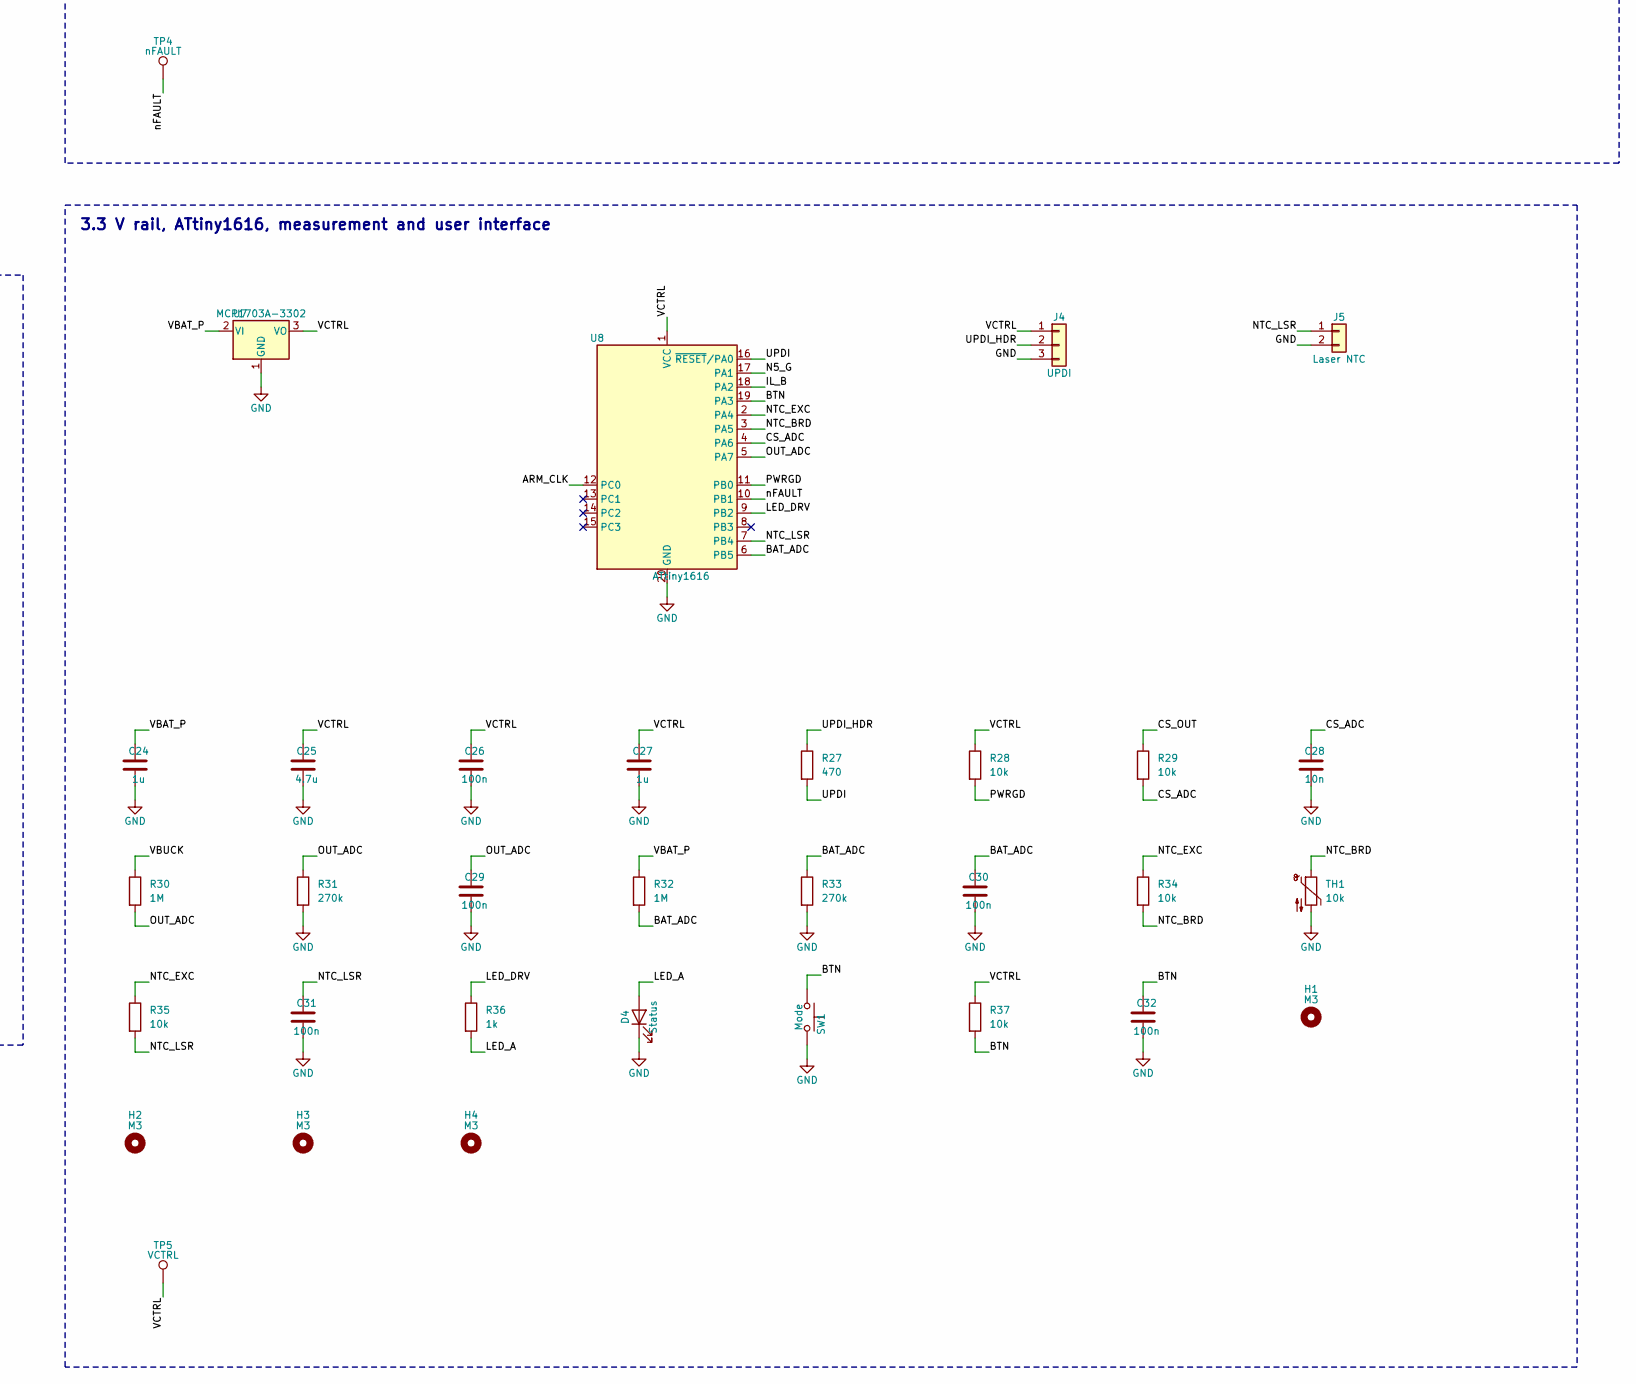
[picture p53: schematic nubm44_budget2s.kicad_sch, NUBM44 budget 2S driver, part in row 2, column 2]

Parts:
C1: 100u; CP_Elec_6.3x7.7; MPN EMVL160ARA101MF80G
C2, C3, C10, C11, C12, C13, C14, C15: 22u; C_1206_3216Metric; MPN CL31A226KAHNNNE
C4, C7, C16, C17, C18, C19, C20, C21, C23, C26, C29, C30, C31, C32: 100n; C_0603_1608Metric; MPN CC0603KRX7R9BB104
C5, C24, C27: 1u; C_0603_1608Metric; MPN CL10A105KB8NNNC
C6: 22n; C_0603_1608Metric; MPN CL10B223KB8NNNC
C8: 1u; C_0603_1608Metric; MPN CL10B105KA8NNNC
C9: 4.7n; C_0603_1608Metric; MPN CC0603JRNPO9BN472
C22: 1n; C_0603_1608Metric; MPN 0603CG102J500NT
C25: 4.7u; C_0603_1608Metric; MPN CL10A475KO8NNNC
C28: 10n; C_0603_1608Metric; MPN 0603B103K500NT
D1: 10V; D_SOD-523; MPN BZX585-C10
D2: 10V TVS; D_SMA; MPN SMAJ10CA
D3: 6.2V; D_SOD-523; MPN BZX585-C6V2
D4: Status; LED_0805_2012Metric; MPN KT-0805Y
F1: 10A mini blade; Fuseholder_Blade_Mini_Keystone_3568; MPN 3568
H1, H2, H3, H4: M3; MountingHole_3.2mm_M3
J1: XT30 2S in; AMASS_XT30PW-M_1x02_P2.50mm_Horizontal; MPN XT30PW-M
J2: Laser out; TerminalBlock_MaiXu_MX126-5.0-02P_1x02_P5.00mm; MPN MX126-5.0-02P
J3: Interlock; JST_PH_B2B-PH-K_1x02_P2.00mm_Vertical; MPN B2B-PH-K-S
J4: UPDI; PinHeader_1x03_P2.54mm_Vertical; MPN 2.54-1*3P
J5: Laser NTC; JST_PH_B2B-PH-K_1x02_P2.00mm_Vertical; MPN B2B-PH-K-S
L1: 4.7u; L_Bourns_SRP1245A; MPN SRP1265A-4R7M
Q1: DMP2022LSS; SOIC-8_3.9x4.9mm_P1.27mm; MPN DMP2022LSS-13
Q2: SiSS23DN; Vishay_PowerPAK_1212-8_Single; MPN SISS23DN-T1-GE3
Q3, Q4, Q5, Q6, Q8: DMG1012T; SOT-523; MPN DMG1012T-7
Q7: DMG1013T; SOT-523; MPN DMG1013T-7
R1, R10, R18, R20, R22, R23, R24, R28, R29, R34, R35, R37: 10k; R_0603_1608Metric; MPN 0603WAF1002T5E
R2, R25: 100k; R_0603_1608Metric; MPN 0603WAF1003T5E
R3: 180; R_0603_1608Metric; MPN 0603WAF1800T5E
R4: 1k; R_0805_2012Metric; MPN 0805W8F1001T5E
R5: 27.4k; R_0603_1608Metric; MPN ERA-3AEB2742V
R6, R15, R17: 10k; R_0603_1608Metric; MPN ERA-3AEB103V
R7: 2.67k; R_0603_1608Metric; MPN TNPW06032K67BEEA
R8: 2.2k; R_0603_1608Metric; MPN 0603WAF2201T5E
R9: 100; R_0603_1608Metric; MPN 0603WAF1000T5E
R11: 1.0k; R_0603_1608Metric; MPN 0603WAF1001T5E
R12: 9.1k; R_0603_1608Metric; MPN RC0603FR-079K1L
R13: 47k; R_0603_1608Metric; MPN 0603WAF4702T5E
R14: 130k; R_0603_1608Metric; MPN ERA-3AEB134V
R16: 133k; R_0603_1608Metric; MPN RT0603BRD07133KL
R19, R21, R30, R32: 1M; R_0603_1608Metric; MPN 0603WAF1004T5E
R26: 15k; R_0603_1608Metric; MPN 0603WAF1502T5E
R27: 470; R_0603_1608Metric; MPN 0603WAF4700T5E
R31, R33: 270k; R_0603_1608Metric; MPN 0603WAF2703T5E
R36: 1k; R_0603_1608Metric; MPN 0603WAF1001T5E
RS1: 10m; R_2512_6332Metric; MPN WSL2512R0100FEA
SW1: Mode; SW_SPST_TL3342; MPN TL3342F160QG/TR
TH1: 10k; R_0603_1608Metric; MPN NCP18XH103F03RB
TP1: VBAT_P; TestPoint_Pad_D2.0mm
TP2: VBUCK; TestPoint_Pad_D2.0mm
TP3: LASER_P; TestPoint_Pad_D2.0mm
TP4: nFAULT; TestPoint_Pad_D2.0mm
TP5: VCTRL; TestPoint_Pad_D2.0mm
U1: TPS54821; TI_RHL0014A_VQFN-14-1EP_3.5x3.5mm_P0.5mm; MPN TPS54821RHLR
U2: INA186A2; SOT-363_SC-70-6; MPN INA186A2IDCKR
U3: INA300A; MSOP-10_3x3mm_P0.5mm; MPN INA300AIDGSR
U4: TLV803EA29; SOT-23; MPN TLV803EA29DBZR
U5: TLV6700; SOT-23-6; MPN TLV6700DDCR
U6: SN74HCS74; SOIC-14_3.9x8.7mm_P1.27mm; MPN SN74HCS74DR
U7: MCP1703A-3302; SOT-89-3; MPN MCP1703AT-3302E/MB
U8: ATtiny1616; SOIC-20W_7.5x12.8mm_P1.27mm; MPN ATTINY1616-SN

Connections:
/ARM_CLK: U6.3 (1CLK), U8.12 (PC0)
/ARM_Q: R18.1, R20.1, U6.5 (1Q)
/BAT_ADC: C30.1, R32.2, R33.1, U8.6 (PB5)
/BOOT: C7.1, U1.13 (BOOT)
/BTN: C32.1, R37.2, SW1.1, U8.19 (PA3)
/COMP: C9.1, R3.1, U1.8 (COMP)
/COMP_RC: C8.1, R3.2
/CS_ADC: C28.1, R29.2, U8.4 (PA6)
/CS_OUT: R5.1, R29.1, U2.6 (OUT)
/EN: R23.2, R24.1, U1.10 (EN)
/IL_A: J3.1, R11.2
/IL_B: J3.2, R12.1, U8.18 (PA2)
/LASER_P: C19.1, J2.1, Q2.5 (D), R10.1, TP3.1
/LED_A: D4.2 (A), R36.2
/LED_DRV: R36.1, U8.9 (PB2)
/N1_G: Q3.1 (G), R18.2, R19.1
/N3_G: Q5.1 (G), R20.2, R21.1
/N5_G: Q8.1 (G), R25.2, U8.17 (PA1)
/N12: Q3.2 (S), Q4.3 (D)
/N34: Q5.2 (S), Q6.3 (D)
/NTC_BRD: R34.2, TH1.1, U8.3 (PA5)
/NTC_EXC: R34.1, R35.1, U8.2 (PA4)
/NTC_LSR: C31.1, J5.1, R35.2, U8.7 (PB4)
/OC_LIM: R7.1, U3.3 (LIMIT)
/OUT_ADC: C29.1, R30.2, R31.1, U8.5 (PA7)
/OV_SENSE: C22.1, R16.2, R17.1, U5.4 (INB-)
/P1_D: Q7.3 (D), R23.1
/P1_G: Q5.3 (D), Q7.1 (G), R22.2
/PH: C7.2, L1.1, U1.11 (PH), U1.12 (PH)
/PWRGD: R28.2, U1.14 (PWRGD), U8.11 (PB0)
/QOUT_DRV: Q3.3 (D), R9.2
/QOUT_G: D3.2 (A), Q2.4 (G), R8.2, R9.1
/QREV_G: D1.2 (A), Q1.4 (G), R1.1
/RT: R2.1, U1.1 (RT/CLK)
/SS: C6.1, U1.9 (SS/TR)
/UPDI: R27.2, U8.16 (~RESET/PA0)
/UPDI_HDR: J4.2, R27.1
/UV_SENSE: C21.1, R14.2, R15.1, U5.3 (INA+)
/VBAT_F: F1.2, Q1.5 (D), Q1.6 (D), Q1.7 (D), Q1.8 (D)
/VBAT_IN: F1.1, J1.2
/VBAT_P: C1.1, C2.1, C3.1, C4.1, C5.1, C24.1, D1.1 (K), D2.1 (A1), Q1.1 (S), Q1.2 (S), Q1.3 (S), R14.1, R32.1, TP1.1, U1.4 (PVIN), U1.5 (PVIN), U1.6 (VIN), U7.2 (VI)
/VBUCK: C10.1, C11.1, C12.1, C13.1, C14.1, C15.1, C16.1, L1.2, R4.1, R16.1, R30.1, RS1.1, TP2.1, U2.4 (IN+), U3.1 (IN+)
/VCTRL: C17.1, C18.1, C20.1, C23.1, C25.1, C26.1, C27.1, J4.1, Q7.2 (S), R11.1, R22.1, R25.1, R26.1, R28.1, R37.1, TP5.1, U2.3 (VS), U3.4 (ENABLE), U3.6 (LATCH), U3.9 (VS), U4.3 (VDD), U5.5 (VDD), U6.2 (1D), U6.4 (~1PRE), U6.10 (~2PRE), U6.13 (~2CLR), U6.14 (VCC), U7.3 (VO), U8.1 (VCC)
/VSENSE: R5.2, R6.1, U1.7 (VSENSE)
/VSH: D3.1 (K), Q2.1 (S), Q2.2 (S), Q2.3 (S), R8.1, RS1.2, U2.5 (IN-), U3.2 (IN-)
/nFAULT: Q4.1 (G), Q6.1 (G), Q8.3 (D), R12.2, R13.1, TP4.1, U3.5 (~ALERT), U4.2 (~RESET), U5.1 (OUTA), U5.6 (OUTB), U6.1 (~1CLR), U8.10 (PB1)
GND: C1.2, C2.2, C3.2, C4.2, C5.2, C6.2, C8.2, C9.2, C10.2, C11.2, C12.2, C13.2, C14.2, C15.2, C16.2, C17.2, C18.2, C19.2, C20.2, C21.2, C22.2, C23.2, C24.2, C25.2, C26.2, C27.2, C28.2, C29.2, C30.2, C31.2, C32.2, D2.2 (A2), D4.1 (K), J1.1, J2.2, J4.3, J5.2, Q4.2 (S), Q6.2 (S), Q8.2 (S), R1.2, R2.2, R4.2, R6.2, R7.2, R10.2, R13.2, R15.2, R17.2, R19.2, R21.2, R24.2, R26.2, R31.2, R33.2, SW1.2, TH1.2, U1.2 (GND), U1.3 (GND), U1.15 (GND), U2.1 (REF), U2.2 (GND), U3.8 (GND), U4.1 (GND), U5.2 (GND), U6.7 (GND), U6.11 (2CLK), U6.12 (2D), U7.1 (GND), U8.20 (GND)

Notes on the sheet:
Default-off interface (DD-32): nFAULT line, latch, monitors, series AND switches
Shunt, INA186 regulation feedback, INA300 backup trip, output disconnect
3.3 V rail, ATtiny1616, measurement and user interface
TPS54821 synchronous buck, compensation and output filter
2S input: connector, fuse, reverse-polarity P-FET, clamps, bulk input

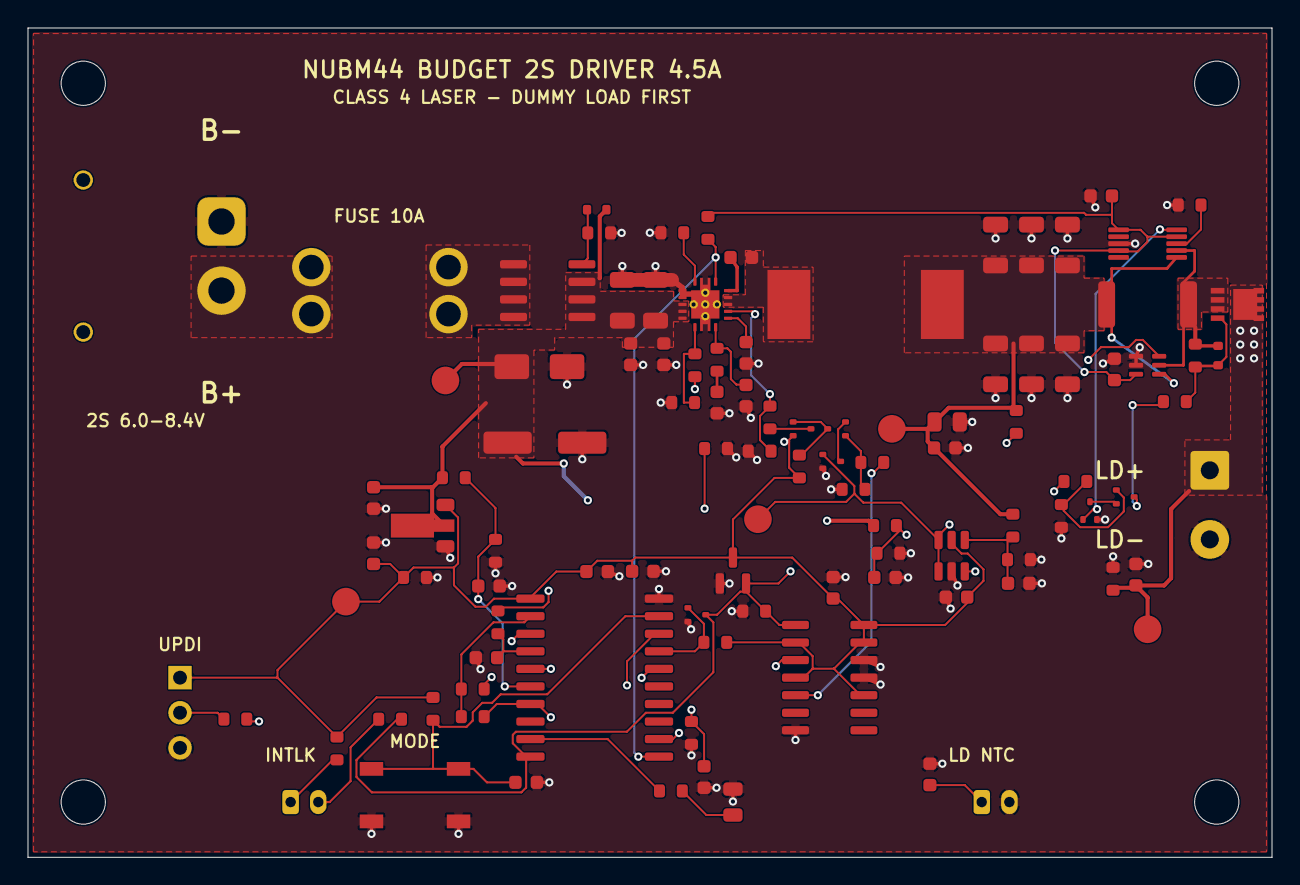
[picture p54: board nubm44_budget2s.kicad_pcb from above]

Board: 4 copper layers, 90.0 x 60.0 mm, 108 parts (0 on the bottom side), 47 nets.
