djgringoboy2003/Nub44-driver/hardware/compact-22mm/nubm44_driver.kicad_pcb

## KiCad design hardware/compact-22mm/nubm44_driver.kicad_pcb (2026-10-29)

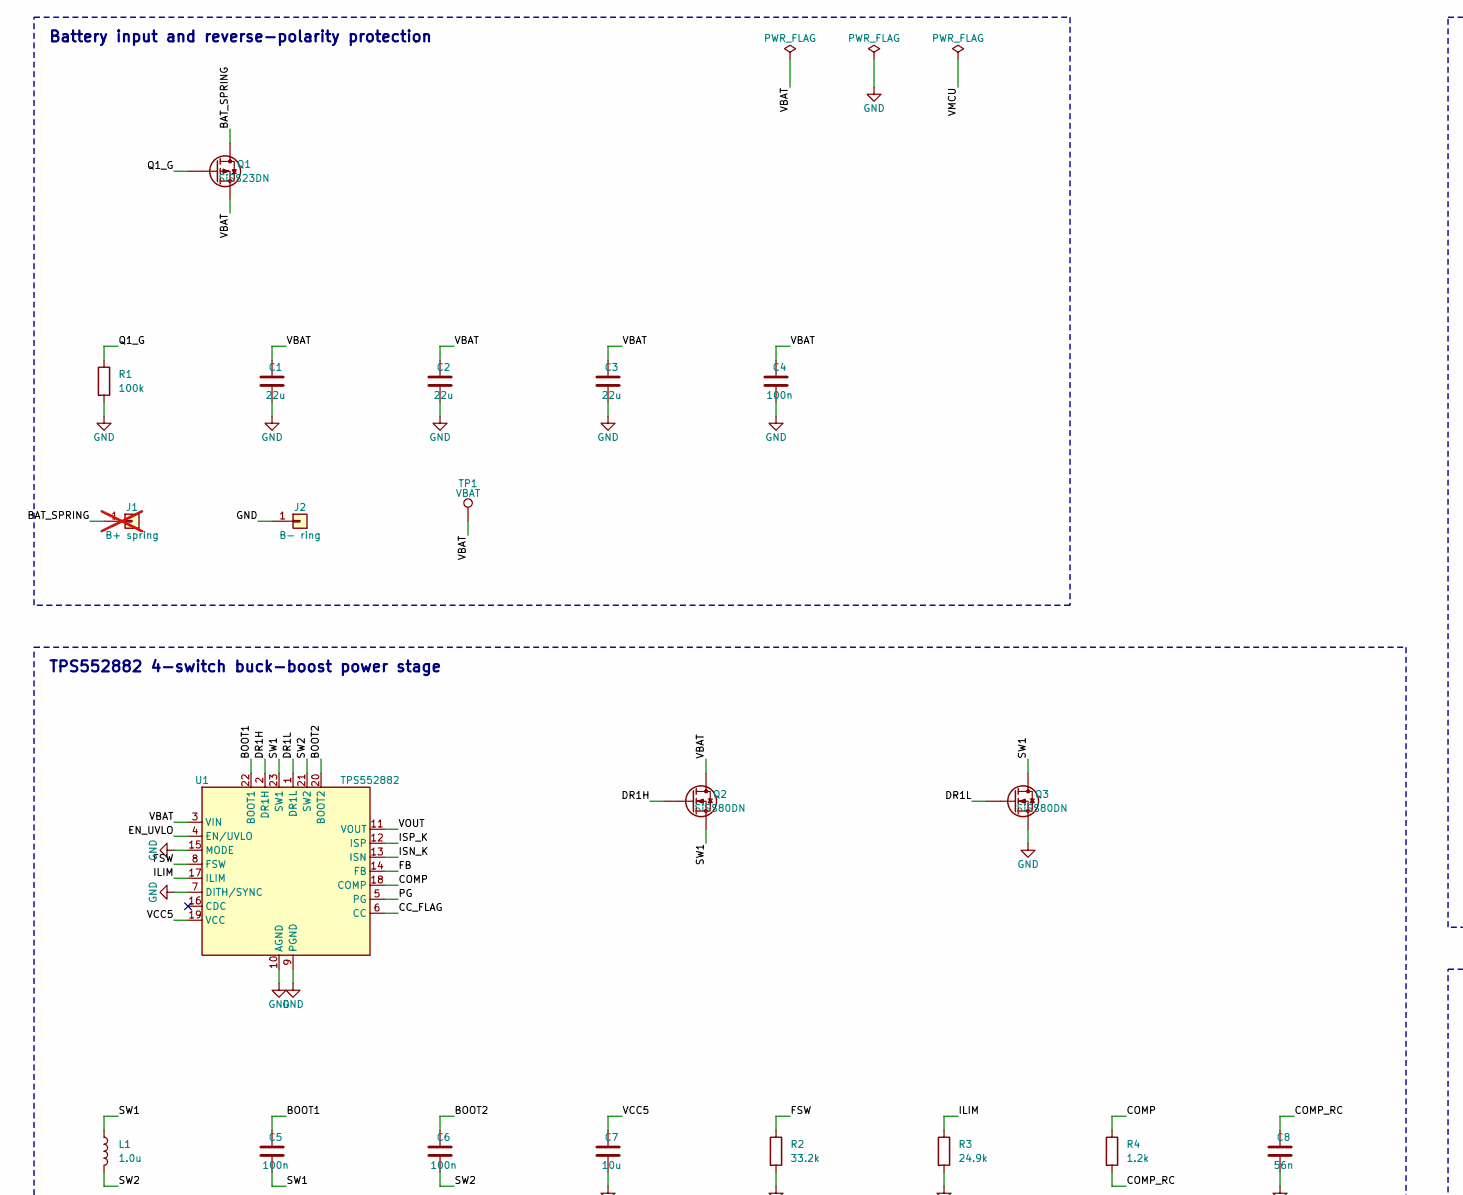
[picture p55: schematic nubm44_driver.kicad_sch, NUBM44 driver - Variant A (22 mm), part in row 1, column 1]

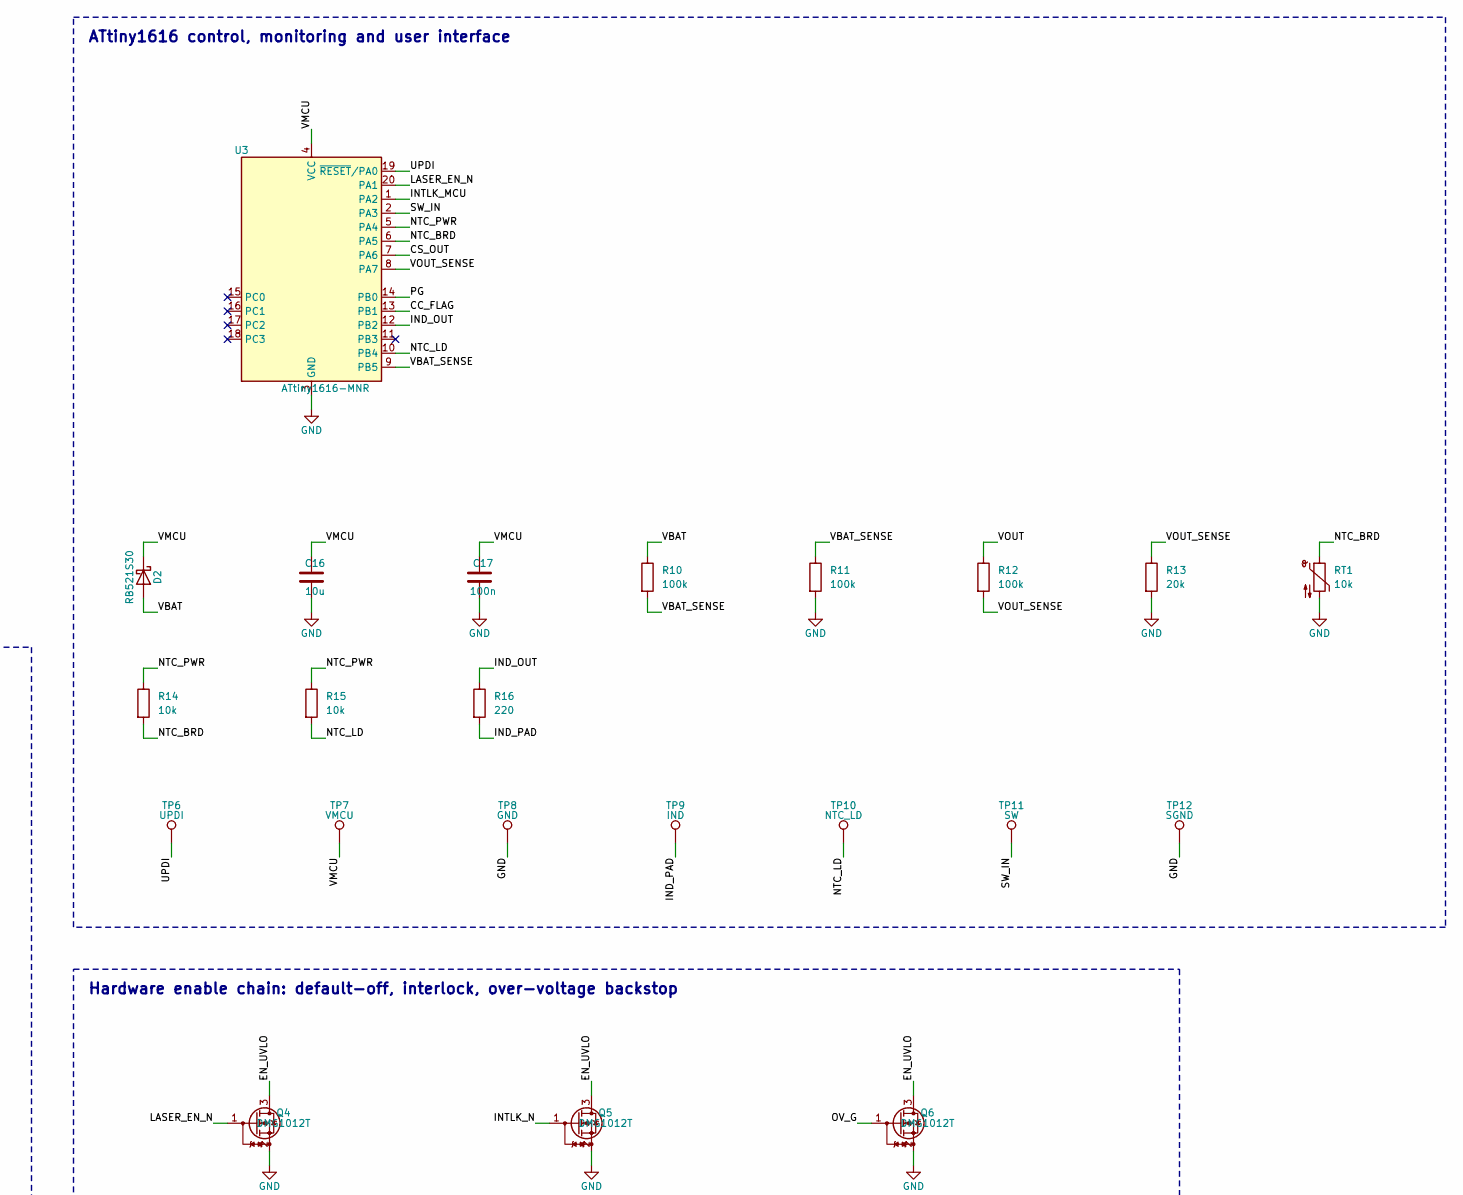
[picture p56: schematic nubm44_driver.kicad_sch, NUBM44 driver - Variant A (22 mm), part in row 1, column 2]

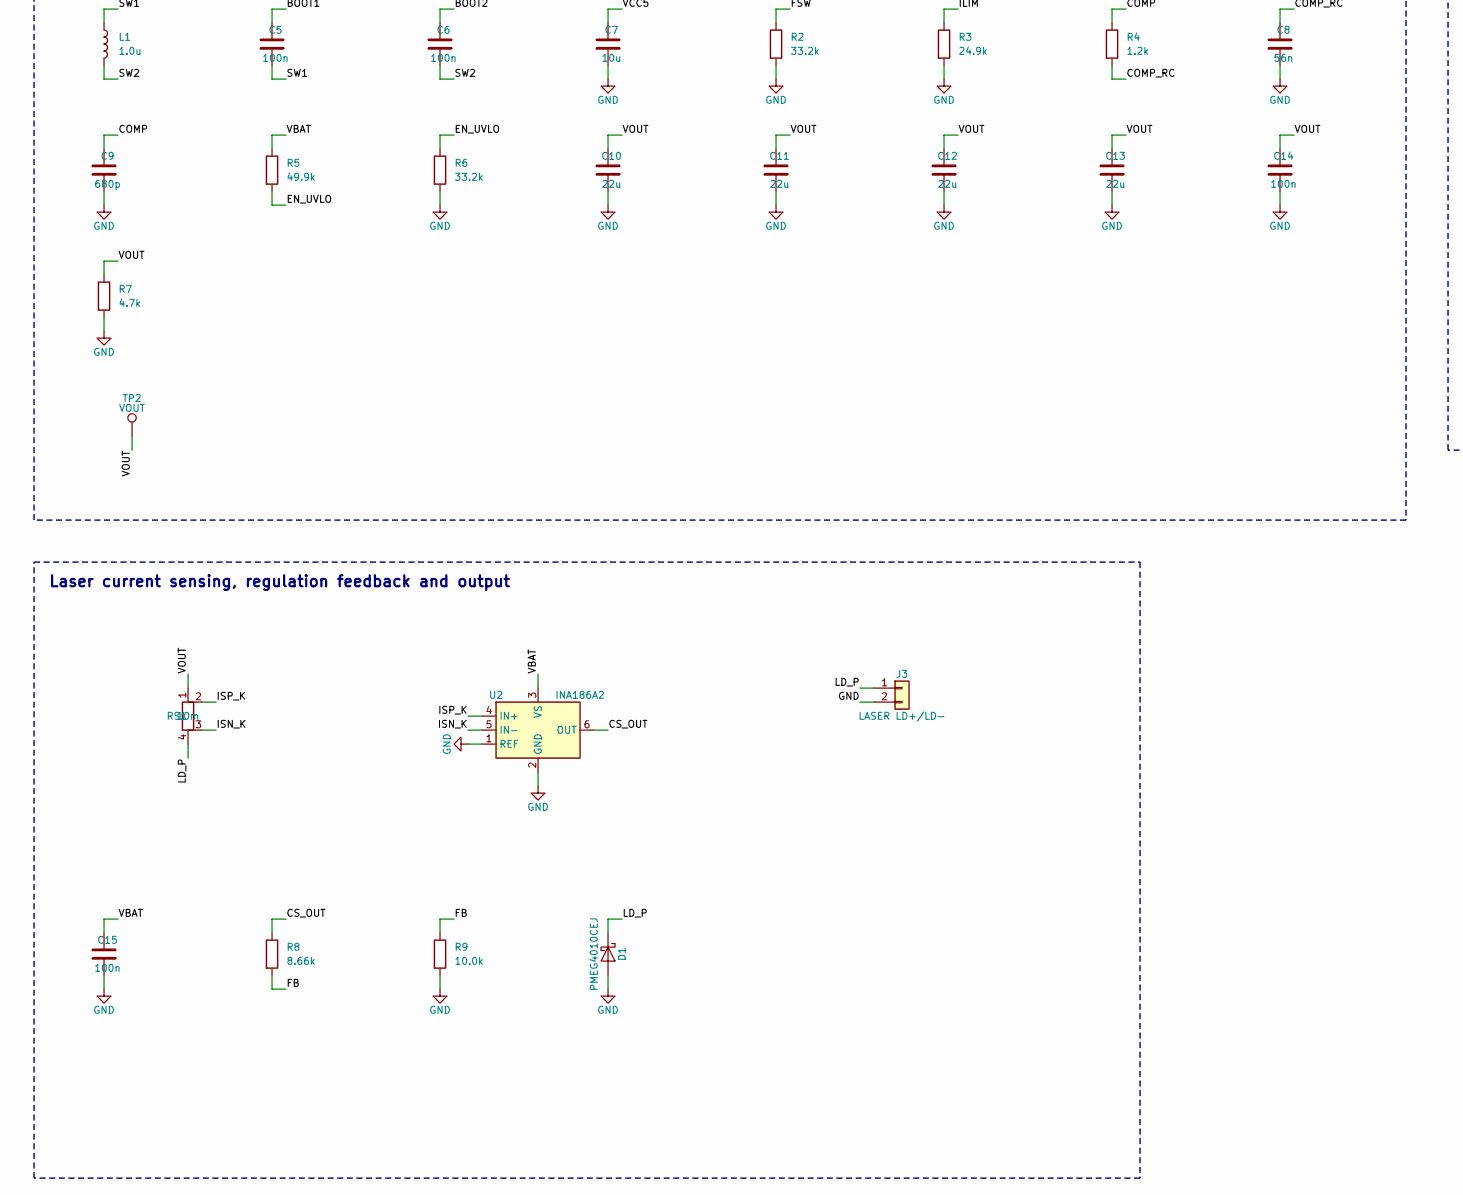
[picture p57: schematic nubm44_driver.kicad_sch, NUBM44 driver - Variant A (22 mm), part in row 2, column 1]

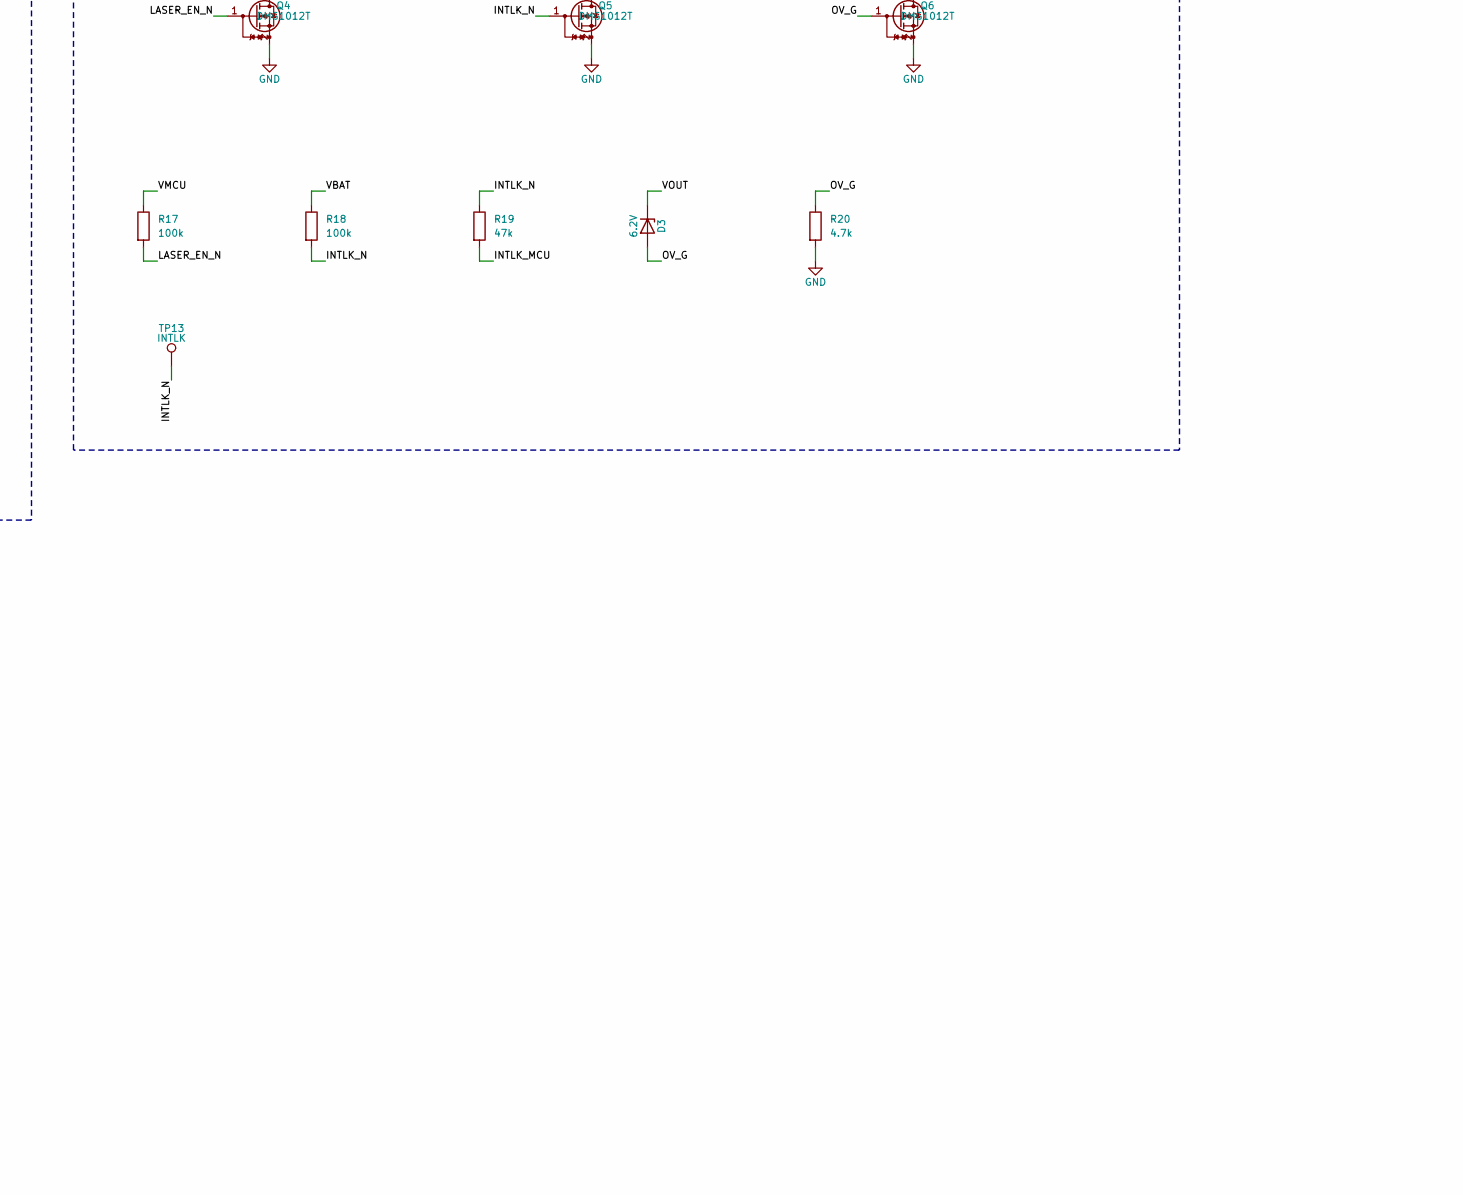
[picture p58: schematic nubm44_driver.kicad_sch, NUBM44 driver - Variant A (22 mm), part in row 2, column 2]

Parts:
C1, C2, C3, C10, C11, C12, C13: 22u; C_0805_2012Metric; MPN CL21A226MOQNNNE
C4, C5, C6, C14, C15, C17: 100n; C_0201_0603Metric; MPN GRM033R61A104KE15D
C7, C16: 10u; C_0603_1608Metric; MPN CL10A106KP8NNNC
C8: 56n; C_0402_1005Metric; MPN CL05B563KO5NNNC
C9: 680p; C_0201_0603Metric; MPN GRM0335C1H681JA01D
D1: PMEG4010CEJ; D_SOD-323F; MPN PMEG4010CEJ,115
D2: RB521S30; D_SOD-523; MPN RB521S30T1G
D3: 6.2V; D_SOD-523; MPN BZX585-C6V2
J1: B+ spring; Contact_Spring_Pad_D5.0mm; MPN UNKNOWN; not fitted
J2: B- ring; Contact_Ring_R10.20_W0.80mm
J3: LASER LD+/LD-; Laser_Pads_2x_PTH_P3.5mm_D1.1mm
L1: 1.0u; L_Coilcraft_XAL5030-XXX; MPN XGL5030-102MEC
Q1: SiSS23DN; Vishay_PowerPAK_1212-8_Single; MPN SISS23DN-T1-GE3
Q2, Q3: SiSS80DN; Vishay_PowerPAK_1212-8_Single; MPN SISS80DN-T1-GE3
Q4, Q5, Q6: DMG1012T; SOT-523; MPN DMG1012T-7
R1, R10, R11, R12, R17, R18: 100k; R_0201_0603Metric; MPN RC0201FR-07100KL
R2, R6: 33.2k; R_0201_0603Metric; MPN RC0201FR-0733K2L
R3: 24.9k; R_0201_0603Metric; MPN RC0201FR-0724K9L
R4: 1.2k; R_0201_0603Metric; MPN RC0201FR-071K2L
R5: 49.9k; R_0201_0603Metric; MPN RC0201FR-0749K9L
R7, R20: 4.7k; R_0201_0603Metric; MPN RC0201FR-074K7L
R8: 8.66k; R_0402_1005Metric; MPN RT0402BRD078K66L
R9: 10.0k; R_0402_1005Metric; MPN RT0402BRD0710KL
R13: 20k; R_0201_0603Metric; MPN RC0201FR-0720KL
R14, R15: 10k; R_0201_0603Metric; MPN RC0201FR-0710KL
R16: 220; R_0201_0603Metric; MPN RC0201FR-07220RL
R19: 47k; R_0201_0603Metric; MPN RC0201FR-0747KL
RS1: 10m; R_1206_3216Metric_Kelvin; MPN MCS1632R010FER
RT1: 10k; R_0201_0603Metric; MPN NCP03XH103F05RL
TP1: VBAT; Pad_SMD_D0.8mm_B
TP2: VOUT; Pad_SMD_D0.8mm_B
TP6: UPDI; Pad_SMD_D0.8mm_B
TP7: VMCU; Pad_SMD_D0.8mm_B
TP8: GND; Pad_SMD_D0.8mm_B
TP9: IND; Pad_SMD_D1.0mm_F
TP10: NTC_LD; Pad_SMD_D1.0mm_F
TP11: SW; Pad_SMD_D1.0mm_F
TP12: SGND; Pad_SMD_D1.0mm_F
TP13: INTLK; Pad_SMD_D1.0mm_F
U1: TPS552882; TI_RPM0026A_VQFN-HR-26_4x3.5mm_P0.5mm; MPN TPS552882RPMR
U2: INA186A2; SOT-363_SC-70-6; MPN INA186A2IDCKR
U3: ATtiny1616-MNR; VQFN-20-1EP_3x3mm_P0.4mm_EP1.7x1.7mm; MPN ATTINY1616-MNR

Connections:
/BAT_SPRING: J1.1, Q1.5 (D)
/BOOT1: C5.1, U1.22 (BOOT1)
/BOOT2: C6.1, U1.20 (BOOT2)
/CC_FLAG: U1.6 (CC), U3.13 (PB1)
/COMP: C9.1, R4.1, U1.18 (COMP)
/COMP_RC: C8.1, R4.2
/CS_OUT: R8.1, U2.6 (OUT), U3.7 (PA6)
/DR1H: Q2.4 (G), U1.2 (DR1H)
/DR1L: Q3.4 (G), U1.1 (DR1L)
/EN_UVLO: Q4.3 (D), Q5.3 (D), Q6.3 (D), R5.2, R6.1, U1.4 (EN/UVLO)
/FB: R8.2, R9.1, U1.14 (FB)
/FSW: R2.1, U1.8 (FSW)
/ILIM: R3.1, U1.17 (ILIM)
/IND_OUT: R16.1, U3.12 (PB2)
/IND_PAD: R16.2, TP9.1
/INTLK_MCU: R19.2, U3.1 (PA2)
/INTLK_N: Q5.1 (G), R18.2, R19.1, TP13.1
/ISN_K: RS1.3, U1.13 (ISN), U2.5 (IN-)
/ISP_K: RS1.2, U1.12 (ISP), U2.4 (IN+)
/LASER_EN_N: Q4.1 (G), R17.2, U3.20 (PA1)
/LD_P: D1.1 (K), J3.1, RS1.4
/NTC_BRD: R14.2, RT1.1, U3.6 (PA5)
/NTC_LD: R15.2, TP10.1, U3.10 (PB4)
/NTC_PWR: R14.1, R15.1, U3.5 (PA4)
/OV_G: D3.2 (A), Q6.1 (G), R20.1
/PG: U1.5 (PG), U3.14 (PB0)
/Q1_G: Q1.4 (G), R1.1
/SW1: C5.2, L1.1, Q2.1 (S), Q2.2 (S), Q2.3 (S), Q3.5 (D), U1.23 (SW1)
/SW2: C6.2, L1.2, U1.21 (SW2), U1.25 (SW2)
/SW_IN: TP11.1, U3.2 (PA3)
/UPDI: TP6.1, U3.19 (~RESET/PA0)
/VBAT: C1.1, C2.1, C3.1, C4.1, C15.1, D2.2 (A), Q1.1 (S), Q1.2 (S), Q1.3 (S), Q2.5 (D), R5.1, R10.1, R18.1, TP1.1, U1.3 (VIN), U2.3 (VS)
/VBAT_SENSE: R10.2, R11.1, U3.9 (PB5)
/VCC5: C7.1, U1.19 (VCC)
/VMCU: C16.1, C17.1, D2.1 (K), R17.1, TP7.1, U3.4 (VCC)
/VOUT: C10.1, C11.1, C12.1, C13.1, C14.1, D3.1 (K), R7.1, R12.1, RS1.1, TP2.1, U1.11 (VOUT), U1.26 (VOUT)
/VOUT_SENSE: R12.2, R13.1, U3.8 (PA7)
GND: C1.2, C2.2, C3.2, C4.2, C7.2, C8.2, C9.2, C10.2, C11.2, C12.2, C13.2, C14.2, C15.2, C16.2, C17.2, D1.2 (A), J2.1, J3.2, Q3.1 (S), Q3.2 (S), Q3.3 (S), Q4.2 (S), Q5.2 (S), Q6.2 (S), R1.2, R2.2, R3.2, R6.2, R7.2, R9.2, R11.2, R13.2, R20.2, RT1.2, TP8.1, TP12.1, U1.7 (DITH/SYNC), U1.9 (PGND), U1.10 (AGND), U1.15 (MODE), U1.24 (PGND), U2.1 (REF), U2.2 (GND), U3.3 (GND), U3.21 (GND)

Notes on the sheet:
Battery input and reverse-polarity protection
Laser current sensing, regulation feedback and output
Hardware enable chain: default-off, interlock, over-voltage backstop
TPS552882 4-switch buck-boost power stage
ATtiny1616 control, monitoring and user interface

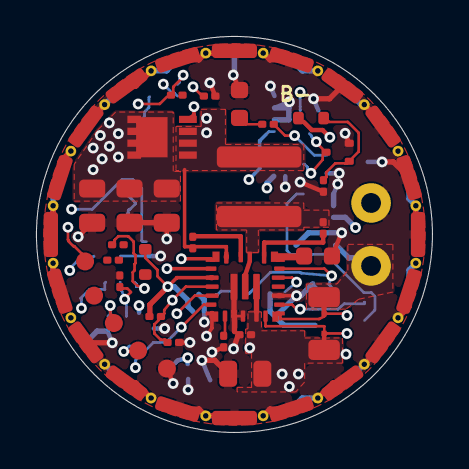
[picture p59: board nubm44_driver.kicad_pcb from above]

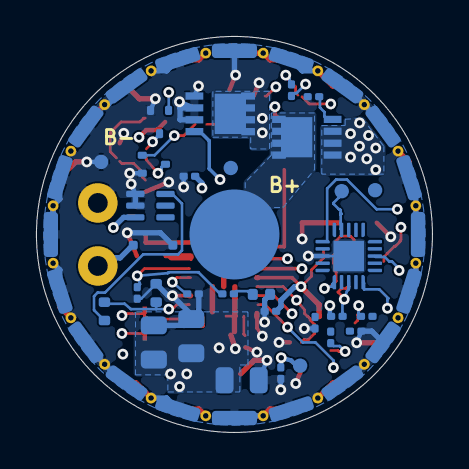
[picture p60: board nubm44_driver.kicad_pcb from below]

Board: 4 copper layers, 22.0 x 22.0 mm, 65 parts (32 on the bottom side), 38 nets.
