djgringoboy2003/Nub44-driver/(commit log)

2026-10-24 Research, architecture selection and power-stage calculations (Gate A)
    - Workspace audit: previous design files not present; concept audited from the brief
    - Requirement register with sources, verification methods and statuses
    - Research reports (laser diode, converters, components, batteries, PCBWay/CAD)
    with source indexes (datasheets kept locally, not committed)
    - Architecture comparison: TPS552882 4-switch buck-boost selected
    - Loss, loop and margin models; calculations from parameters.yaml (20/21 PASS,
    efficiency at 4.0 V estimated 94.6 % vs >95 % target)
    - Toolchain: KiCad 10.0.6 (per-user), ngspice 47, FreeRouting 2.5.0 jar on Temurin 25,
    InteractiveHtmlBom 2.12.0; idempotent se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
    [component-candidates.csv]
2026-10-24 Agent handover docs and project footprint library
    - AGENTS.md as canonical agent guide (Codex/Claude/human); CLAUDE.md imports it
    - README.md and PROGRESS.md with current state, open owner decisions and next actions
    - fpgen.py: TPS552882 RPM0026A land pattern from calibrated vector extraction of
    SLVSFC5 p.39 (verified against printed dimensions and KiCad effective pad polygons),
    spring pad, via-stitched perimeter ring, laser PTH pads, wire and test pads
    - Design decision log, architecture comparison, previous-design audit
2026-10-24 Native KiCad schematic generated from connectivity.yaml (Gate B)
    - connectivity.yaml: 68 parts with MPNs, per-variant footprints, pin-to-net map
    - Project symbols (TPS552882, INA186 from verified pin tables; PowerPAK MOSFETs
    derived from Device:Q_NMOS/Q_PMOS with pad-matched numbering) and footprints,
    upgraded to KiCad 10 format; placeholder 3D body for RPM0026A
    - build_schematic.py: block layout with packing, labels/GND/no-connects, PWR_FLAGs,
    kicad-cli upgrade + ERC + netlist export + pin-by-pin comparison
    - Result (both variants): ERC 0 errors 0 warnings; netlist identical to spec
    - tests/test_netlist_compare.py proves the checker detects injected faults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
    [nubm44_driver.kicad_sch, schematic-compact-22mm.json, schematic-evaluation-board.json]
2026-10-24 Simulation suite, firmware, PCB automation pipeline (Gates C, D in progress)
    - simulation/run_sims.py: cycle-averaged behavioural TPS552882 model in ngspice 47;
    SIM-01..SIM-11 PASS (start-up, regulation corners incl. Vf<Vbat, battery ramp,
    load change, flash, interlock, short, open load, reverse battery, loop margins)
    - firmware: ATtiny1616 state machine (app.c) + drivers (main.c); 26 host unit checks
    pass (TinyCC); target build 2.4 kB with avr-gcc 15.2.0 -Werror
    - PCB pipeline: pcbnew placement with auto small-part placer, via fields, GND fanout,
    DSN/FreeRouting/SES, pours, DRC with schematic parity, dangling-via cleanup;
    net classes applied through the API (SaveBoard/LoadBoard pi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
    [battery_step.csv, flash.csv, interlock.csv, load_step.csv, nubm44_driver.kicad_sch, open.csv, pcb-compact-22mm.json, reg_3p0_max.csv]
2026-10-24 Entry scripts, export pipeline, validation register, sourcing database, bench test plan
    - scripts/doctor|build|validate|export-pcbway|package.ps1: thin wrappers over the Python tools
    - automation/export/export_pcbway.py: Gerber/drill/BOM/CPL/PDF/iBOM package with self-check
    - automation/validation/validate.py: register + gates computed from tool reports (no hard-coded passes)
    - sourcing/: components, alternatives and known-price-only cost tables; unverified data = UNKNOWN
    - documentation/testing/test-plan.md: Gate G bench plan (dummy load first, laser safety rules)
    - PCB builder: net classes applied through the API, rules re-applied after SaveBoard, cleanup stage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
    [alternatives.csv, components.csv, costs.csv]
2026-10-24 Preserve unfinished compact PCB routing and correct handoff status
    Recover Claude's geometry cache and floorplan checker alongside the placed/routed board checkpoint. Record actual DRC failures, existing entry/export tooling, validation audit findings and next actions. Evidence: 11 Python tests passed; recovered DRC reports 33 unconnected items, 91 errors, 44 warnings and six parity warnings. No manufacturing release.
    [nubm44_driver.kicad_pcb]
2026-10-24 Route evaluation board and validate source-bound review packages
    Complete the evaluation layout with source-defined fanouts and routing corrections; repeated KiCad DRC 0 errors, warnings, unconnected and parity. Preserve compact draft: 43 unconnected, three connection-width warnings.
    Fix placement/copper/native KiCad handling; harden source-bound validation and release dependencies. Add checked PCBWay review packages, exact router checkpoints, assembly and stack-up notes, final report, updated PROGRESS and requirements, and safe review ZIP packaging.
    Evidence: 120 Python tests; firmware 26 checks and target build; doctor; both schematics ERC 0/0 and netlist exact. Both exports verify sourc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
    [BOM_PCBWay_plugin.csv, BOM_PCBWay_template.csv, components.csv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]
2026-10-25 Review power layout from routed copper; correct evaluation pours
    Add automation/review: a KiCad-side copper extractor, an exact scanline raster model and a DC
    current-flow solver over each power net, plus a report generator for the SLVSFC5 10.1 layout
    guidelines. The report covers path resistance, I2R loss, necks, via currents, ground offsets and
    the resulting setpoint shift, hot loops, gate/bootstrap/VCC loops, the ISP/ISN pair, sensitive-net
    spacing and vias near the power pins. The solver is checked against analytic cases.
    VAL-LAYOUT-<variant> only checks that each report is current; engineering/layout-review.md records
    the dispositions (DD-23).
    Evaluation board: the review found a 0.55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
    [nubm44_driver-B_Cu.gbl, nubm44_driver-B_Mask.gbs, nubm44_driver-B_Paste.gbp, nubm44_driver-B_Silkscreen.gbo, nubm44_driver-Edge_Cuts.gm1, nubm44_driver-F_Cu.gtl, nubm44_driver-F_Mask.gts, nubm44_driver-F_Paste.gtp]
2026-10-25 Record the spring-pad via keep-out as the compact routing constraint
    Measured from the extracted compact copper: the centre spring pad J1 (radius 2.50 mm) excludes
    through vias within 2.95 mm of the board centre. U1 sits above it, with 23 of its 26 pads inside that
    radius and 13 of them needing a layer change. This, not the autoroute settings, blocks most of the 43
    unconnected items. Shifting U1 2.0-2.5 mm away leaves 4 or 2 such pads.
    engineering/compact-feasibility.md records the placement options and the preferred one (move the
    L1/U1 column off the spring pad, then add explicit U1 escapes). PROGRESS next actions point the
    compact rework at it. No CAD changed; validation is unchanged (3 k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
2026-10-25 Re-floorplan the compact board around the spring-pad via keep-out
    The centre spring pad forbids through vias within 2.95 mm of the board centre, and U1 sat above it.
    L1 now covers the spring pad and U1 sits 2 mm below it, with source-defined escapes for every U1
    pin:
    - non-crossing BOOT1/SW1 lanes to C5;
    - BOOT2 over C7 to C6;
    - VCC reaching C7 in 0.6 mm, which uses compact-only 3.5 mm J3 laser pads;
    - staggered left-column vias;
    - right-column vias to the bottom compensation, ILIM and FB parts.
    On the bottom, Q1 now sits under Q2 with an 8-via VBAT field and Q3 moved right for the SW1 vias.
    The MCU moved to the bottom lower left beside its harness pads and enable chain (DD-24).
    Pipeline: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
    [CPL_PCBWay.csv, kicad_pos.csv, nubm44_driver-B_Cu.gbl, nubm44_driver-B_Mask.gbs, nubm44_driver-B_Paste.gbp, nubm44_driver-B_Silkscreen.gbo, nubm44_driver-Edge_Cuts.gm1, nubm44_driver-F_Cu.gtl]
2026-10-25 Record compact PGND and Kelvin blockers found in a follow-up attempt
    A follow-up attempt to give U1's PGND pins source vias found that the bottom output capacitor C12
    sits directly under pins 9/10, and its pads block every via position. U2's Kelvin inputs also have
    no via landing that is free on both sides, because L1's SW2 pad lies above U2's left pins.
    The attempt was reverted to the committed routed draft (DRC 0/6/31/0); its evidence still matches.
    engineering/compact-feasibility.md now names the prerequisite moves: relocate C12, swap U2 and D1,
    and the FB route from R9 to R8 that clears C9 and the ISN via.
2026-10-25 Record the battery polarity decision and mark it on both boards
    Owner decision (2026-10-25): either battery orientation is acceptable provided
    the board marks it clearly. The definition stays centre spring = B+, ring = B-
    (DD-12); REQ-BAT-04 moves from BLOCKED to DESIGNED.
    - Compact board: new silkscreen labels "B+" beside the spring pad and "B-"
    beside the ring (bottom), plus "B-" on top. Spots were chosen clear of
    courtyards, pads and vias.
    - Evaluation board: label strokes raised from 0.12 mm to PCBWay's legend
    limit (MFG-01: stroke >= 0.15 mm and >= height / 5).
    - Both labels were applied by finish on the archived router sessions (no
    copper change); checkpoint manifests re-captu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
    [nubm44_driver-B_Cu.gbl, nubm44_driver-B_Mask.gbs, nubm44_driver-B_Paste.gbp, nubm44_driver-B_Silkscreen.gbo, nubm44_driver-Edge_Cuts.gm1, nubm44_driver-F_Cu.gtl, nubm44_driver-F_Mask.gts, nubm44_driver-F_Paste.gtp]
2026-10-25 Grid-route the compact board: 20 open items (was 31), better power paths
    New negotiated-congestion grid router (automation/placement/grid_route.py):
    A* on a 0.05 mm grid over F/In2/B with through vias against the exact
    placed copper, PathFinder negotiation between nets, and an exact segment
    clearance check. It writes the generated grid_routes section of
    placement.yaml, which the build adds after the via fields and before the
    GND fanout; --partial keeps conflict-free nets and leaves clashing ones to
    FreeRouting.
    Compact layout (DD-25):
    - In2 carries signals only (no VBAT pour); the F VBAT pour covers all eight
    field vias.
    - MCU moved below C1-C3 and rotated 0 deg with a part-free escape ri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
    [CPL_PCBWay.csv, kicad_pos.csv, nubm44_driver-B_Cu.gbl, nubm44_driver-B_Mask.gbs, nubm44_driver-B_Paste.gbp, nubm44_driver-B_Silkscreen.gbo, nubm44_driver-Edge_Cuts.gm1, nubm44_driver-F_Cu.gtl]
2026-10-25 Simulate compact routing options; add per-layer rules to the grid router
    grid_route.py accepts optional layer_rules (clearance, maximum width per
    layer) for fine-line experiments; default behaviour is unchanged.
    Simulations on a copy of the placed compact copper (no project file
    changed): moving U3's and C3's ground fanout vias removes the two
    unreachable MCU pins, but an MCU pin swap and 0.10/0.13 mm inner lines,
    alone or combined, still leave about 19 nets clashing after 10 negotiation
    passes. Recorded in engineering/compact-feasibility.md: the 22 mm board is
    short of routing capacity; completing it needs HDI, a placement
    re-architecture or fewer parts.
    Tests: 147 pass.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
2026-10-25 Record owner decisions: 4.0 A kept, efficiency deviation, evaluation first
    Owner decisions (2026-10-25):
    - Setpoint stays 4.0 A; the diode-life risk is accepted (DD-13).
    REQ-OUT-01 -> VERIFIED-SIM (calc sizing + SIM-03), bench test pending.
    - Efficiency deviation accepted: REQ-PWR-02 becomes >= 94 % at 4.0 V and
    4 A (DD-26). parameters.yaml gains current.efficiency_target_pct, which
    power_stage.py checks; 94.59 % passes. REQ-PWR-02 -> VERIFIED-CALC; the
    T1.7 bench measurement remains the evidence of record.
    - Evaluation board first: the compact 22 mm board stays a routing draft
    until bench data exists (compact-feasibility.md, PROGRESS next actions).
    Evidence regenerated in order: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
    [nubm44_driver-B_Cu.gbl, nubm44_driver-B_Mask.gbs, nubm44_driver-B_Paste.gbp, nubm44_driver-B_Silkscreen.gbo, nubm44_driver-Edge_Cuts.gm1, nubm44_driver-F_Cu.gtl, nubm44_driver-F_Mask.gts, nubm44_driver-F_Paste.gtp]
2026-10-26 Documentation audit: current status everywhere, superseded text removed
    Audited every hand-written Markdown file against the current design and
    owner decisions; generated reports were regenerated rather than edited.
    - PROGRESS.md: current state rewritten (one block of owner decisions, one per
    board, open limitations, next actions); stale AT-RISK/undecided items and
    the superseded DD-24 status block removed; log keeps the history.
    - README/AGENTS: status of both variants; complete repository map, firmware
    toolchain (avr-gcc 15.2.0, TinyCC 0.9.27); pitfall on checkpoint
    manifests.
    - engineering: compact-feasibility restructured (parked, simulated options,
    current layout); DD-07 corr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
    [nubm44_driver-B_Cu.gbl, nubm44_driver-B_Mask.gbs, nubm44_driver-B_Paste.gbp, nubm44_driver-B_Silkscreen.gbo, nubm44_driver-Edge_Cuts.gm1, nubm44_driver-F_Cu.gtl, nubm44_driver-F_Mask.gts, nubm44_driver-F_Paste.gtp]
2026-10-26 Record the GitHub remote in the handover docs
    The repository now has remote origin (private GitHub repository
    djgringoboy2003/Nub44-driver) with main tracking origin/main. PROGRESS.md
    open limitations and log updated; AGENTS.md commit conventions ask for a
    push after each milestone commit.
2026-10-26 Add independent audit register, risk register, roadmap and implementation log
    Baseline before changes: 147 Python tests pass; firmware 26/26 host checks and
    the ATtiny1616 build pass; the validation register shows the two known
    compact-board failures. 50 findings recorded (no critical; 9 high), each
    verified against the code and the local datasheet copies.
2026-10-26 Firmware: fix supervision and measurement-chain defects, add HAL and host tests
    Audit findings fixed (DD-28; no threshold, setpoint or hardware change):
    - board NTC open/short now latches fault 11; a fitted laser NTC that fails latches 12
    - watchdog cleared only after a full supervision cycle; watchdog/unexpected
    resets latch FAULT_INTERNAL instead of re-arming emission
    - ADC0 referenced to VDD with 1.1 V calibration (2.5 V reference was used below
    its 2.9 V VDD minimum); ADC1/DAC0/DAC2 on the 1.5 V reference
    - DAC2/AC2 reference moved from VREF.CTRLC to CTRLD (the power-loss trip sat
    near 0.57 V, so the short-click mode change could not work); DAC2 runs in standby
    - debounced switch,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
    [app.c, app.h, build.py, check.h, conv.c, conv.h, fuses.h, fw.c]
2026-10-26 Bind calculation and simulation evidence to inputs; FRA loop check; release levels
    - automation/nubm44/evidence.py: manifests with input/output hashes and tool
    versions; power_stage.py and run_sims.py write them and exit 1 on failure
    - validate.py: strict parsing and re-judging of saved statuses, stale or edited
    evidence fails, modes (full/fast/eval-cad/compact-cad/manufacturing/bench),
    --rerun-stale, --strict, known-limitations baseline, gate evidence classes,
    Gate G from bench summary, per-board readiness
    - SIM-11 is a frequency-response analysis of the ngspice deck at three corners
    (PM 114-122 deg, GM 11.9-12.6 dB; Python model within -12.7 % / -5.0 deg);
    new SIM-12 tolerance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
    [nubm44_driver-B_Cu.gbl, nubm44_driver-B_Mask.gbs, nubm44_driver-B_Paste.gbp, nubm44_driver-B_Silkscreen.gbo, nubm44_driver-Edge_Cuts.gm1, nubm44_driver-F_Cu.gtl, nubm44_driver-F_Mask.gts, nubm44_driver-F_Paste.gtp]
2026-10-26 Sourcing verification: stale records, package, voltage and power derating checks
    - sourcing/check_sourcing.py (validator entry VAL-SRC, required for
    PROTOTYPE_CANDIDATE): CSV vs connectivity.yaml, MPN size/dielectric/voltage
    decode vs footprint and description, capacitor voltage per net, resistor power
    in normal operation and single faults, rating table vs parameters.yaml, data
    age, datasheet links, non-drop-in alternates
    - build_sourcing.py split into compute()/build() (identical CSV bytes)
    - Result: 0 FAIL, 29 WARN (compact BOM descriptions AUD-MFG-03; C14 derating;
    R16 overload in an LED-pad short = new AUD-SRC-04), 72 INFO
    Evidence: 184 Python tests pass; validate.py exit 0, 3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
2026-10-26 Bench-test recording framework for Gate G evidence
    - documentation/testing/bench-tests.yaml: pass criteria, conditions, required
    variants and prediction links for the 34 bench tests
    - automation/bench/bench.py: template, import-csv (raw data copied and hashed,
    explicit --measured affirmation), check (schema, metadata, raw-data hashes,
    MEASURED-only origin, judging, contradiction detection, predicted vs measured)
    - reports/bench-summary.json / bench-report.md drive Gate G and readiness;
    validator refreshes them; results/README.md documents the workflow
    Evidence: 195 Python tests pass (11 new, synthetic records in temp folders only);
    validate.py exit 0; Gate G OPEN with no bench record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
2026-10-26 Engineering status dashboard generated from evidence; repository hygiene test
    - automation/dashboard/build_dashboard.py -> reports/dashboard/index.html:
    self-contained page (no network) with overview, decisions and human reviews,
    per-board gates and blockers, gate evidence classes, test results, efficiency
    and loop-gain charts (labelled predictions), SIM-12 margins, open findings and
    risks, sourcing, bench requirements and computed next actions; regenerated by
    validate.py in full mode
    - tests: dashboard reflects evidence and invents nothing; no control characters
    in tracked text sources (AUD-DOC-01 guard)
    - audit: DOC-01, DOC-03 and PROC-01 marked FIXED (were fixed earlier)
    Evide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
2026-10-26 CI workflow; hash-bound schematic evidence
    - .github/workflows/ci.yml: Linux job (pytest, firmware host tests and mutation
    check with gcc, validator fast mode) and Windows job (pinned avr-gcc/TinyCC,
    target build); tests/test_ci_workflow.py keeps pins equal to setup.ps1
    - build_schematic.py writes schematic evidence manifests; validator prefers
    them over file modification times (AUD-VAL-08); existing evidence migrated
    with validate.py --attest-schematic after its legacy check passed
    - hal_mock.c: 32-bit loop counter (portability)
    Evidence: 202 Python tests pass (181 + 18 skipped with KiCad hidden);
    validate.py full and fast exit 0 with 3 known items; CI not yet run on GitHub.
    Co-Aut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
    [schematic-compact-22mm-evidence.json, schematic-evaluation-board-evidence.json]
2026-10-26 Documentation: developer guide, release checklist, PCB review, handover state
    - engineering/pcb-review-2026-10-26.md: evaluation-board items with options
    and trade-offs (order the first prototype unchanged; bench checks decide);
    compact strategy comparison; PG net unused; risk R-22 (ISP/ISN pickup)
    - documentation/developer-guide.md and release-checklist.md
    - README, AGENTS.md (map, regeneration order, validator baseline, bench rule,
    heredoc backslash pitfall), requirements, assembly, test plan, final report
    (superseded statements marked), PROGRESS current state and next actions
    - audit register status summary: 54 findings, 40 fixed, 2 mitigated,
    11 documented, 1 open (AUD-PCB-03 r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
2026-10-26 Audit: record the firmware blocking-loop, tick-budget and low-voltage review
2026-10-27 Ordering preparation: JLCPCB files, ordering guide, pre-order review pack
    - documentation/ordering-guide.md: files, layer order (L1 .gtl, L2 .g1,
    L3 .g2, L4 .gbl) and order-form options for PCBWay and JLCPCB (1 oz inner
    and outer copper, ENIG, 1.6 mm, top-side assembly, X-ray of U1/U3)
    - automation/export/export_jlcpcb.py: JLCPCB upload files derived from the
    checked PCBWay package (identical Gerber bytes, JLC BOM and CPL); refuses
    incomplete boards; validator entry VAL-JLC-<variant> detects staleness
    - export_pcbway.py: one BOM line per orderable part (48 -> 30 lines,
    AUD-MFG-05); both packages re-exported
    - automation/review/footprint_report.py -> reports/footprint-review.md for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
    [BOM_JLCPCB.csv, BOM_PCBWay_plugin.csv, BOM_PCBWay_template.csv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]
2026-10-27 Fix CI: gcc unused-function error in the laser-NTC-required test build; footprint report without KiCad
    First GitHub Actions run (40497985197): Windows job (pinned avr-gcc/TinyCC,
    target build, mutation check) passed; Linux job failed in pytest:
    - test_app.c built with -DAPP_LASER_NTC_REQUIRED=1 defined the default-build
    tests without calling them; gcc -Wall -Wextra -Werror rejects unused static
    functions (TinyCC does not warn). They are now guarded by the same condition.
    - footprint_report.py called KiCad's library path, which raises without KiCad;
    KiCad-library footprints are now reported as not found.
    - the host-suite test now prints only the failing suites with their detail.
    Checked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
    [test_app.c]
2026-10-27 Document independent pre-order review and outstanding footprint dispositions
2026-10-28 Merge pre-order review into main; regenerate release reports
    - main fast-forwarded to 7c08c83 (independent pre-order review by Codex):
    evaluation FP-U1, FP-L1 and ORIENT recorded DONE; FP-POWERPAK and FP-RS1
    OPEN; new findings AUD-VAL-11/12, AUD-PCB-06, AUD-DOC-04
    - validate.py rerun: exit 0, 57 entries, 3 known unchanged items; evaluation
    board DRAFT_REVIEW with 2 blockers to PROTOTYPE_CANDIDATE (FP-POWERPAK,
    FP-RS1); dashboard, register and readiness regenerated
    - 207 Python tests pass
2026-10-28 Fix setup.ps1 under Windows PowerShell 5.1; verify fresh copy with full toolchain
    - scripts/setup.ps1: java -version writes its banner to stderr, which 2>&1 turns
    into a terminating NativeCommandError under ErrorActionPreference Stop on
    Windows PowerShell 5.1. Tool banners are now captured by Get-NativeOutput with
    the preference relaxed for that call only; setup completes under powershell.exe.
    - research/source-index.md: local-copy column for PREORDER-01..11. PREORDER-01,
    04, 05, 06 and 08 downloaded (git-ignored) and checked against document number
    and revision; 09/10/11 refused scripted download (HTTP 403).
    - Full-toolchain evidence on 480a69f: doctor all OK; pytest 207 passed; f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
2026-10-28 Review evaluation-board quote, footprints and sourcing options
    Recheck the pre-order review against local manufacturer documents and the
    unchanged seven-artifact baseline. Keep FP-POWERPAK/FP-RS1 open, document exact
    RS1/U3 remedies, and register AUD-DOC-05 for dashboard rows lacking board scope.
    Save/index the three missing diode PDFs locally and update scoped review evidence.
    Commit private PCBWay quote QUOTE-01 and add an isolated external-xlrd checker.
    All 30 original BOM lines match, J1 remains DNS, and all price arithmetic agrees.
    Record dollar formatting with unknown ISO currency, L1's 50.79% cost share and
    unexplained unit price, 5/3-board sourcing counts, safety risks, consignment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
    [T-1K2W1137524A-5units-BOM_PCBWay_template(2026-10-28).xls, bom-sourcing-options.csv]
2026-10-28 Add GBP and UK supplier comparisons to sourcing review
    Record GBP as the owner display currency and ECB-dated reference FX. Keep
    QUOTE-01 ISO currency UNKNOWN; its GBP 229.25 total is conditional on USD.
    Extend all 30 sourcing rows with conditional GBP amounts, UK exact-part
    leads, observed tiers, spare/MOQ purchase counts and retrieval/tax/shipping
    limits. Compare UK eBay offers and manufacturer-documented packing aliases;
    keep L1 exact-MPN repricing as the main saving and adopt no substitutions.
    Update source index, pre-order cross-reference, requirements and PROGRESS.
    Keep all protected design sources, CAD, exports and sourcing CSVs unchanged.
    Dashboard regenerated by the full validator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
    [bom-sourcing-options.csv]
2026-10-28 Integrate sourcing reviews and assess Project 450 design ideas
    Record the owner's requested main integration of the complete pre-order,
    private PCBWay quote, GBP/UK sourcing and substitute-candidate reviews
    (3a6e4c4 and 0faacf8). Refresh PROGRESS handover/next actions and the
    REQ-SRC-01 evidence note without upgrading verification status.
    Add a sourced Project 450 comparison covering host heat transfer, arming,
    startup, diagnostics and charging inhibition. Verify the two-cell
    TPS56C215 buck cannot replace the single-cell TPS552882 design. Register
    the page and TI references with local-copy hashes and cross-link the
    pre-order review. All ideas remain proposals; no design/CAD/export or
    genera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
2026-10-28 Plan a separate two-cell budget laser driver within a GBP 60 ceiling
    Consolidate pre-order, private quote, GBP/UK sourcing and Project 450 findings
    into a phased 2S buck feasibility and qualification plan for 3/5 working units.
    Keep full current regulation and independent protection in scope, with larger
    parts, genuine sourcing, explicit cost boundaries and complete-cost unknowns.
    Record owner planning scope as DD-29 and nine OPEN budget requirements.
    Register BUD-01 through BUD-14, five hashed local manufacturer PDFs and dated
    native GBP retailer snapshots with crawl-age, VAT and delivery limitations.
    Separate spending allocations and partial price baskets from supplier quotes.
    Preserve A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
2026-10-29 Start budget-2s electrical qualification (Codex checkpoint, DD-30)
    Commit the uncommitted Codex handover checkpoint for the separate two-cell
    budget driver so later work builds on a recorded base.
    Add independent numeric sources (engineering/design/budget-2s/parameters.yaml),
    a variant source resolver (automation/nubm44/variants.py), the electrical
    qualification screen (automation/budget/qualify.py) and a preliminary
    small-signal current-loop model with an independent ngspice AC check
    (automation/budget/loop_model.py), with hash-bound reports in
    reports/budget-2s/. Register BUD-15...22 manufacturer sources, DD-30, the
    budget implementation handover (engineering/budget-2s-design.md) and scop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
    [parameters.yaml]
2026-10-29 Budget-2s: single output P-FET, UV backstop and operating-point model (DD-31)
    Replace the back-to-back output pair with one P-FET (source at VBUCK). Its
    body diode already blocks VBUCK -> laser; the second FET only blocked the
    reverse path, doubled disconnect loss and added no forward-blocking
    redundancy. Select DMP2005UFG-7 for development; land/paste/X-ray review and
    a gate transient clamp remain open.
    Add automation/budget/power.py: averaged operating point with energy balance,
    dropout bisection, UV-sense, OVP false-trip and gate-drive checks. It uses
    sourced TPS54821 limits (full-temperature table maxima, 0 ns minimum
    off-time, supply current), labelled efficiency estimates and power_mo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
    [parameters.yaml]
2026-10-29 Budget-2s: owner efficiency decision and default-off interface (DD-31, DD-32)
    Record the owner's choice of DD-31 option (a): the budget efficiency
    target becomes >= 93% at 7.4 V / typical diode / 4 A, judged by bench
    measurement (value proposed by Claude Code; owner may change it).
    REQ-BUD-07 rewritten as an owner deviation and still OPEN. BUD-EFF-01 is now
    CONDITIONAL with about 0.4 points of estimate margin.
    Design the static default-off interface for BUD-ISS-03 (DD-32). nFAULT is
    the wired-AND fault line and the SN74HCS74 CLR, with its pull-up split
    around the external interlock loop and a 47k pulldown. Series DMG1012T
    pairs N1/N2 (output P-FET gate) and N3/N4 (gate of DMG1013T P1, which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
2026-10-29 Budget-2s: owner main setpoint 4.5 A with owner V-I points (DD-33)
    The owner accepted the DD-31/32 targets and set the budget main target to
    4.5 A at 4.72 V (about 7.3 W optical expected), giving NUBM44 points at
    3.0/3.5/4.0/4.5 A and 4.40/4.52/4.62/4.72 V. Recorded as owner data
    OWNER-VI-01 and DD-33; budget-2s only, A/B keep 4.0 A (DD-13).
    Parameters: current_a 4.5, normal_peak_a 4.95 (1.1x, as REQ-OUT-05),
    laser_v_typ 4.72 (efficiency condition), laser_vi_points, backup window
    5.0-5.6 A, feedback divider top 27.4k (E96, 4.488 A nominal), INA300 limit
    2.67k (E96, about 5.29 A). qualify.py validates the V-I data and enforces
    setpoint < transient ceiling < trip window. It reports one-resist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
2026-10-29 Budget-2s sourcing directive and part swaps (DD-34); A/B 4.5 A analysis
    Owner instruction: build the budget board from cheap, easy-to-source parts
    readily available in the UK or via fast AliExpress shipping, and move the
    A/B boards to 4.5 A.
    Budget (DD-34): proposed policy - UK-serving distributors or LCSC for
    semiconductors (genuine stock; no AliExpress listing found for the TI
    parts), AliExpress for passives/connectors/fuses, prefer stock KiCad
    footprints. Replace DMP2005UFG-7 (40-week lead time) with SiSS23DN (A/B
    Q1 part, UK stocked) behind a 2.2k/100R gate divider with a BZX585-C6V2
    source-gate clamp, and WSK2512R0100FEA with WSL2512R0100FEA (BUD-24,
    1 W, +/-75 ppm/C). The power model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
    [parameters.yaml]
2026-10-29 Budget-2s: first KiCad schematic from separate connectivity (DD-35)
    Owner instruction: start getting the budget board out with KiCad.
    Add the separate budget circuit source engineering/design/budget-2s/
    connectivity.yaml (104 parts, every pin and net) and a separate budget2s
    library under hardware/budget-2s/lib, built by automation/budget/
    build_library.py from YAML symbols (TPS54821, INA300, TLV6700, TLV803E,
    single-unit SN74HCS74, INA186), plus MOSFET symbols renumbered for SOT-523,
    SO-8 and PowerPAK 1212. automation/budget/build_schematic.py reuses the A/B
    layout/labelling helpers unchanged (wide blocks wrap into rows), writes the
    KiCad project, runs ERC, compares the netlist pin by pin,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
    [nubm44_budget2s.kicad_sch, schematic-evidence.json]
2026-10-29 A/B boards moved to 4.5 A with owner-accepted deviations (DD-36)
    Owner instruction: change the original boards to 4.5 A too, then "Accept
    a and b" for the two calculation margins that failed at 4.5 A.
    Sources: parameters i_set_a 4.5 (alternates 3.0/3.5/4.0), R8 6.65k ->
    8.66k (RT0402BRD078K66L), R3 27.4k -> 24.9k (ILIM 13.25 A typ). Owner
    deviations are visible parameters read by power_stage.py: backup margin
    factor 1.0 (ISP/ISN 4.8-5.2 A vs worst-case setpoint 4.66 A; was 1.05)
    and reverse-FET limit 0.7 W (0.68 W computed; was a 0.6 W estimate).
    Firmware APP_I_SET_MA 4500 and host tests; simulation criteria read the
    setpoint from parameters (REQ-OUT-05 peak = 1.1 x setpoint) instead of
    lit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
    [BOM_JLCPCB.csv, BOM_PCBWay_plugin.csv, BOM_PCBWay_template.csv, battery_step.csv, components.csv, costs.csv, flash.csv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]
2026-10-29 Untrack local setup log committed by mistake; keep budget footprint dir
    c42ce13 swept the machine-specific reports/setup.log (setup.ps1 tool log;
    local paths only, no secrets) into the commit through a folder-wide add.
    Remove it from the index, keep the local file and ignore it so it cannot
    be committed again. Add a .gitkeep so hardware/budget-2s/lib/budget2s.pretty
    exists in fresh clones and the budget KiCad project's footprint library
    table does not point at a missing folder.
2026-10-29 A/B efficiency target 93 % at 4.5 A (owner, DD-37)
    The owner accepted a lower A/B target after the 4.5 A routed-copper
    estimate (93.56 %, model 94.10 %) fell below the 94 % DD-26 target.
    REQ-PWR-02 becomes >= 93 % at 4.0 V input and 4.5 A, judged by bench
    measurement (T1.7), matching the budget board. Changed
    current.efficiency_target_pct, the T1.7 bench limit and its test fixture,
    requirements, test plan and README; recorded DD-37 and superseded DD-26.
    Chain rerun: calculations 21/21; simulations 12/12; ERC 0/0 and exact
    netlists; DRC evaluation 0/0/0/0, compact unchanged (parked); layout
    reviews; PCBWay/JLCPCB exports and footprint report regenerated; routing
    checkpoint source_revisions a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
    [nubm44_driver-B_Cu.gbl, nubm44_driver-B_Mask.gbs, nubm44_driver-B_Paste.gbp, nubm44_driver-B_Silkscreen.gbo, nubm44_driver-Edge_Cuts.gm1, nubm44_driver-F_Cu.gtl, nubm44_driver-F_Mask.gts, nubm44_driver-F_Paste.gtp]
2026-10-29 Budget-2s PCB and prototype manufacturing package (DD-38)
    Owner request: complete the budget board ready for fabrication. No order is
    placed; Gate G stays open.
    Board (hardware/budget-2s, placement.yaml):
    - 90 x 60 mm, 4 layers, 0.15 mm rules, all parts on top; power path as F.Cu
    pours with router keep-outs; LASER_P repeated on In2/B.Cu with six stitching vias.
    - Separate Kelvin pairs to U2/U3; Q2 gate network tied to the VSH pour; solid
    C2/C3 -> U1 GND/EP return tracks; hand-placed U1 feedback/compensation/SS
    cluster; OV divider at U5; LD+ branch on fixed tracks.
    - U1 RHL0014A project footprint: 0.3/0.6 mm thermal vias, solid zone connection,
    corner paste 0.82 mm at +/-0.61 so it s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
    [BOM.csv, BOM_JLCPCB.csv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]
2026-10-29 Budget-2s BOM sourced: part numbers for the 40 open lines (DD-39)
    Owner request: find the 40 open BOM lines. Every select-at-order line now has an
    MPN, each checked against a distributor or manufacturer listing (BUD-27 pages read
    directly, BUD-28 search snapshots). Stock and prices are not used and stay UNKNOWN.
    Selections:
    - 1 % resistors: UNI-ROYAL 0603WAF / 0805W8F (LCSC, mostly JLC Basic), Yageo
    RC0603FR-079K1L for 9.1k.
    - 0.1 %/25 ppm: Panasonic ERA-3AEB103V/134V/2742V (RS UK), Yageo RT0603BRD07133KL
    (DigiKey), Vishay TNPW06032K67BEEA (Farnell) with ERA-3AEB2671V as alternate.
    Yageo RT...BRE is +-50 ppm/C and was rejected.
    - Capacitors: Yageo CC0603KRX7R9BB104, FH 0603B103K500NT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
    [BOM.csv, BOM_JLCPCB.csv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]
2026-10-29 Budget-2s LCSC codes for the remaining 21 BOM lines (DD-40)
    Every budget BOM line now has an LCSC code read on its LCSC product page (BUD-29).
    - sourcing.yaml: 19 lines use the exact part, six of them under LCSC's full
    ordering name (new lcsc_mpn field). LCSC does not list R5 ERA-3AEB2742V or
    R7 TNPW06032K67BEEA, so a new lcsc_equivalent field names Yageo
    AT0603BRD0727K4L (C855755) and AT0603BRD072K67L (C855783): 0603 thin film,
    0.1 %, 25 ppm/C. A hand-built board keeps the UK parts. U4 is C1852114
    (TLV803EA29DBZR). C1852118 (R pinout, RESET on pin 1) and the EB29/EC29
    delay variants were rejected.
    - parameters.yaml: XT30 contact resistance 0.80 -> 1.20 mOhm, from the Amass
    sp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
    [BOM.csv, BOM_JLCPCB.csv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]
2026-11-07 docs: record public repository status
    Document the public visibility decision and the quote material and history now exposed. Add public-collaboration onboarding and safety reminders.
